BadenMorgan/thesis/Document/Pictures/ComponentTubes.JPG

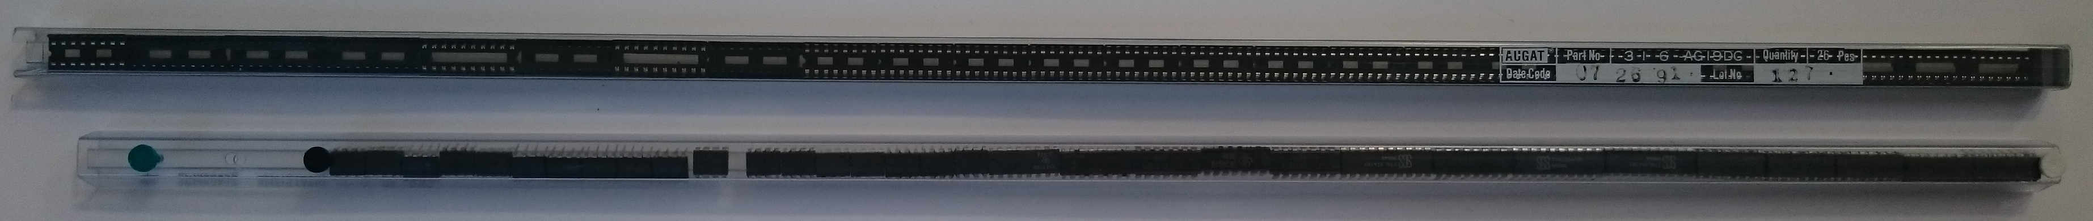
Document/Pictures/ComponentTubes.JPG
