BadenMorgan/thesis/Document/Pictures/tester.jpg

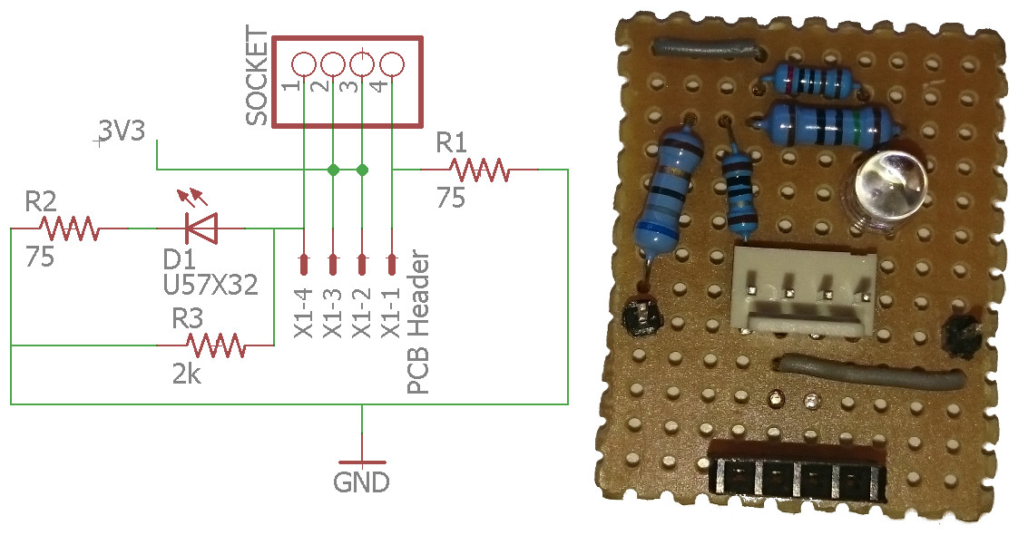
Document/Pictures/tester.jpg
