BadenMorgan/thesis/Ethics Review/Signature form.pdf

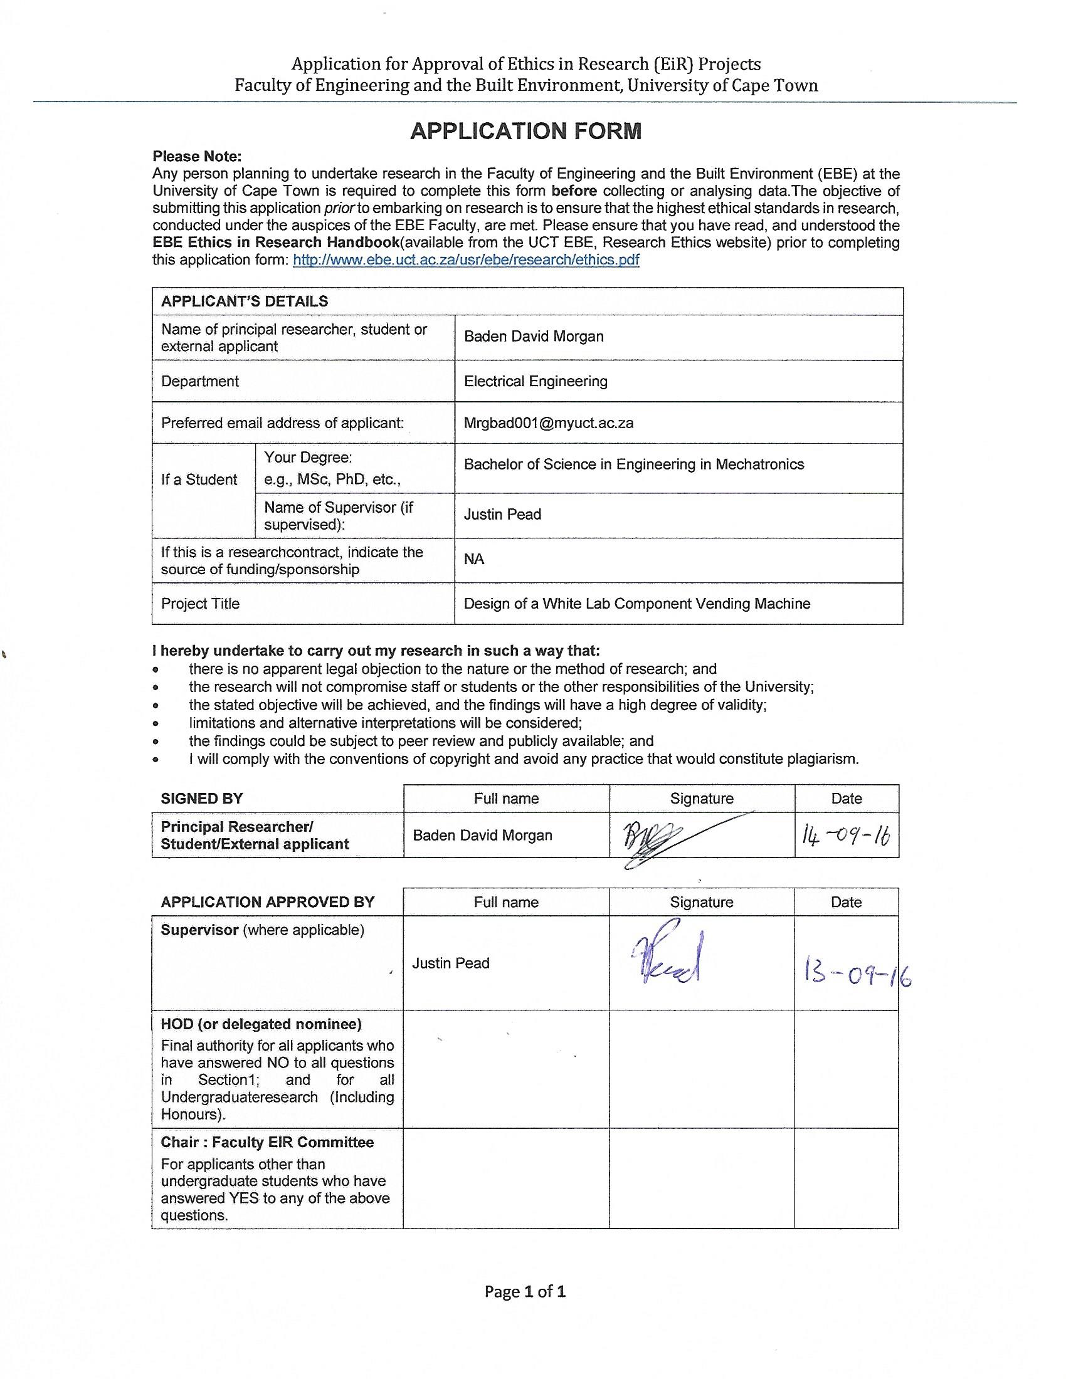
[picture p11: page 1]
