BadenMorgan/thesis/Circuit/LCD Board/LCD_Breakout TEMPLATE.PDF

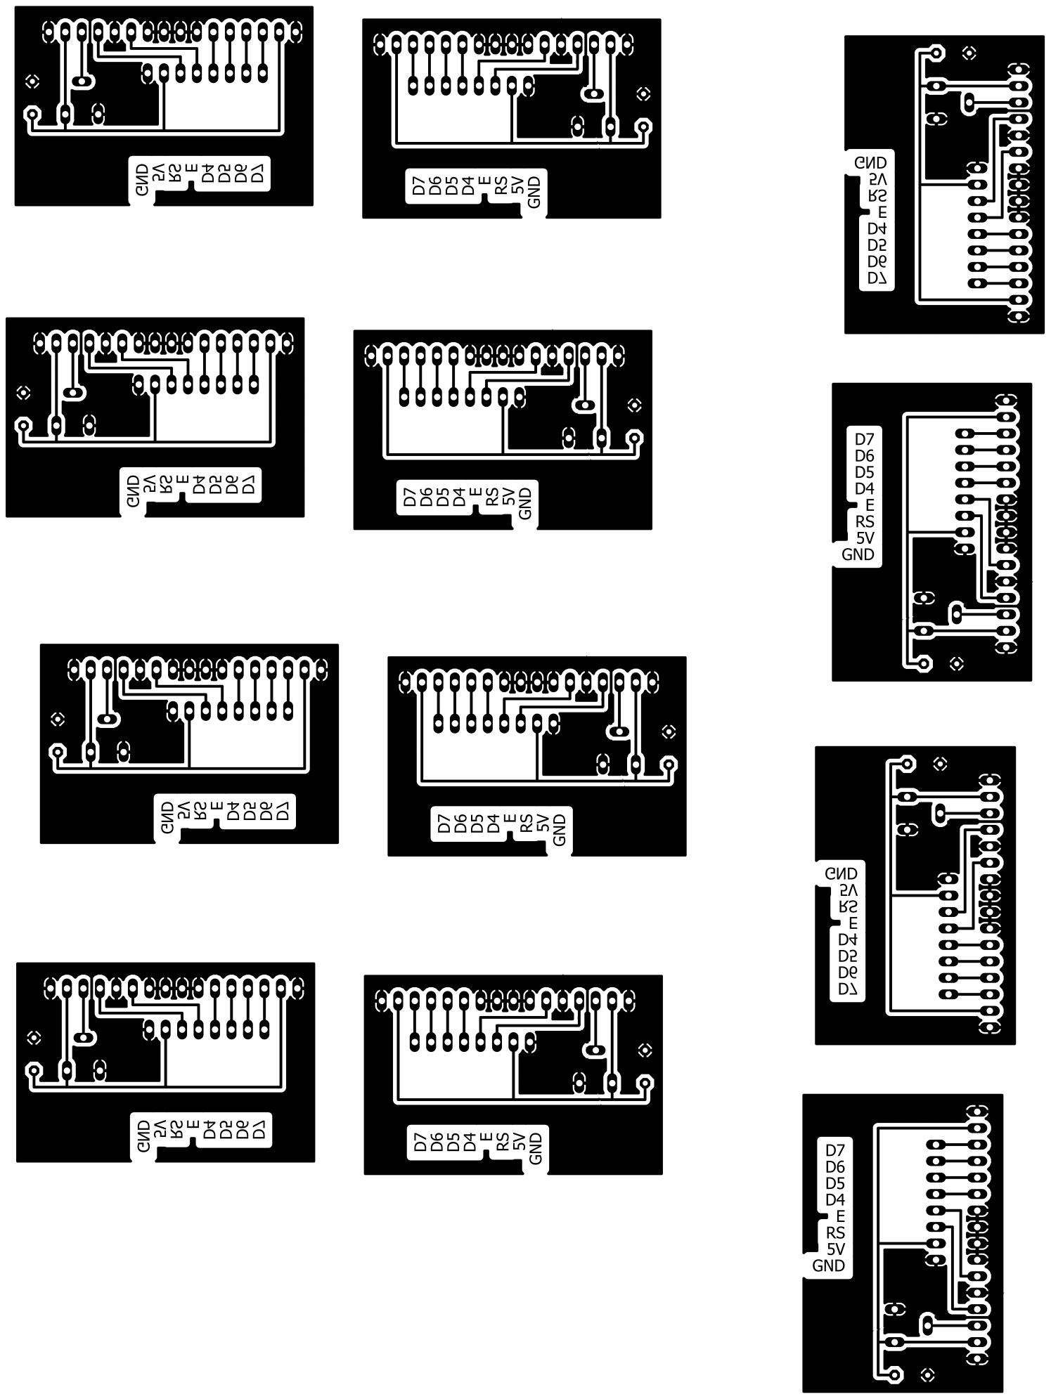
[picture p12: page 1]
