BadenMorgan/thesis/Document/Pictures/archive pics/cover picture.docx

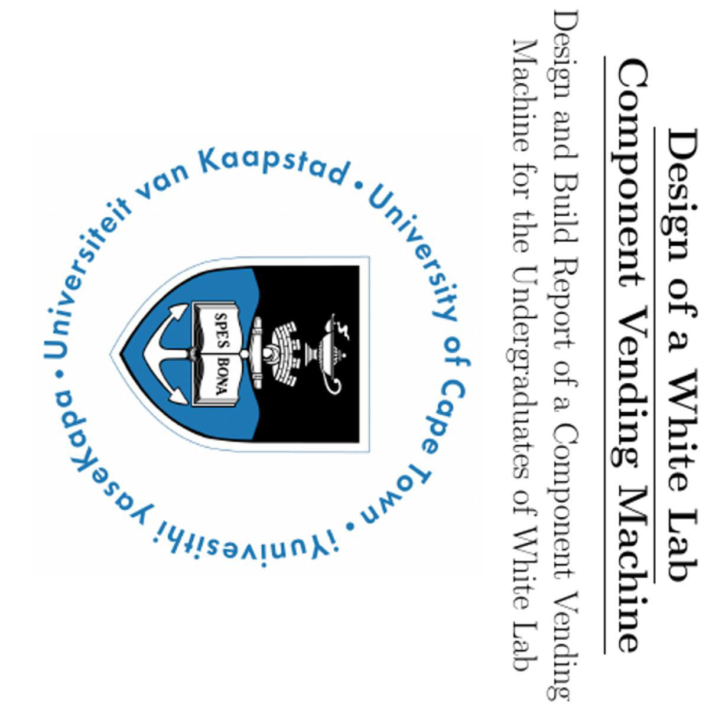
[picture p13: figure]
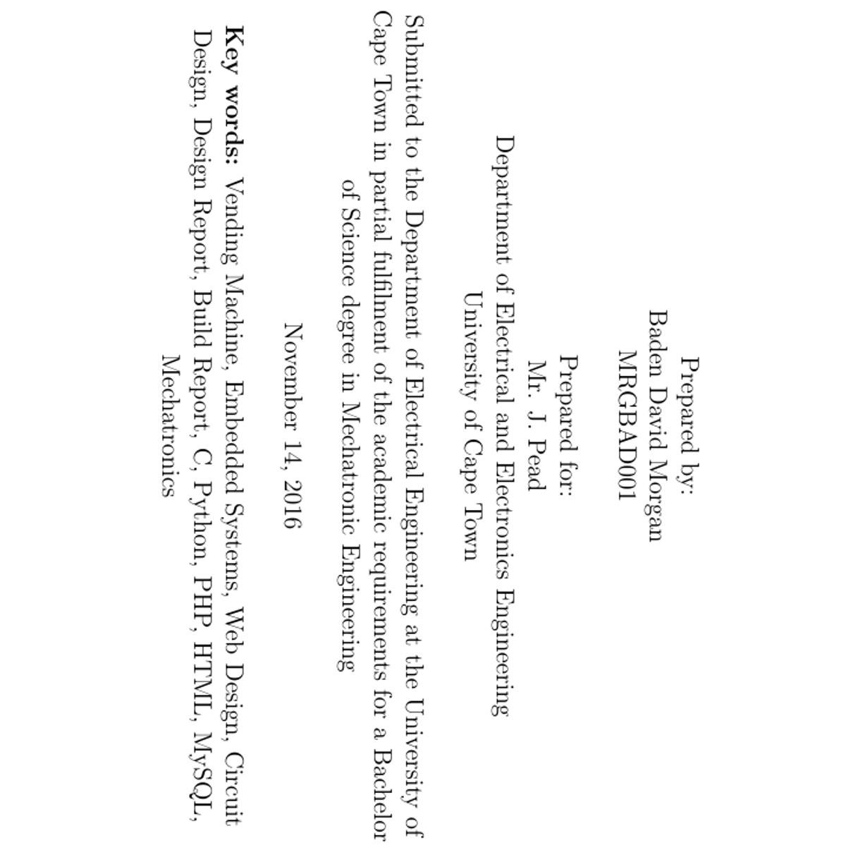
[picture p14: figure]
