BadenMorgan/thesis/Cmaps/.cmapthumbs/1QD1MVDWZ-1VP8W32-1DLC.gif

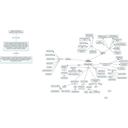
Cmaps/.cmapthumbs/1QD1MVDWZ-1VP8W32-1DLC.gif
