BadenMorgan/thesis/Cmaps/.cmapthumbs/1QKLRMBC1-1NK2RVH-72D.gif

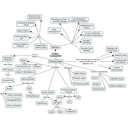
Cmaps/.cmapthumbs/1QKLRMBC1-1NK2RVH-72D.gif
