BadenMorgan/thesis/Cmaps/.cmapthumbs/1QKLRQQYY-SXX1KT-7MW.gif

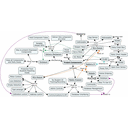
Cmaps/.cmapthumbs/1QKLRQQYY-SXX1KT-7MW.gif
