BadenMorgan/thesis/Cmaps/.cmapthumbs/1QKM15J0T-51VW2Z-1ZVW.gif

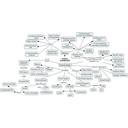
Cmaps/.cmapthumbs/1QKM15J0T-51VW2Z-1ZVW.gif
