BadenMorgan/thesis/Document/Diagrams/mcu.jpg

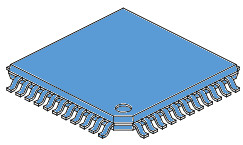
Document/Diagrams/mcu.jpg
