BadenMorgan/thesis/Document/Diagrams/rfid-symbol.jpg

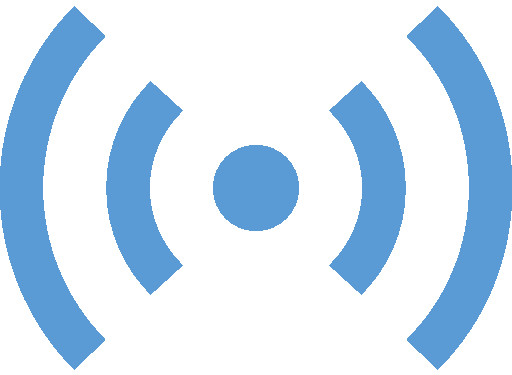
Document/Diagrams/rfid-symbol.jpg
