BadenMorgan/thesis/Document/Diagrams/State Machine Diagram v2 (1).jpg

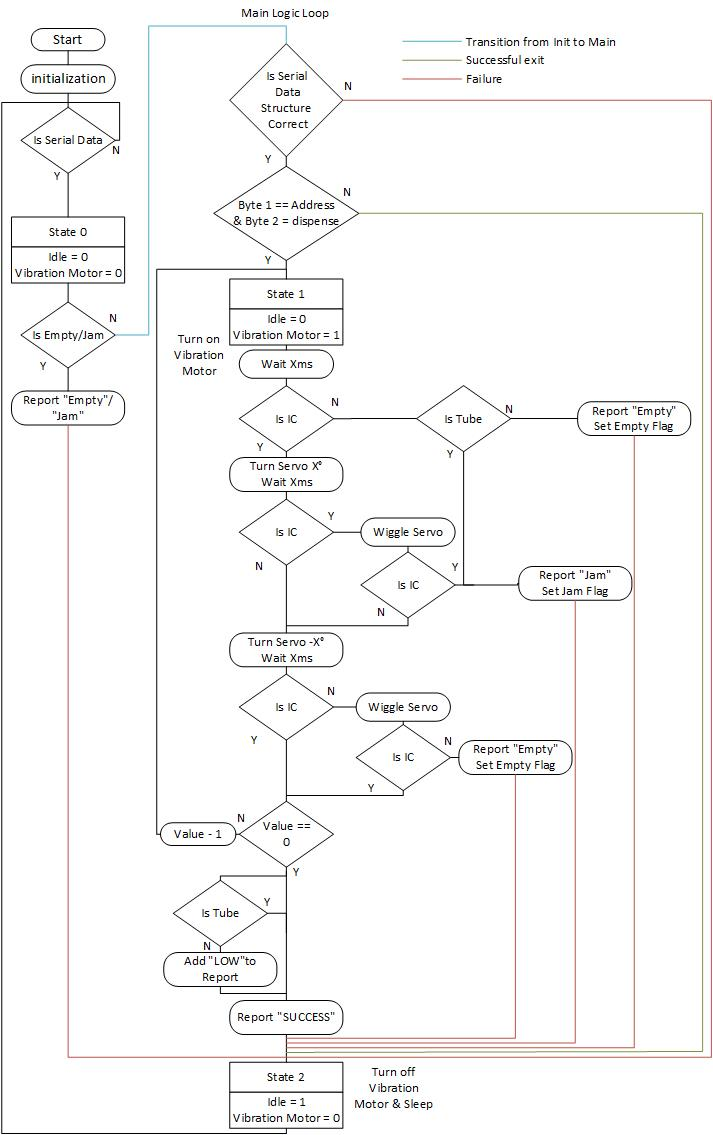
Document/Diagrams/State Machine Diagram v2 (1).jpg
