BadenMorgan/thesis/Document/Diagrams/State Machine Diagram v3.jpg

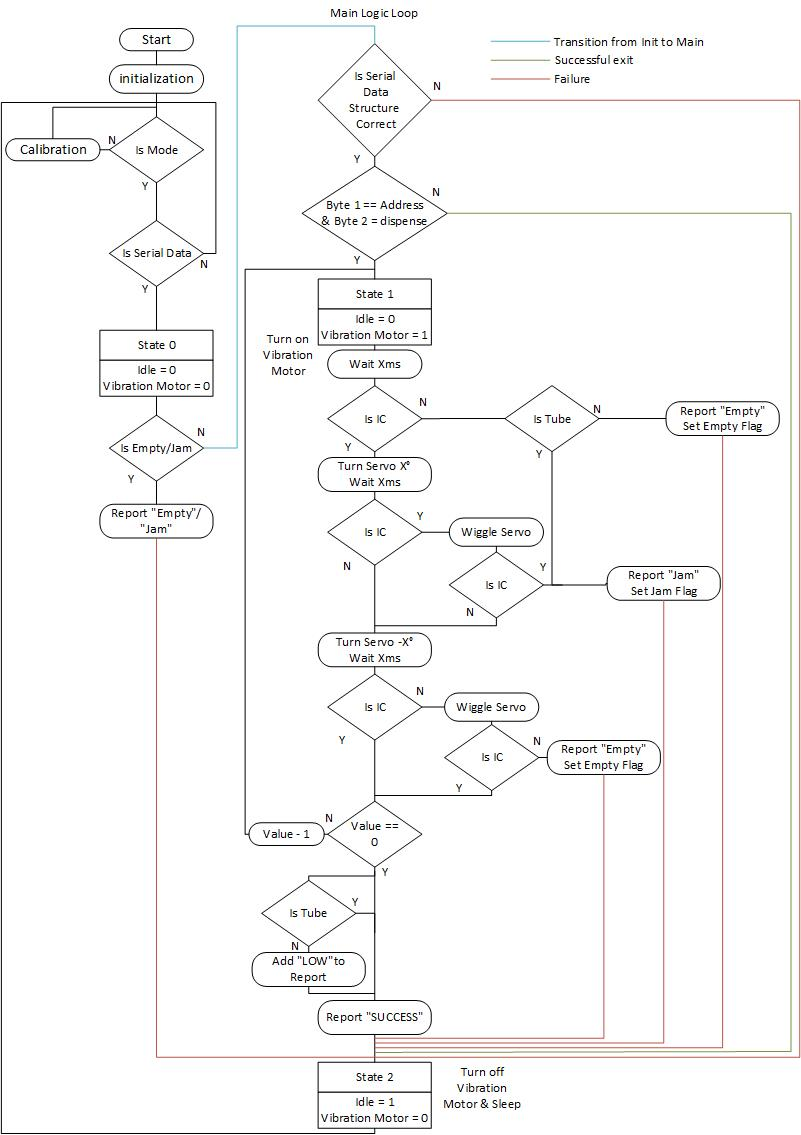
Document/Diagrams/State Machine Diagram v3.jpg
