BadenMorgan/thesis/Document/Diagrams/state machine master.jpg

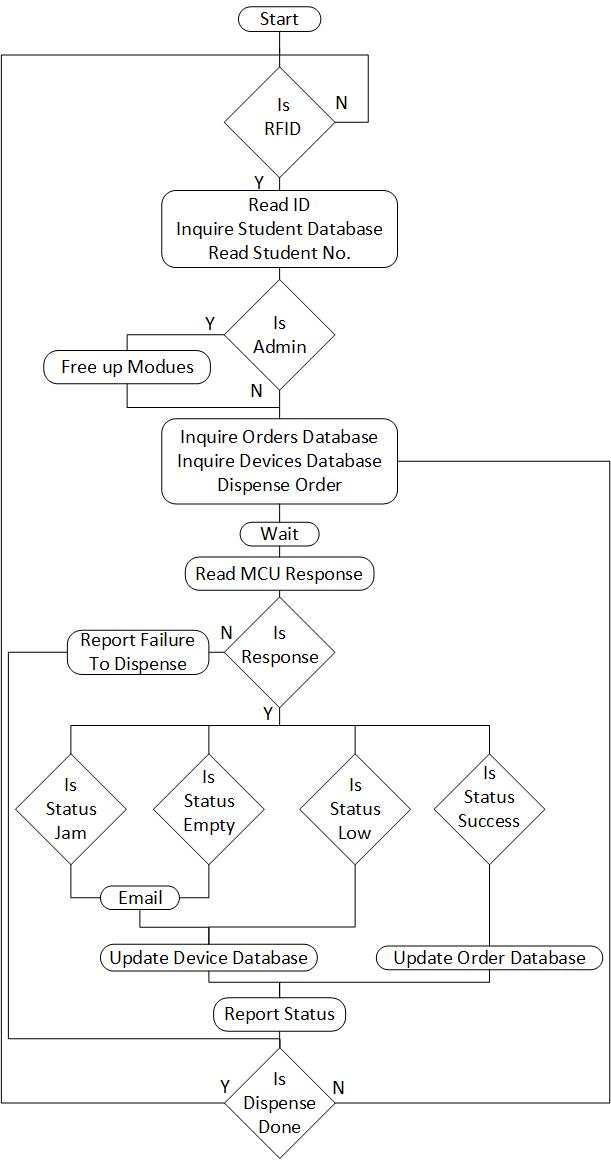
Document/Diagrams/state machine master.jpg
