BadenMorgan/thesis/Document/Diagrams/taskmanager.jpg

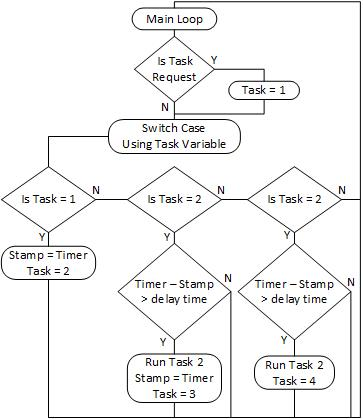
Document/Diagrams/taskmanager.jpg
