BadenMorgan/thesis/Document/Pictures/3dprints.jpg

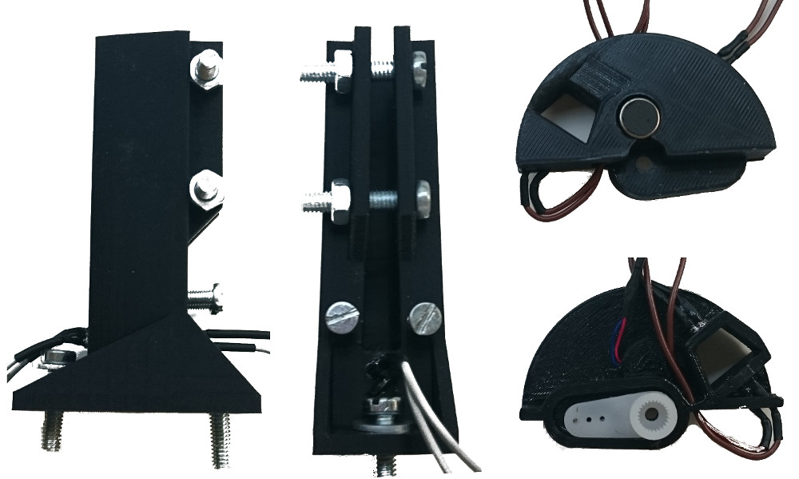
Document/Pictures/3dprints.jpg
