BadenMorgan/thesis/Document/Pictures/3dprintsv2.jpg

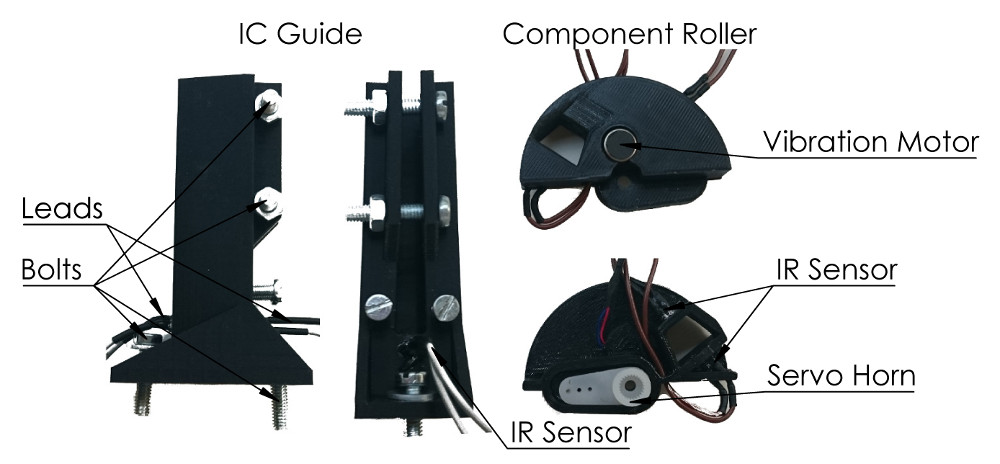
Document/Pictures/3dprintsv2.jpg
