BadenMorgan/thesis/Document/Pictures/125KhzUART.jpg

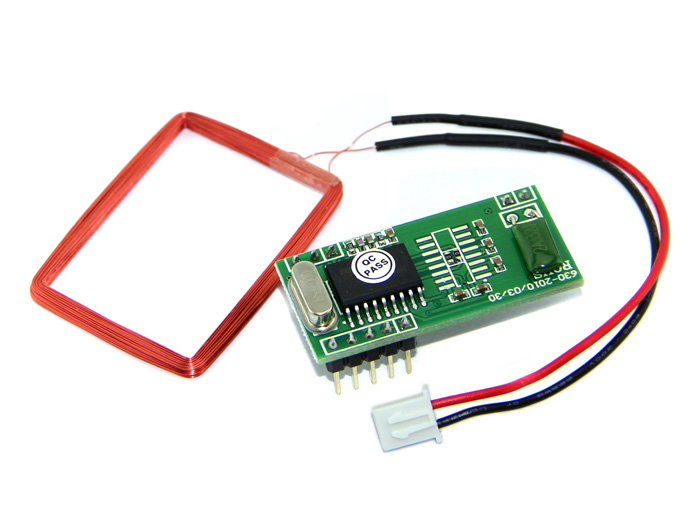
Document/Pictures/125KhzUART.jpg
