BadenMorgan/thesis/Document/Pictures/ALLROLLERSv2.JPG

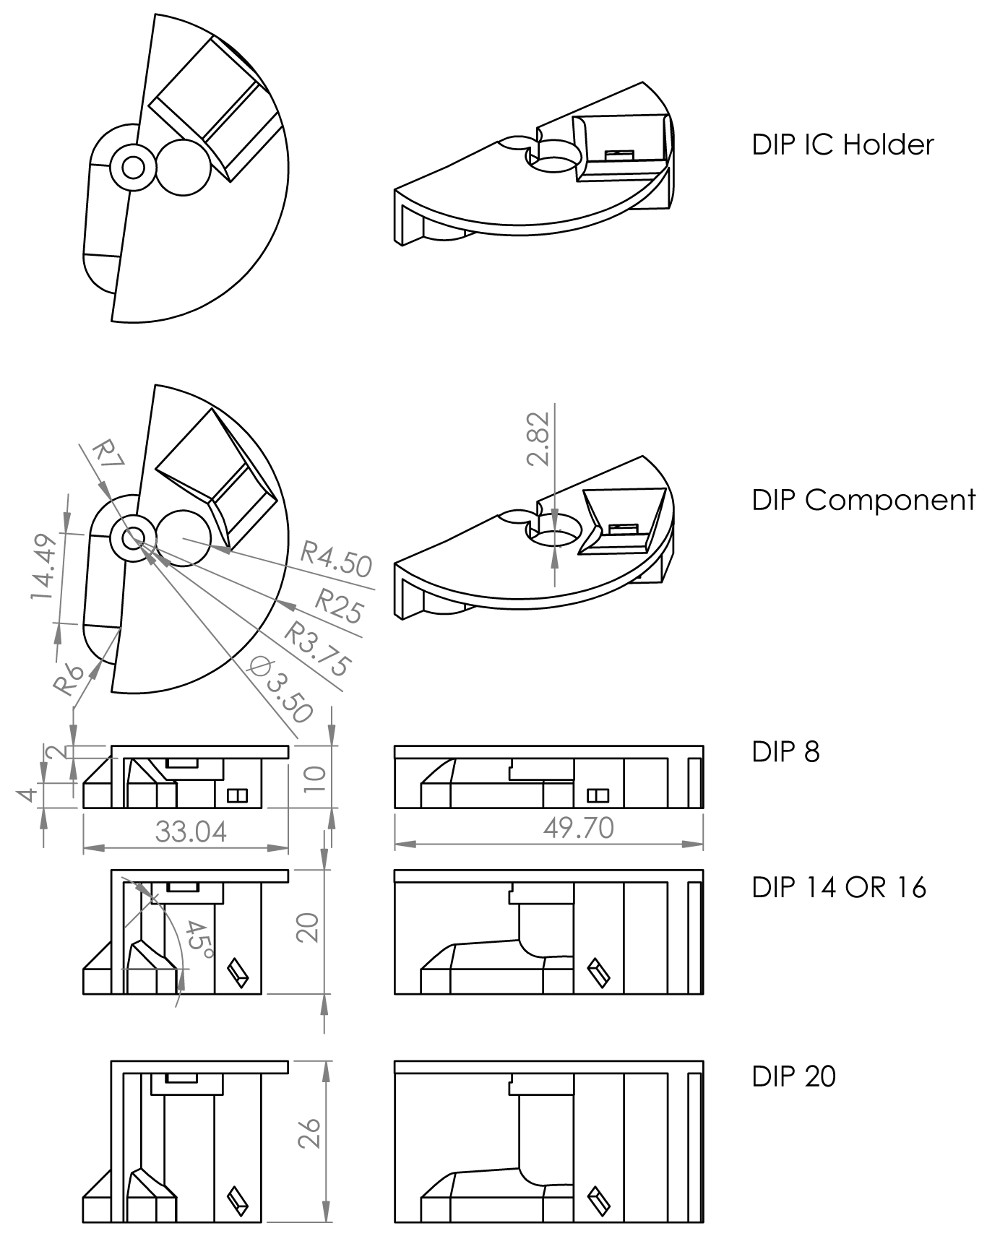
Document/Pictures/ALLROLLERSv2.JPG
