BadenMorgan/thesis/Document/Pictures/Angled.JPG

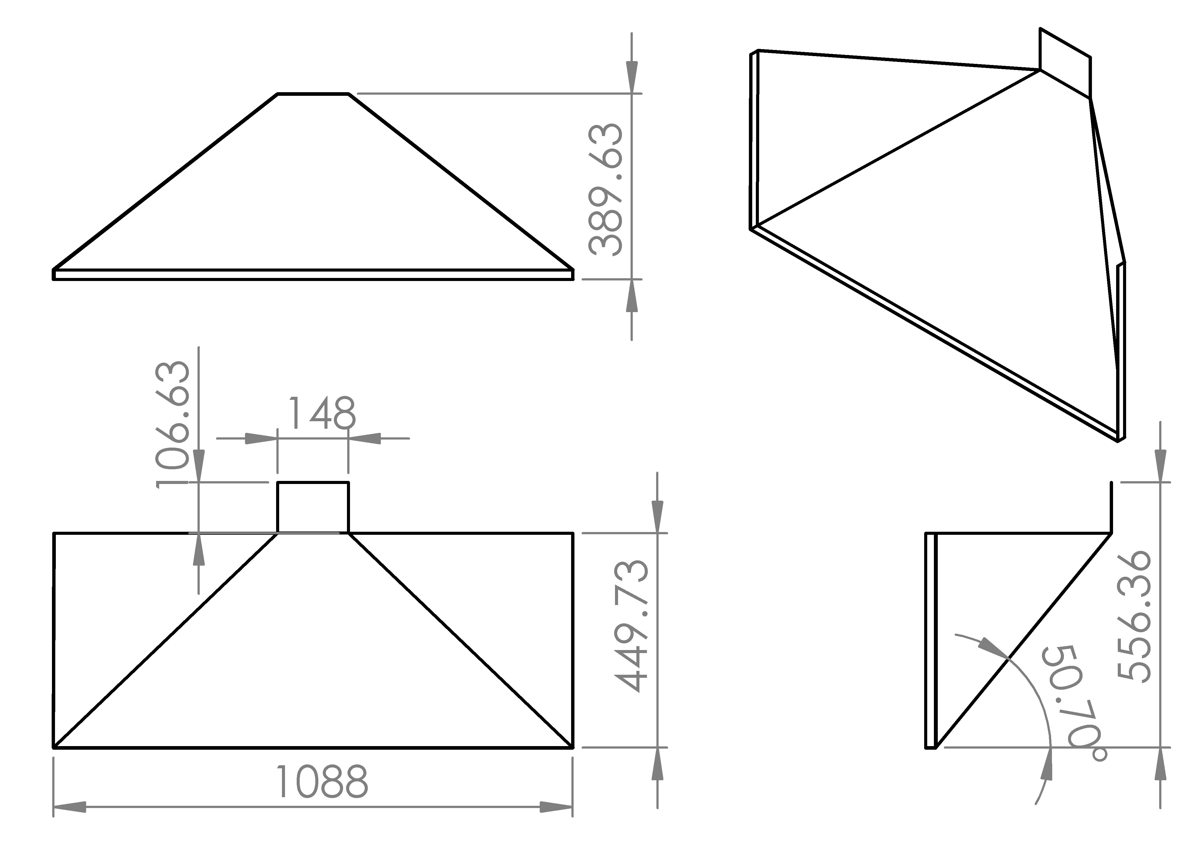
Document/Pictures/Angled.JPG
