BadenMorgan/thesis/Document/Pictures/ATXCON.jpg

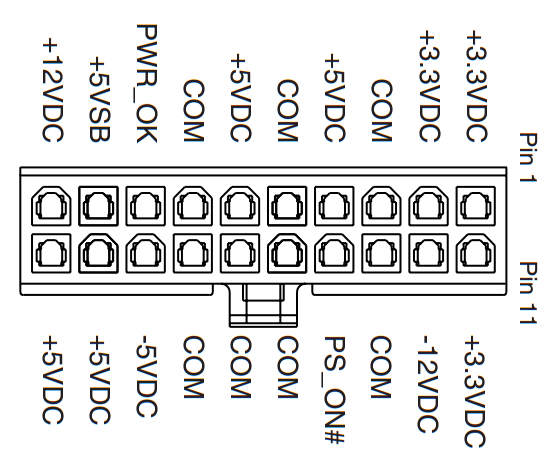
Document/Pictures/ATXCON.jpg
