BadenMorgan/thesis/Document/Pictures/case.JPG

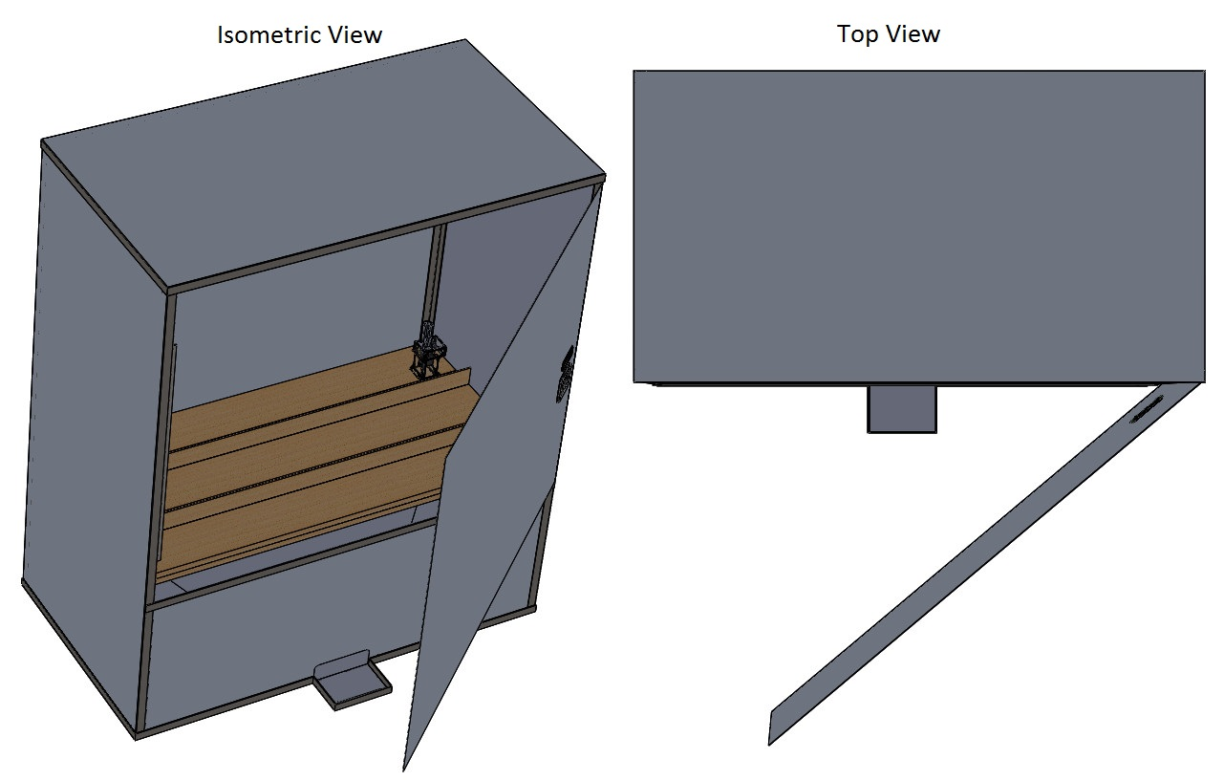
Document/Pictures/case.JPG
