BadenMorgan/thesis/Document/Pictures/CommonNoise2.jpg

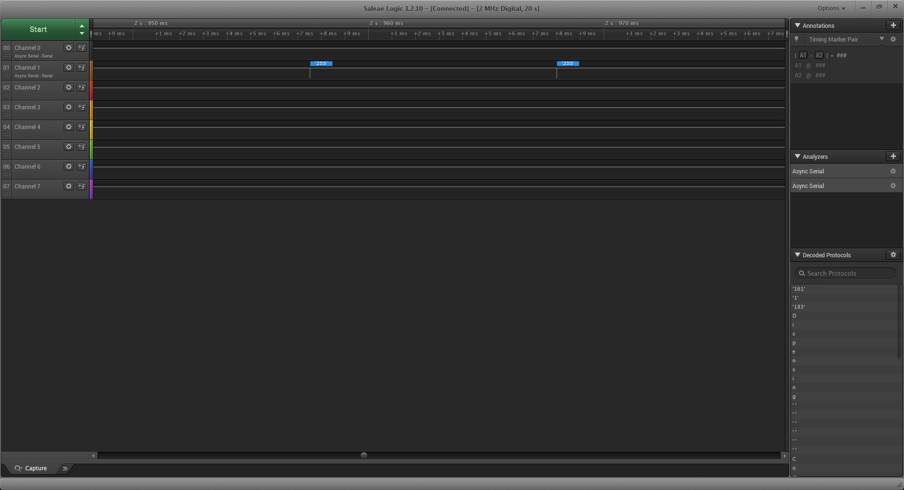
Document/Pictures/CommonNoise2.jpg
