BadenMorgan/thesis/Document/Pictures/comparison1.JPG

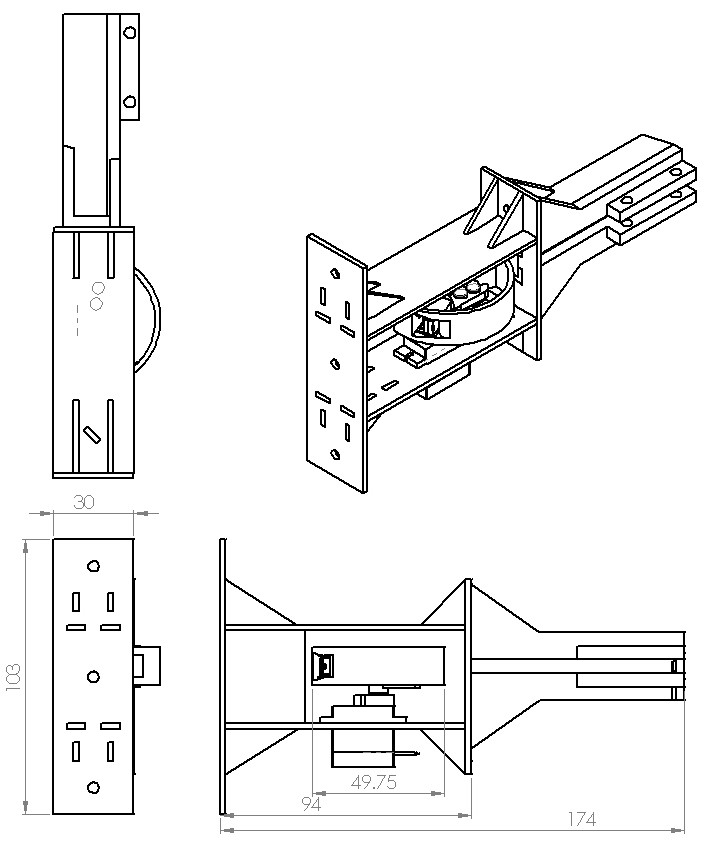
Document/Pictures/comparison1.JPG
