BadenMorgan/thesis/Document/Pictures/comptest.jpg

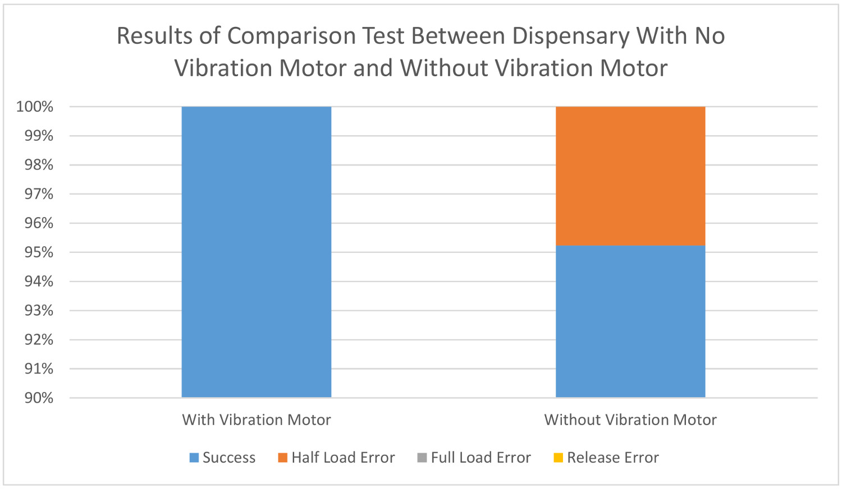
Document/Pictures/comptest.jpg
