BadenMorgan/thesis/Document/Pictures/delivassem.jpg

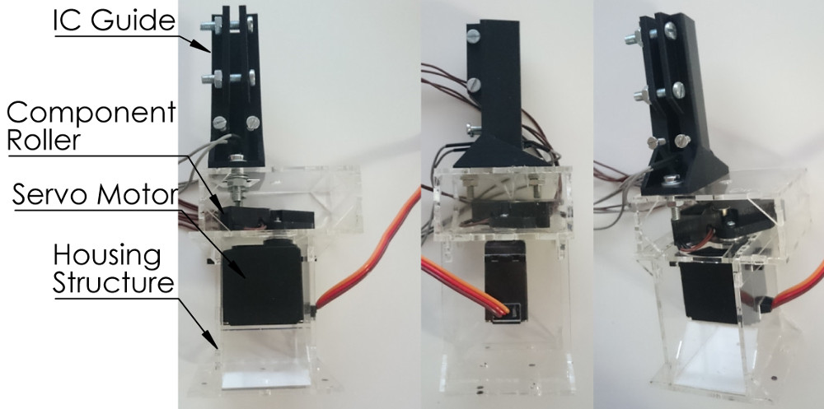
Document/Pictures/delivassem.jpg
