BadenMorgan/thesis/Document/Pictures/Demo.jpg

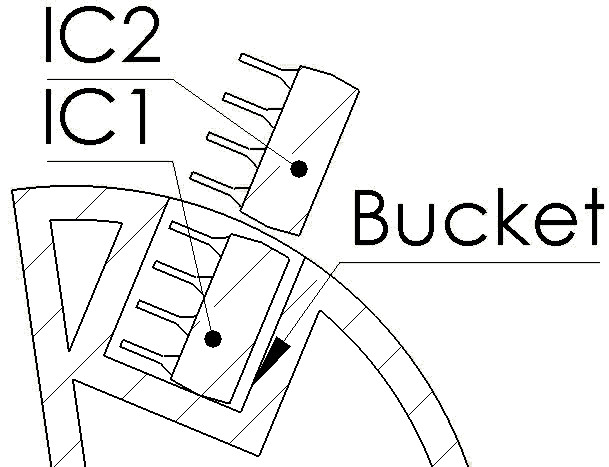
Document/Pictures/Demo.jpg
