BadenMorgan/thesis/Document/Pictures/DIP8TEMPv2.JPG

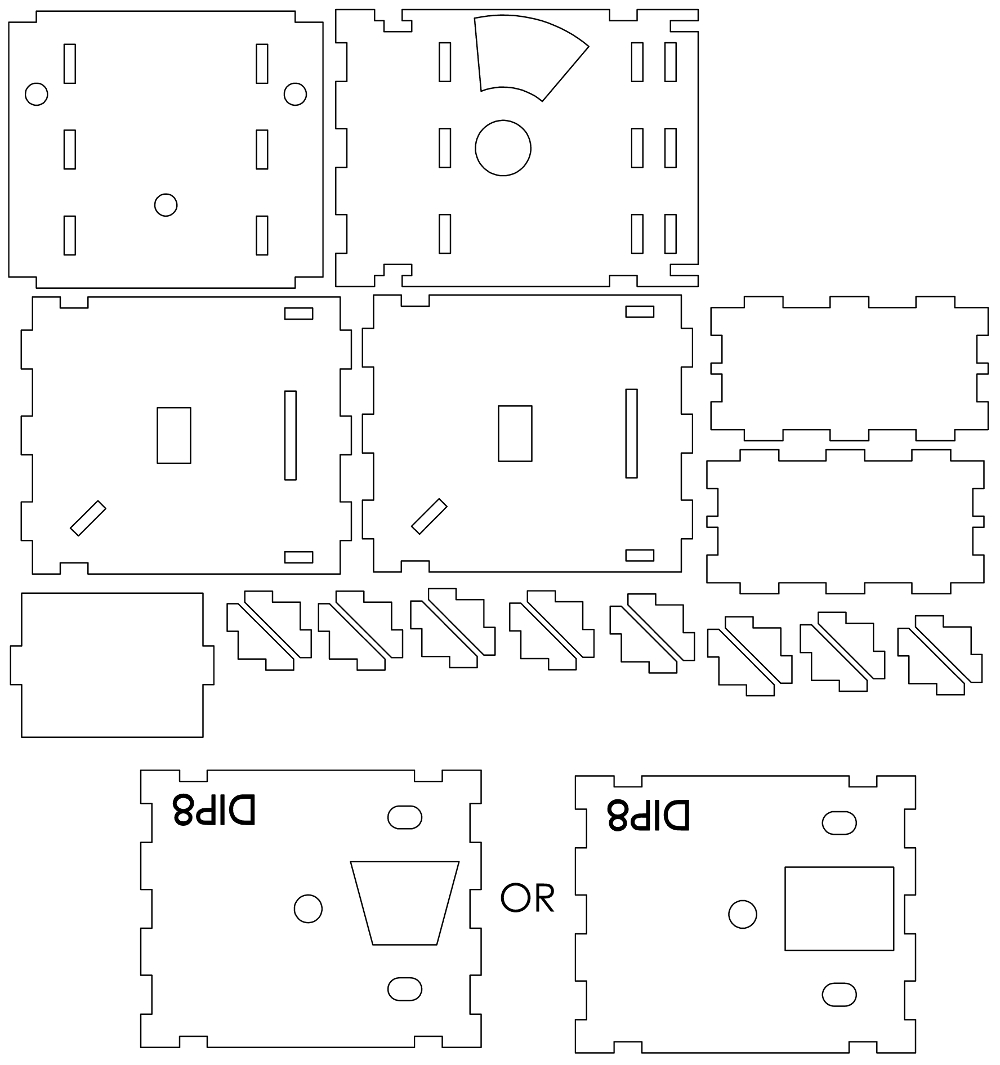
Document/Pictures/DIP8TEMPv2.JPG
