BadenMorgan/thesis/Document/Pictures/DIP20TEMPv2.JPG

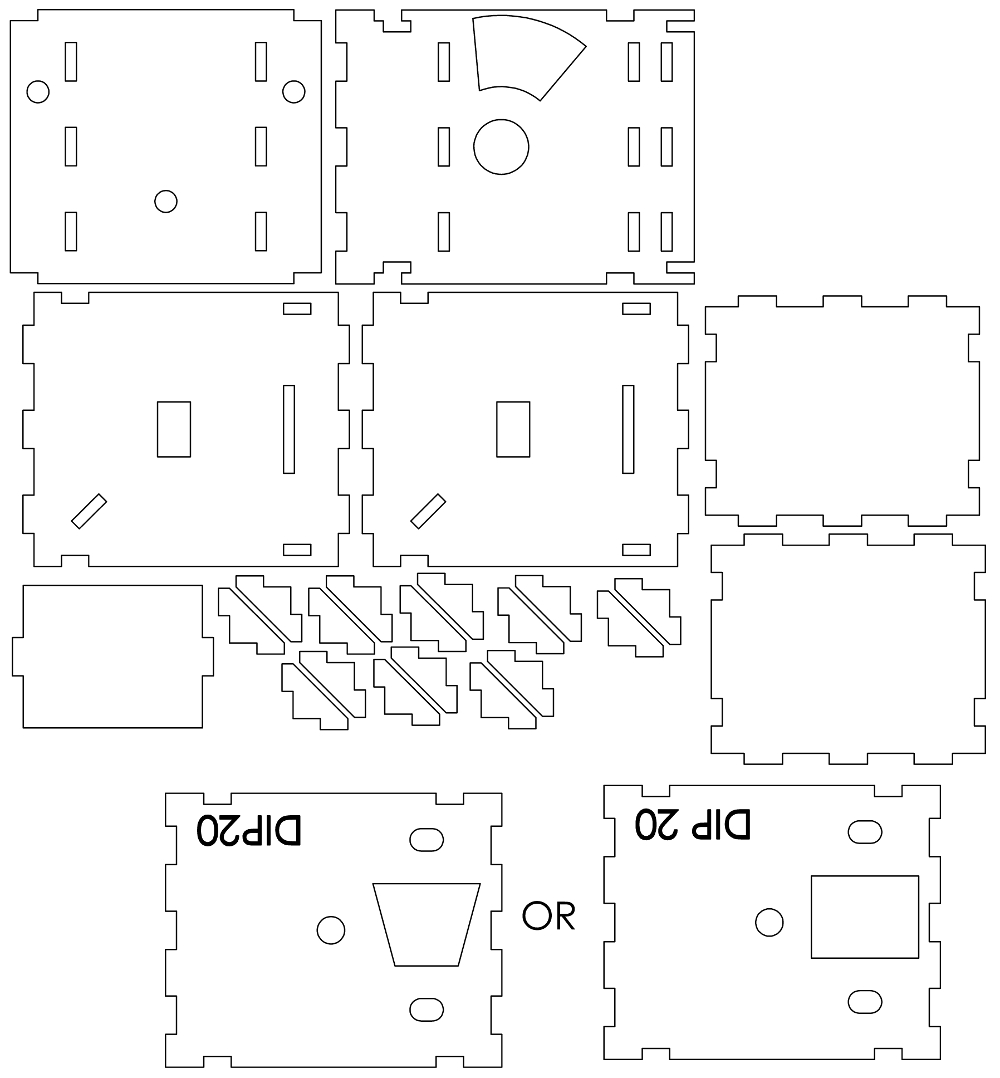
Document/Pictures/DIP20TEMPv2.JPG
