BadenMorgan/thesis/Document/Pictures/DIP1416TEMPv2.JPG

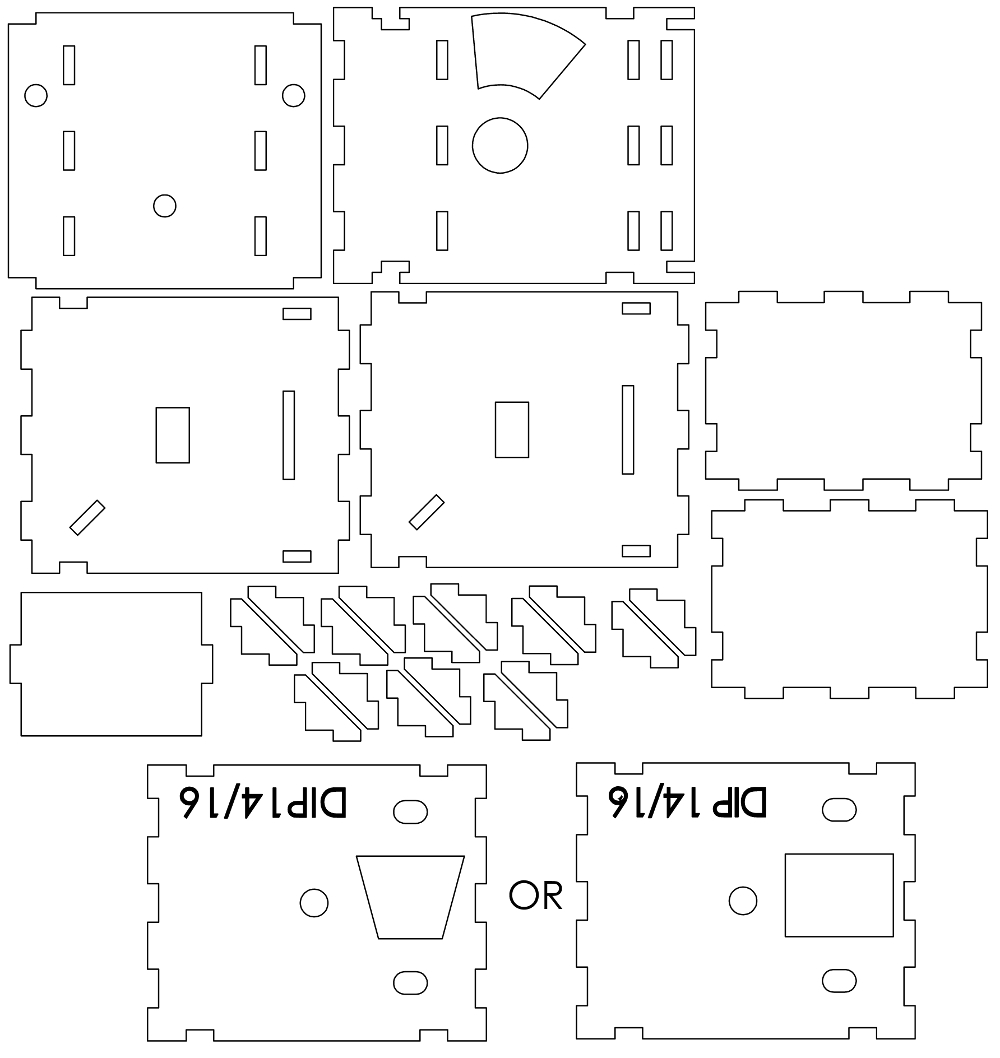
Document/Pictures/DIP1416TEMPv2.JPG
