BadenMorgan/thesis/Document/Pictures/DIPJAM.JPG

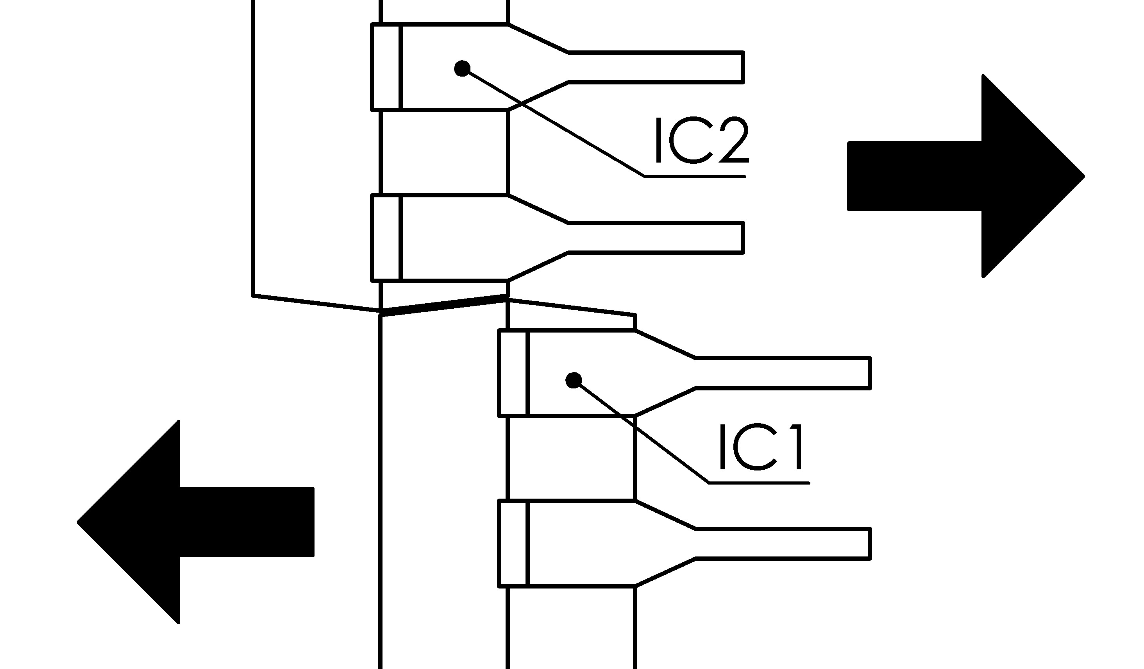
Document/Pictures/DIPJAM.JPG
