BadenMorgan/thesis/Document/Pictures/drilltemplate.jpg

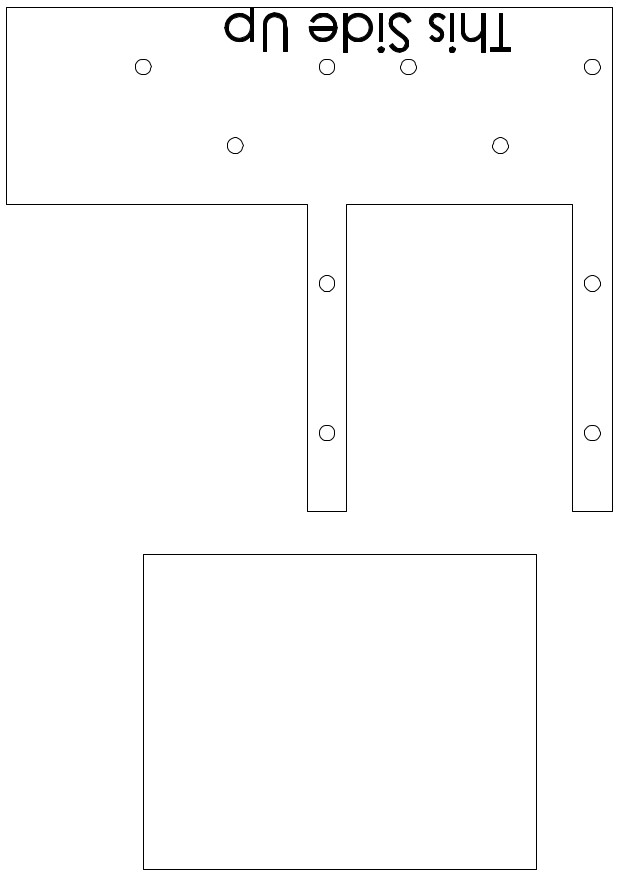
Document/Pictures/drilltemplate.jpg
