BadenMorgan/thesis/Document/Pictures/DSC_0023_3.JPG

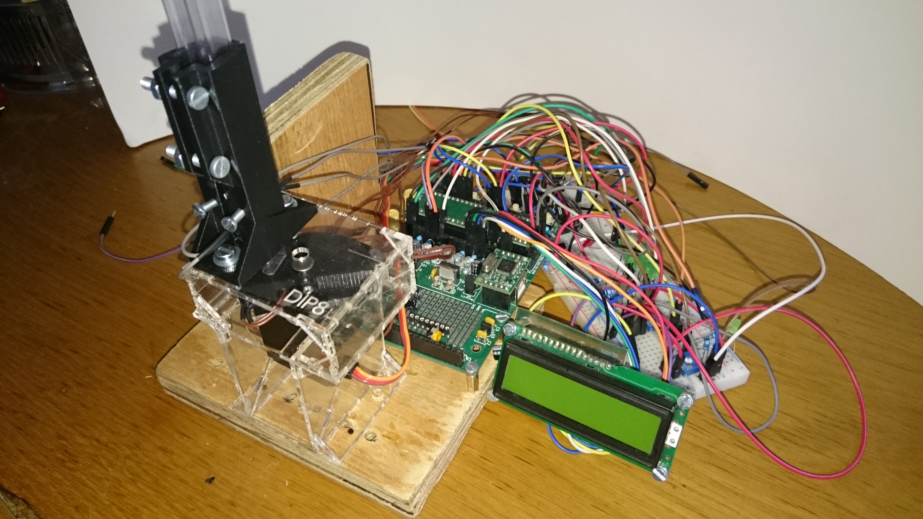
Document/Pictures/DSC_0023_3.JPG
