BadenMorgan/thesis/Document/Pictures/DSC_0242.JPG

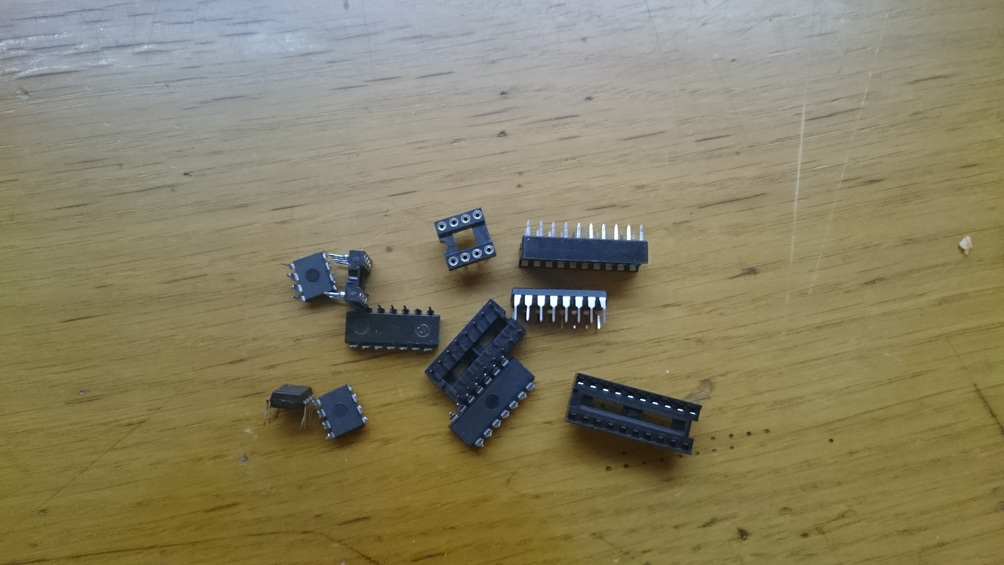
Document/Pictures/DSC_0242.JPG
