BadenMorgan/thesis/Document/Pictures/enclosurev1.JPG

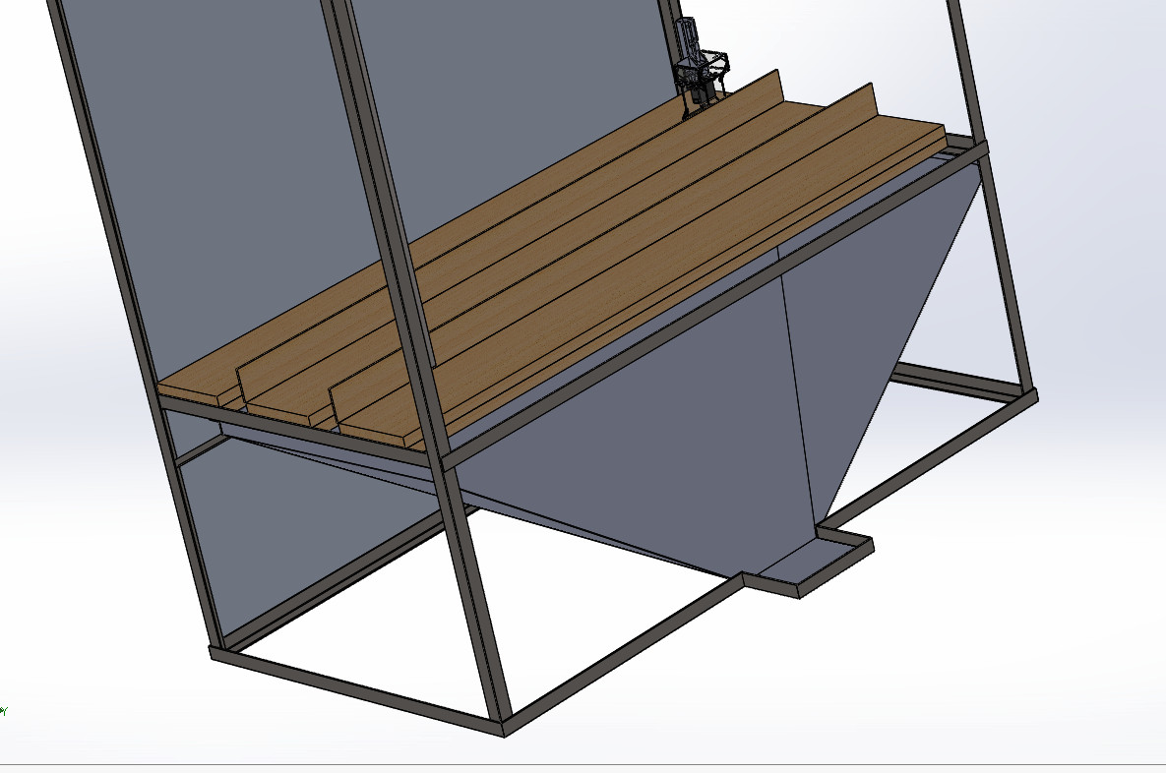
Document/Pictures/enclosurev1.JPG
