BadenMorgan/thesis/Document/Pictures/enclosurev2.JPG

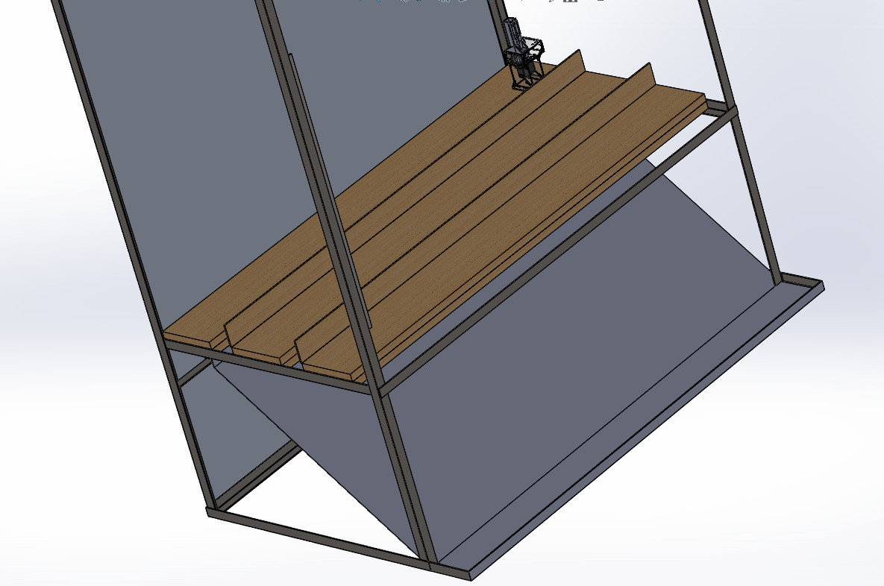
Document/Pictures/enclosurev2.JPG
