BadenMorgan/thesis/Document/Pictures/enfin.jpg

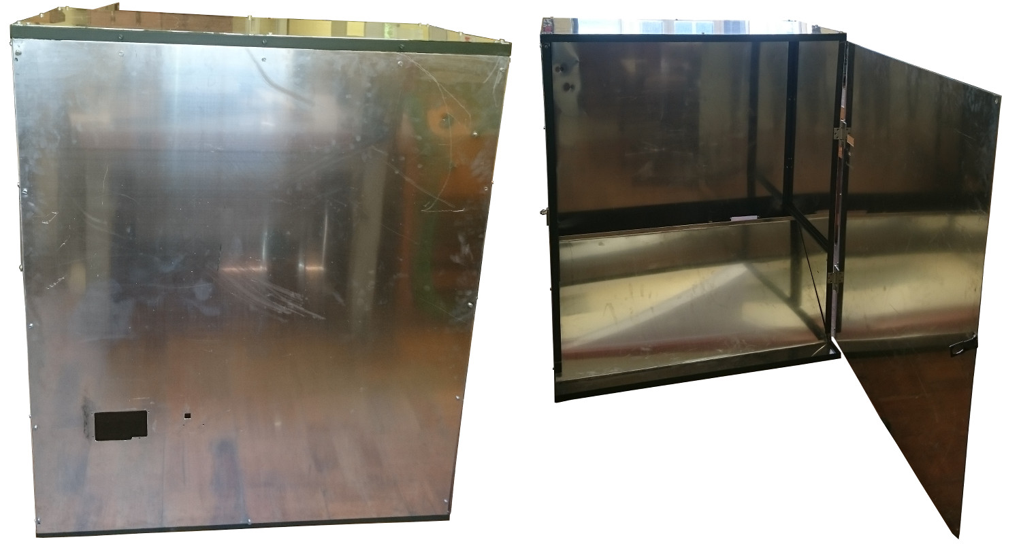
Document/Pictures/enfin.jpg
