BadenMorgan/thesis/Document/Pictures/enfrwal.jpg

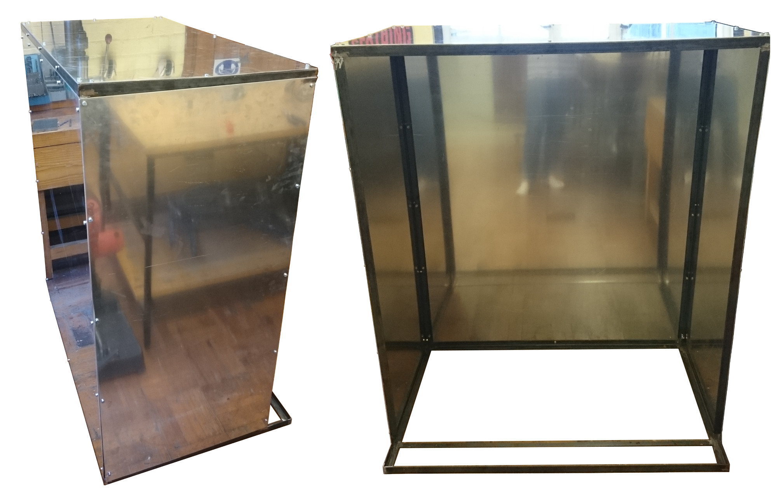
Document/Pictures/enfrwal.jpg
