BadenMorgan/thesis/Document/Pictures/explodedenclosure.JPG

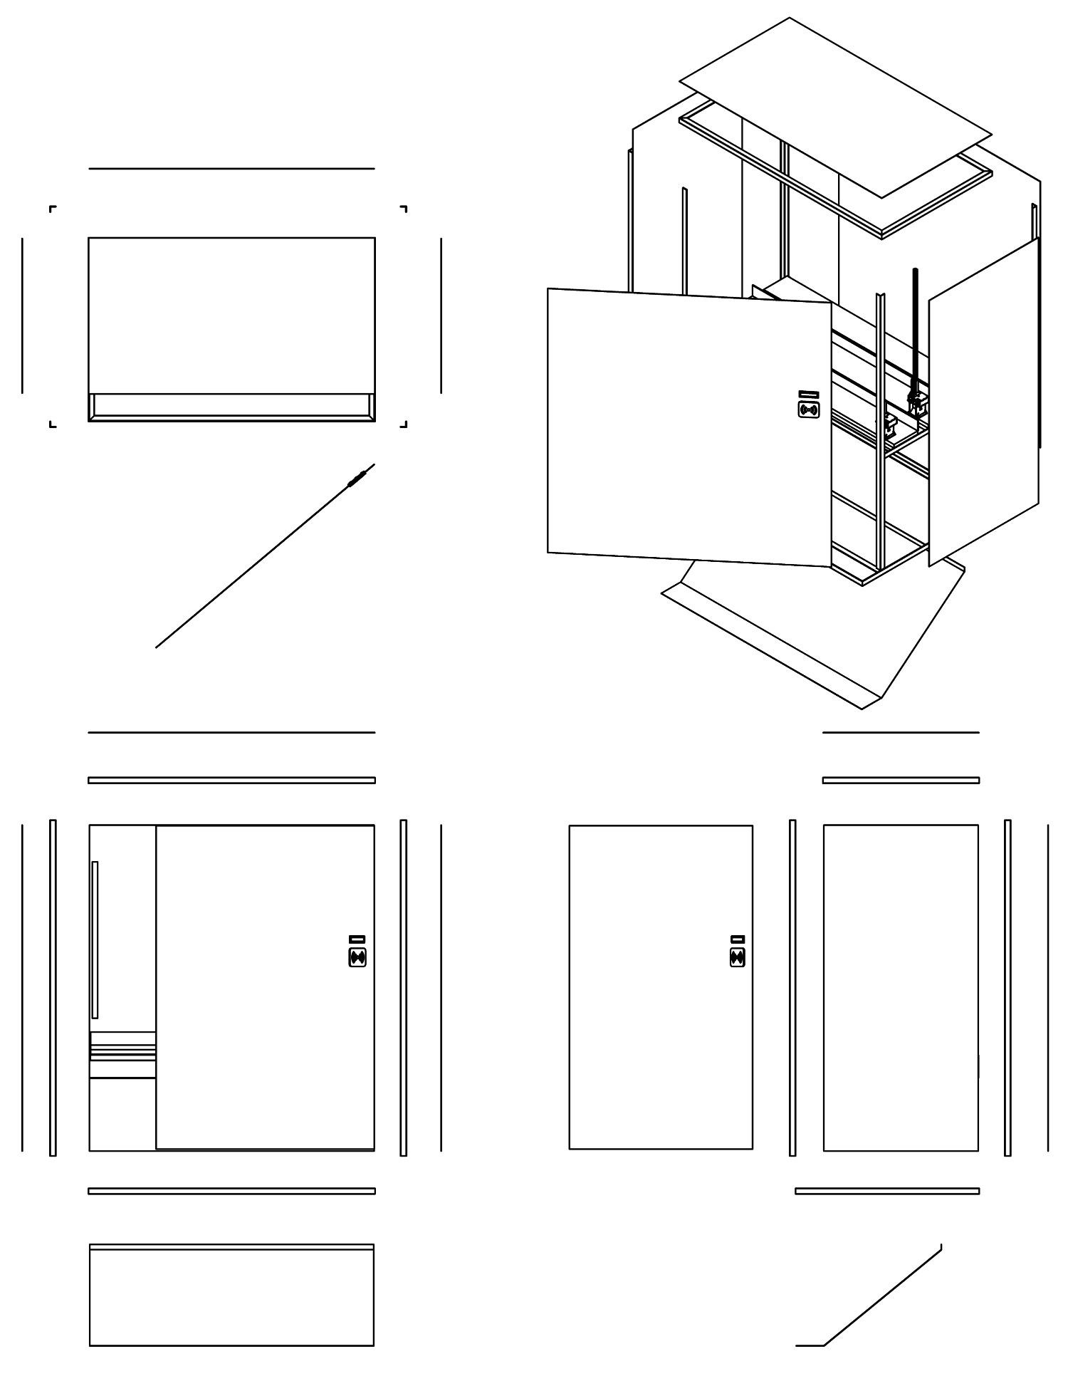
Document/Pictures/explodedenclosure.JPG
