BadenMorgan/thesis/Document/Pictures/Feedup.JPG

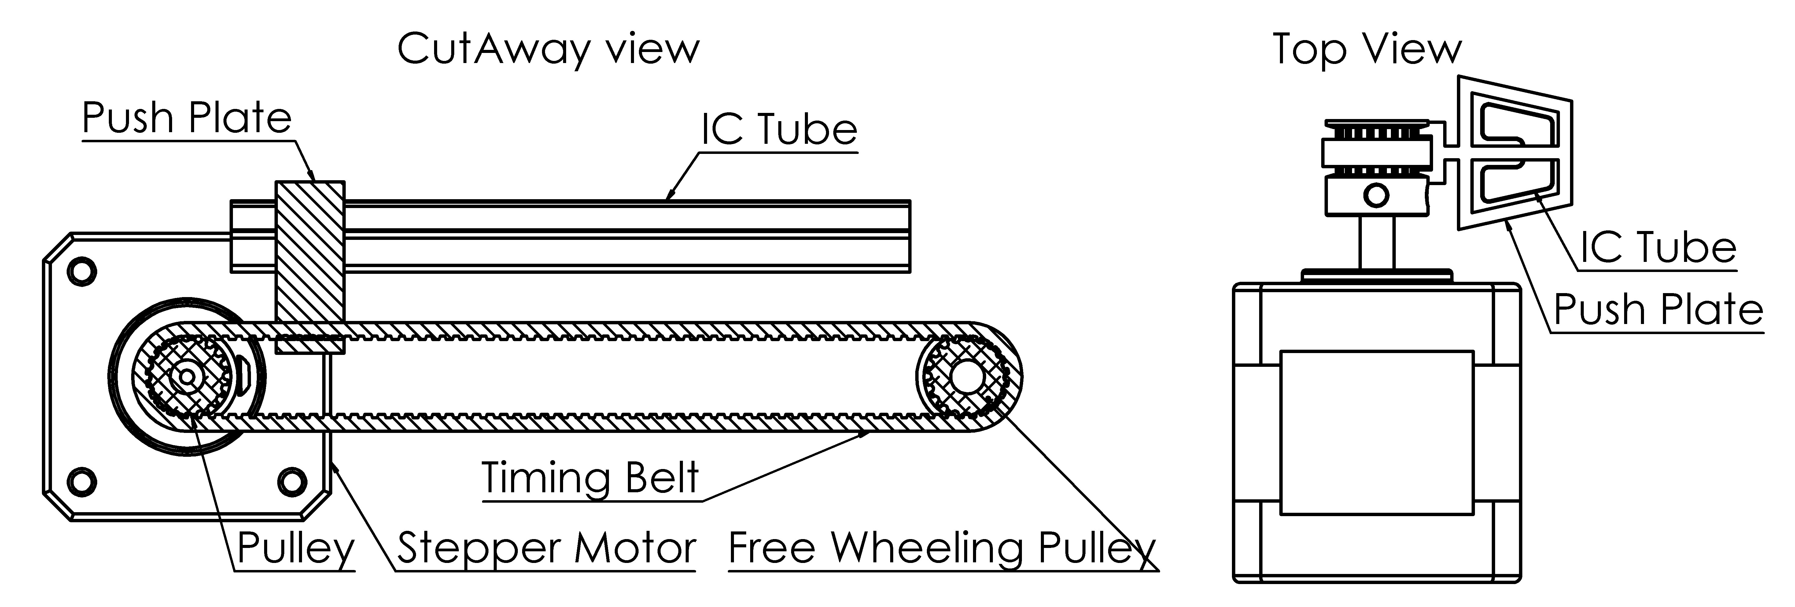
Document/Pictures/Feedup.JPG
