BadenMorgan/thesis/Document/Pictures/finalinternal.jpg

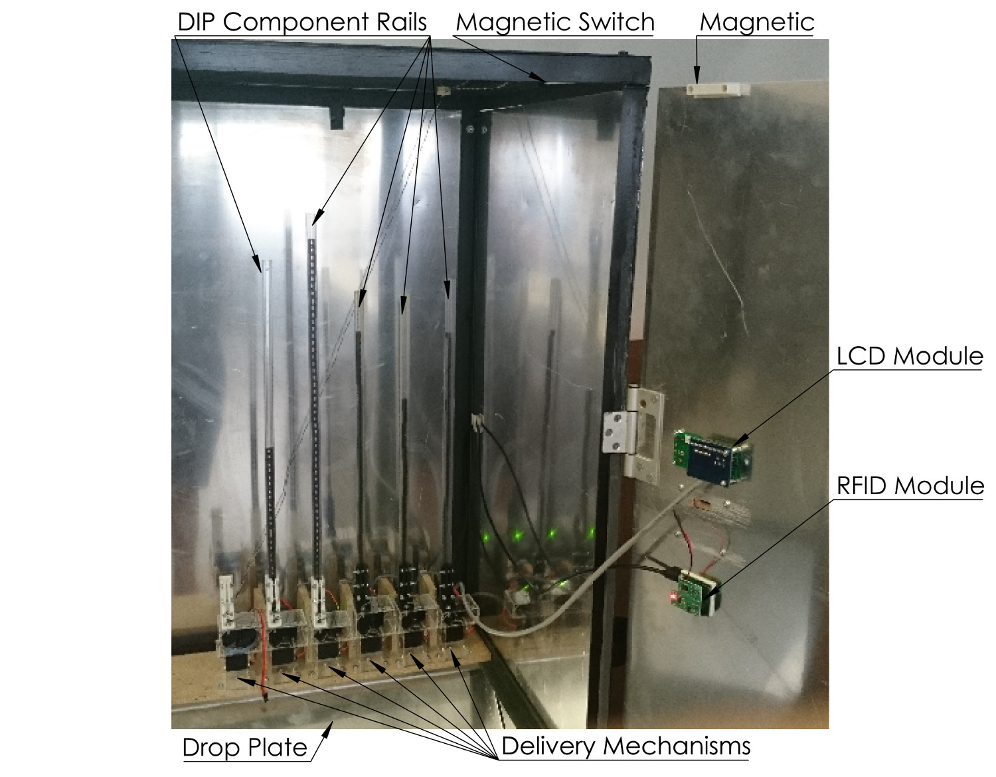
Document/Pictures/finalinternal.jpg
