BadenMorgan/thesis/Document/Pictures/finaltest.jpg

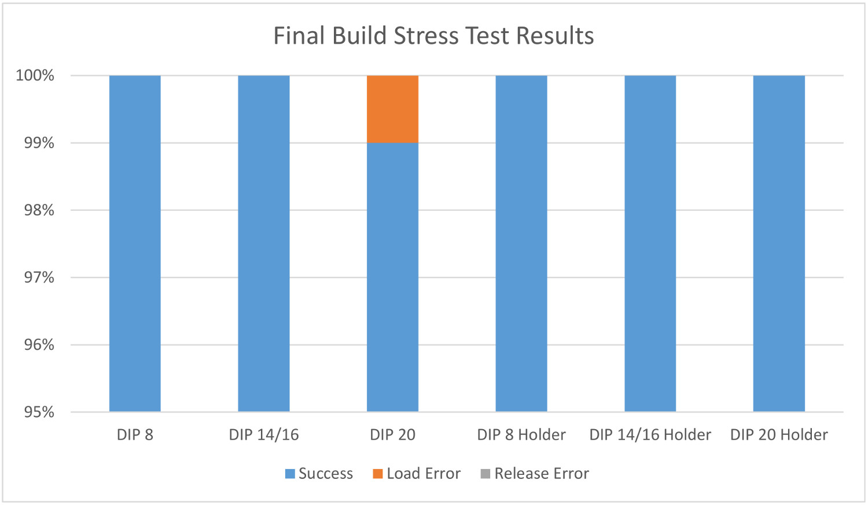
Document/Pictures/finaltest.jpg
