BadenMorgan/thesis/Document/Pictures/finassem1.jpg

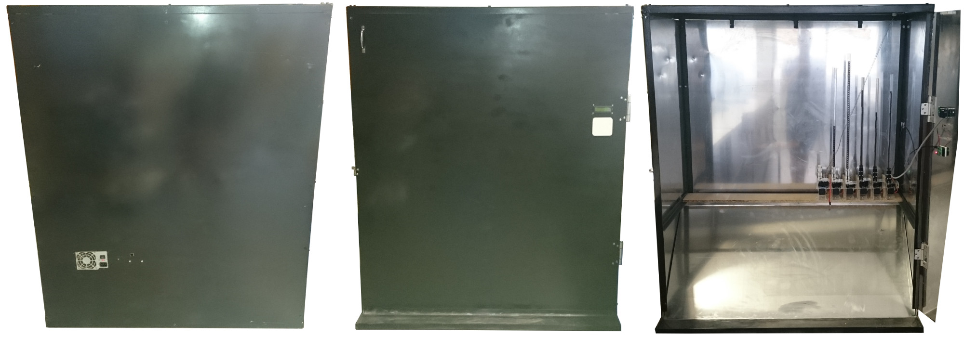
Document/Pictures/finassem1.jpg
