BadenMorgan/thesis/Document/Pictures/finpipic.jpg

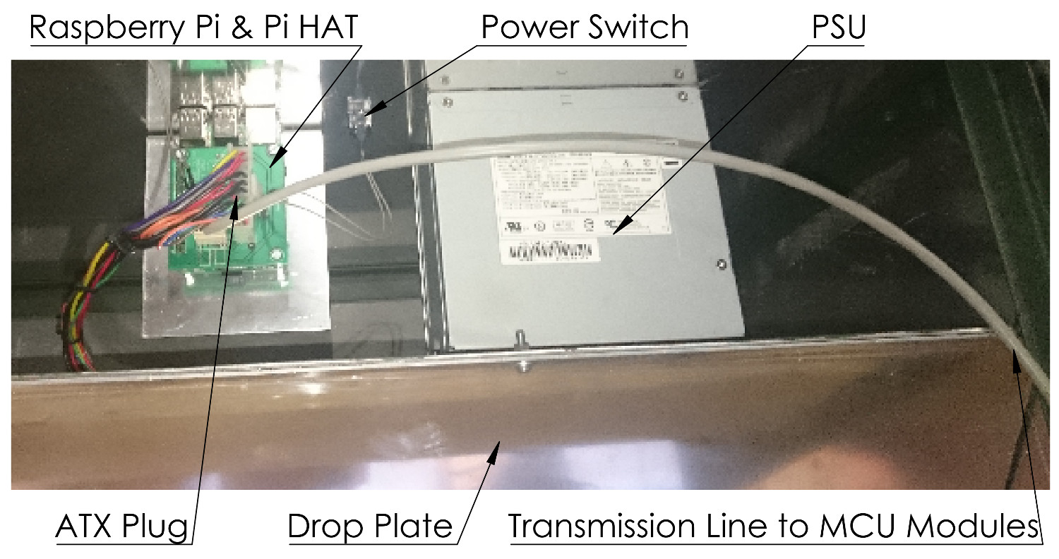
Document/Pictures/finpipic.jpg
