BadenMorgan/thesis/Document/Pictures/Frame.JPG

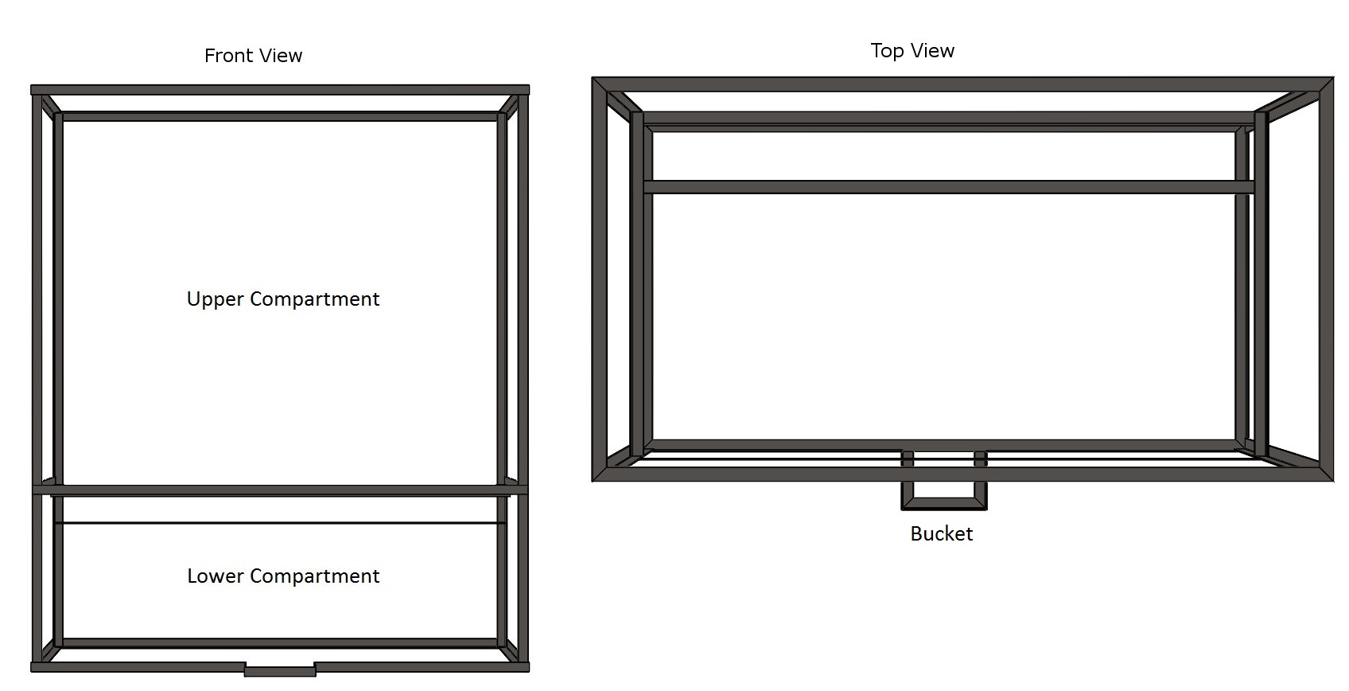
Document/Pictures/Frame.JPG
