BadenMorgan/thesis/Document/Pictures/hfinal.jpg

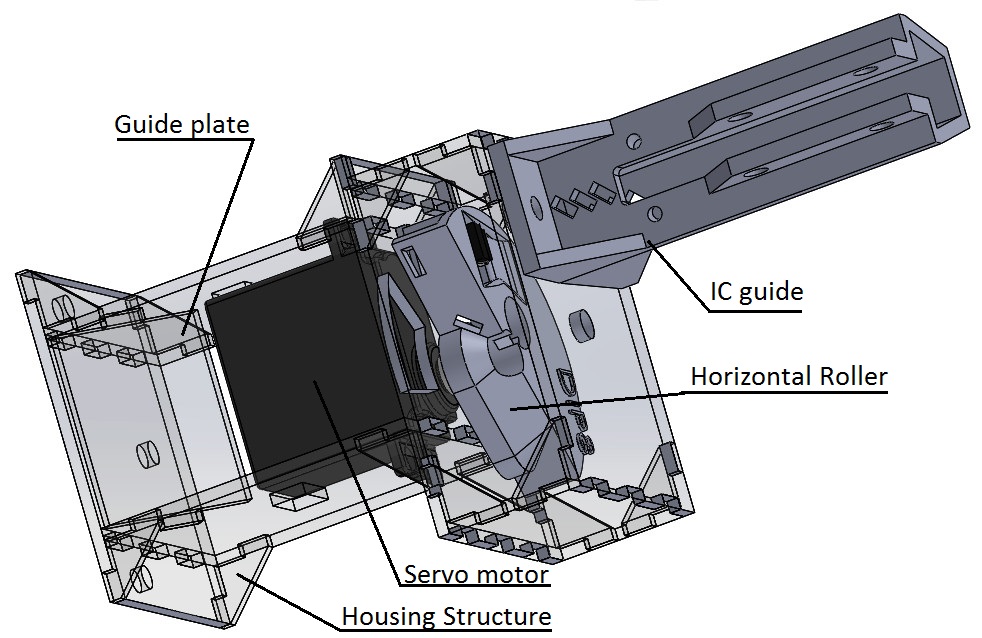
Document/Pictures/hfinal.jpg
