BadenMorgan/thesis/Document/Pictures/hfinalcomp.jpg

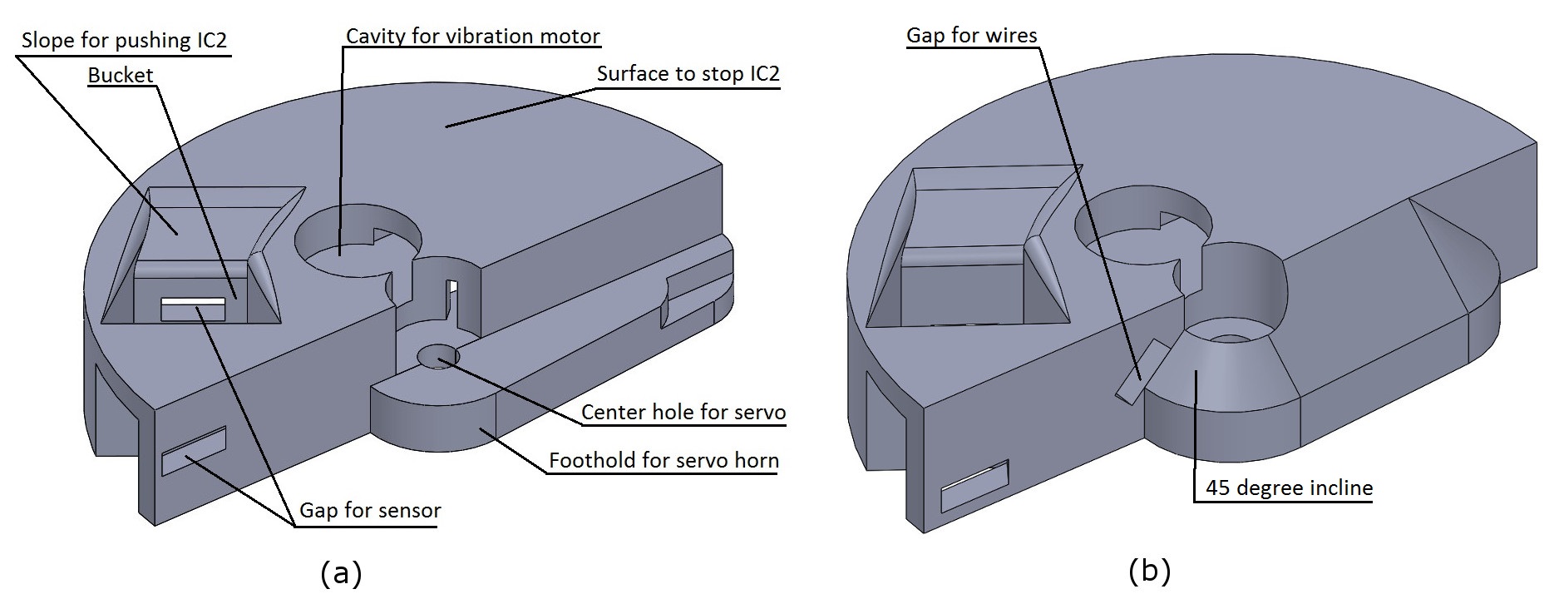
Document/Pictures/hfinalcomp.jpg
