BadenMorgan/thesis/Document/Pictures/hfinaliso.jpg

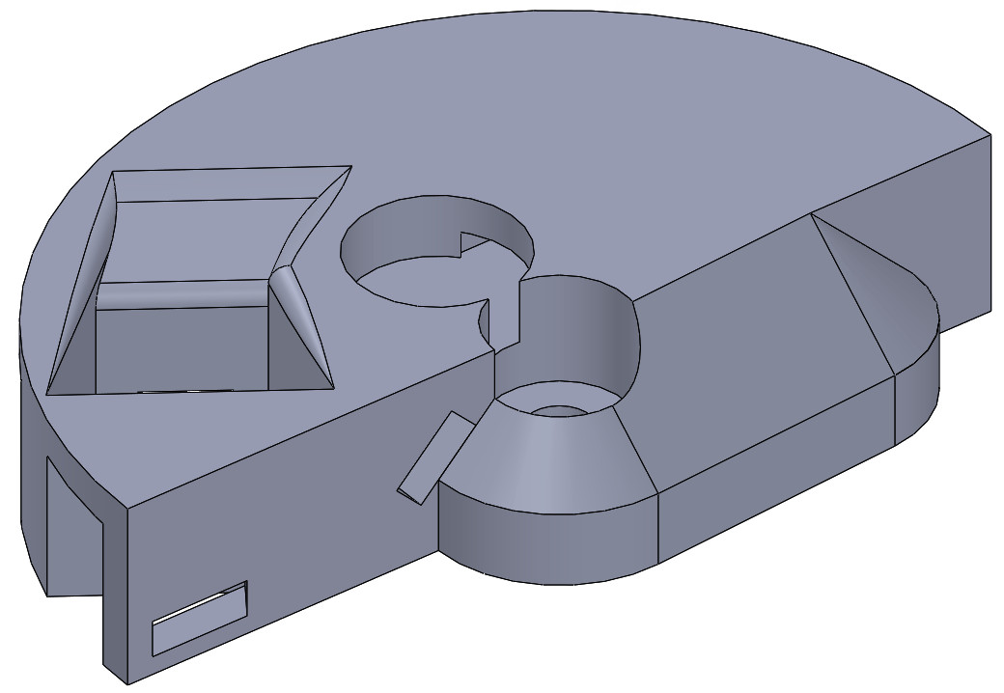
Document/Pictures/hfinaliso.jpg
