BadenMorgan/thesis/Document/Pictures/HorExploded.JPG

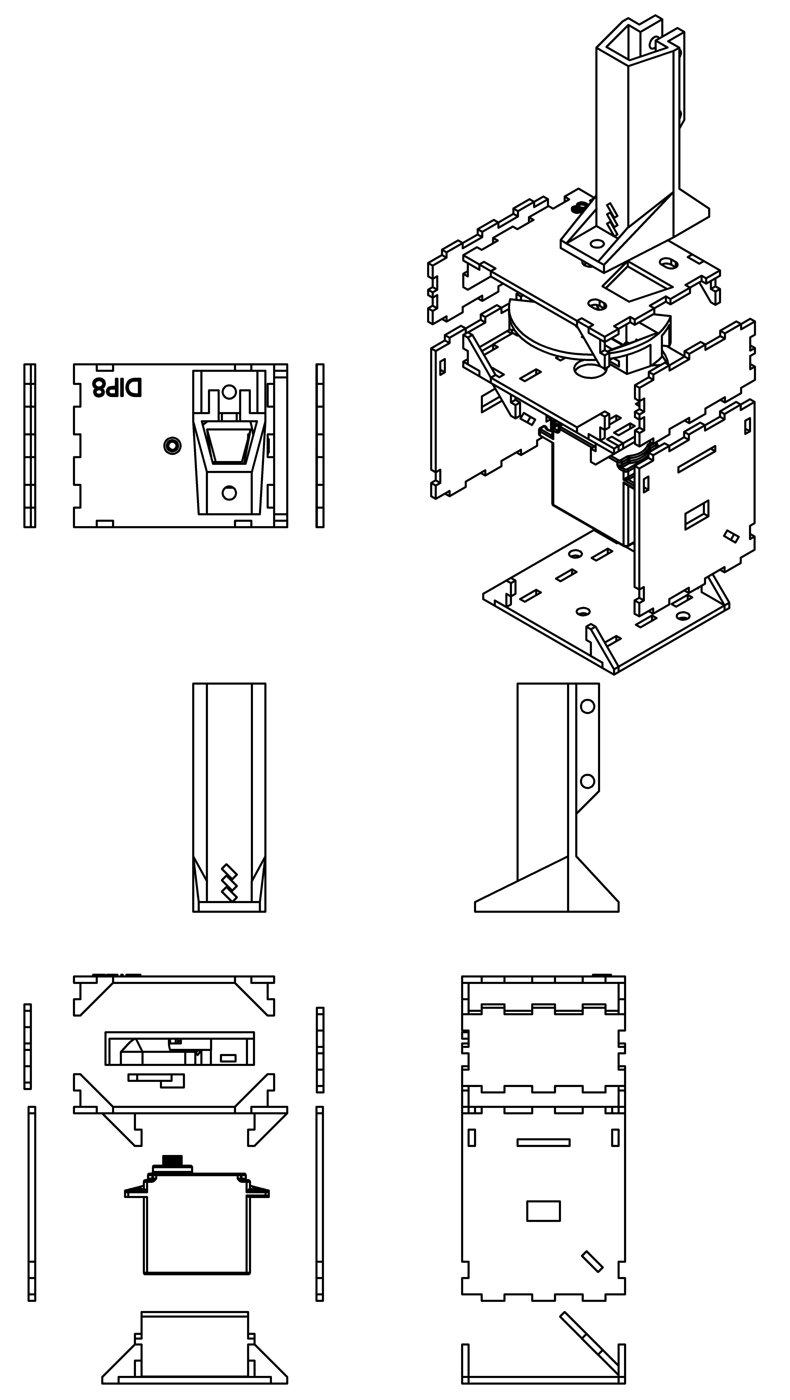
Document/Pictures/HorExploded.JPG
