BadenMorgan/thesis/Document/Pictures/horfinalallv2.JPG

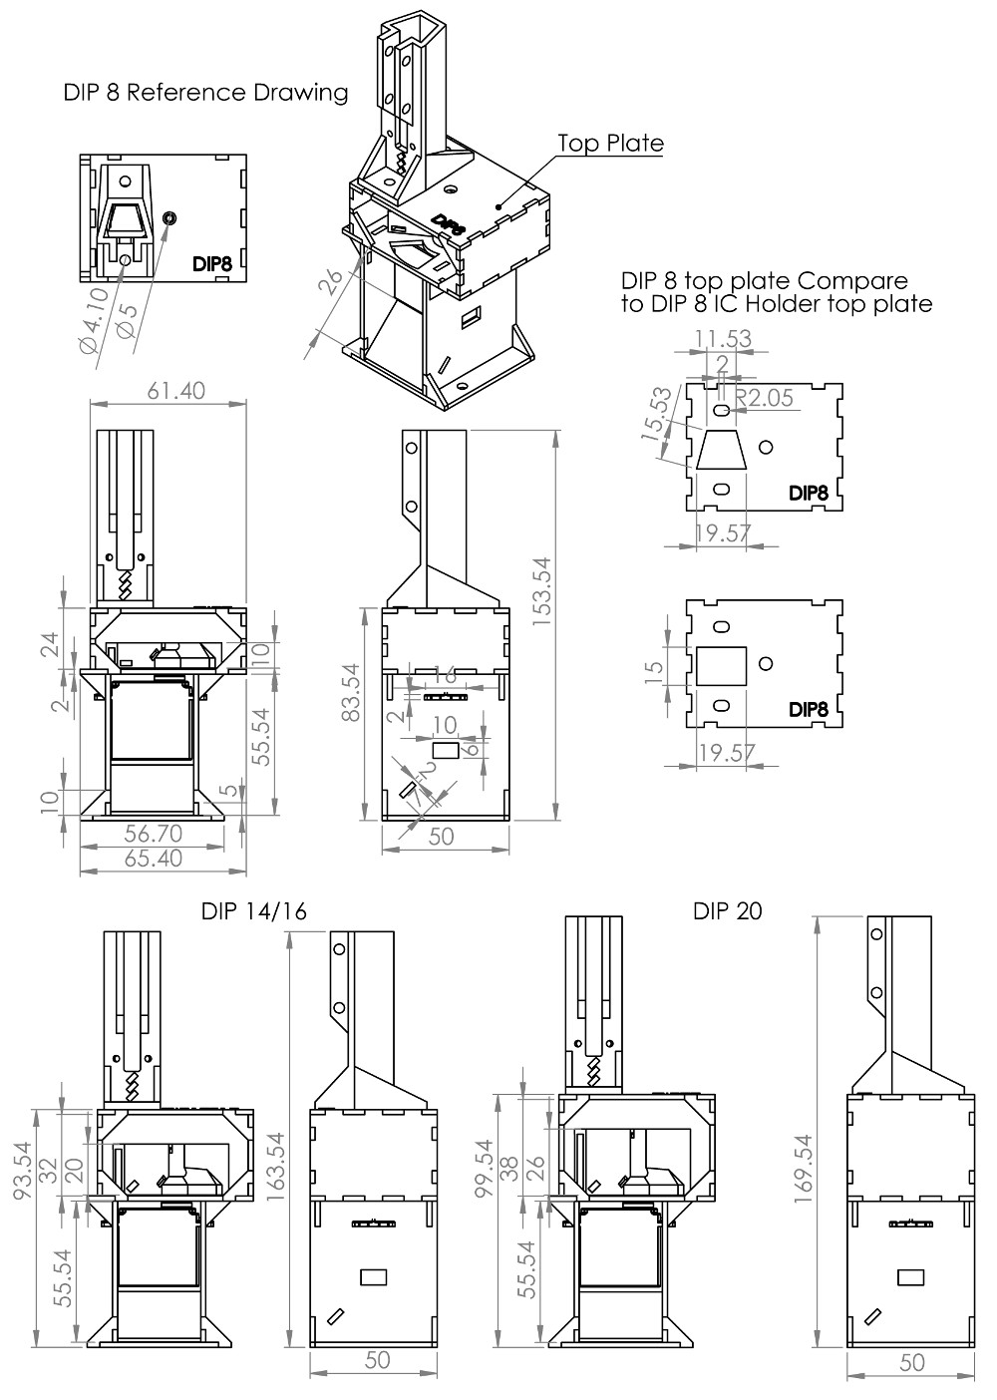
Document/Pictures/horfinalallv2.JPG
