BadenMorgan/thesis/Document/Pictures/horv1.JPG

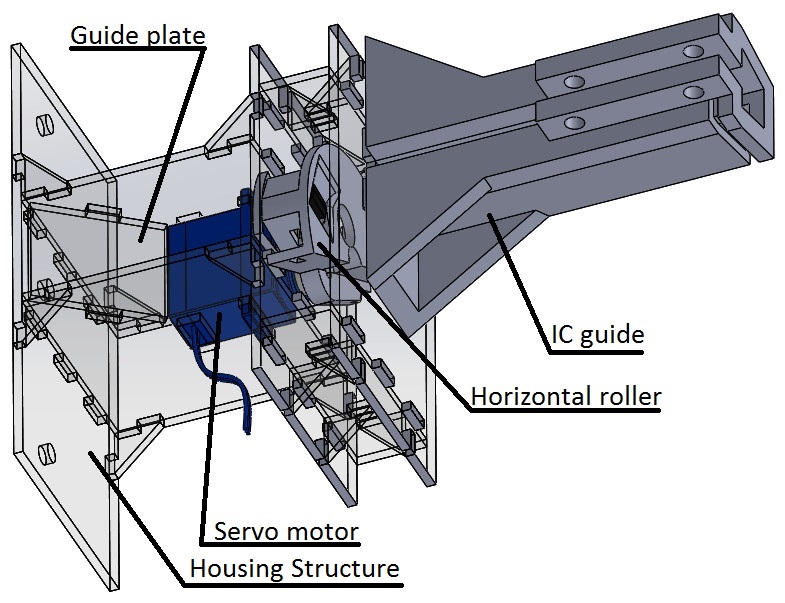
Document/Pictures/horv1.JPG
