BadenMorgan/thesis/Document/Pictures/horv1real.JPG

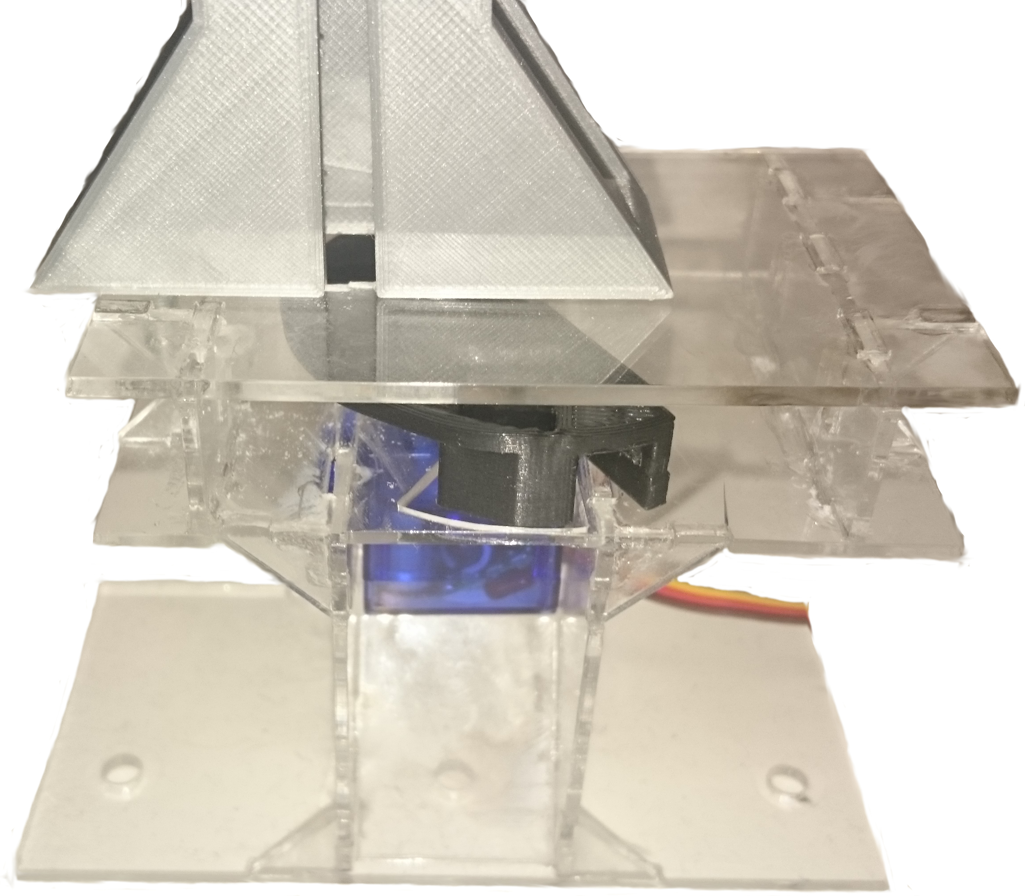
Document/Pictures/horv1real.JPG
