BadenMorgan/thesis/Document/Pictures/hr1.JPG

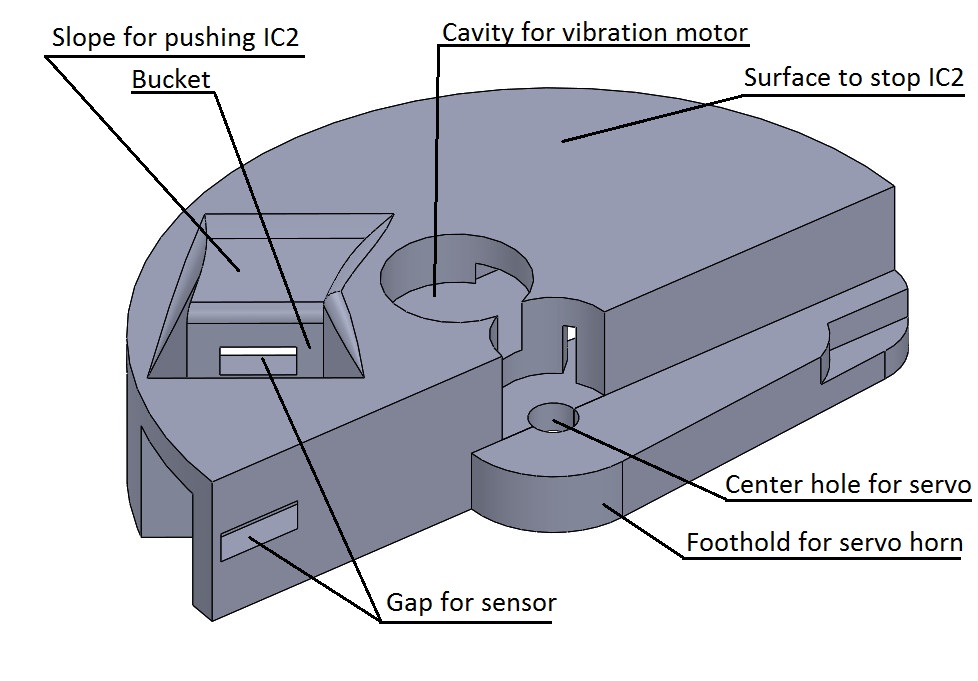
Document/Pictures/hr1.JPG
