BadenMorgan/thesis/Document/Pictures/I2CRCFilter.jpg

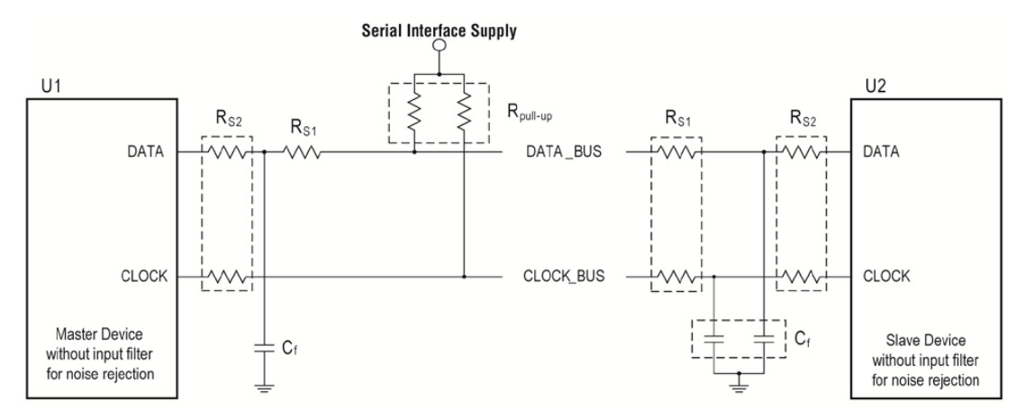
Document/Pictures/I2CRCFilter.jpg
