BadenMorgan/thesis/Document/Pictures/ideah1.JPG

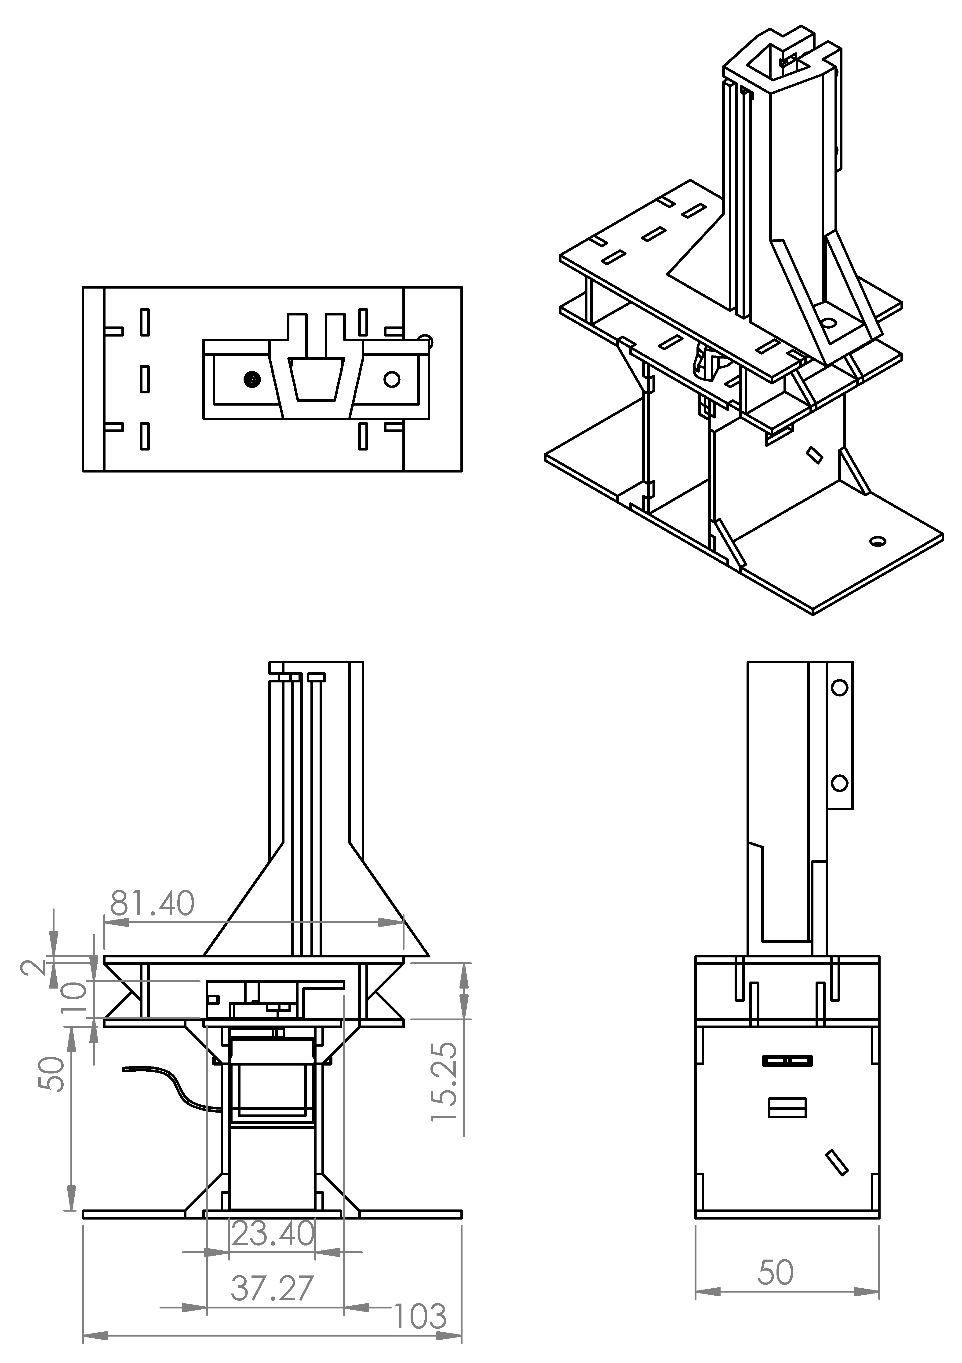
Document/Pictures/ideah1.JPG
