BadenMorgan/thesis/Document/Pictures/LAMP_software_bundle.jpg

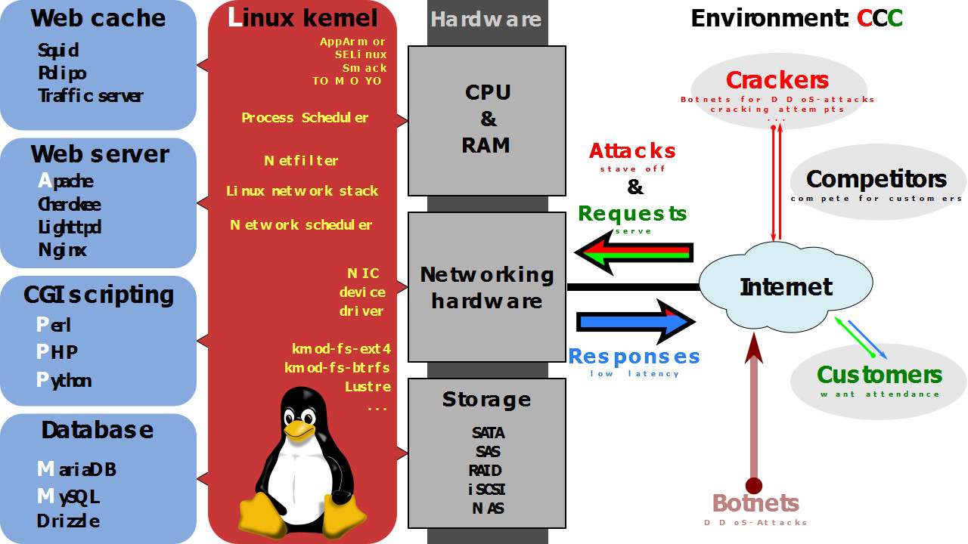
Document/Pictures/LAMP_software_bundle.jpg
