BadenMorgan/thesis/Document/Pictures/lcdboard.jpg

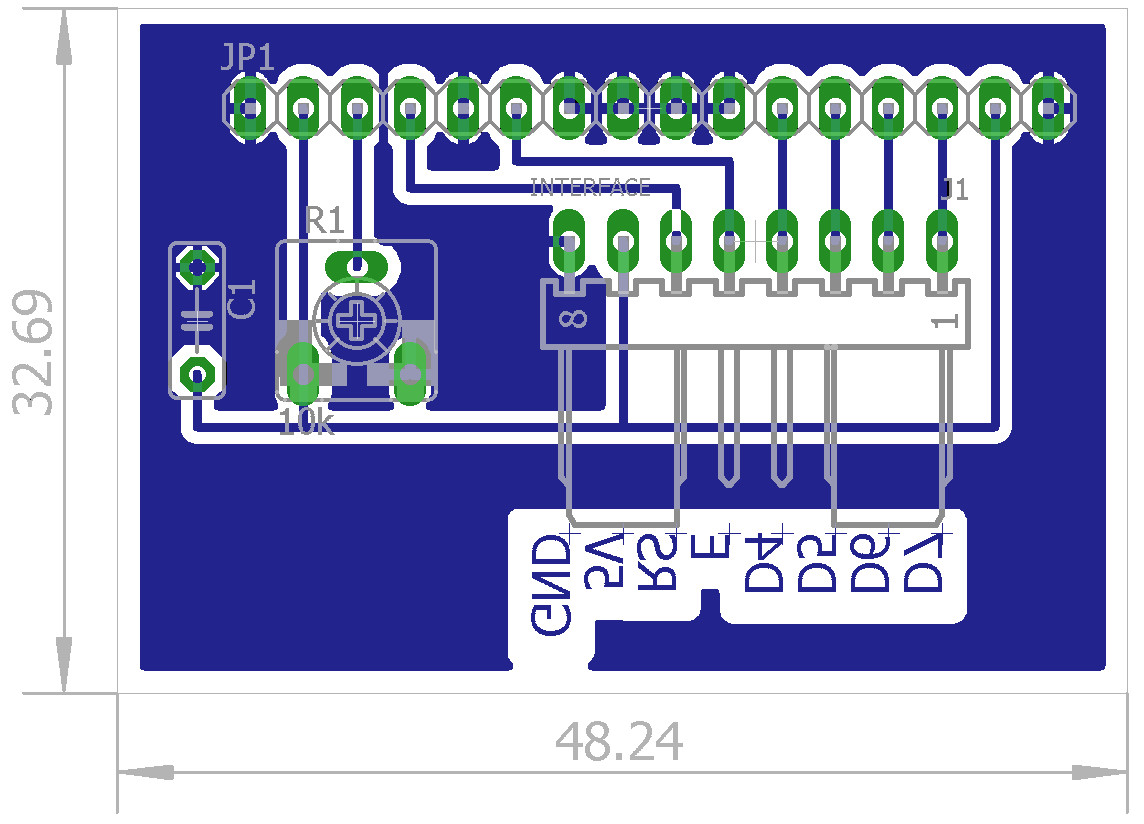
Document/Pictures/lcdboard.jpg
