BadenMorgan/thesis/Document/Pictures/LCDboard.png

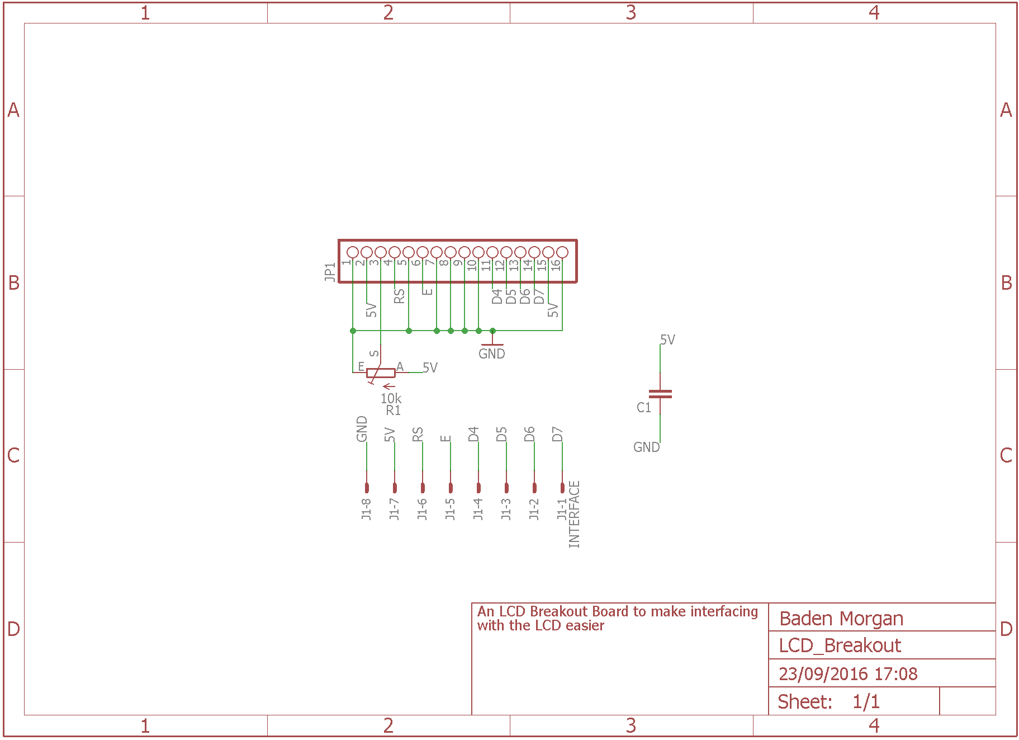
Document/Pictures/LCDboard.png
