BadenMorgan/thesis/Document/Pictures/lcdbreakassem.jpg

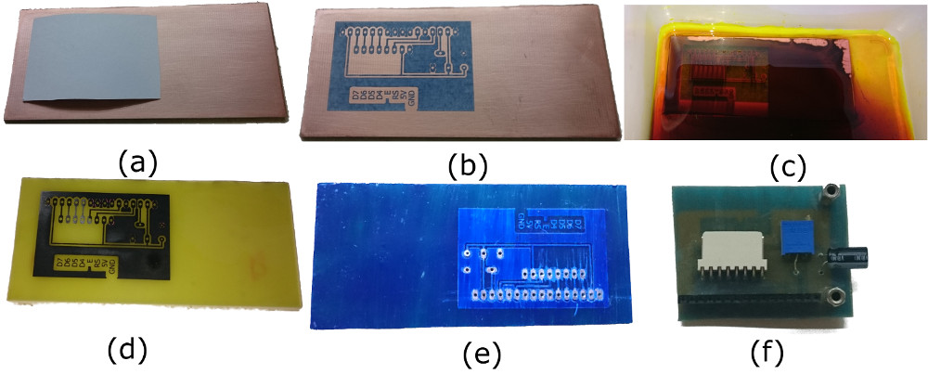
Document/Pictures/lcdbreakassem.jpg
