BadenMorgan/thesis/Document/Pictures/MaximSoftUartFig1.jpg

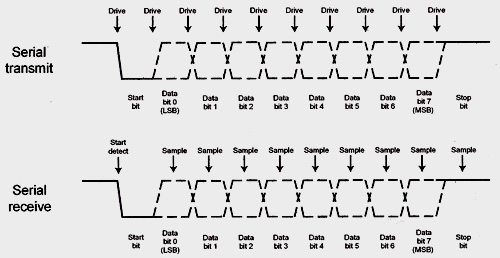
Document/Pictures/MaximSoftUartFig1.jpg
