BadenMorgan/thesis/Document/Pictures/mcumod.jpg

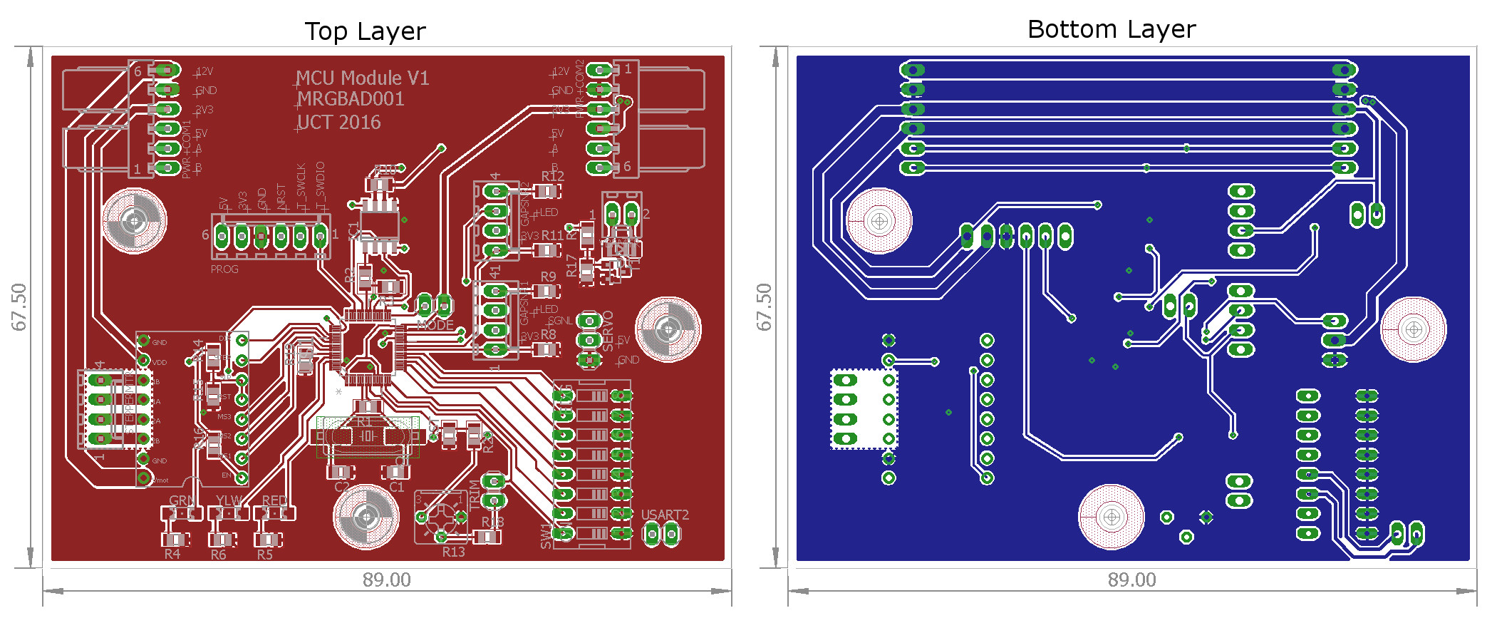
Document/Pictures/mcumod.jpg
