BadenMorgan/thesis/Document/Pictures/MCUmod.png

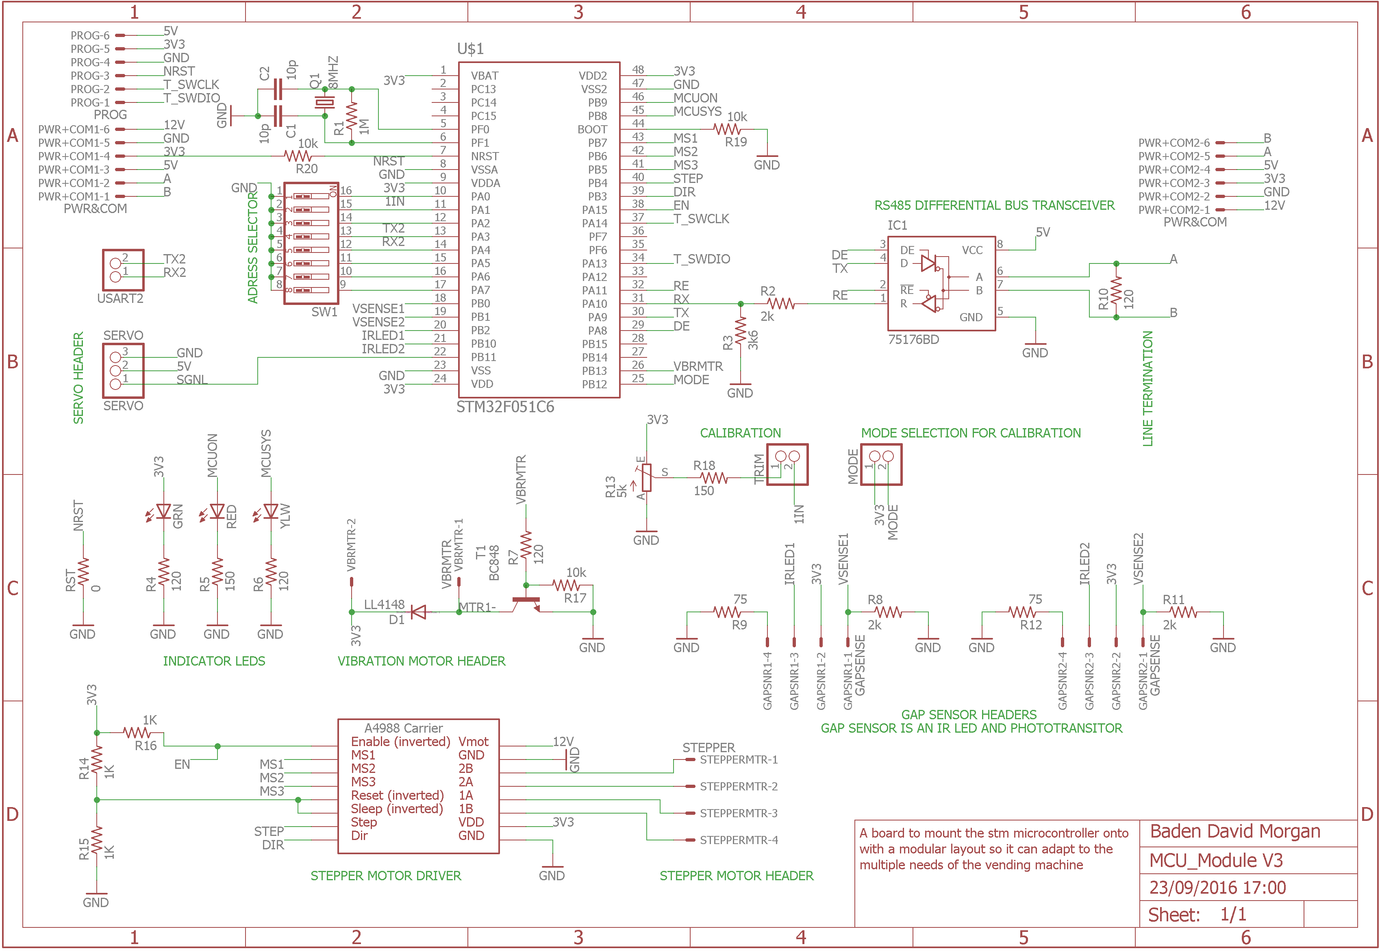
Document/Pictures/MCUmod.png
