BadenMorgan/thesis/Document/Pictures/mcumodpcb.JPG

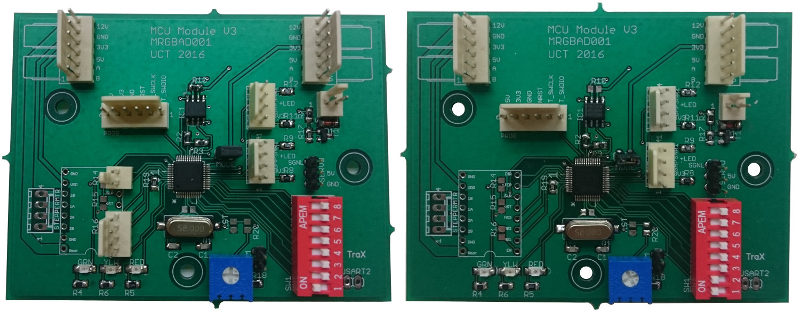
Document/Pictures/mcumodpcb.JPG
