BadenMorgan/thesis/Document/Pictures/med1.jpg

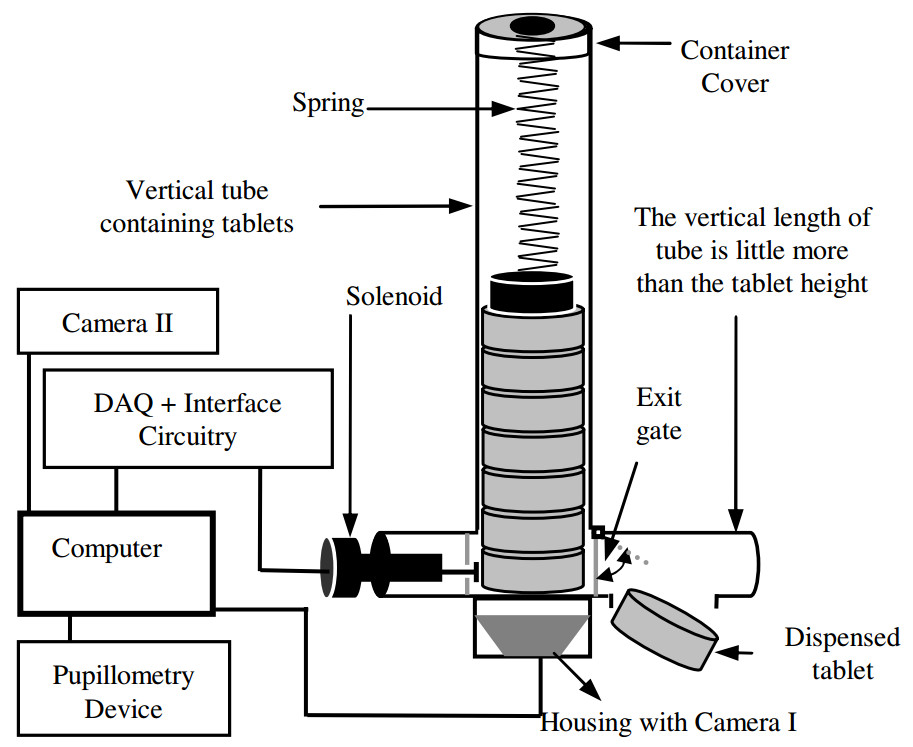
Document/Pictures/med1.jpg
