BadenMorgan/thesis/Document/Pictures/med2.JPG

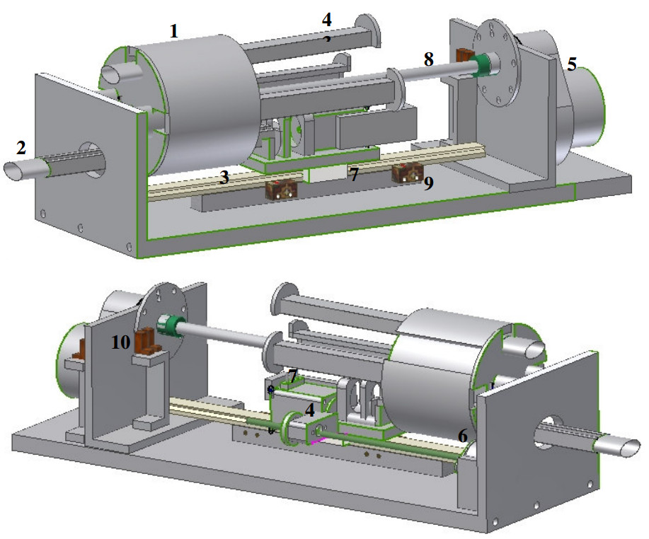
Document/Pictures/med2.JPG
