BadenMorgan/thesis/Document/Pictures/med3-2 (1).jpg

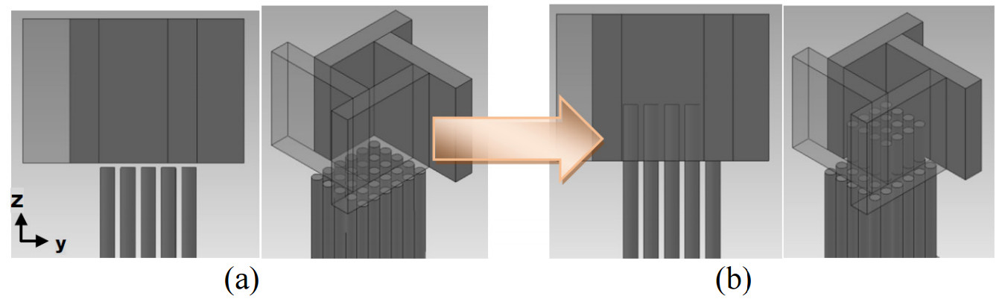
Document/Pictures/med3-2 (1).jpg
