BadenMorgan/thesis/Document/Pictures/med3-3 (1).jpg

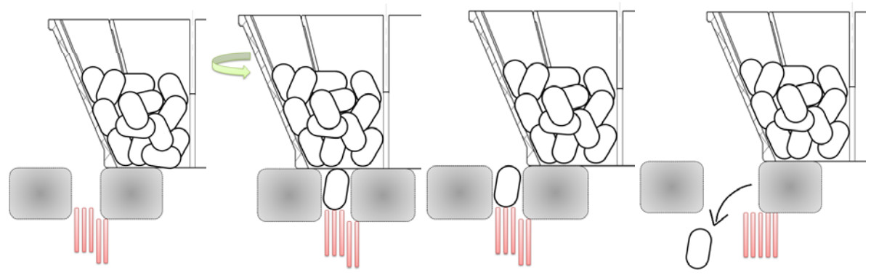
Document/Pictures/med3-3 (1).jpg
