BadenMorgan/thesis/Document/Pictures/PIHAT.jpg

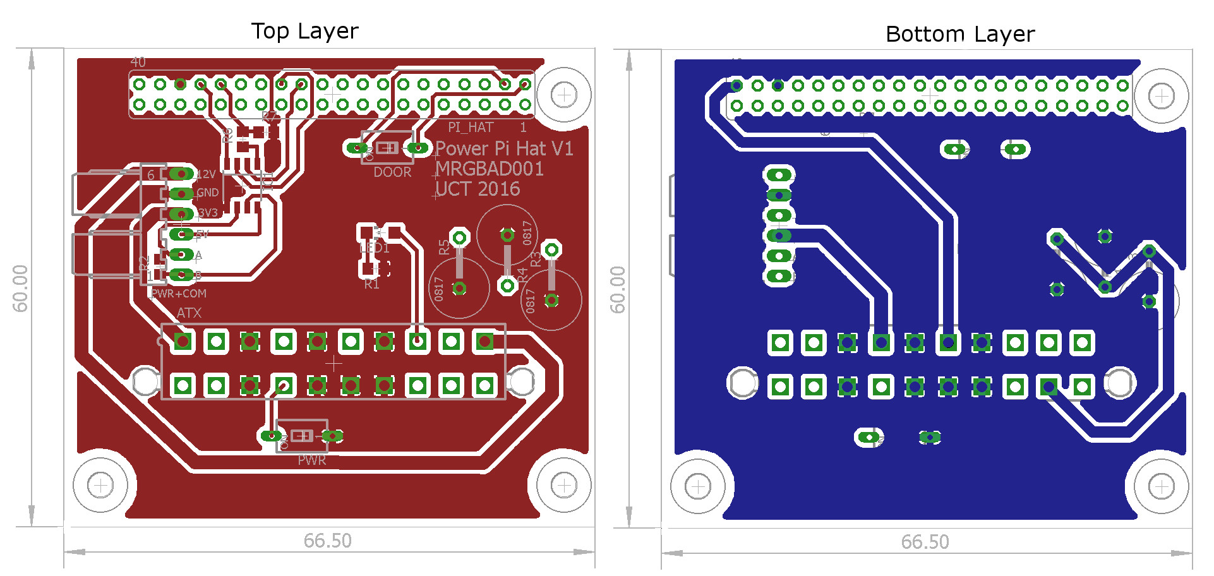
Document/Pictures/PIHAT.jpg
