BadenMorgan/thesis/Document/Pictures/pihat.png

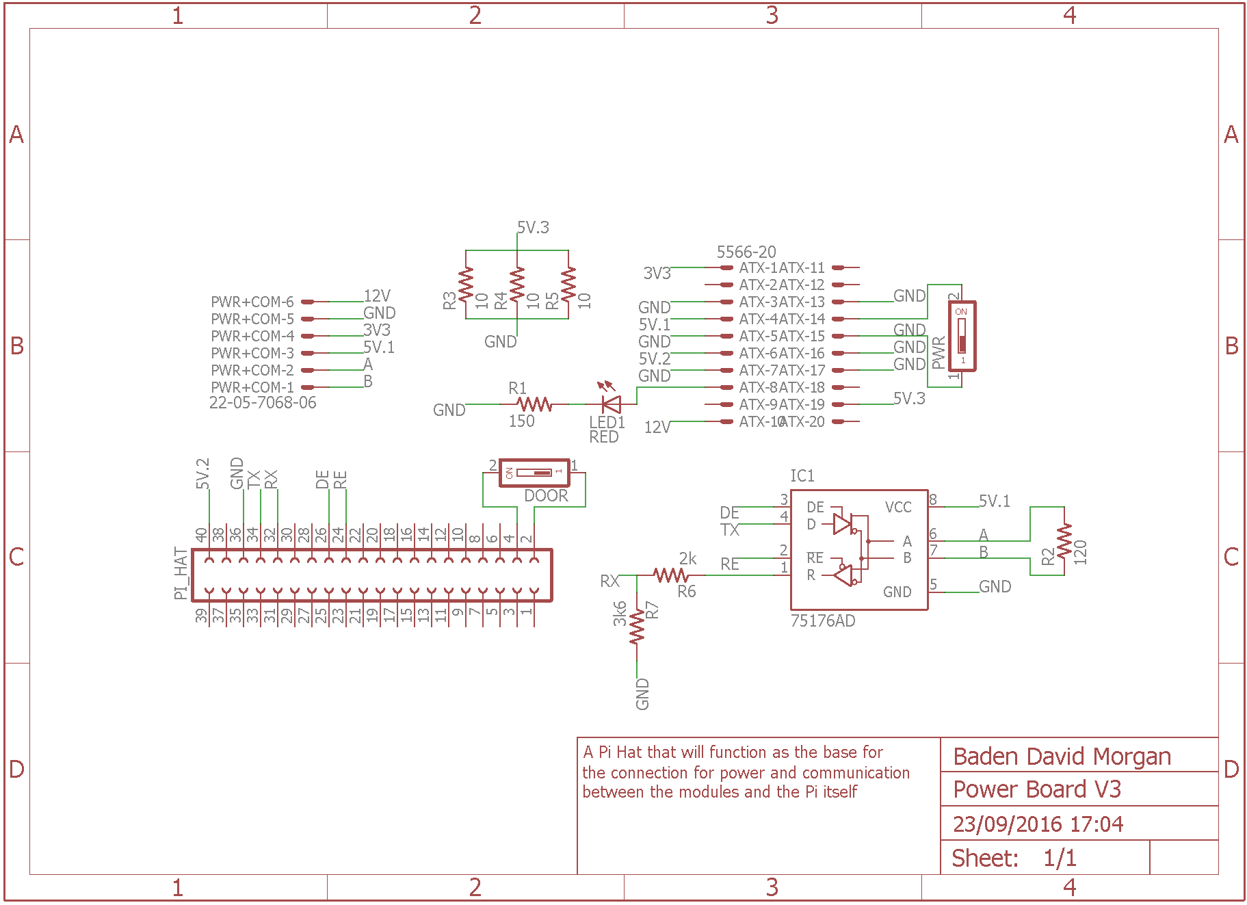
Document/Pictures/pihat.png
