BadenMorgan/thesis/Document/Pictures/pihatpcb.jpg

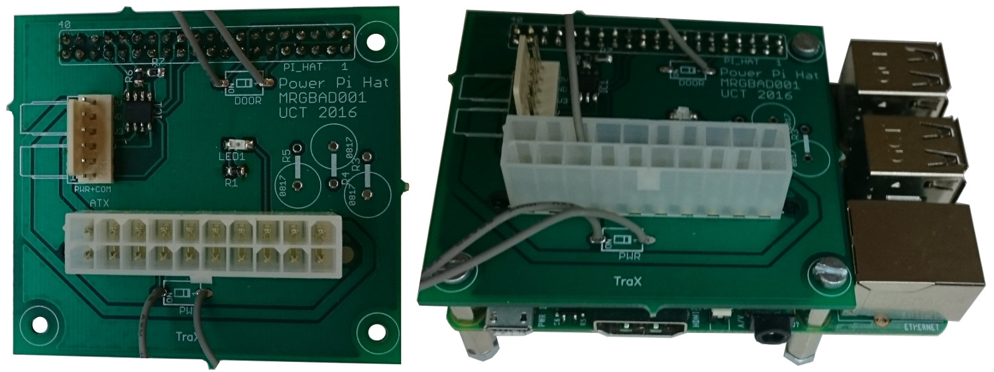
Document/Pictures/pihatpcb.jpg
