BadenMorgan/thesis/Document/Pictures/plagiarismdec.jpg

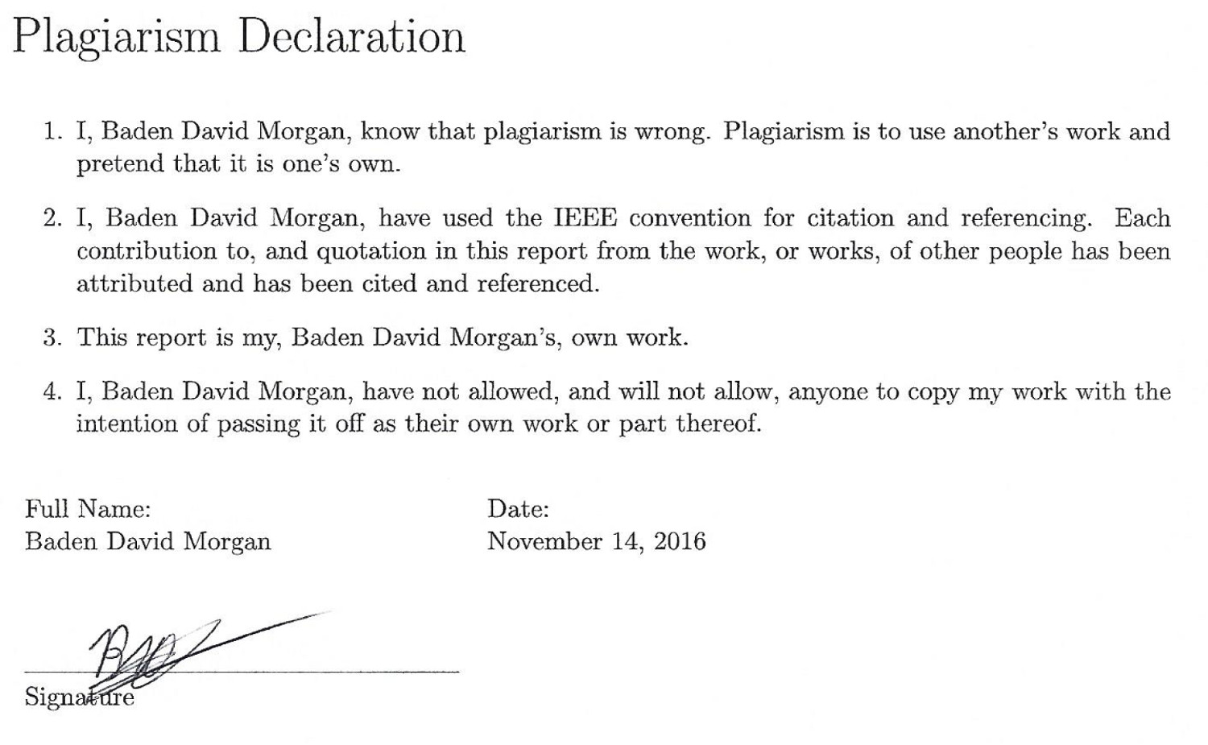
Document/Pictures/plagiarismdec.jpg
