BadenMorgan/thesis/Document/Pictures/PortVM.jpg

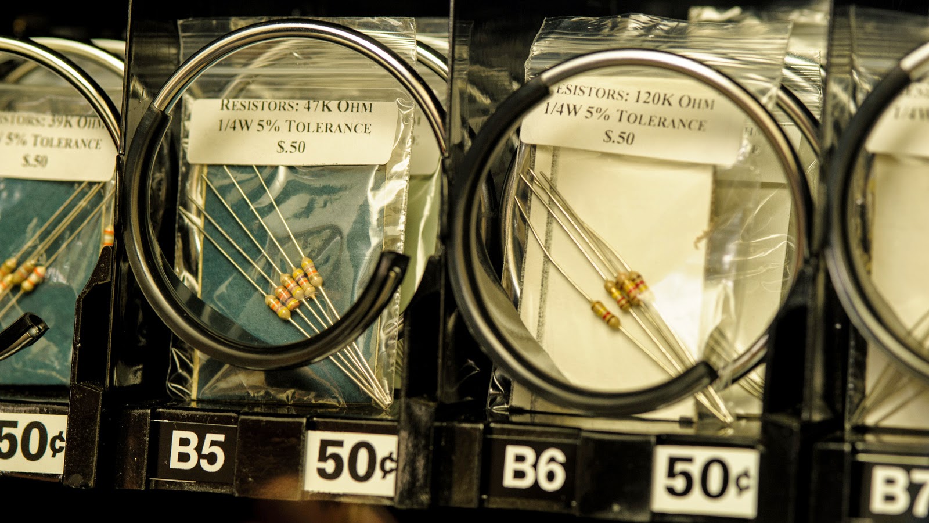
Document/Pictures/PortVM.jpg
