BadenMorgan/thesis/Document/Pictures/prototest.jpg

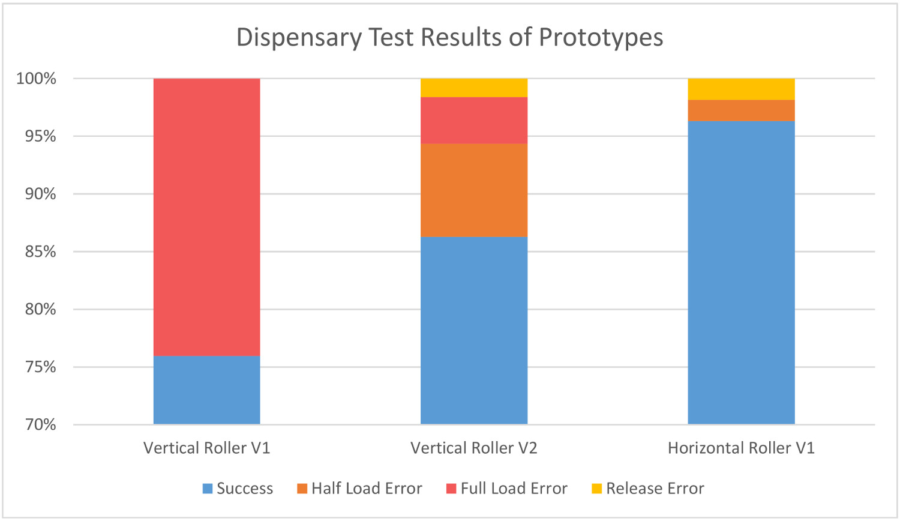
Document/Pictures/prototest.jpg
