BadenMorgan/thesis/Document/Pictures/redenclose.jpg

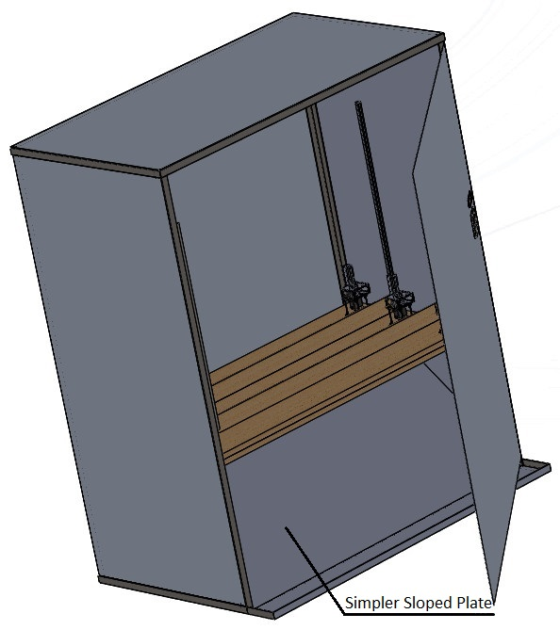
Document/Pictures/redenclose.jpg
