BadenMorgan/thesis/Document/Pictures/rfidcover.jpg

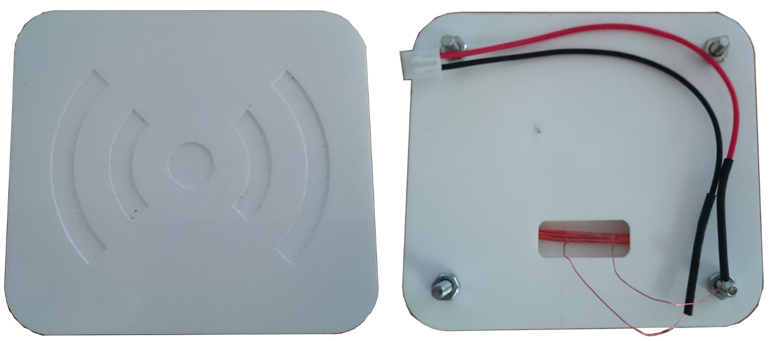
Document/Pictures/rfidcover.jpg
