BadenMorgan/thesis/Document/Pictures/RFIDdetailed.JPG

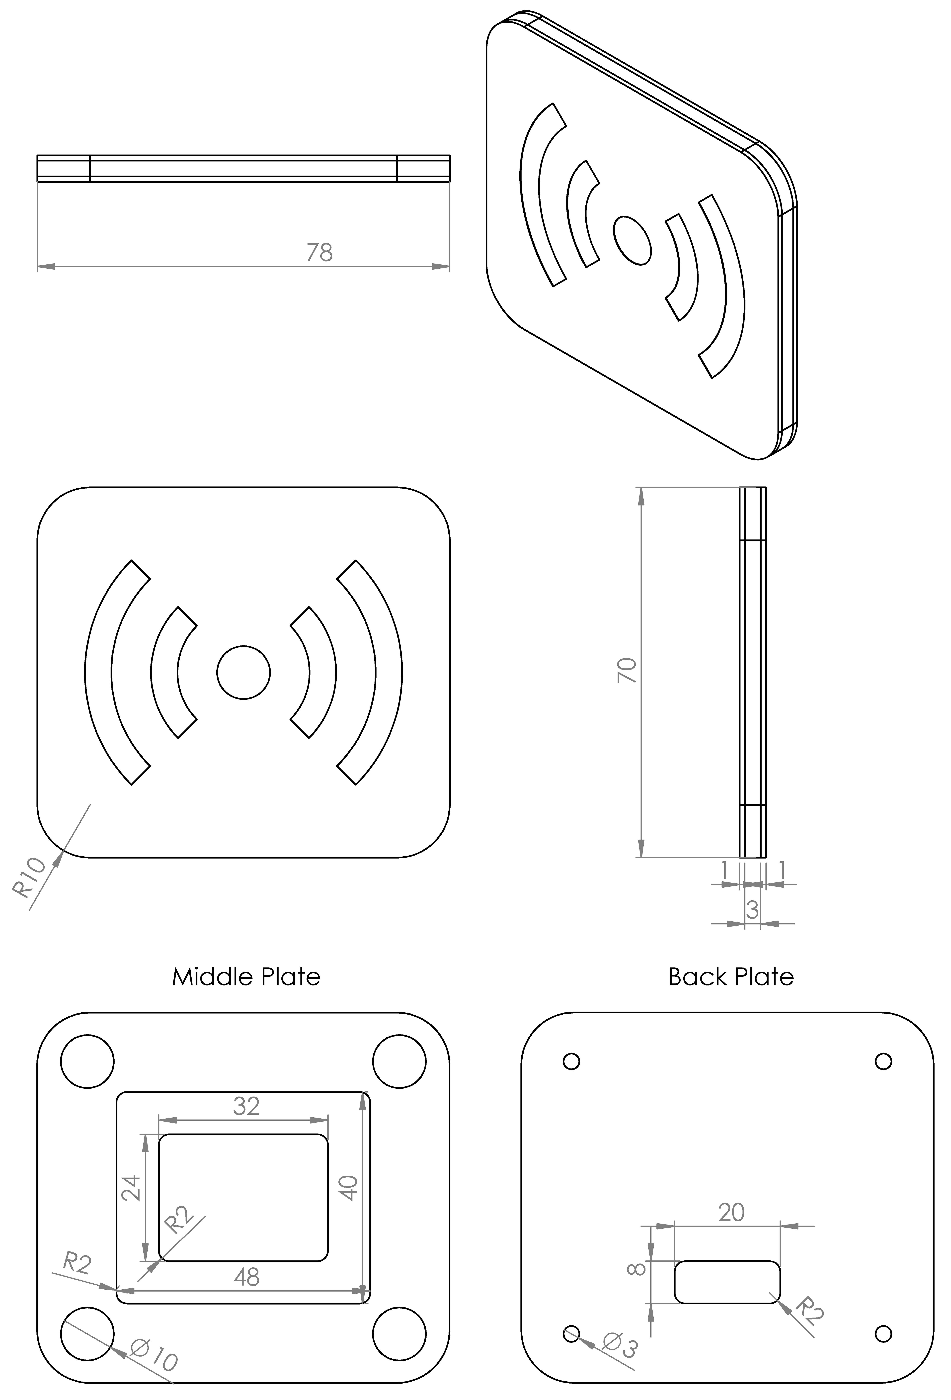
Document/Pictures/RFIDdetailed.JPG
