BadenMorgan/thesis/Document/Pictures/rfidhold.JPG

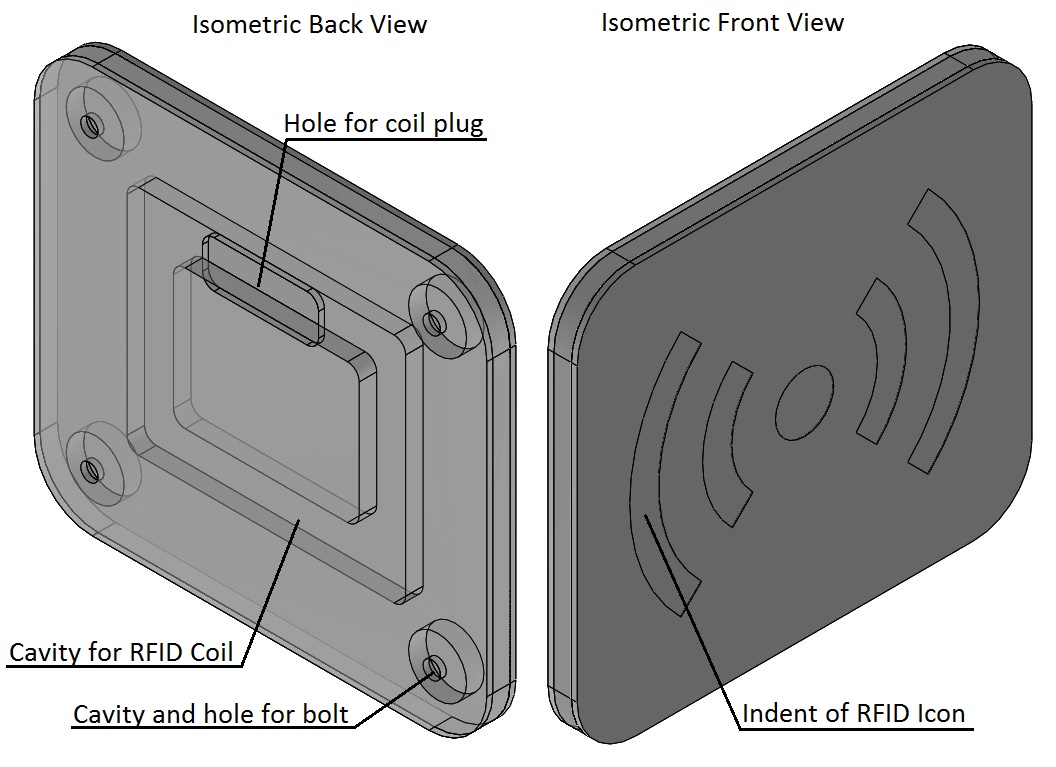
Document/Pictures/rfidhold.JPG
