BadenMorgan/thesis/Document/Pictures/roller slide.jpg

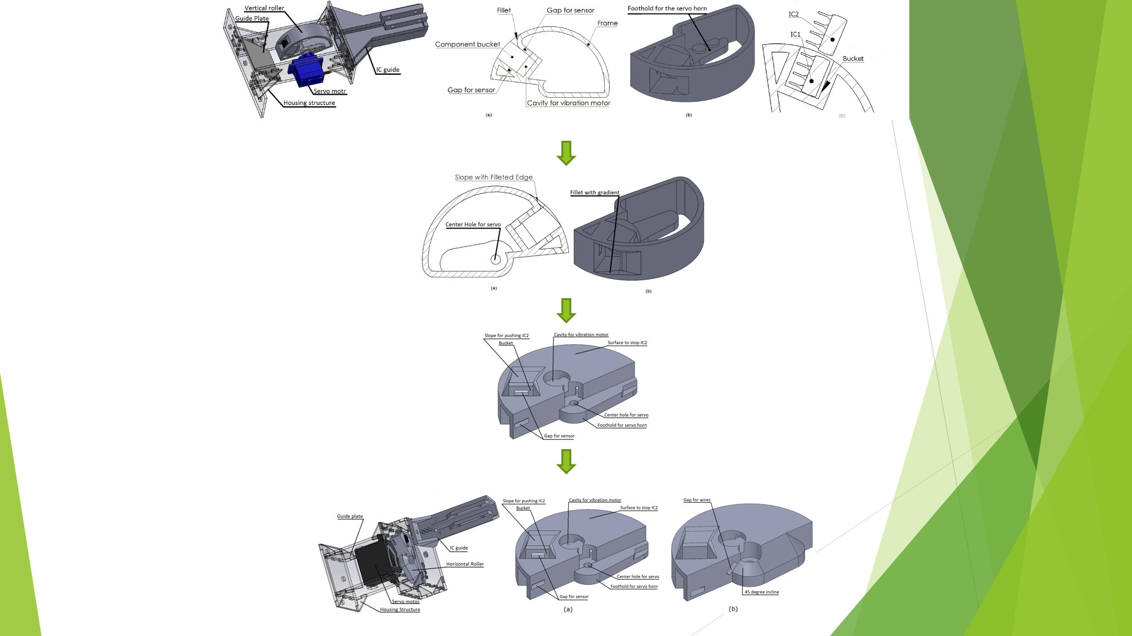
Document/Pictures/roller slide.jpg
