BadenMorgan/thesis/Document/Pictures/Rollers.jpg

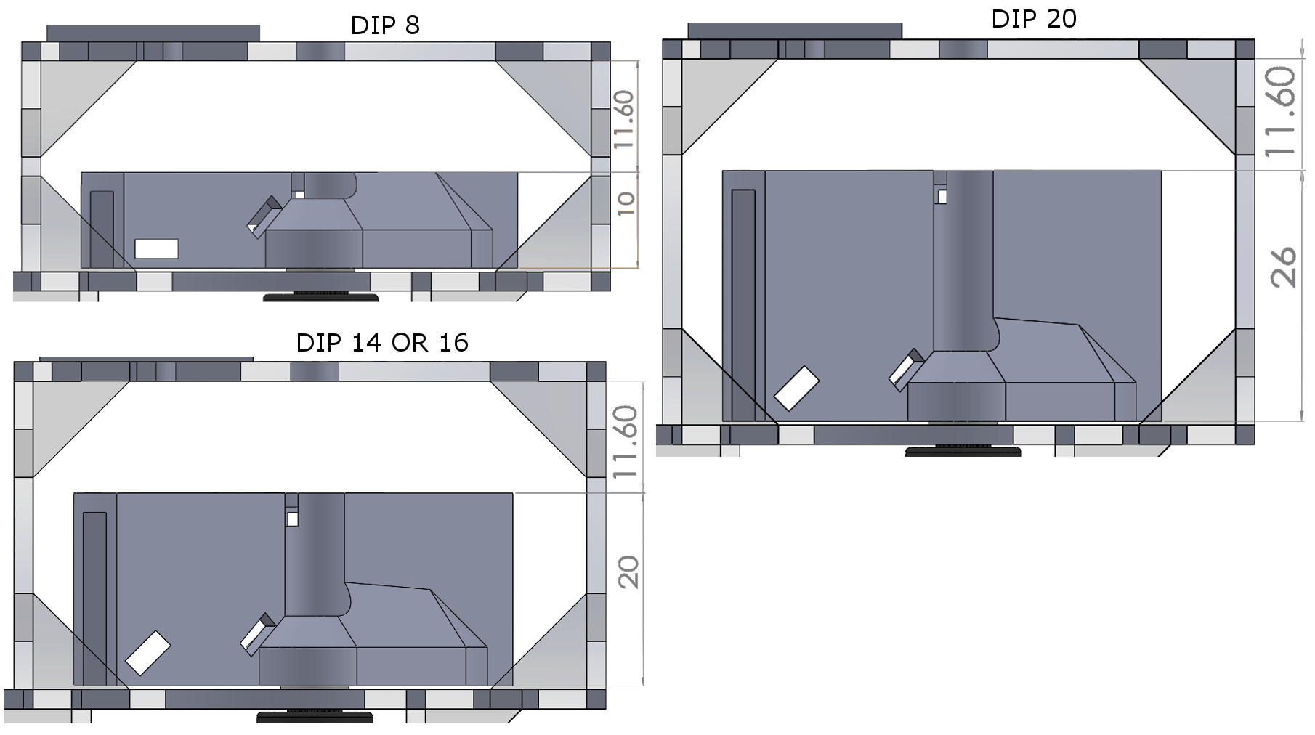
Document/Pictures/Rollers.jpg
