BadenMorgan/thesis/Document/Pictures/sheet1v3.JPG

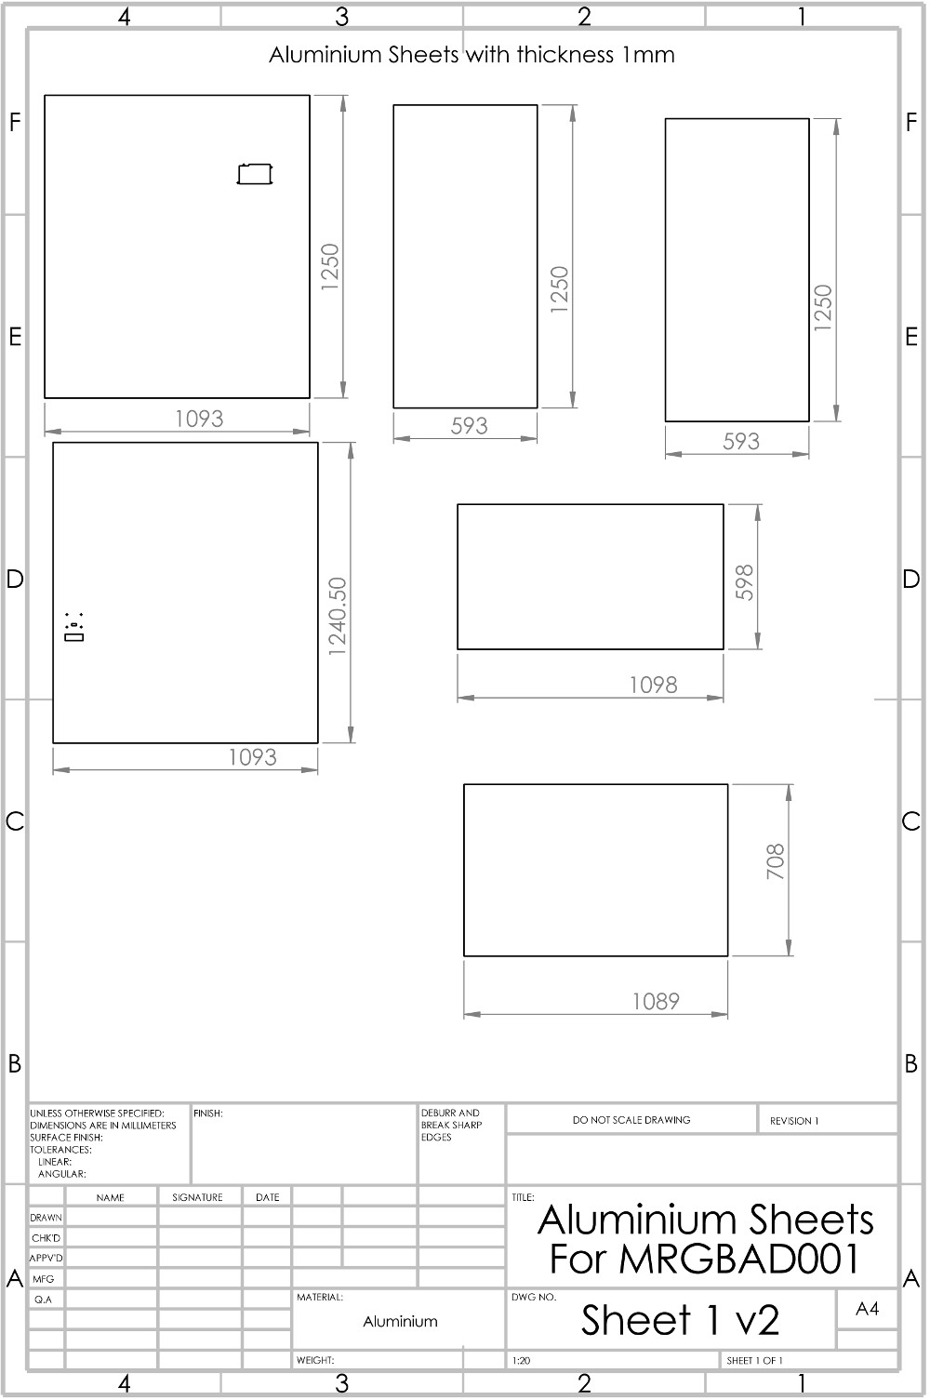
Document/Pictures/sheet1v3.JPG
