BadenMorgan/thesis/Document/Pictures/sheet2v3.JPG

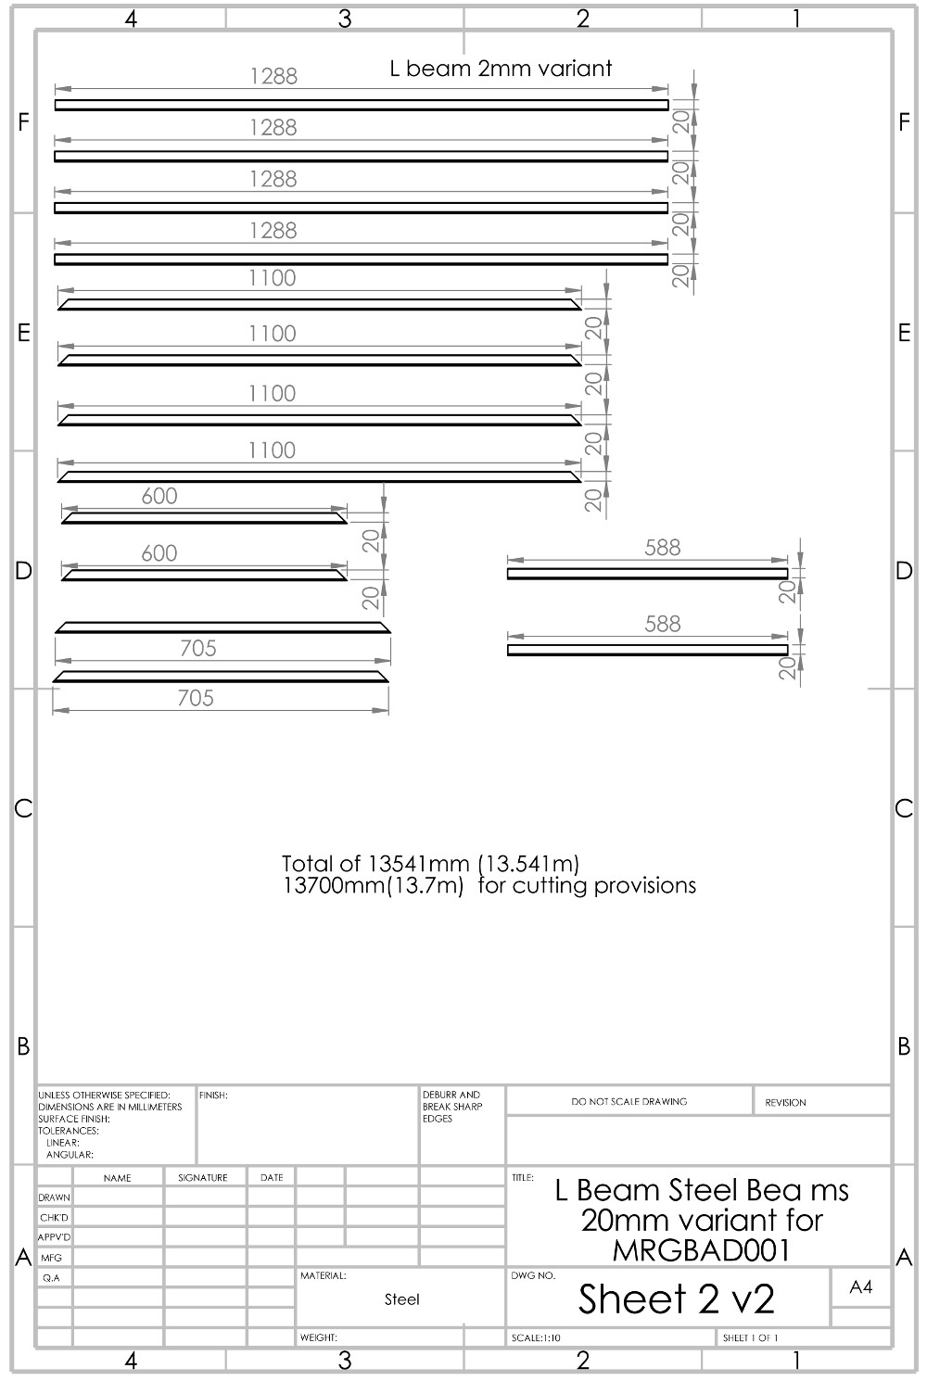
Document/Pictures/sheet2v3.JPG
