BadenMorgan/thesis/Document/Pictures/sheet3v3.JPG

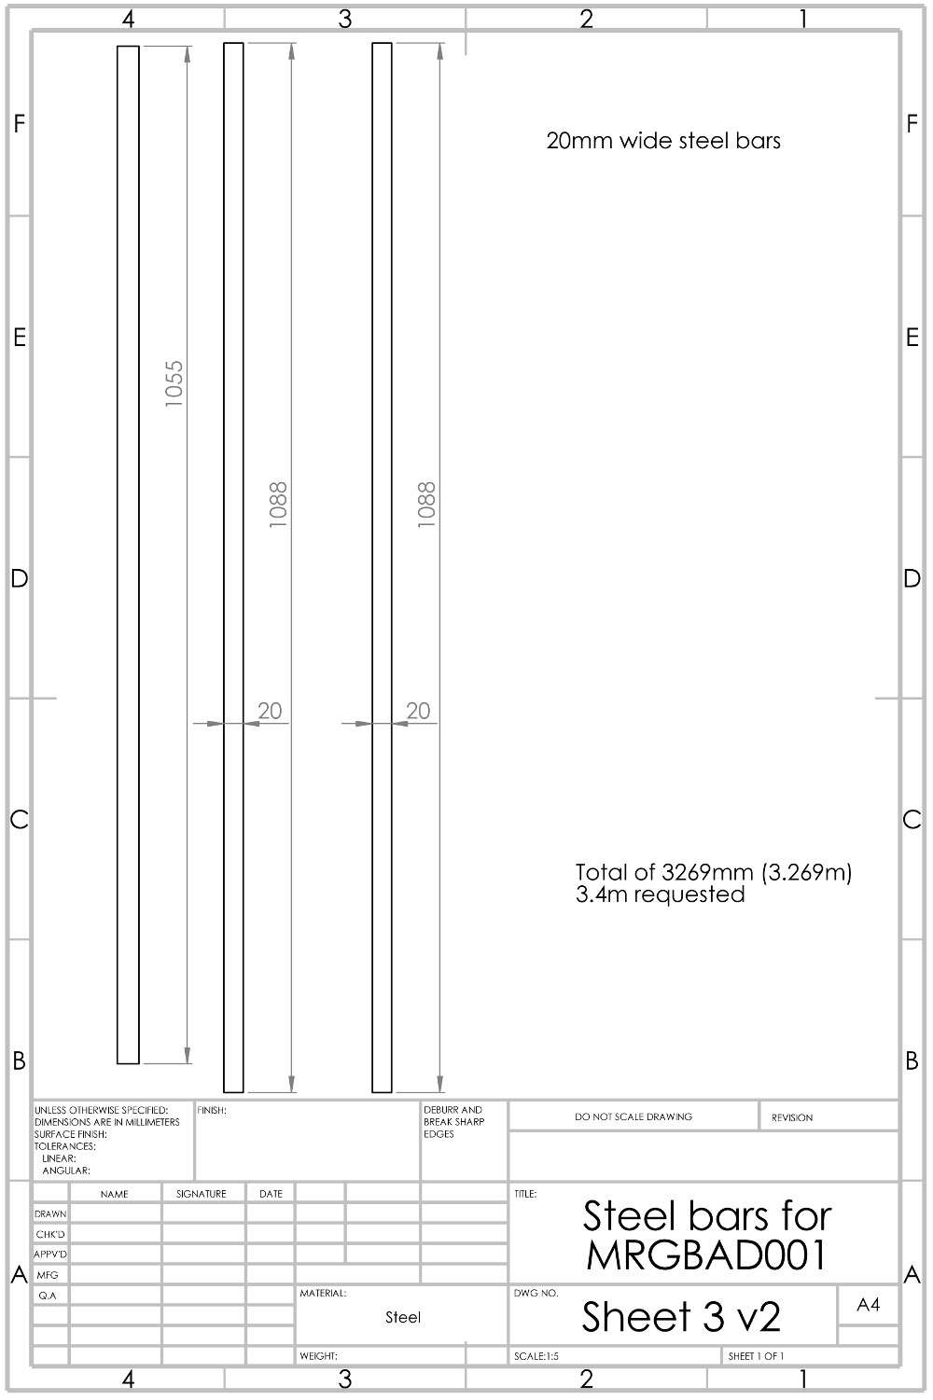
Document/Pictures/sheet3v3.JPG
