BadenMorgan/thesis/Document/Pictures/sheet4v2.JPG

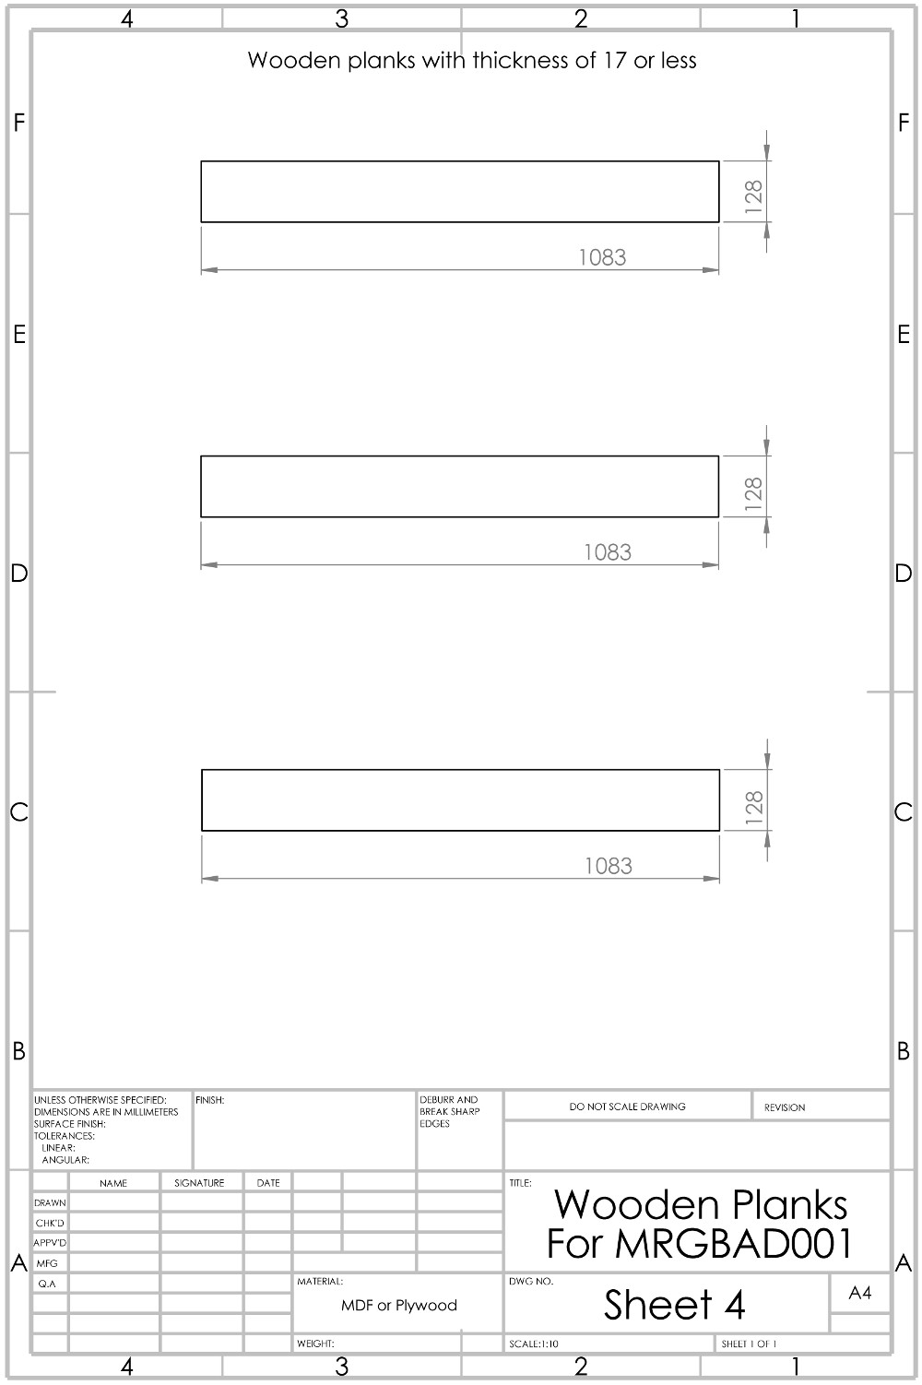
Document/Pictures/sheet4v2.JPG
