BadenMorgan/thesis/Document/Pictures/sheet5v2.JPG

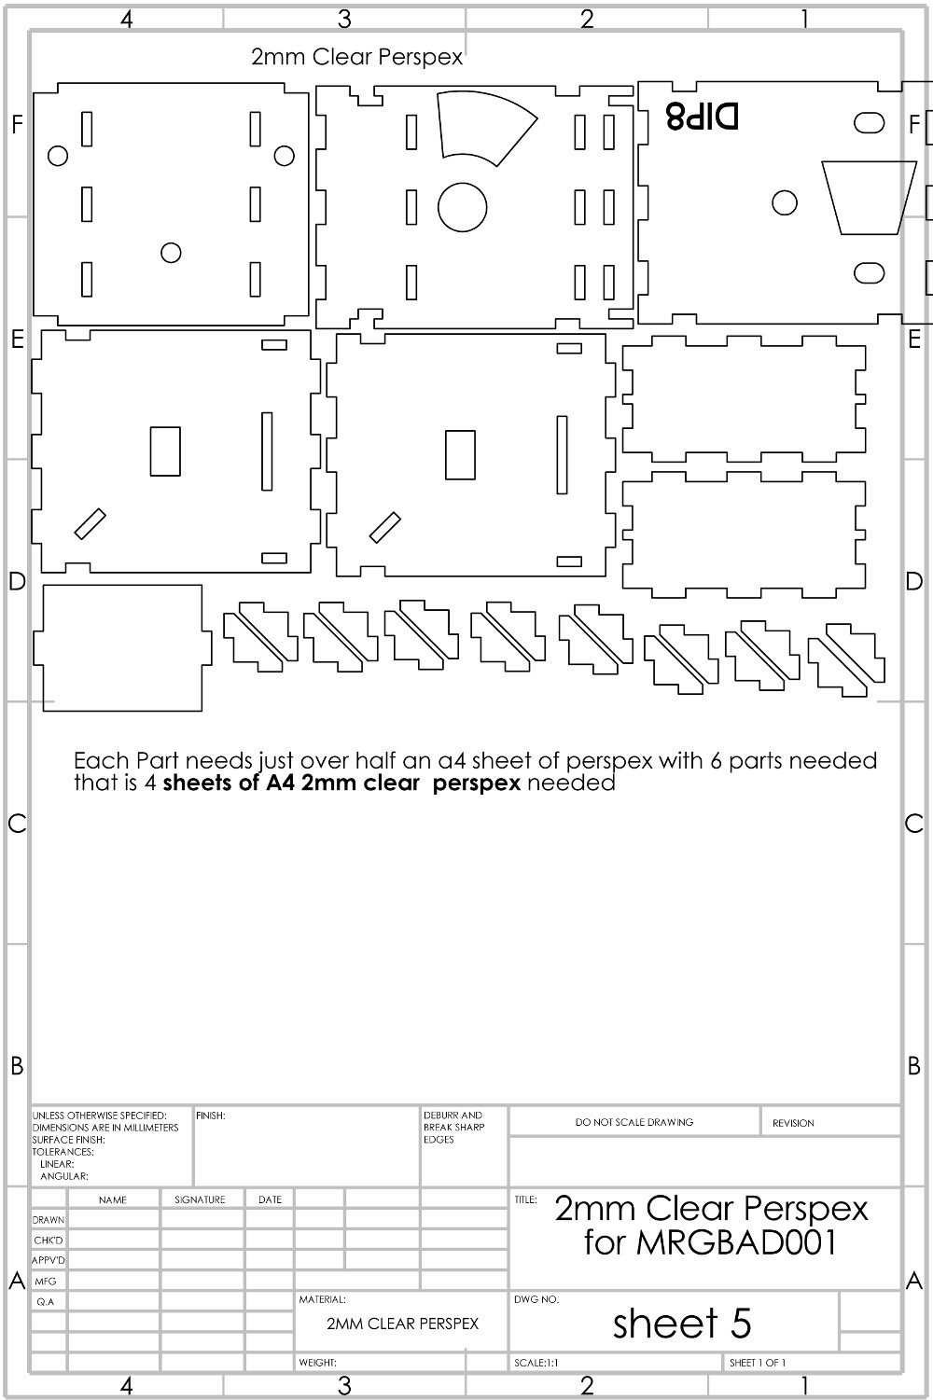
Document/Pictures/sheet5v2.JPG
