BadenMorgan/thesis/Document/Pictures/sheet6v2.JPG

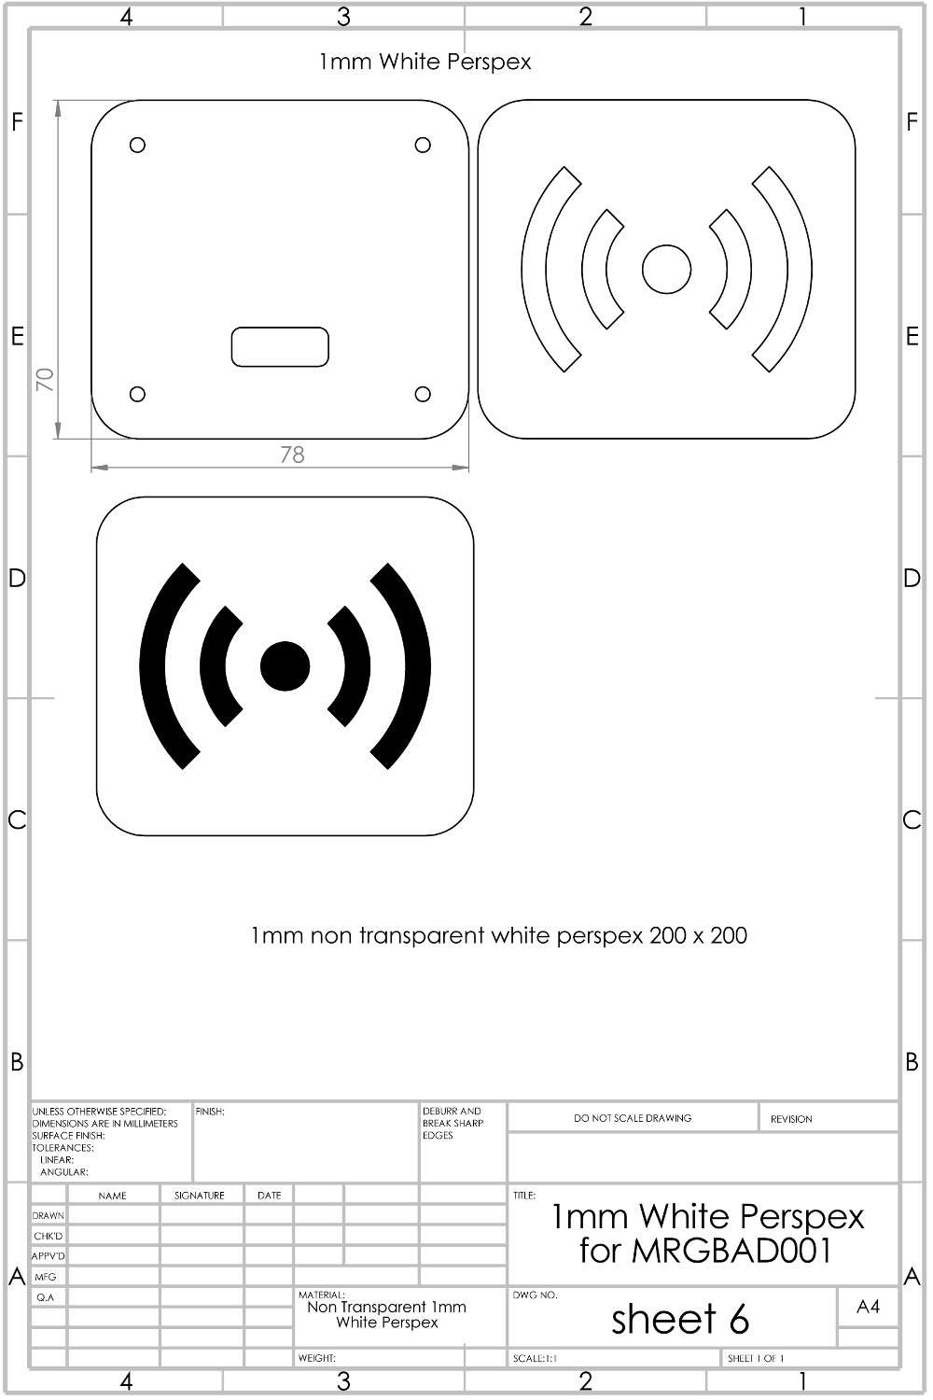
Document/Pictures/sheet6v2.JPG
