BadenMorgan/thesis/Document/Pictures/sheet7v2.JPG

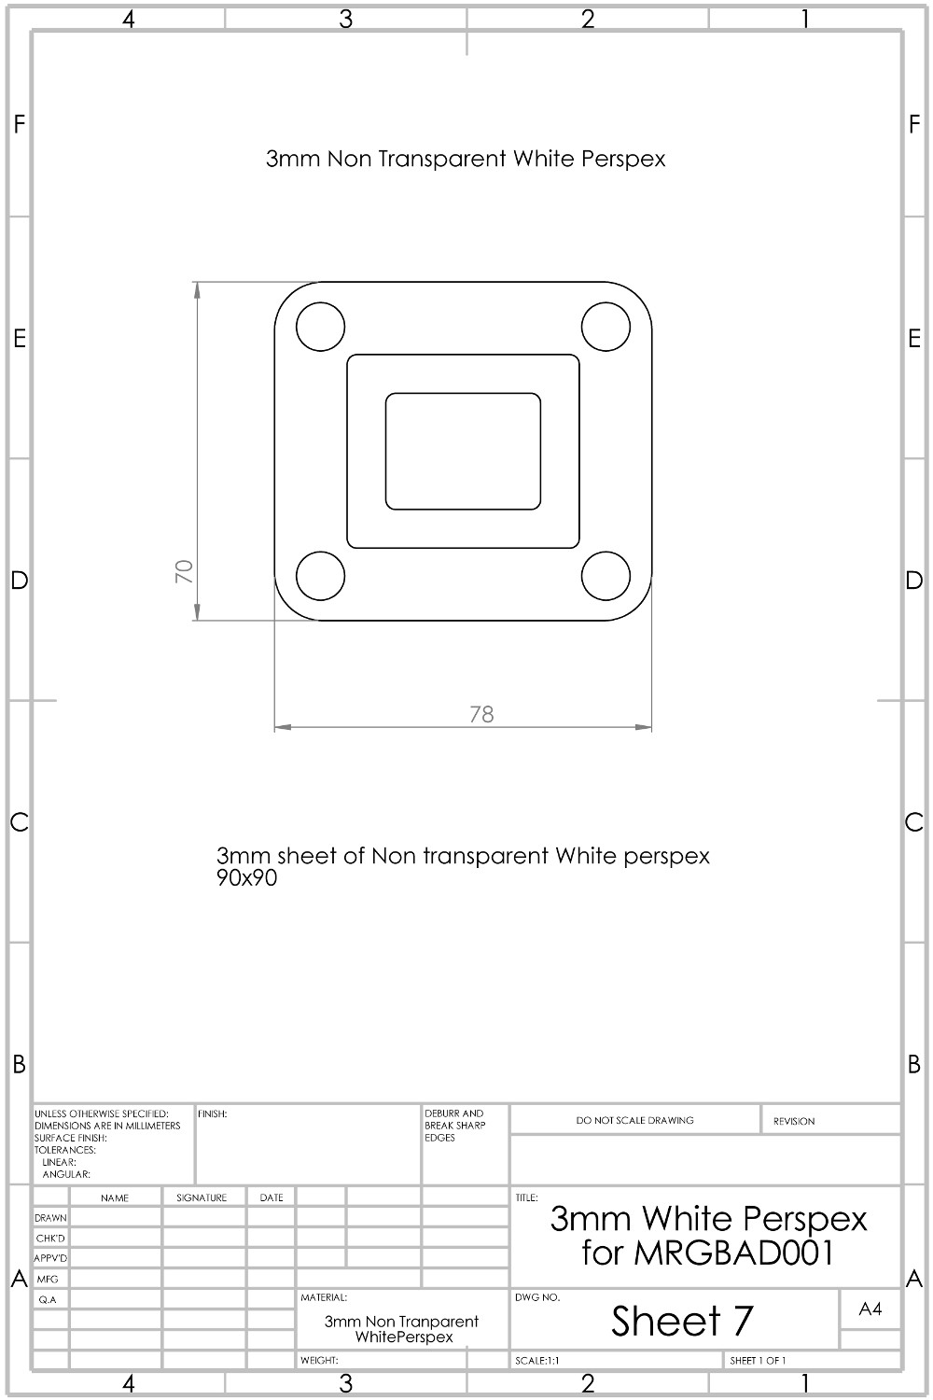
Document/Pictures/sheet7v2.JPG
