BadenMorgan/thesis/Document/Pictures/shelfinal.jpg

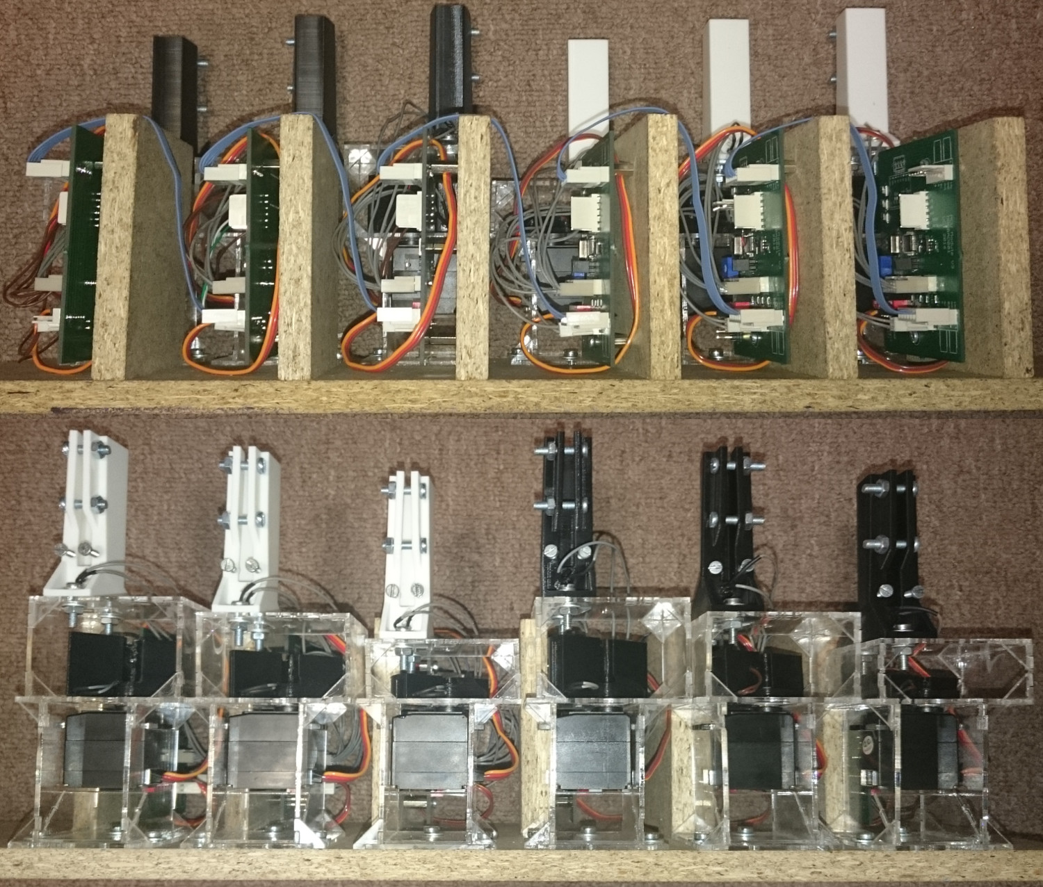
Document/Pictures/shelfinal.jpg
