BadenMorgan/thesis/Document/Pictures/Signatureform.jpg

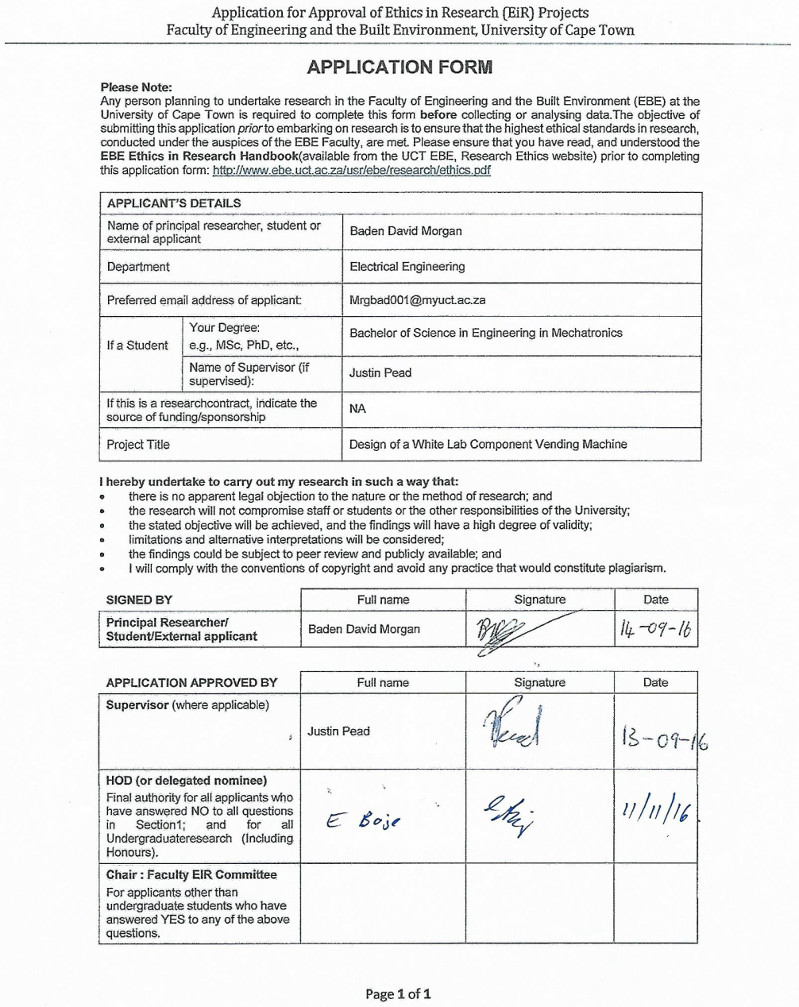
Document/Pictures/Signatureform.jpg
