BadenMorgan/thesis/Document/Pictures/statemachinemaster.jpg

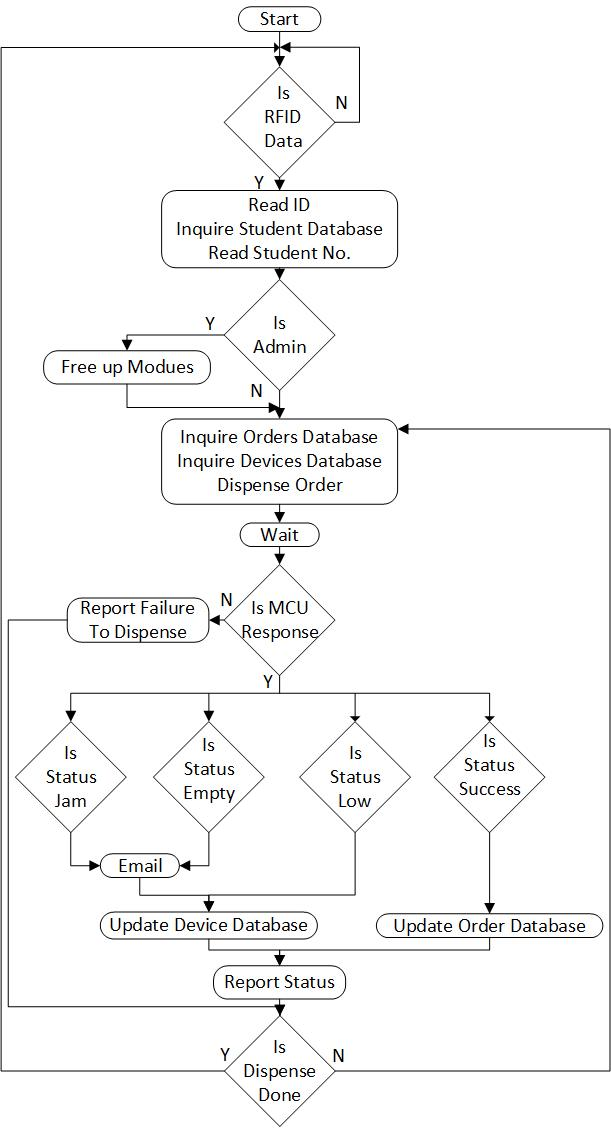
Document/Pictures/statemachinemaster.jpg
