BadenMorgan/thesis/Document/Pictures/structv1.jpg

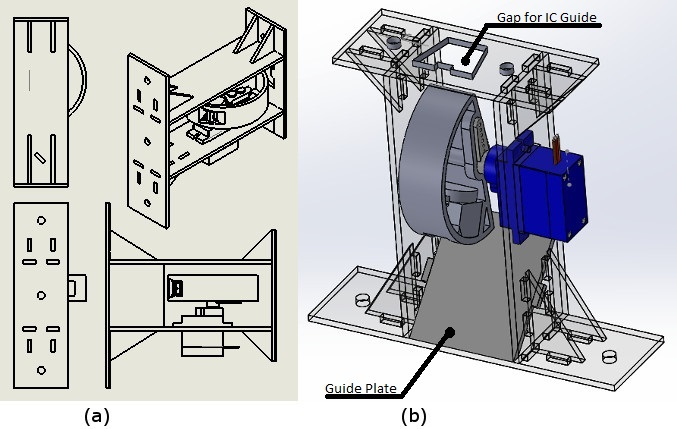
Document/Pictures/structv1.jpg
