BadenMorgan/thesis/Document/Pictures/SystemOverview.jpg

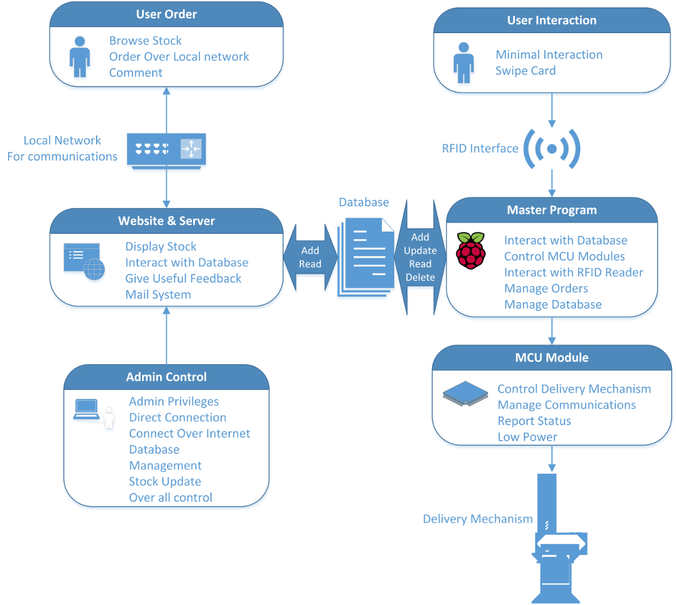
Document/Pictures/SystemOverview.jpg
