BadenMorgan/thesis/Document/Pictures/v1.jpg

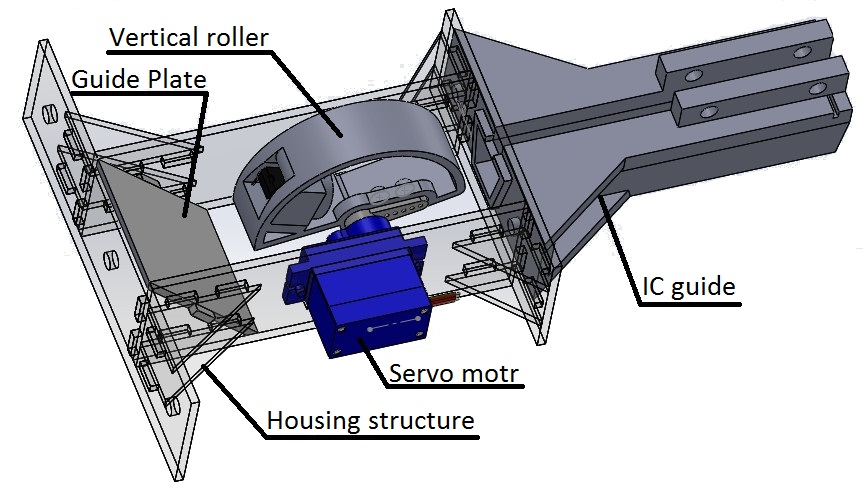
Document/Pictures/v1.jpg
