BadenMorgan/thesis/Document/Pictures/verttv1real.JPG

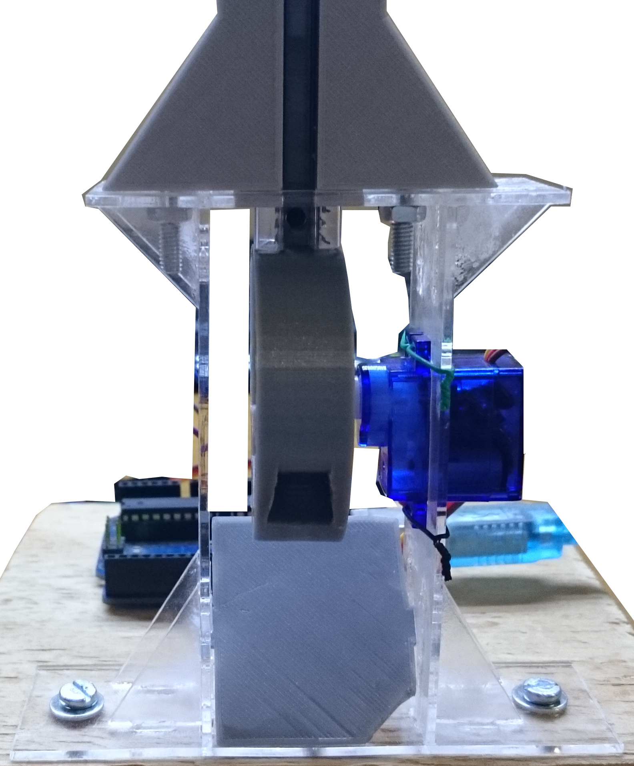
Document/Pictures/verttv1real.JPG
