BadenMorgan/thesis/Document/Pictures/VertV1.jpg

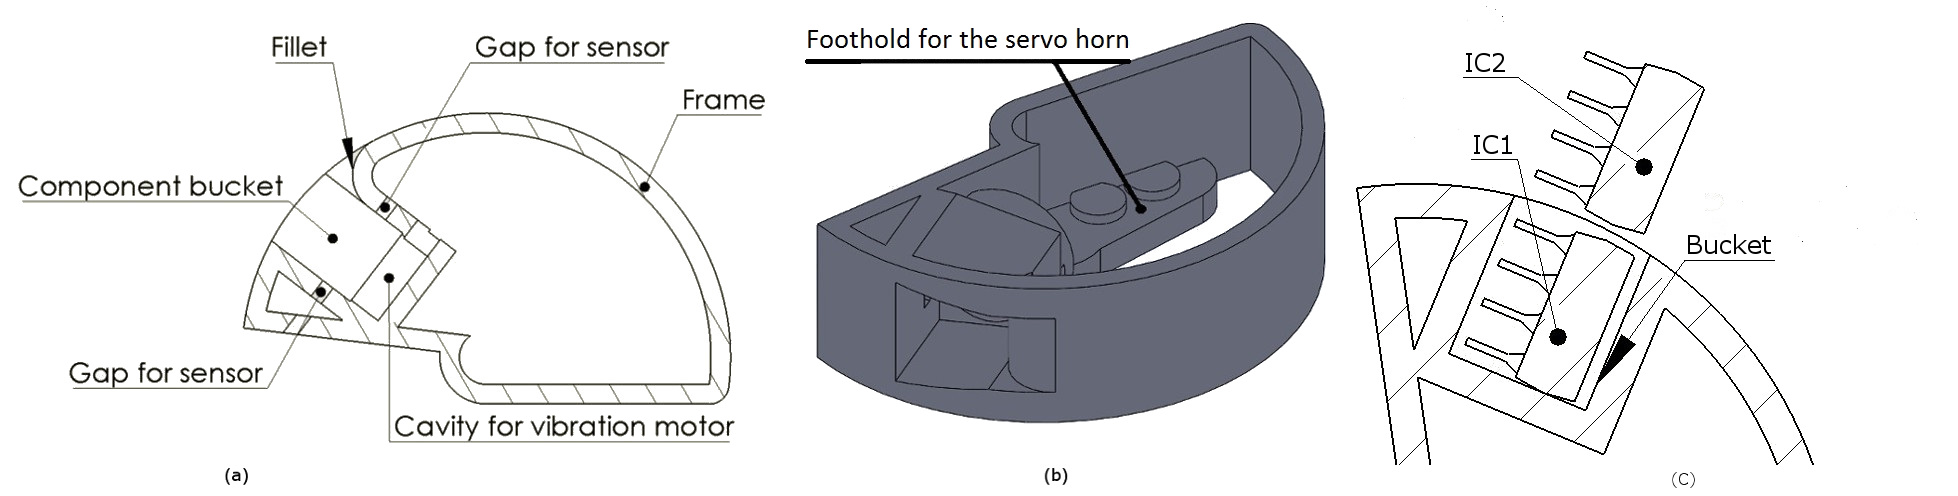
Document/Pictures/VertV1.jpg
