BadenMorgan/thesis/Document/Pictures/vertv2.JPG

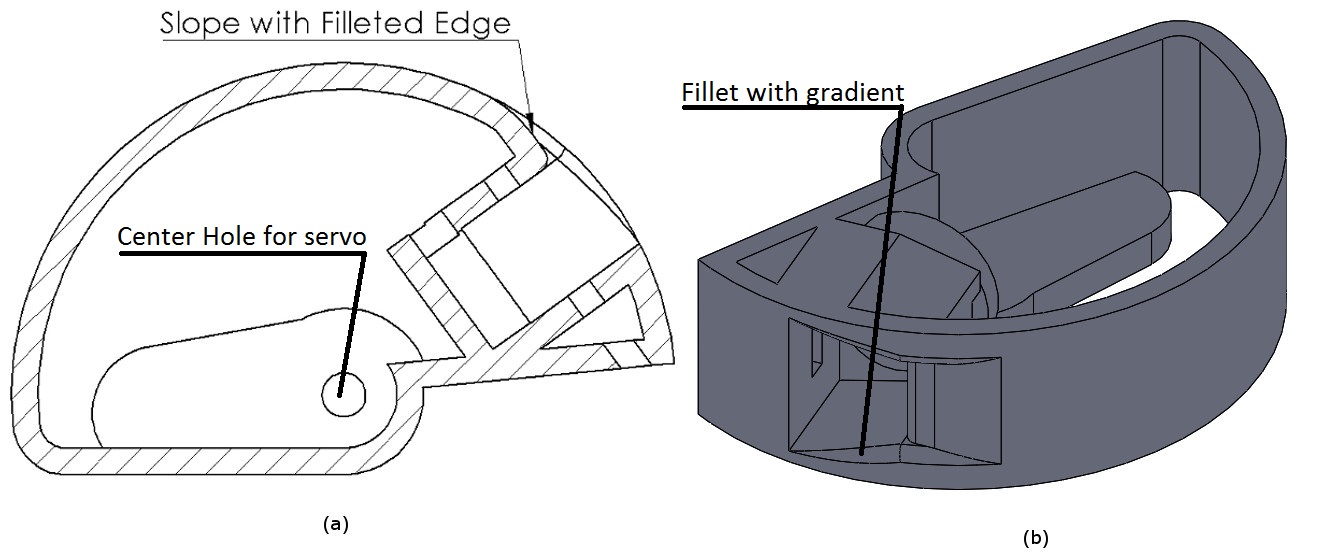
Document/Pictures/vertv2.JPG
