BadenMorgan/thesis/Document/Pictures/VMDEF.jpg

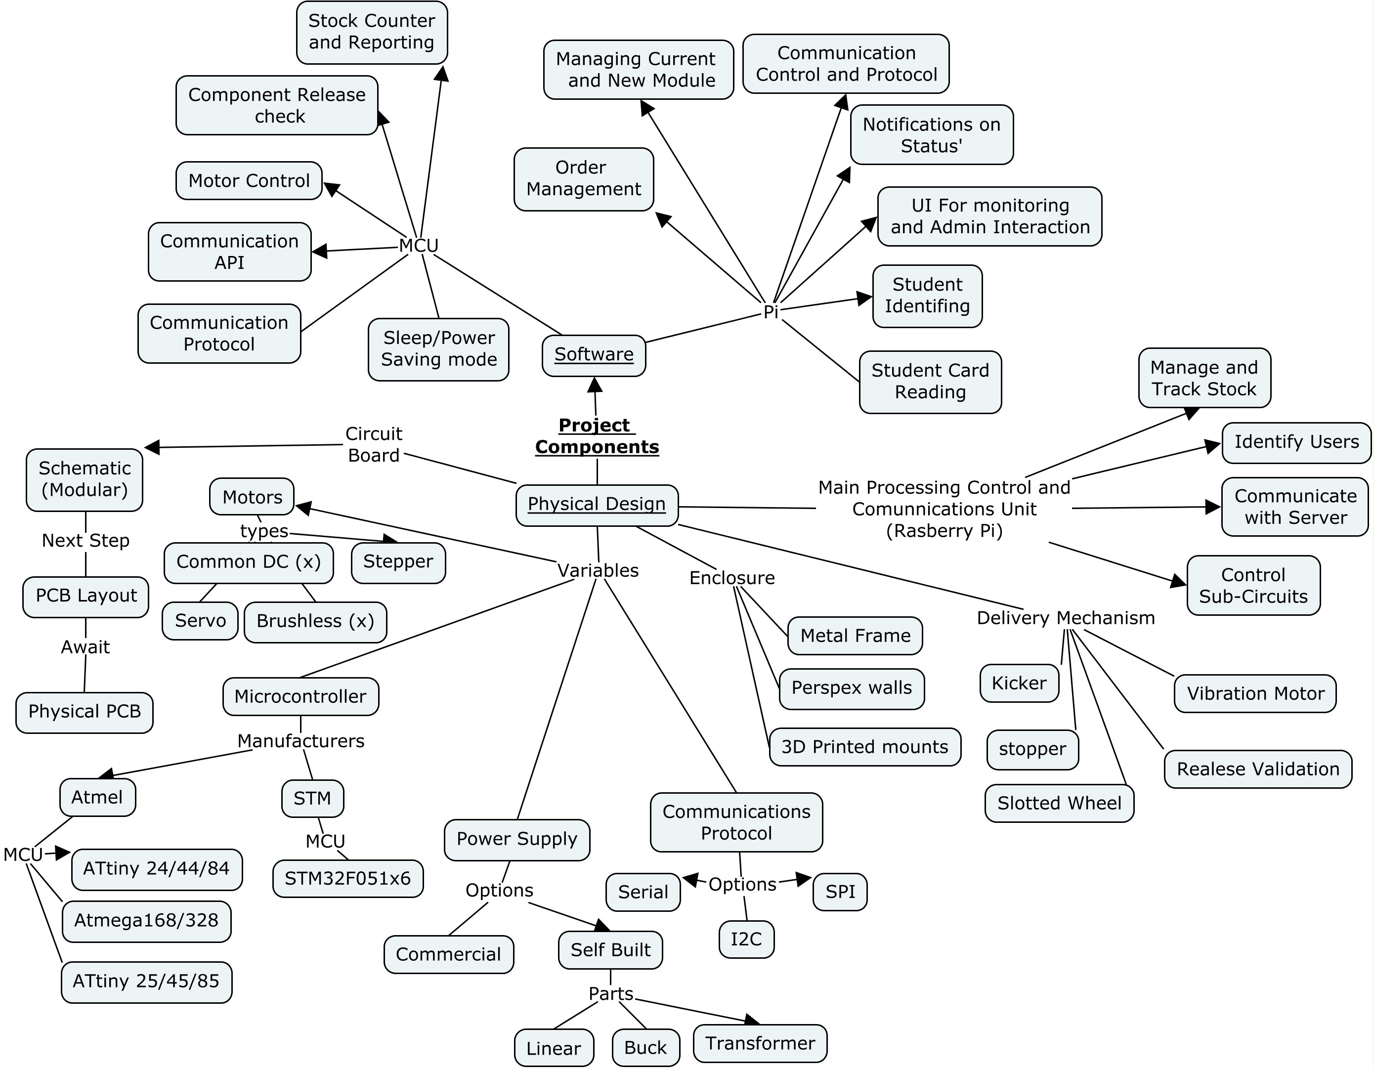
Document/Pictures/VMDEF.jpg
