BadenMorgan/thesis/Document/Pictures/webcontact.jpg

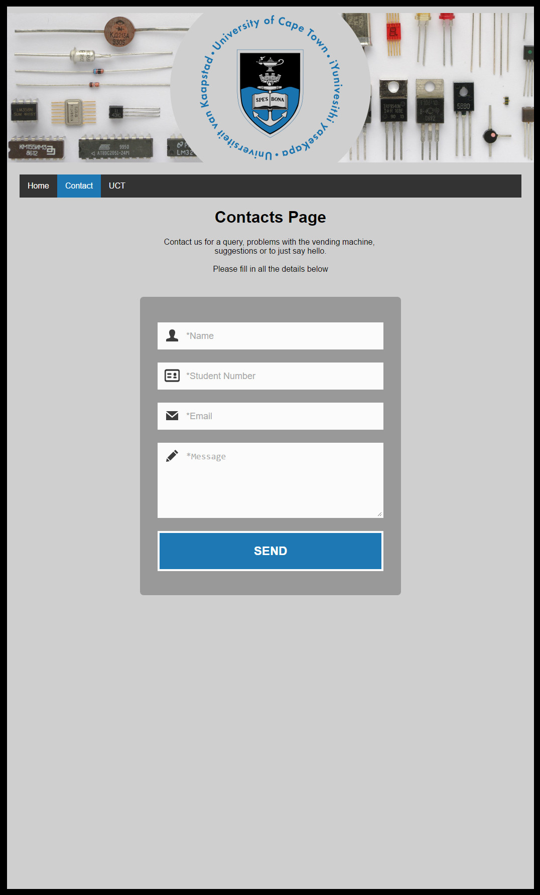
Document/Pictures/webcontact.jpg
