BadenMorgan/thesis/Document/Pictures/webcontactv2.jpg

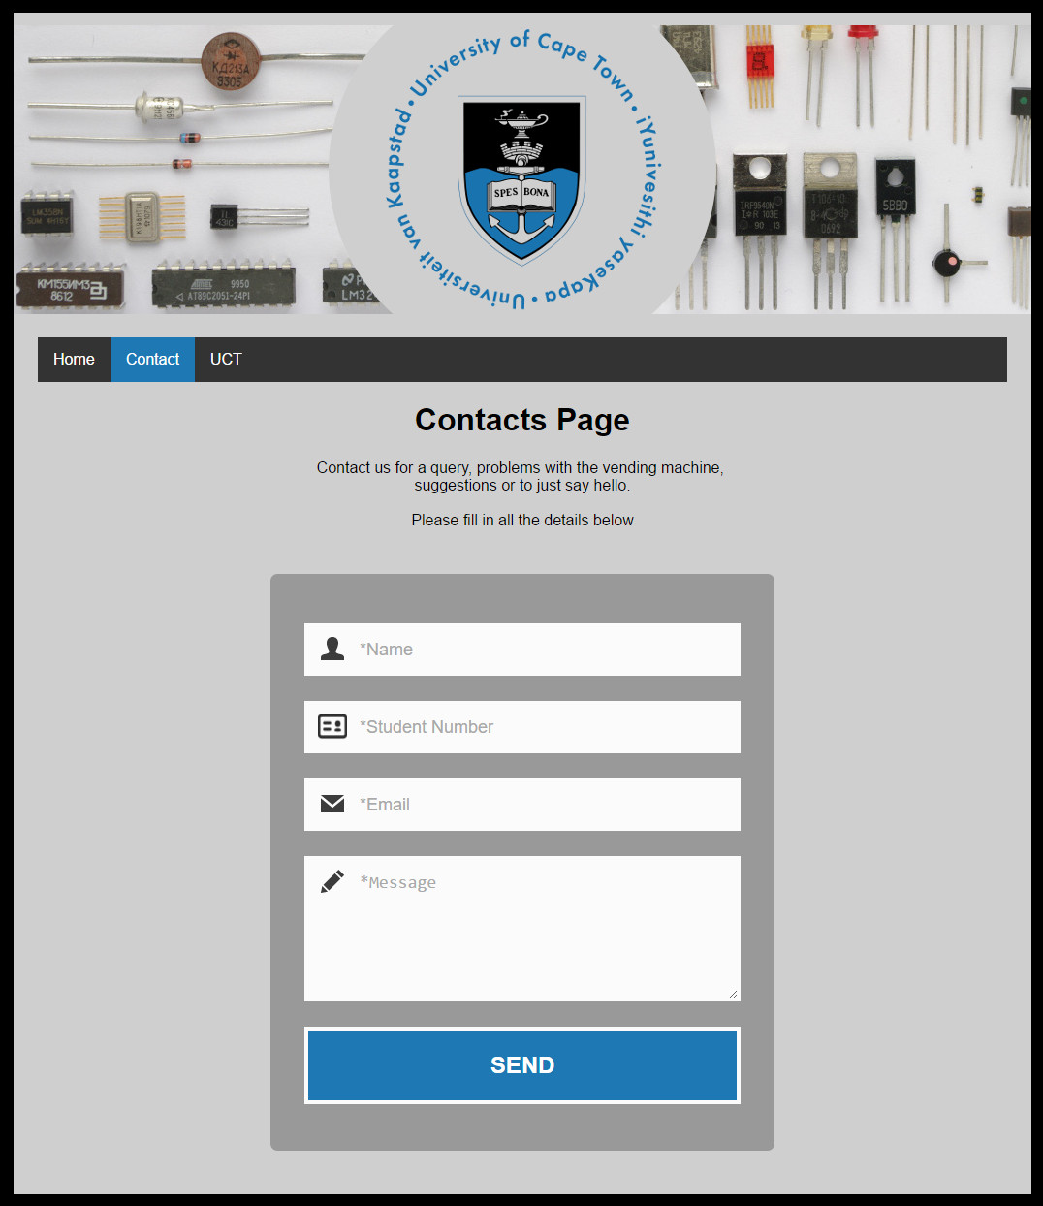
Document/Pictures/webcontactv2.jpg
