BadenMorgan/thesis/Document/Pictures/weborders.jpg

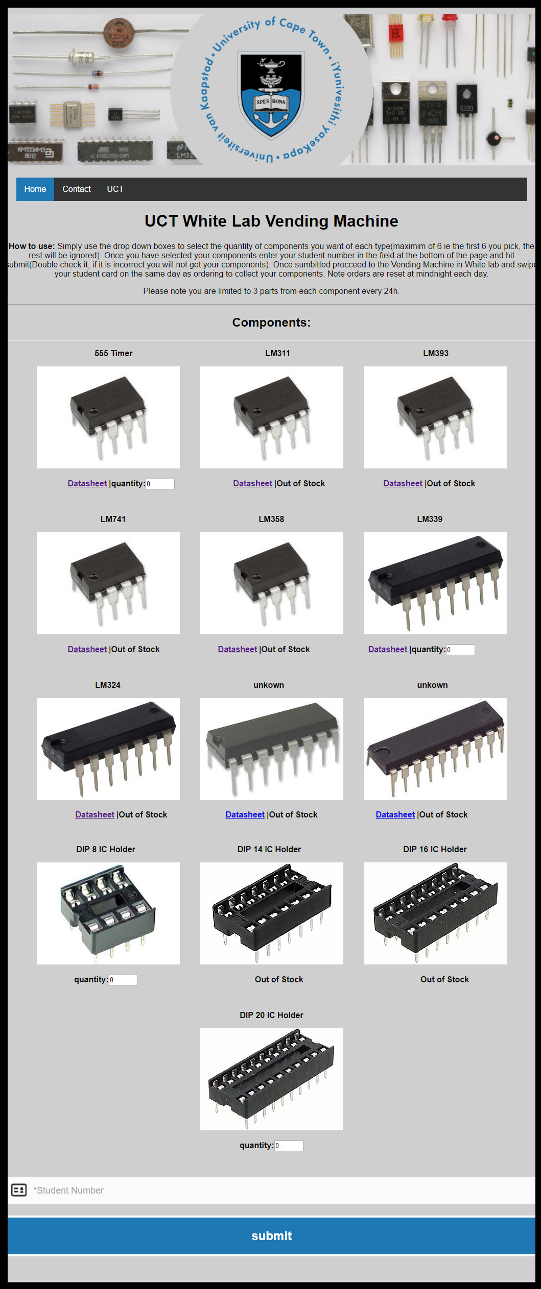
Document/Pictures/weborders.jpg
