BadenMorgan/thesis/Document/Pictures/webordersdown.jpg

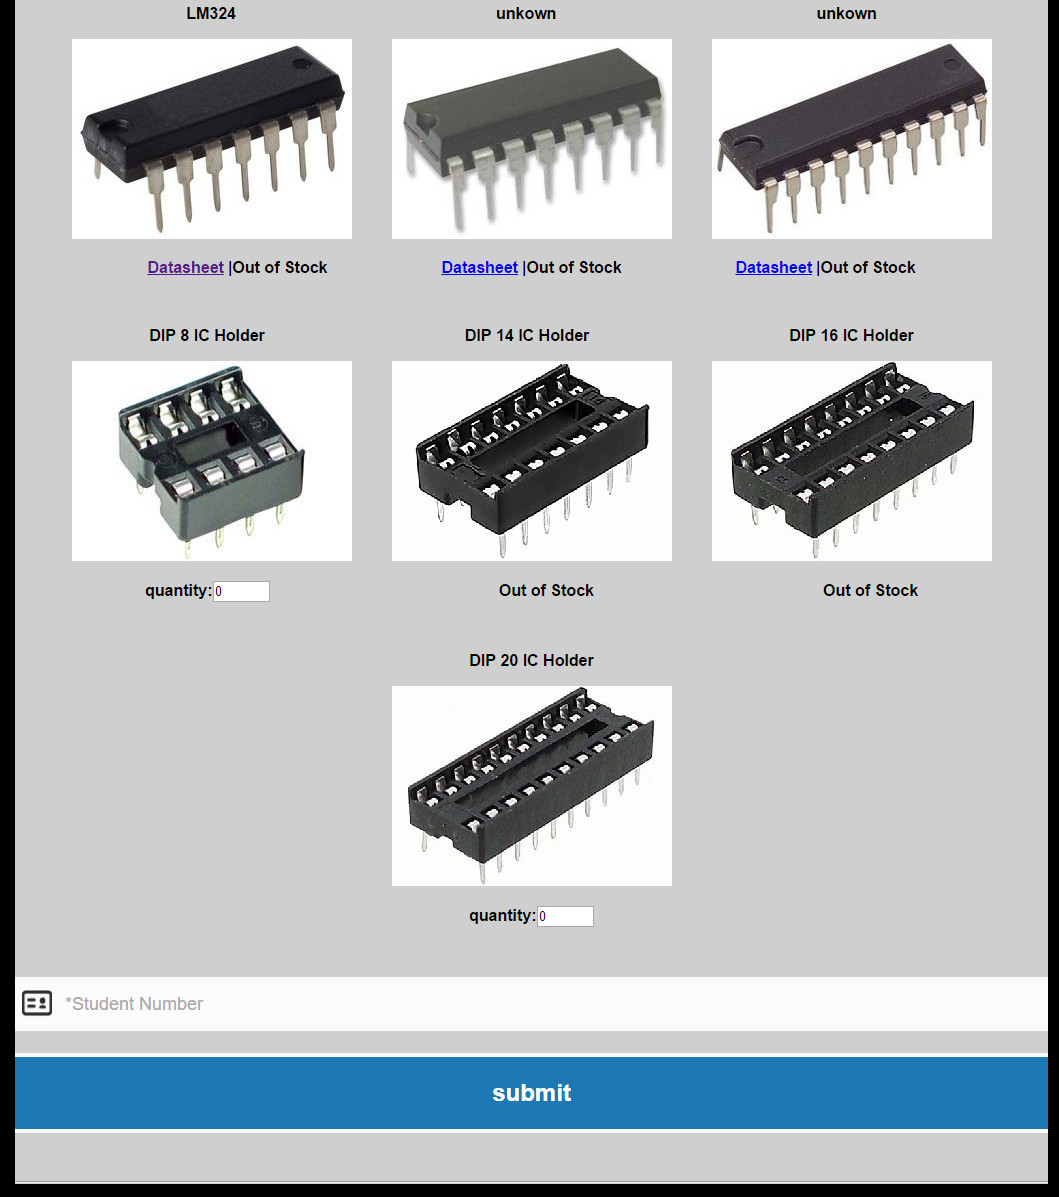
Document/Pictures/webordersdown.jpg
