BadenMorgan/thesis/Document/Pictures/webordersup.jpg

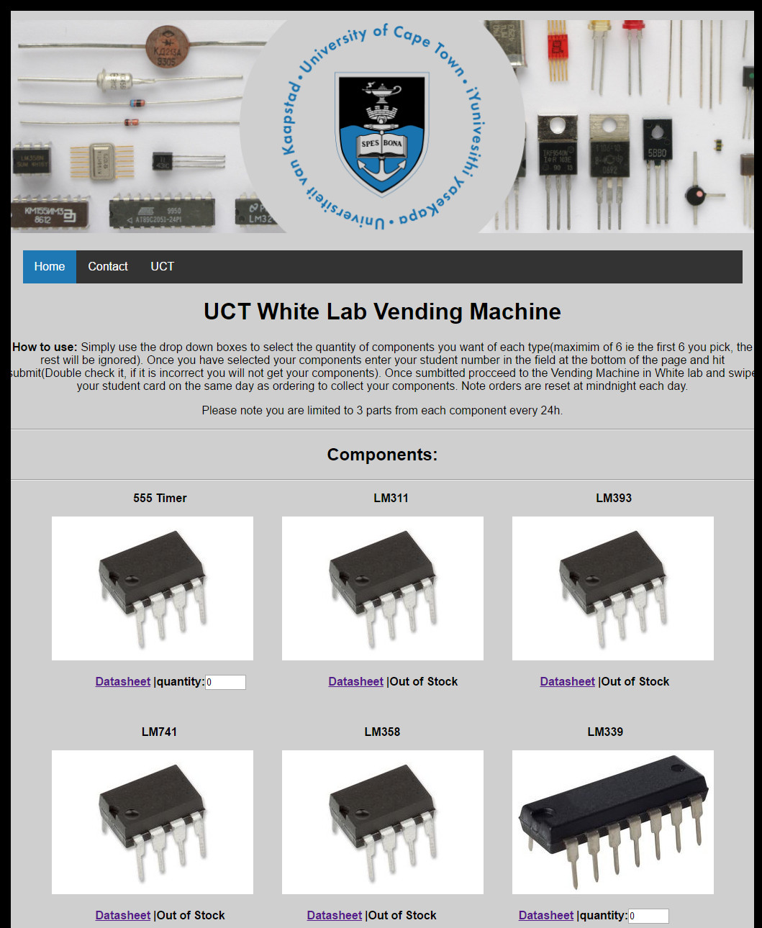
Document/Pictures/webordersup.jpg
