BadenMorgan/thesis/Document/Pictures/webordersv2 (1).jpg

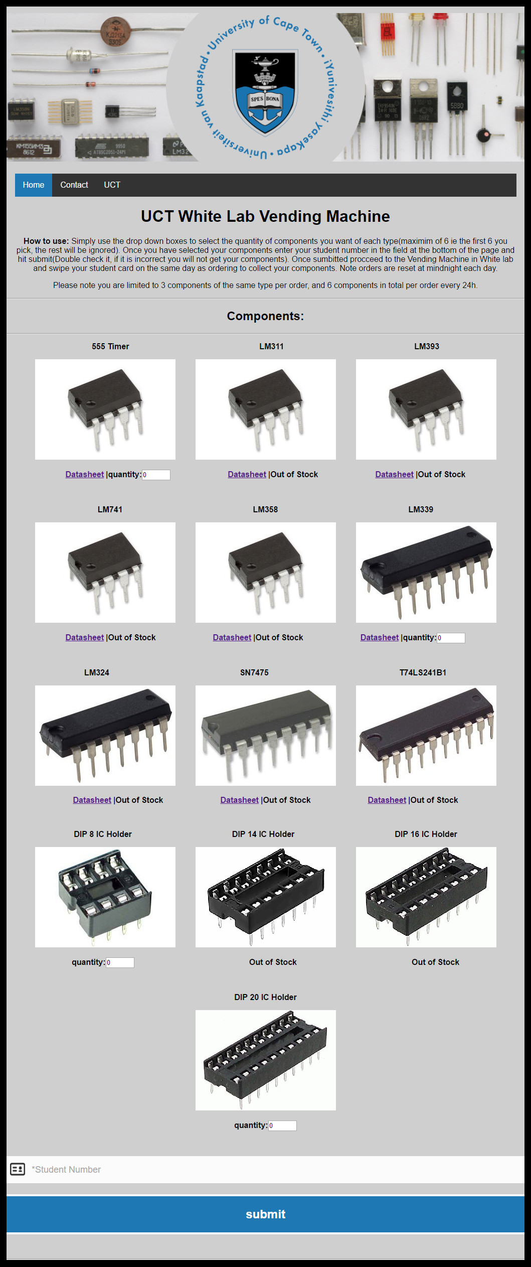
Document/Pictures/webordersv2 (1).jpg
