BadenMorgan/thesis/Solidworks/Feed Up/feed up comparison.JPG

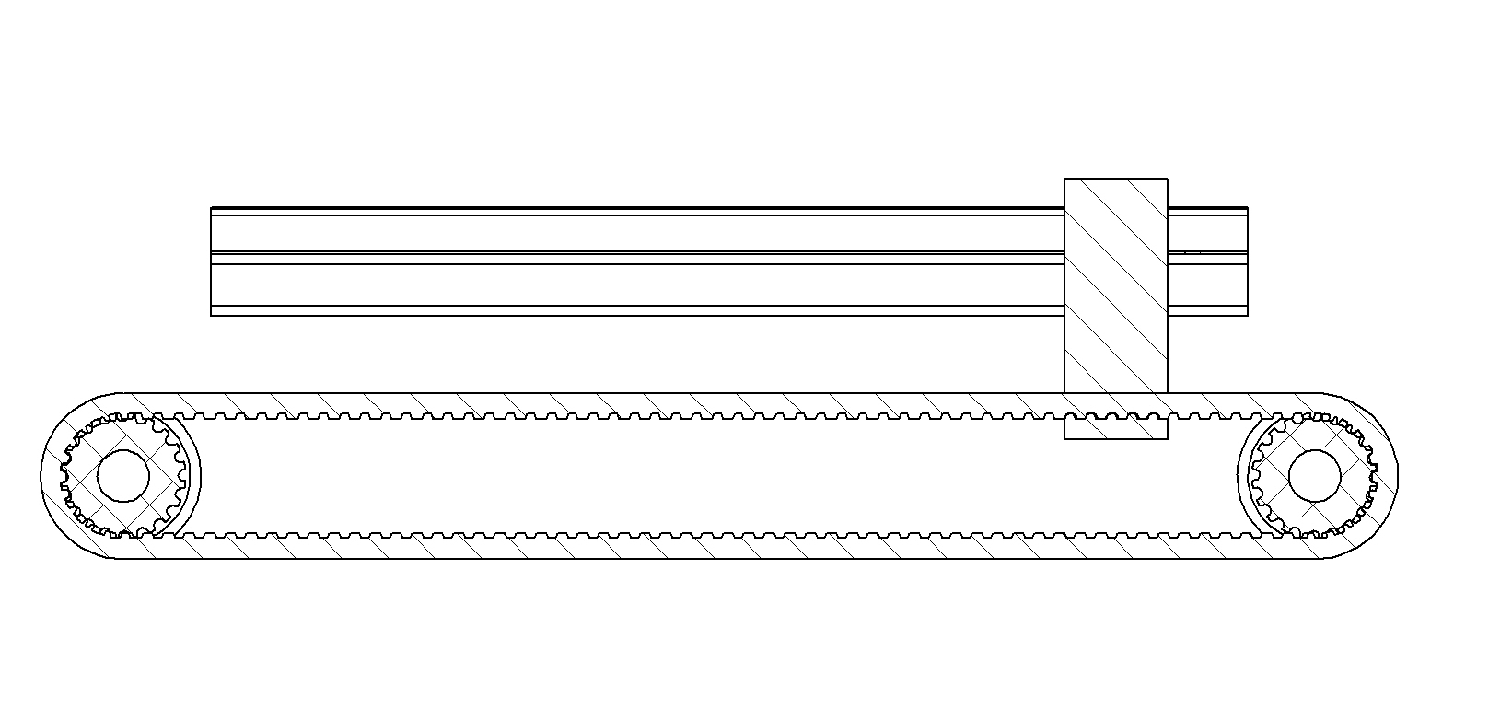
Solidworks/Feed Up/feed up comparison.JPG
