BadenMorgan/thesis/Solidworks/part models/dip 14/altium_3d.jpg

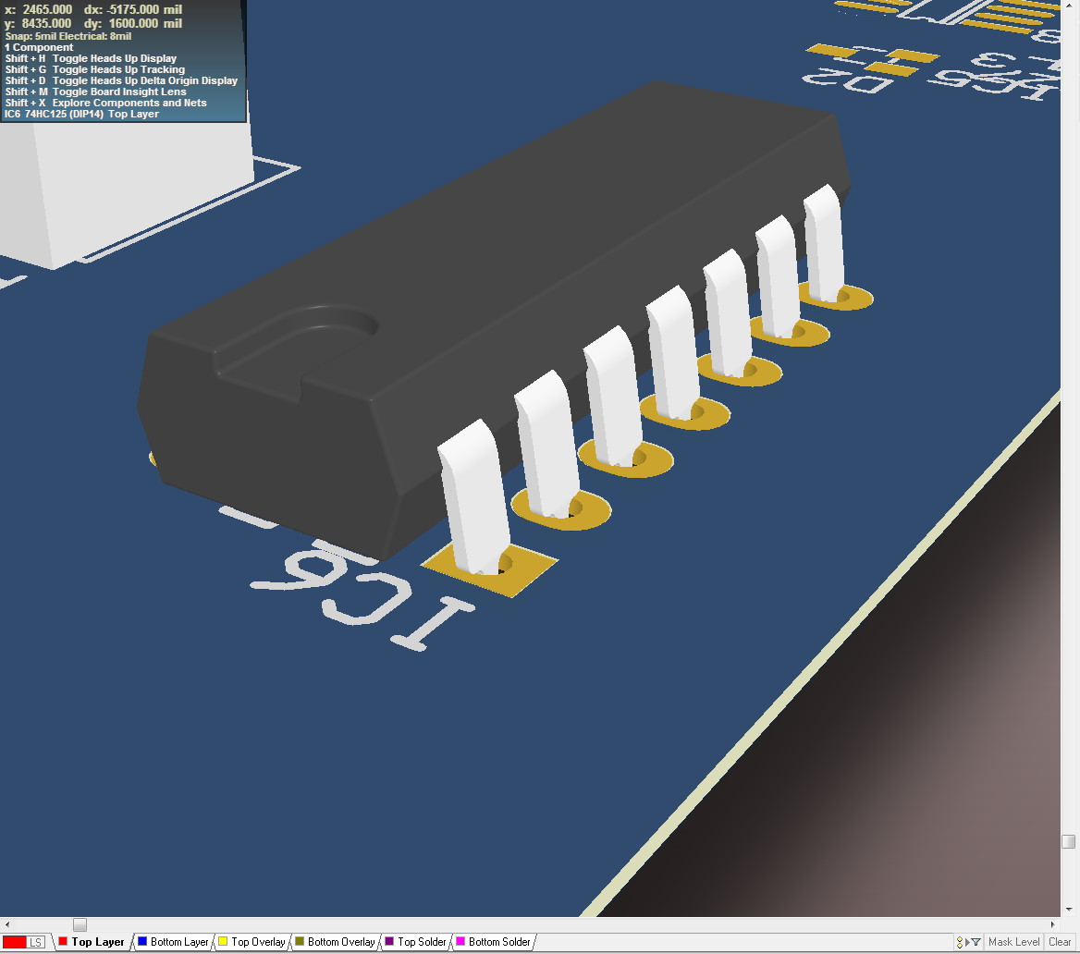
Solidworks/part models/dip 14/altium_3d.jpg
