BadenMorgan/thesis/Solidworks/part models/dip 14/dil14.jpg

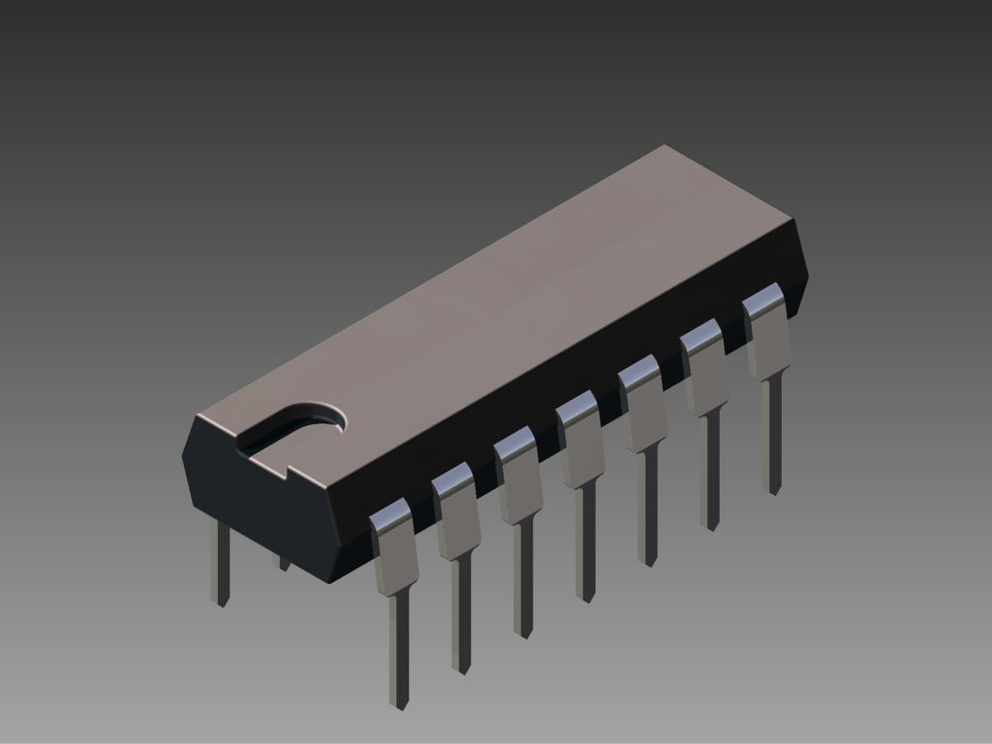
Solidworks/part models/dip 14/dil14.jpg
