BadenMorgan/thesis/Solidworks/part models/dip 14/Renderings/untitled.71.jpg

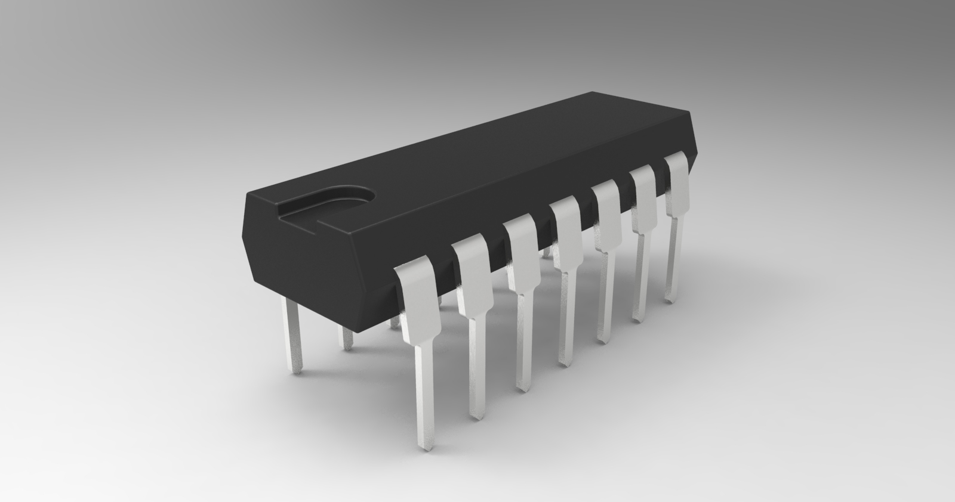
Solidworks/part models/dip 14/Renderings/untitled.71.jpg
