BadenMorgan/thesis/Solidworks/part models/dip 14/Renderings/untitled.72.jpg

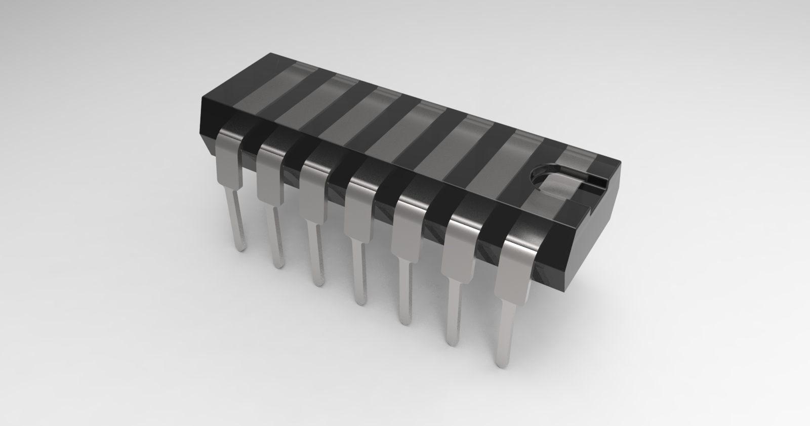
Solidworks/part models/dip 14/Renderings/untitled.72.jpg
