BadenMorgan/thesis/Solidworks/part models/dip 14/Renderings/untitled.74.jpg

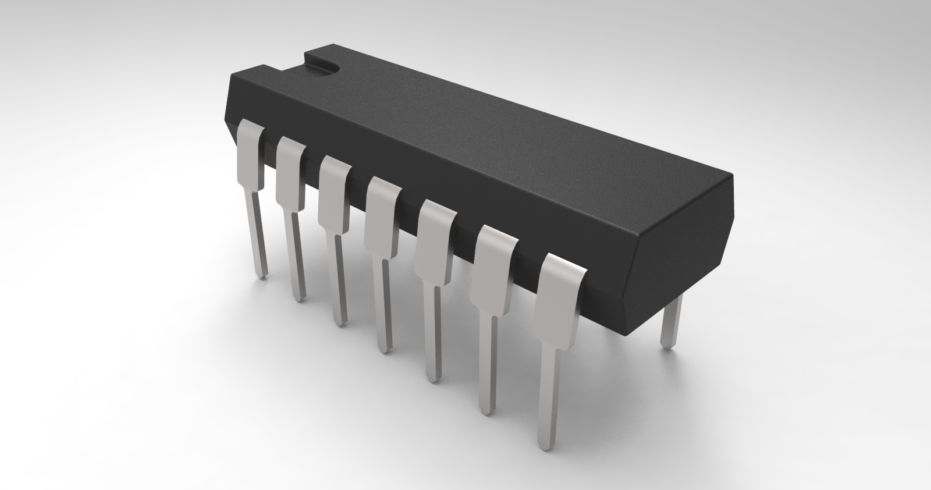
Solidworks/part models/dip 14/Renderings/untitled.74.jpg
