BadenMorgan/thesis/Solidworks/part models/pulley-gt2-20-teeth-5mm-bore-1.snapshot.8/gt2.JPG

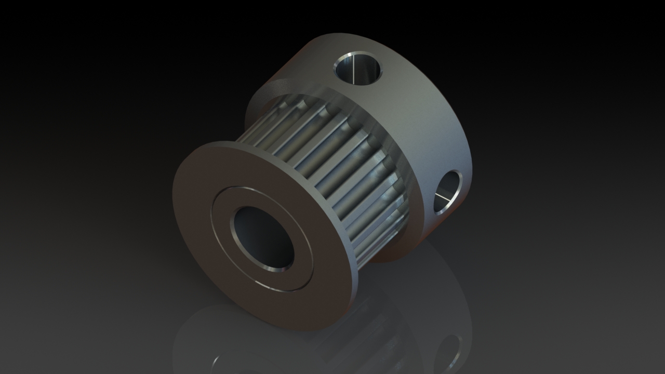
Solidworks/part models/pulley-gt2-20-teeth-5mm-bore-1.snapshot.8/gt2.JPG
