BadenMorgan/thesis/Solidworks/part models/servo-hitec-hs-225-mg-1.snapshot.3/Servo Hitec HS-225MG.JPG

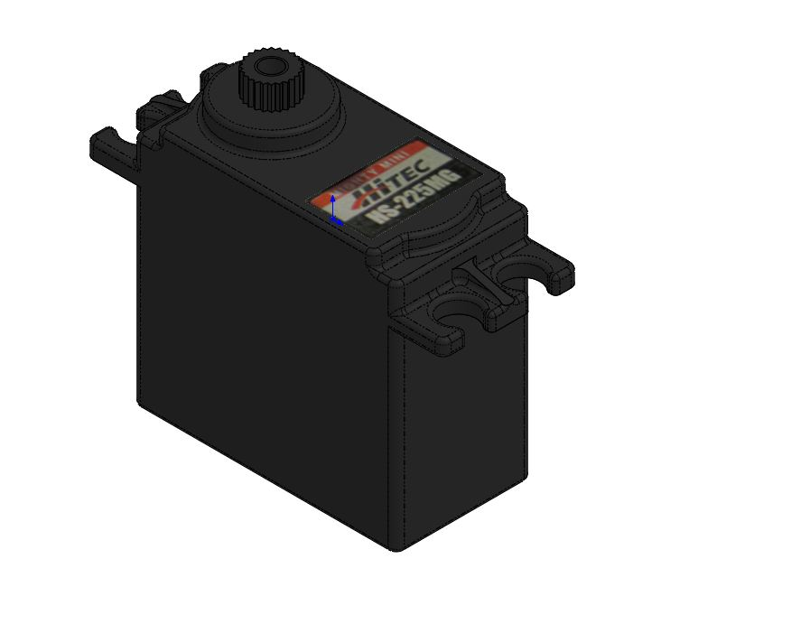
Solidworks/part models/servo-hitec-hs-225-mg-1.snapshot.3/Servo Hitec HS-225MG.JPG
