BadenMorgan/thesis/Solidworks/part models/timing-belt--1.snapshot.3/Renderings/Timing belt1.JPG

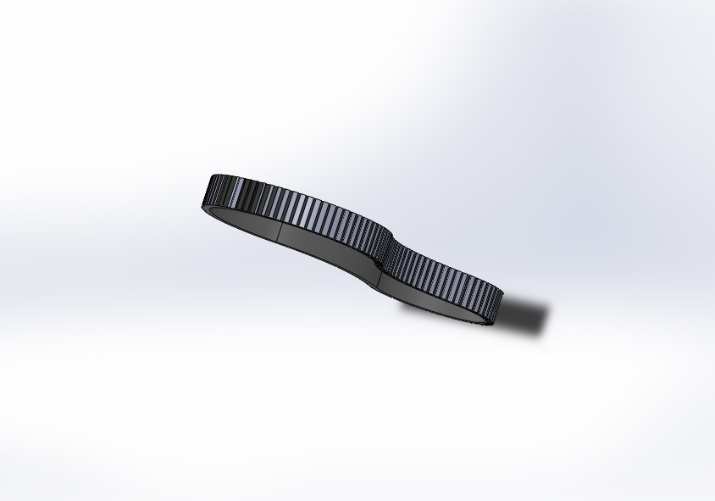
Solidworks/part models/timing-belt--1.snapshot.3/Renderings/Timing belt1.JPG
