BadenMorgan/thesis/Solidworks/part models/timing-belt--1.snapshot.3/Renderings/Timing Belt.jpg

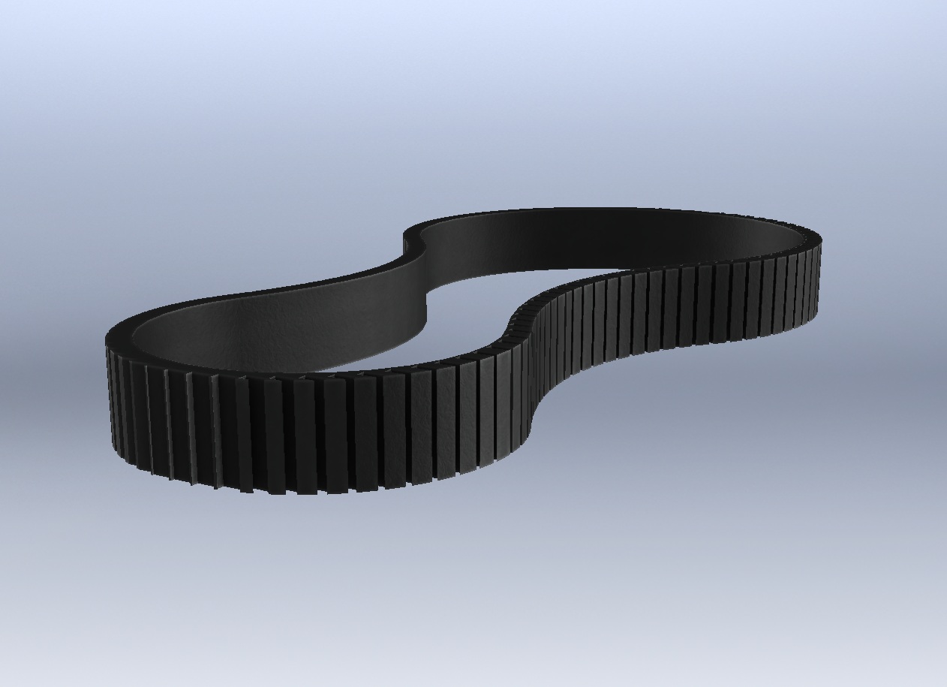
Solidworks/part models/timing-belt--1.snapshot.3/Renderings/Timing Belt.jpg
