BadenMorgan/thesis/Solidworks/part models/turnigy-tgy-225mg-servo-1.snapshot.4/s.JPG

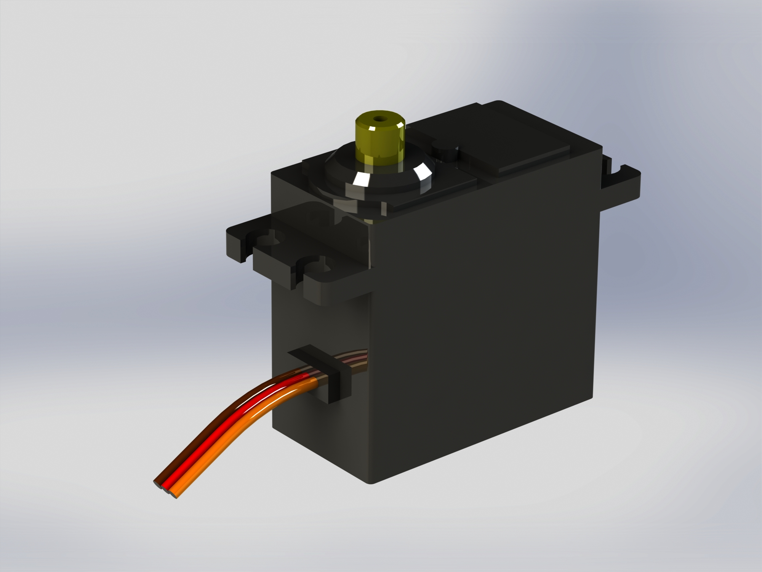
Solidworks/part models/turnigy-tgy-225mg-servo-1.snapshot.4/s.JPG
