BadenMorgan/thesis/Website/website pictures/dip 8 IC.jpg

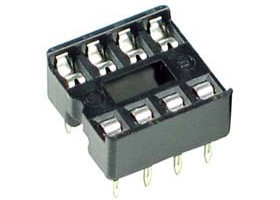
Website/website pictures/dip 8 IC.jpg
