BadenMorgan/thesis/Website/website pictures/dip 8.jpg

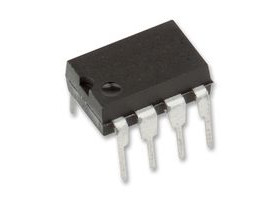
Website/website pictures/dip 8.jpg
