BadenMorgan/thesis/Website/website pictures/dip 14 IC.jpg

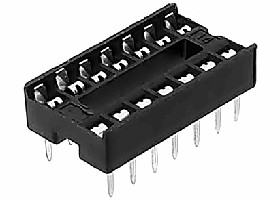
Website/website pictures/dip 14 IC.jpg
