BadenMorgan/thesis/Website/website pictures/dip 14.jpg

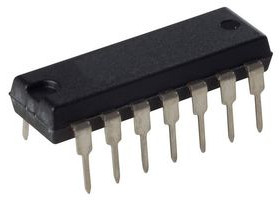
Website/website pictures/dip 14.jpg
