BadenMorgan/thesis/Website/website pictures/dip 16 IC.jpg

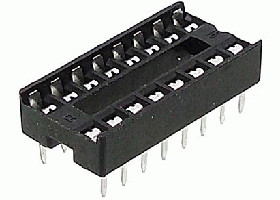
Website/website pictures/dip 16 IC.jpg
