BadenMorgan/thesis/Website/website pictures/dip 16.jpg

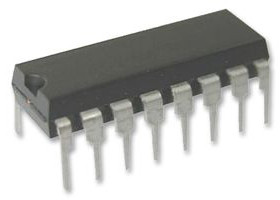
Website/website pictures/dip 16.jpg
