BadenMorgan/thesis/Website/website pictures/dip 20 IC.jpg

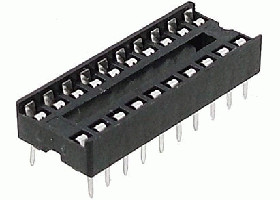
Website/website pictures/dip 20 IC.jpg
