BadenMorgan/thesis/Website/website pictures/dip 20.jpg

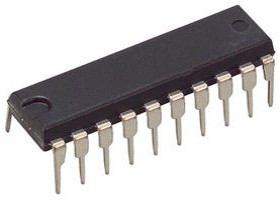
Website/website pictures/dip 20.jpg
