BadenMorgan/thesis/Website/website pictures/to220.jpg

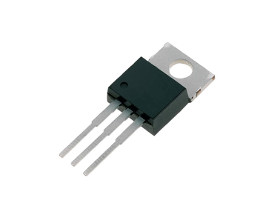
Website/website pictures/to220.jpg
