BadenMorgan/thesis/Website/website pictures/vcard.png

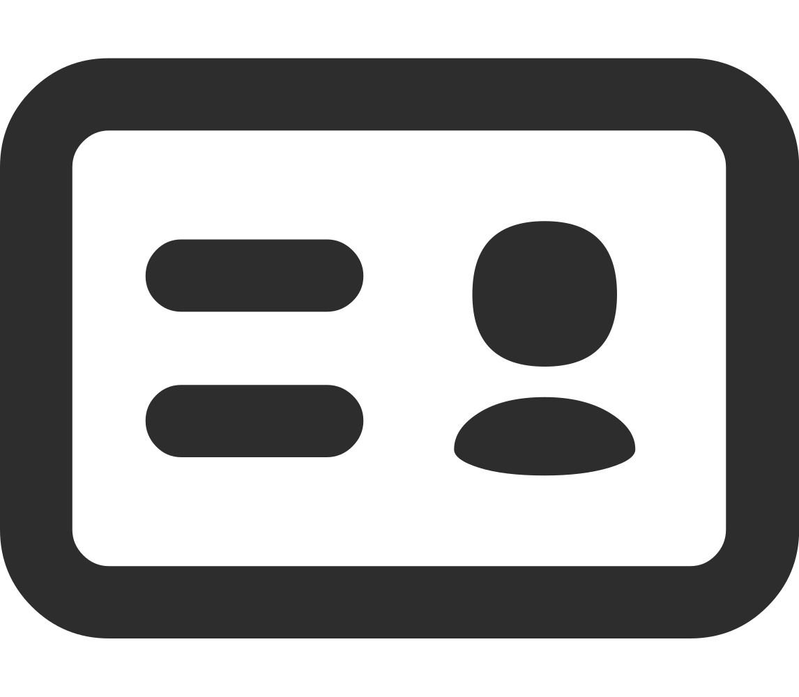
Website/website pictures/vcard.png
