BadenMorgan/thesis/Circuit/Part List.xlsx

Sheet: Packages
component | description | package | Unique Packages | height
555 timer |  | DIP8 | DIP8 | 9.6 | 10.66 | 10.16 | 10.82 | 9.07 | 10.062
lm311 | Comparator | DIP8 | DIP14 | 20 | 19.5 | 20.19 | 19.56 | 20.32 | 19.914
lm393 | Dual Voltage Comparator | DIP8 | DIP16 | 19.55 | 20.32 | 19.5 | 21.97 | 19.81 | 20.23
lm339 | Quad differential Comparator | DIP14 | DIP20 | 25.73 | 26.42 | 27.17 | 25.4 | 24.5 | 25.844
lm741 | General Purpose Operational Amplifier | DIP8 | TO92
lm358 |  | DIP 8 | SOD27/DO-35
lm324 | QUAD OP AMP | DIP14 | TO-220
lm328 | OPAMP | DIP8 | TO92/TO-220
 | in 8,14,16,20 pin packages | DIP16 | specific
 | to accomedate | DIP20 | 3mm, 5mm round
PN2222 | NPN Transistor | TO92
PN2907 | PNP Transistor | TO92
1N4148 | High Speed Diode | SOD27/DO-35
78L05 | 5V Linear Regulator | TO92
L7805 | 5V Linear Regulator | TO-220
MCP1702 | 5V Linear Regulator | TO92
LM317 | Adjustable linear voltage regulator | TO92/TO-220
LDR | Light Dependant Resistor | specific
LED | Light Emitting Diode | 3mm, 5mm round
1K POT |  | Specific
10K POT |  | specific
10nF |  | specific
100nF |  | specific
push buttons |  | specific
CD4011 | CMOS Quad Nand Gate | DIP14
CD4096 | 6xInverter Circuit | DIP14
CD4081 | CMOD Quad And Gate | DIP14

Sheet: MCU BOM
 | Compoenent List |  |  |  |  | minimum order |  |  |  |  |  | *schange at : | 13.31 | rands to the dollar
 | Comonent | Quantity | Description | Package | rs-online link | poack of* | cost [R] | unit price | total | digikey link | pack of | cost [$] | cost [R]* | unit price | total | Other | link | pack of | cost [$] | cost [R]* | unit price | total
1 | STM32F051C6 | 1 | 32bit MCU | LQFP48 | http://za.rs-online.com/web/p/microcontrollers/7618633/?searchTerm=stm32f051c6t | 0 | na |  |  | http://www.digikey.com/product-detail/en/stmicroelectronics/STM32F051C6T6/497-12948-ND/3193383 | 1 | 2.71 | 36.0701 | 36.0701
1 | SN75176B | 1 | Differential Bus Transceivers | 8-SOIC | http://za.rs-online.com/web/p/line-transceivers/5172346/ | 10 | 89.66 | 8.966 |  | http://www.digikey.com/product-detail/en/texas-instruments/SN75176BDR/296-1275-1-ND/404925 | 1 | 0.77 | 10.2487 | 10.2487
1 | 8MHZ crystal | 1 |  | HC49 SMD (US) | http://za.rs-online.com/web/p/crystal-units/8149507/ | 10 | 29.82 | 2.982 |  | http://www.digikey.com/product-detail/en/abracon-llc/ABLS-8.000MHZ-B4-T/535-10212-1-ND/2184247 | 1 | 0.27 | 3.5937 | 3.5937
1 | 10pF cap | 2 | chip capacitor | 805
1 | 1M ohm Res | 1 | chip resistor | 805 | http://za.rs-online.com/web/p/surface-mount-fixed-resistors/2230821/ | 50 | 6.55 | 0.131 |  | http://www.digikey.com/product-detail/en/yageo/RC0805FR-071ML/311-1.00MCRCT-ND/730392 | 1 | 0.1 | 1.331 | 1.331
1 | LL4148 | 2 | Gen Purpose Diode or equivalent | SOD80 | http://za.rs-online.com/web/p/rectifier-schottky-diodes/6708823/ | 25 | 10.475 | 0.419 |  | http://www.digikey.com/product-detail/en/fairchild-semiconductor/LL4148/LL4148FSCT-ND/1923118 | 1 | 0.1 | 1.331 | 1.331
1 | bc817 | 2 | NPN or similar 200mA+ | SOT23 |  |  |  | #DIV/0! |  | http://www.digikey.com/product-detail/en/nxp-semiconductors/BC817-40,215/568-1631-1-ND/763458 | 1 | 0.14 | 1.8634 | 1.8634
1 | DIP SWITCH | 1 | 8 way switch | DIP |  |  |  | #DIV/0! |  | http://www.digikey.com/product-detail/en/cts-electrocomponents/206-8/CT2068-ND/20760 | 1 | 0.91 | 12.1121 | 12.1121
4 | 120 oh mres | 6 | chip resistor | 805 |  |  |  | #DIV/0! |  |  |  |  | 0 | #DIV/0!
2 | 150 oh mres | 2 | chip resistor | 805 |  |  |  | #DIV/0! |  |  |  |  | 0 | #DIV/0!
1 | red LED | 1 |  | 1206 |  |  |  | #DIV/0! |  |  |  |  | 0 | #DIV/0!
1 | green LED | 1 |  | 1206 |  |  |  | #DIV/0! |  |  |  |  | 0 | #DIV/0!
1 | yellow LED | 1 |  | 1206 |  |  |  | #DIV/0! |  |  |  |  | 0 | #DIV/0!
1 | 3k6 ohm res | 1 | chip resistor | 805 |  |  |  | #DIV/0! |  |  |  |  | 0 | #DIV/0!
3 | 2k ohm res | 3 | chip resistor | 805 |  |  |  | #DIV/0! |  |  |  |  | 0 | #DIV/0!
3 | 1k ohm res | 3 | chip resistor | 805 |  |  |  | #DIV/0! |  |  |  |  |  | #DIV/0!
3 | 10k ohm res | 2 | chip resistor | 805 |  |  |  | #DIV/0! |  |  |  |  |  | #DIV/0!
1 | 3 way header | 1 | standard header pins | 2.54 pitch |  |  |  | #DIV/0! |  |  |  |  |  | #DIV/0!
2 | 4 way one way header | 3 | friction lock one way header | 2.54 pitch |  |  |  | #DIV/0! |  |  |  |  |  | #DIV/0!
2 | 6 way one way header | 1 | friction lock one way header | 2.54 pitch 90 degrees |  |  |  | #DIV/0! |  |  |  |  |  | #DIV/0!
1 | 6 way one way header | 2 | friction lock one way header | 2.54 pitch |  |  |  | #DIV/0! |  |  |  |  |  | #DIV/0!
0 | 8 way socket | 2 | normal female socket | 2.54 pitch |  |  |  | #DIV/0! |  |  |  |  |  | #DIV/0!
2 | 2 way header | 2 | normal male header | 2.54 pitch |  |  |  | #DIV/0! |  |  |  |  |  | #DIV/0!
1 | 5k potentiometer | 1 | standar 5k potentiometer |  |  |  |  | #DIV/0! |  |  |  |  |  | #DIV/0!
3 | m3 spacers | 3 |  | M3
3 | m3 bolts | 3 |  | M3
2 | 75 ohm | 2
spacial components
for programming | mylar cable 6 core | 1 | swisted shielded cable 0.2mm | Cable |  |  |  |  |  |  |  |  |  |  |  | mantech |  | per metre |  | 8.64 | 8.64
 | A4988 Braekout board | 1 | 2A stepper motor driver | Breakout |  |  |  |  |  |  |  |  |  |  |  | communica | http://www.communica.co.za/Catalog/Details/P4013654006 | 1 |  | 59 | 59
 | red cable | 1 | high current cabling | csa=0.75 |  |  |  |  |  |  |  |  |  |  |  | mantech | http://www.mantech.co.za/ProductInfo.aspx?Item=52M0039 | per metre |  | 3.12 | 3.12
 | grey cable | 1 | high current cabling | csa=0.75 |  |  |  |  |  |  |  |  |  |  |  | mantech | http://www.mantech.co.za/ProductInfo.aspx?Item=52M0036 | permetre |  | 3.45 | 3.45

Sheet: Component Request
MCU module components
Part | Quantity per Board | Package | Link | Parts in package | Price | Unit Price
*STM32F051C6 | 1 | LQFP48 | http://za.rs-online.com/web/p/microcontrollers/8297158/ | 5 | 173.21 | 34.642
SN75176B | 1 | 8-SOIC | http://za.rs-online.com/web/p/line-transceivers/5172346/ | 10 | 89.66 | 8.966
8MHZ crystal | 1 | HC49 SMD (US) | http://za.rs-online.com/web/p/crystal-units/5476452/ | 5 | 21.79 | 4.358
LL4148 | 1 | SOD80 | http://za.rs-online.com/web/p/rectifier-schottky-diodes/6708823/ | 25 | 10.475 | 0.419
FMMT491TA | 1 | SOT23 | http://za.rs-online.com/web/p/bipolar-transistors/0274879/ | 10 | 20.51 | 2.051
*DIP SWITCH | 1 | DIP | http://za.rs-online.com/web/p/dip-sip-switches/8772148/ | 21 | 161.7 | 7.7
A4988 Breakout board | 1 | Breakout | http://www.communica.co.za/Catalog/Details/P4013654006 | 1 | 59 | 59
Pi Hat components
Part | Quantity | Package | Link | Parts in package | Price | Unit Price
*2x20 way femal header | 1 | normal female header | http://za.rs-online.com/web/p/pcb-sockets/6742369/ | 5 | 113.54 | 22.708
SN75176B | 1 | 8-SOIC |  | repeat see above
Molex MINI-FIT JR. | 1 | Series 5556 4.2 pitch 20 way | http://za.rs-online.com/web/p/pcb-headers/1728923/ | 5 | 91.48 | 18.296
 |  |  |  | TOTAL: | 627.825

Sheet: Pi Hat BOM
 | Compoenent List |  |  |  |  | minimum order |  |  |  |  |  | *schange at : | 13.31 | rands to the dollar
 | Comonent | Quantity | Description | Package | rs-online link | poack of* | cost [R] | unit price | total | digikey link | pack of | cost [$] | cost [R]* | unit price | total | Other | link | pack of | cost [$] | cost [R]* | unit price | total
1 | Molex MINI-FIT JR. Series 5556 4.2 pitch 20 way | 1 | normal female header | 2.54 pitch |  |  |  |  |  |  |  |  |  | #DIV/0!
1 | SN75176B | 1 | Differential Bus Transceivers | 8-SOIC | http://za.rs-online.com/web/p/line-transceivers/5172346/ | 10 | 89.66 | 8.966 |  | http://www.digikey.com/product-detail/en/texas-instruments/SN75176BDR/296-1275-1-ND/404925 | 1 | 0.77 | 10.2487 | 10.2487
1 | 6 way one way header | 1 | friction lock one way header | 2.54 pitch 90 degrees |  |  |  | #DIV/0! |  |  |  |  |  | #DIV/0!
1 | red LED | 1 |  | 1206 |  |  |  | #DIV/0! |  |  |  |  | 0 | #DIV/0!
1 | 150 oh mres | 1 | chip resistor | 805 |  |  |  | #DIV/0! |  |  |  |  | 0 | #DIV/0!
1 | 120 oh mres | 1 | chip resistor | 805 |  |  |  | #DIV/0! |  |  |  |  | 0 | #DIV/0!
1 | 20 way 2.54mm socket | 1 | ATX header | ATX-20 |  |  |  | #DIV/0! |  |  |  |  |  | #DIV/0!
1 | m3 Standoff | 6 |  | m3
 | m3 bolts | 3 |  | m3
3 | 3 ohm res 5w
 | reed switch
 | switch
