BadenMorgan/thesis/Solidworks/part models/EEE3000X_Batch2.xlsx

Emplid | Campus ID | Name | Term | Class Nbr | Subject | Catalog Nbr | Acad Prog | Grade
1430056 | BRDCRA003 | Burden,Craig | 1161 | 3724 | EEE | 3000X | EB011 | PA
1408963 | SYDSHA016 | Sayed,Shabier Ahmed | 1161 | 3724 | EEE | 3000X | EB011 | PA
