BadenMorgan/thesis/Solidworks/Feed Up/feed up comparison.SLDASM

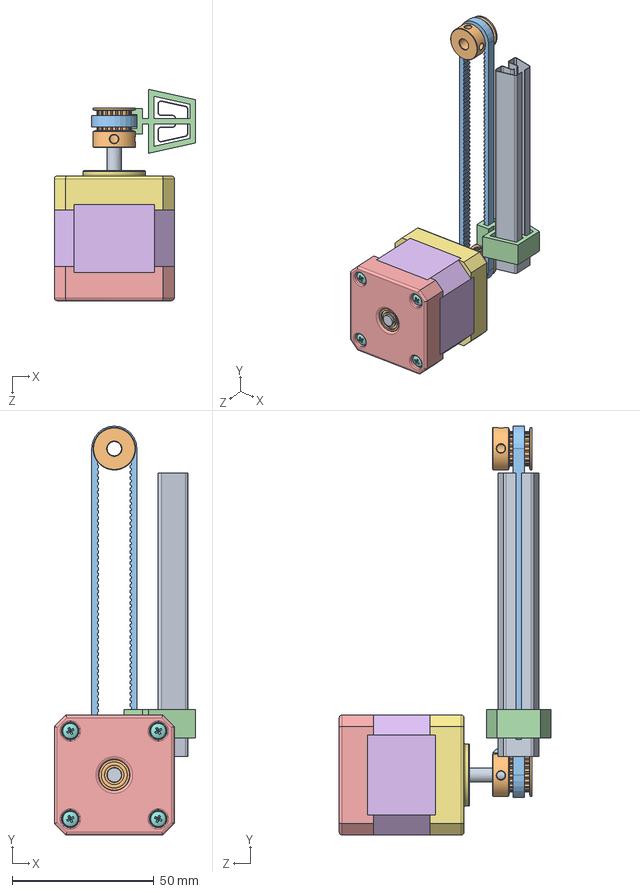
[picture p134: CAD file, 2016-10-07]
Solidworks/Feed Up/feed up comparison.SLDASM
49.8 x 144.1 x 74.6 mm
tube
GT2_20tooth x 2
timing gear
Key
Base
Cuerpo
Tapa
pan cross head_am x 4
Eje
instrument ball bearing_68_am x 2
socket button head cap screw_am
