BadenMorgan/thesis/Solidworks/part models/size comp.SLDASM

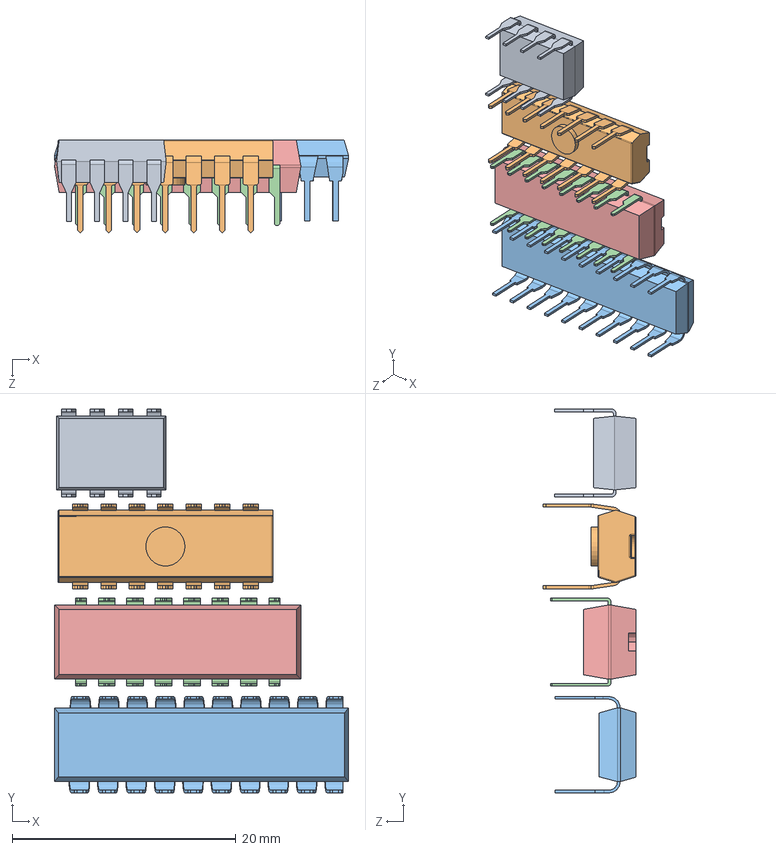
[picture p135: CAD file, 2016-08-19]
Solidworks/part models/size comp.SLDASM
26.3 x 34.3 x 8.30 mm
DIP8
DIL14
User Library-20-pin-dip
User Library-DIP16-22mm_DIP16_22mm
User Library-DIP16-22mm_DIP16_22mm001
