BadenMorgan/thesis/Solidworks/RFID Reader Holder/RFID HOLDER.SLDASM

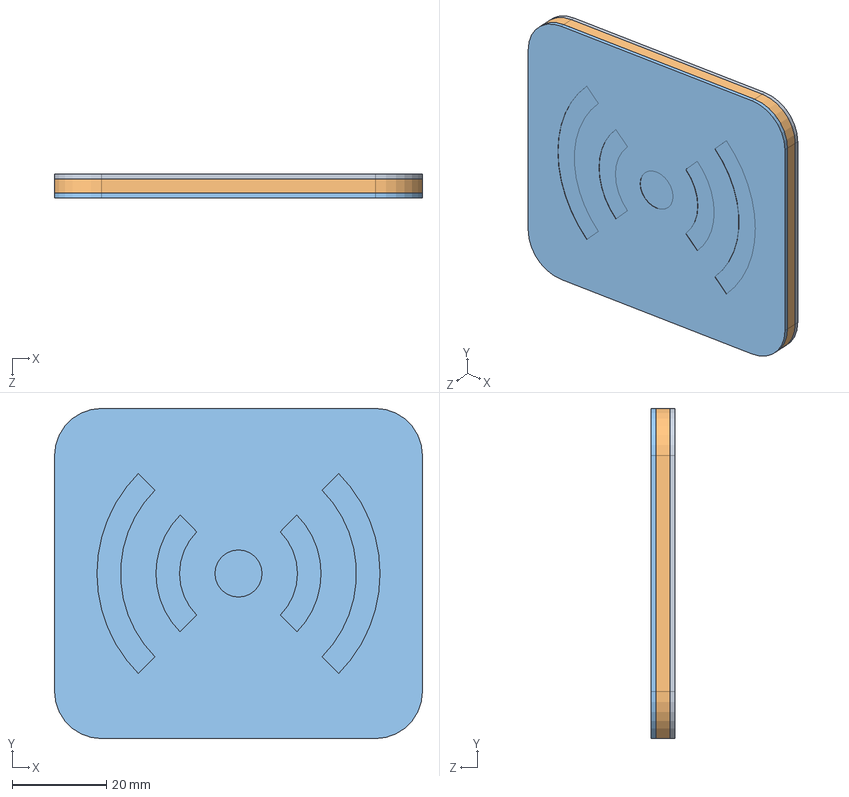
[picture p136: CAD file, 2016-10-07]
Solidworks/RFID Reader Holder/RFID HOLDER.SLDASM
78.0 x 70.0 x 5.00 mm
bottom plate
Middle plate
top plate etch
