BadenMorgan/thesis/Solidworks/roller 2/dip 8/idea 2 exploded.SLDASM

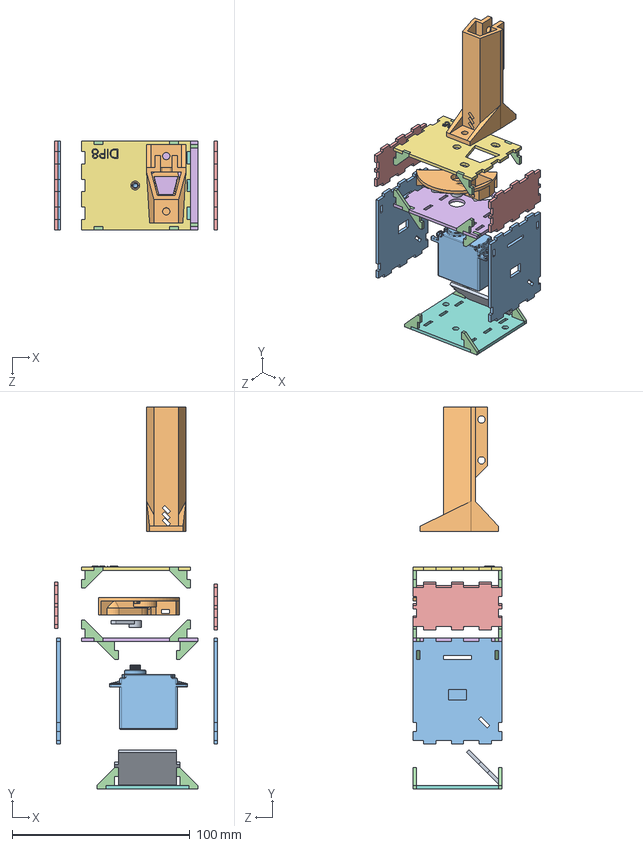
[picture p137: CAD file, 2016-10-31]
Solidworks/roller 2/dip 8/idea 2 exploded.SLDASM
91.7 x 214.7 x 50.0 mm
SG90 plastic Horn
Component Roller dip8
servo hold x 2
brace1 x 16
part plate dip 8 x 2
stop plate
top plate dip 8
base plate 2
angled plate
guide
servo Hitec HS-225 MG
