BadenMorgan/thesis/Solidworks/roller 2/dip14.16/idea 2 dip 14 or 16.SLDASM

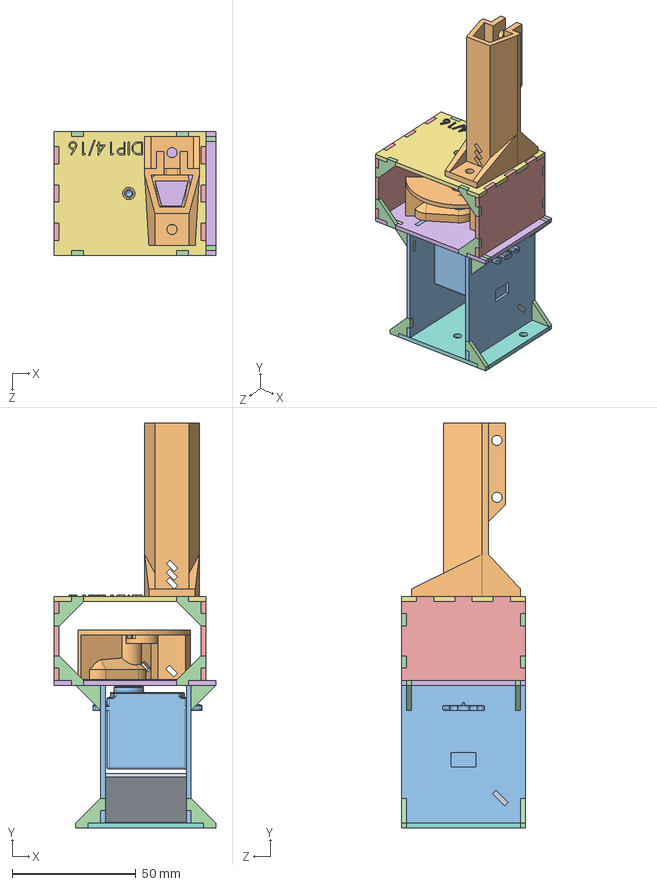
[picture p138: CAD file, 2016-09-21]
Solidworks/roller 2/dip14.16/idea 2 dip 14 or 16.SLDASM
65.4 x 163.5 x 50.0 mm
SG90 plastic Horn
Component Roller dip 16 or 14
servo hold x 2
brace1 x 16
part plate dip 14 or 16 x 2
stop plate
top plate dip 14 or 16
base plate 2
angled plate
guide
servo Hitec HS-225 MG
