BadenMorgan/thesis/Solidworks/part models/9hr servo/Tower Pro 9g Micro Servo SG90.SLDASM

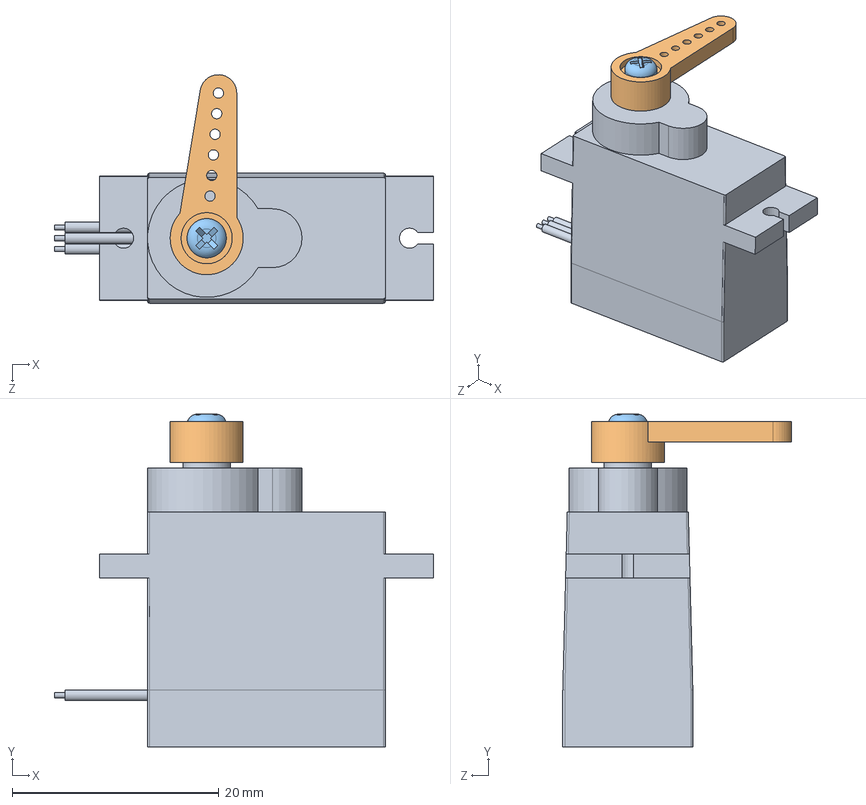
[picture p139: CAD file, 2016-07-30]
Solidworks/part models/9hr servo/Tower Pro 9g Micro Servo SG90.SLDASM
36.7 x 32.2 x 22.1 mm
Tower Pro 9g Micro Servo SG90
SG90 plastic Horn
SM-S2309S-Screw
