BadenMorgan/thesis/Solidworks/part models/User Library-DIP16-22mm/User Library-DIP16-22mm.sldasm

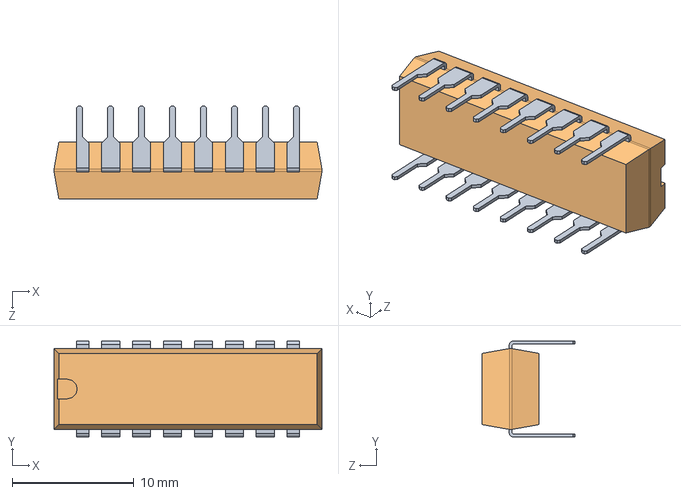
[picture p140: CAD file, 2016-08-19]
Solidworks/part models/User Library-DIP16-22mm/User Library-DIP16-22mm.sldasm
22.0 x 7.87 x 7.64 mm
User Library-DIP16-22mm_DIP16_22mm
User Library-DIP16-22mm_DIP16_22mm001
