BadenMorgan/thesis/Solidworks/roller 2/dip 20/idea 2 dip 20.SLDASM

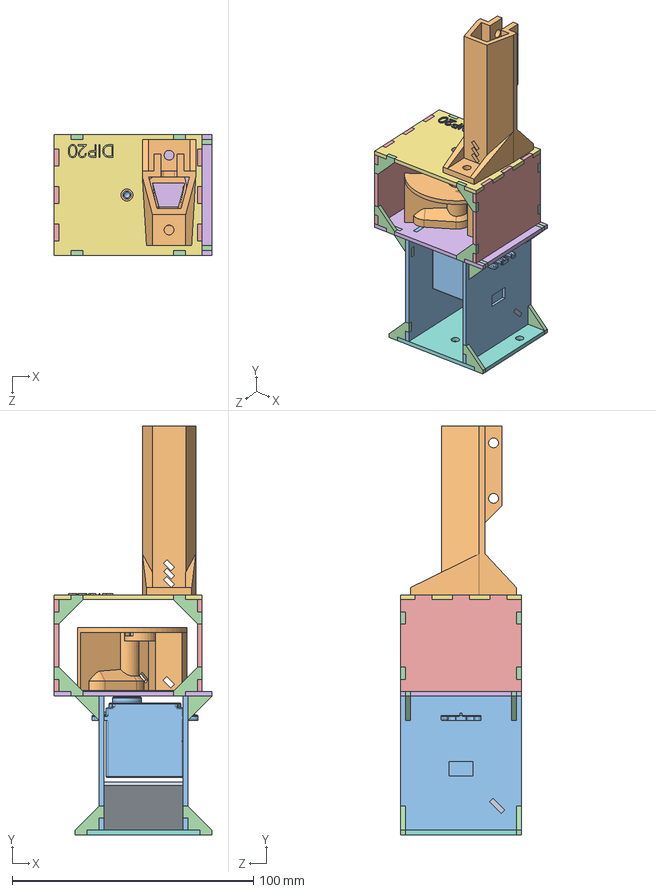
[picture p141: CAD file, 2016-09-21]
Solidworks/roller 2/dip 20/idea 2 dip 20.SLDASM
65.4 x 169.5 x 50.0 mm
SG90 plastic Horn
Component Roller dip20
servo hold x 2
brace1 x 16
part plate dip20 x 2
stop plate
top plate dip 20
base plate 2
angled plate
guide
servo Hitec HS-225 MG
