BadenMorgan/thesis/Solidworks/roller 2/IC holder dip 8/idea 2.SLDASM

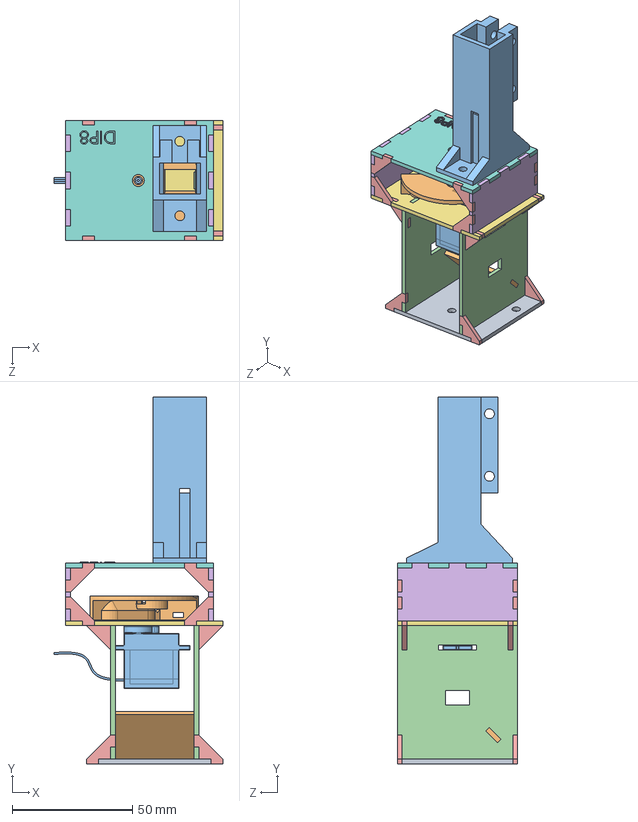
[picture p143: CAD file, 2016-09-09]
Solidworks/roller 2/IC holder dip 8/idea 2.SLDASM
70.2 x 152.7 x 50.0 mm
SG90 plastic Horn
Component Roller dip8 ic holder
Servo HXT900 Micro
servo hold x 2
brace1 x 16
part plate dip 8 x 2
stop plate
top plate dip 8 ic holder
base plate 2
angled plate
guide ic holder
