BadenMorgan/thesis/Solidworks/part models/16x2-character-lcd-display-1.snapshot.2/DFRobot_1602_LCD.SLDASM

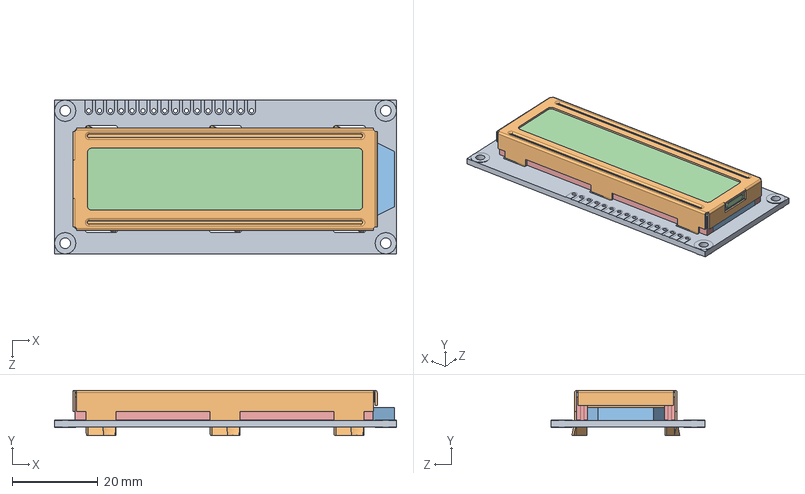
[picture p144: CAD file, 2016-09-05]
Solidworks/part models/16x2-character-lcd-display-1.snapshot.2/DFRobot_1602_LCD.SLDASM
80.0 x 10.6 x 36.0 mm
LCD_PCB
metal_casing
LCDbacklight
LCD
conductors x 2
