BadenMorgan/thesis/Solidworks/part models/stepper-motor-nema-17.snapshot.17/NEMA 17.SLDASM

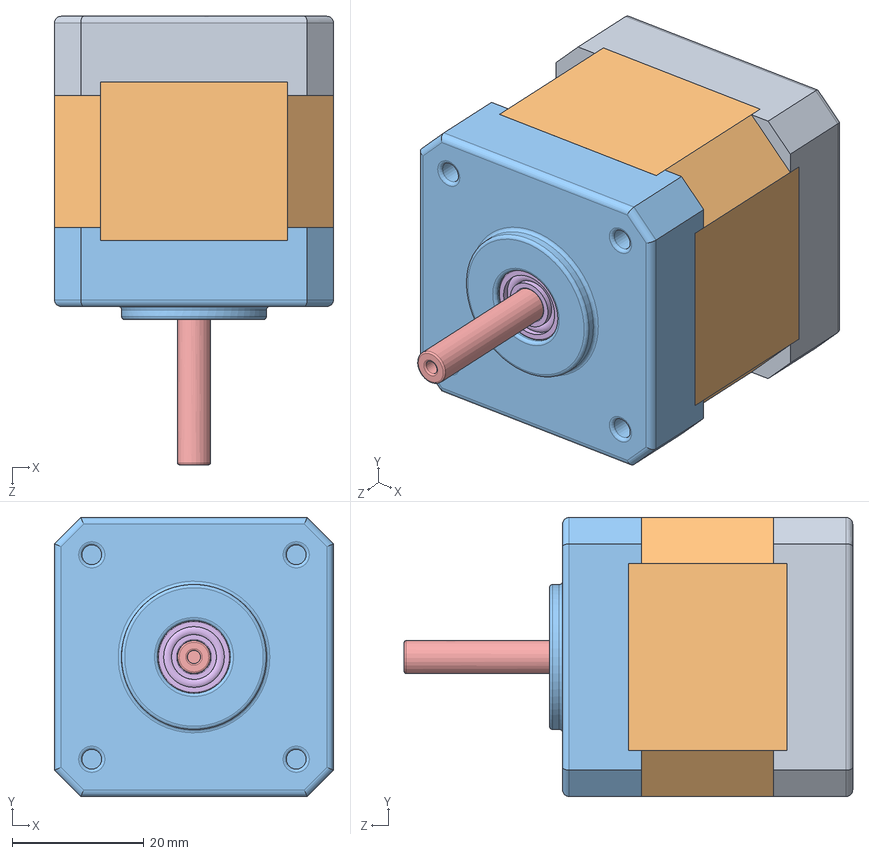
[picture p145: CAD file, 2016-10-07]
Solidworks/part models/stepper-motor-nema-17.snapshot.17/NEMA 17.SLDASM
42.3 x 42.3 x 68.0 mm
Base
Cuerpo
Tapa
pan cross head_am x 4
Eje
instrument ball bearing_68_am x 2
