BadenMorgan/thesis/Solidworks/roller 2/dip 20/servo hold.SLDASM

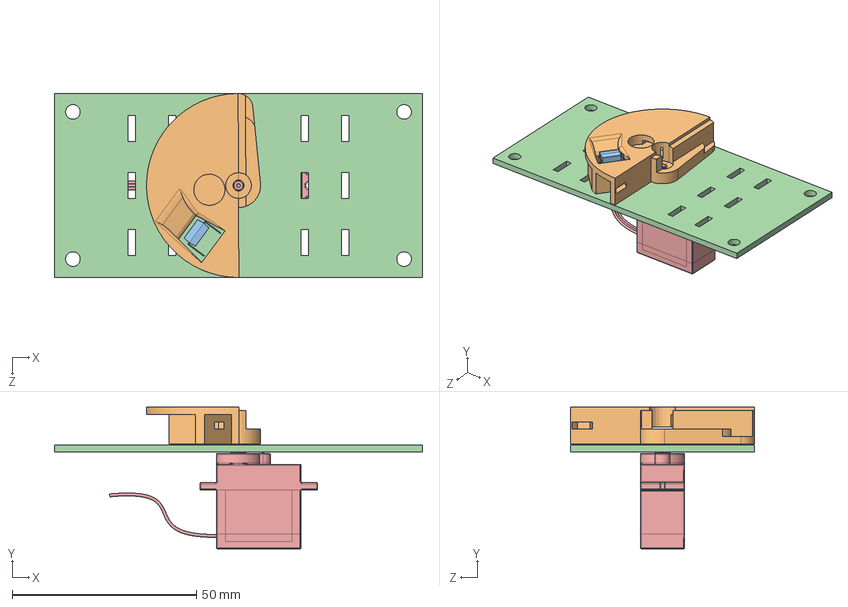
[picture p146: CAD file, 2016-08-14]
Solidworks/roller 2/dip 20/servo hold.SLDASM
100.0 x 38.5 x 50.0 mm
SG90 plastic Horn
Component Roller 2
DIP8
stop plate
Servo HXT900 Micro
