BadenMorgan/thesis/Deliver Mechanism model/STL 3D Models/Component Roller dip 16 or 14.STL

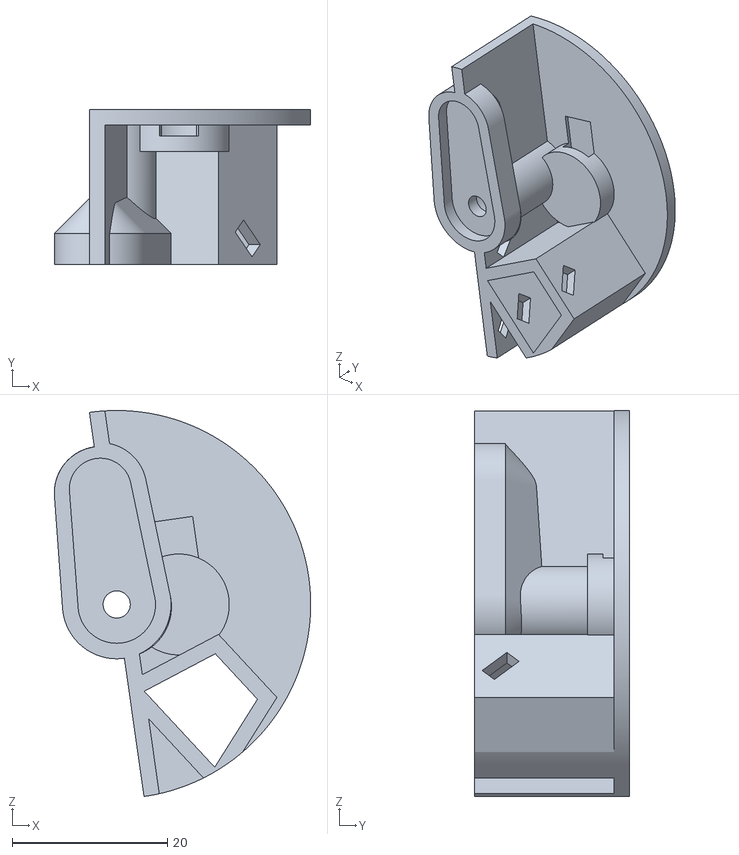
[picture p147: CAD file, 2016-10-07]
Deliver Mechanism model/STL 3D Models/Component Roller dip 16 or 14.STL
33.0 x 20.0 x 49.8
