BadenMorgan/thesis/Solidworks/Enclosure/L Beam 1100 45cut.SLDPRT

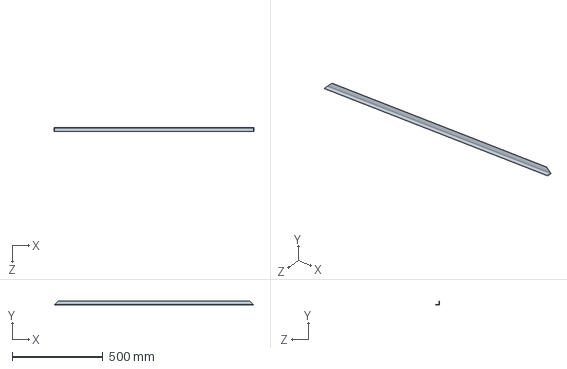
[picture p148: CAD file, 2016-10-07]
Solidworks/Enclosure/L Beam 1100 45cut.SLDPRT
1100.0 x 22.5 x 22.5 mm
