BadenMorgan/thesis/Solidworks/part models/16x2-character-lcd-display-1.snapshot.2/metal_casing.SLDPRT

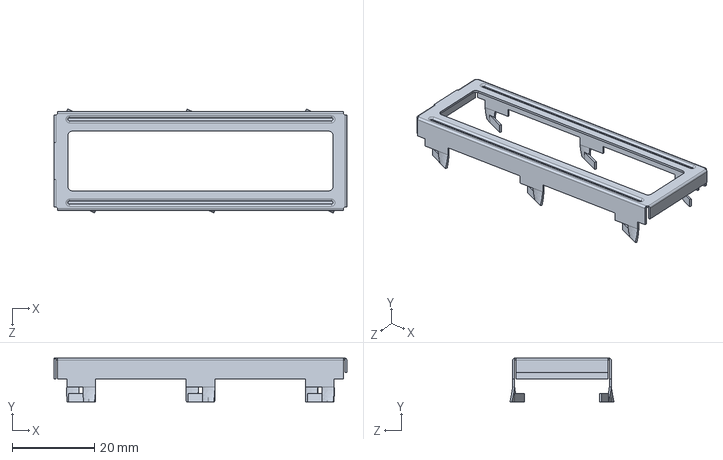
[picture p149: CAD file, 2016-09-05]
Solidworks/part models/16x2-character-lcd-display-1.snapshot.2/metal_casing.SLDPRT
71.2 x 10.6 x 25.3 mm
