BadenMorgan/thesis/Solidworks/part models/9hr servo/SG90 plastic Horn.SLDPRT

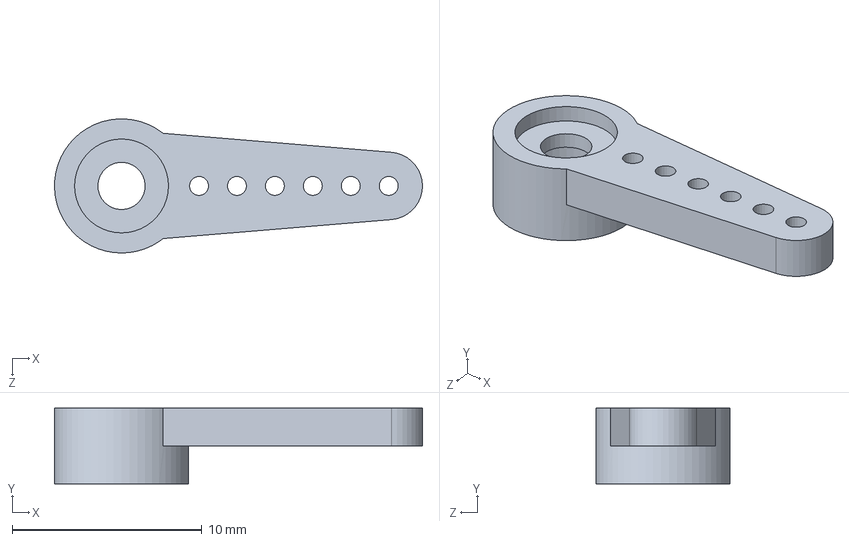
[picture p150: CAD file, 2016-09-05]
Solidworks/part models/9hr servo/SG90 plastic Horn.SLDPRT
19.4 x 4.00 x 7.06 mm
