BadenMorgan/thesis/Solidworks/part models/dip 14/DIL14.stp

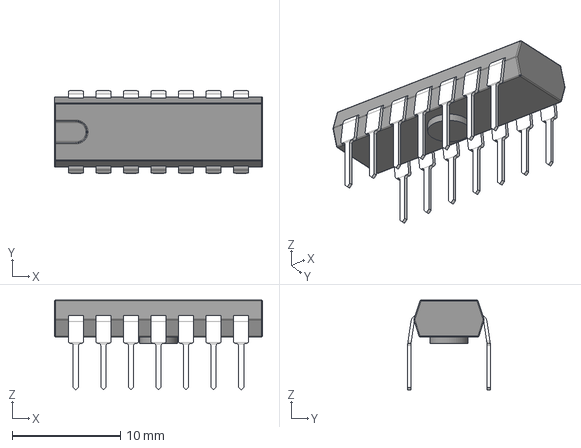
[picture p151: CAD file, 2016-08-19]
Solidworks/part models/dip 14/DIL14.stp
19.2 x 7.62 x 8.30 mm
DIP14_body
legs x 7
