BadenMorgan/thesis/Solidworks/part models/DIP8/DIP8.SLDPRT

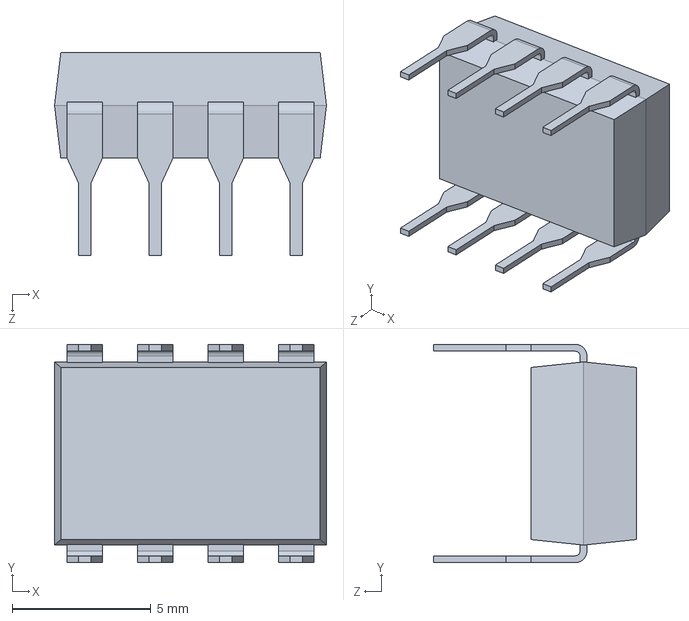
[picture p152: CAD file, 2016-09-05]
Solidworks/part models/DIP8/DIP8.SLDPRT
9.80 x 7.87 x 7.30 mm
