BadenMorgan/thesis/Solidworks/part models/pulley-gt2-20-teeth-5mm-bore-1.snapshot.8/GT2_20teeth_pulley.IGS

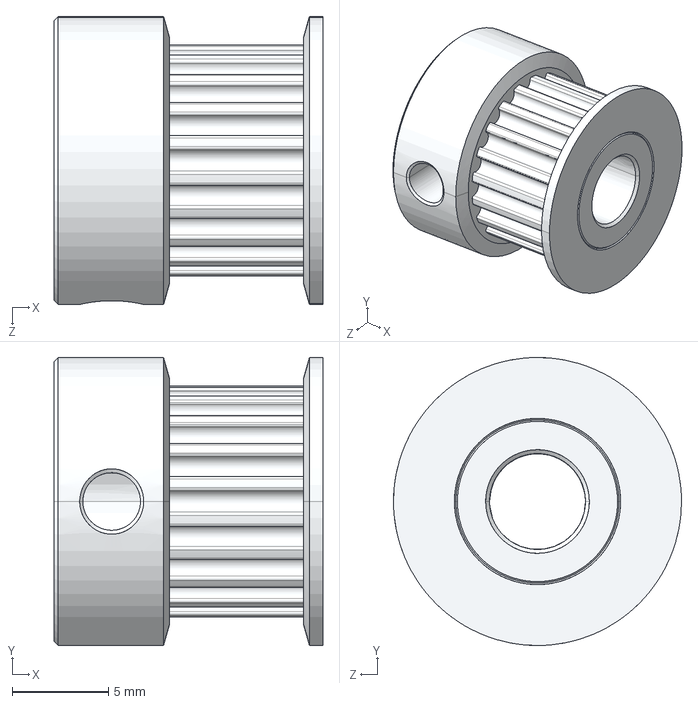
[picture p153: CAD file, 2016-09-21]
Solidworks/part models/pulley-gt2-20-teeth-5mm-bore-1.snapshot.8/GT2_20teeth_pulley.IGS
14.0 x 15.0 x 15.0 mm
