BadenMorgan/thesis/Solidworks/part models/servo-hitec-hs-225-mg-1.snapshot.3/servo Hitec HS-225 MG.STEP

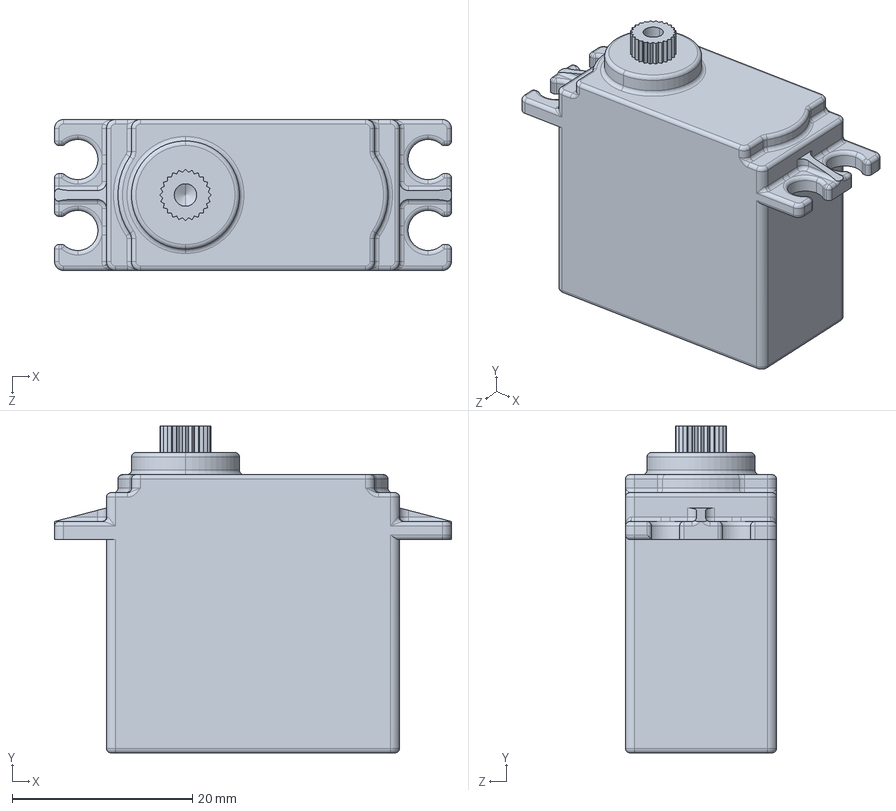
[picture p154: CAD file, 2016-09-21]
Solidworks/part models/servo-hitec-hs-225-mg-1.snapshot.3/servo Hitec HS-225 MG.STEP
44.1 x 36.3 x 16.8 mm
