BadenMorgan/thesis/Solidworks/part models/servo-hxt900-micro/Servo HXT900 Micro.STEP

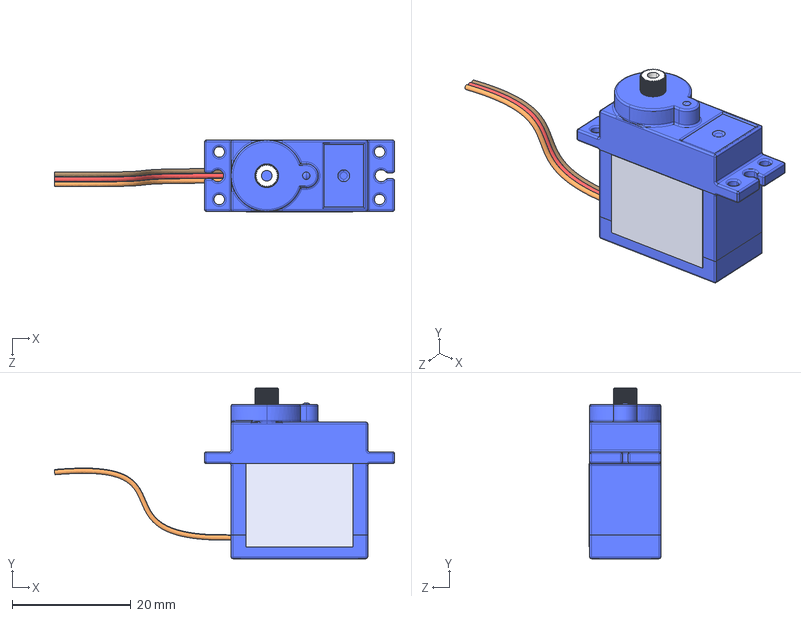
[picture p155: CAD file, 2016-08-14]
Solidworks/part models/servo-hxt900-micro/Servo HXT900 Micro.STEP
57.2 x 28.7 x 12.1 mm
Servo HXT900 Micro - Carcaça Intermediária
Servo HXT900 Micro - Carcaça Inferior
Servo HXT900 Micro - Carcaça Superior
Servo HXT900 Micro - Engrenagem Superior
Peça7^Servo HXT900 Micro
Servo HXT900 Micro - Fio
