BadenMorgan/thesis/Solidworks/part models/stepper2/Tapa.SLDPRT

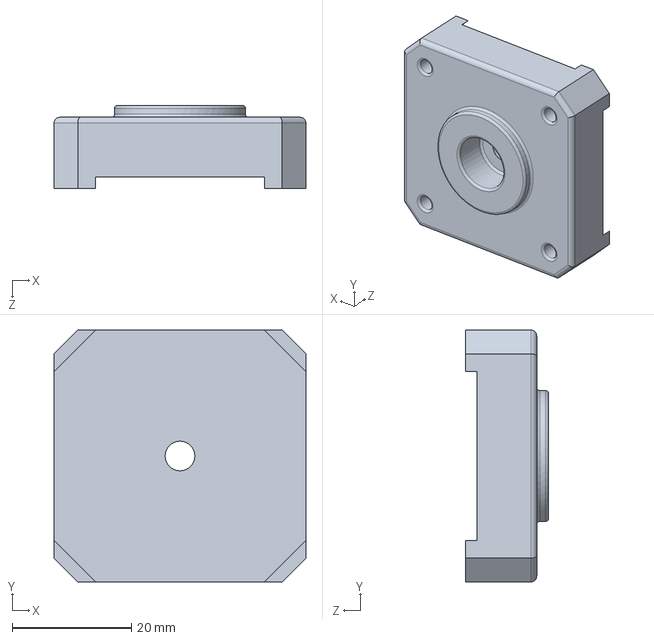
[picture p156: CAD file, 2016-10-07]
Solidworks/part models/stepper2/Tapa.SLDPRT
42.3 x 42.3 x 14.0 mm
