BadenMorgan/thesis/Solidworks/part models/timing-belt--1.snapshot.3/Timing belt.SLDPRT

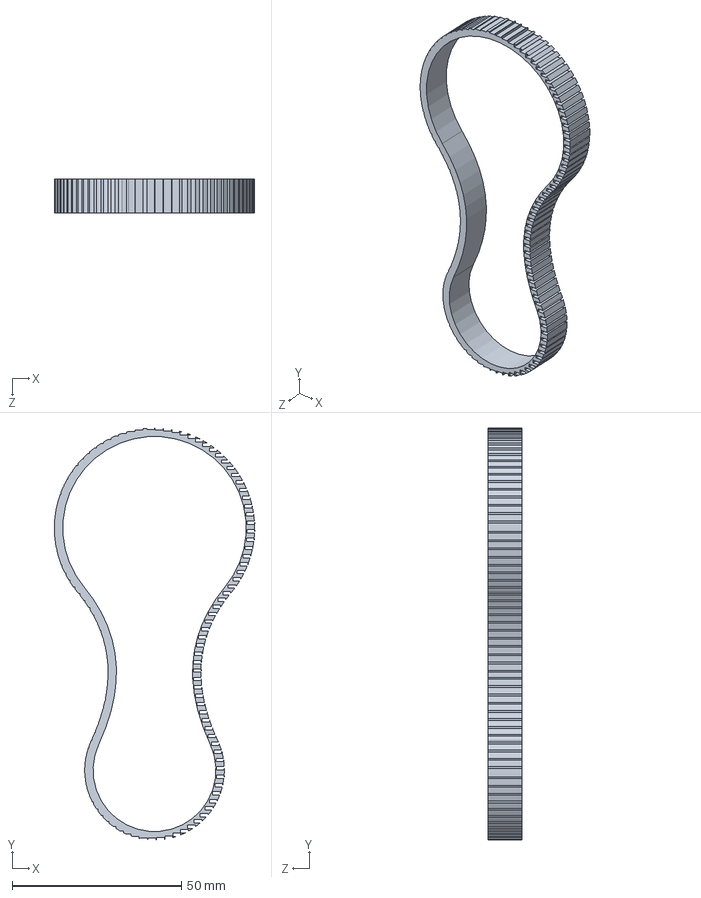
[picture p157: CAD file, 2016-09-21]
Solidworks/part models/timing-belt--1.snapshot.3/Timing belt.SLDPRT
59.3 x 121.9 x 10.0 mm
