BadenMorgan/thesis/Solidworks/part models/turnigy-tgy-225mg-servo-1.snapshot.4/TGY-3225MG.STEP

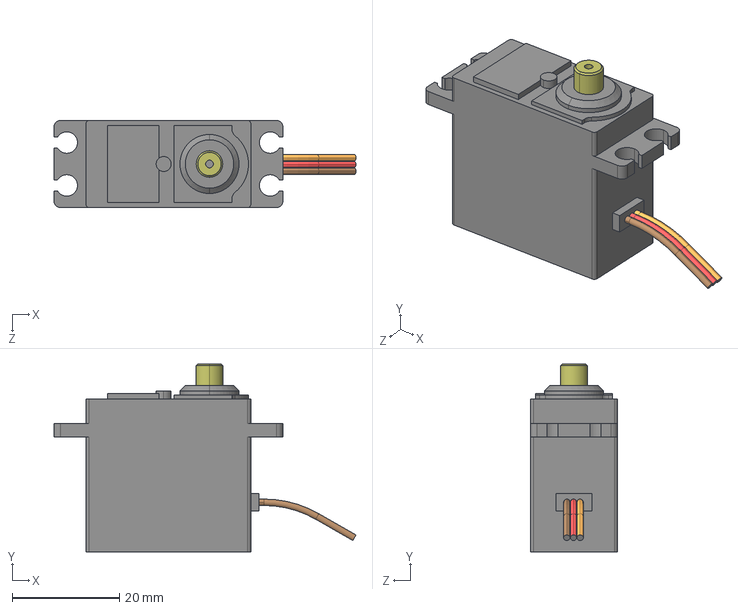
[picture p158: CAD file, 2016-09-21]
Solidworks/part models/turnigy-tgy-225mg-servo-1.snapshot.4/TGY-3225MG.STEP
56.4 x 35.1 x 16.3 mm
