BadenMorgan/thesis/Solidworks/part models/User Library-20-pin-dip/User Library-20-pin-dip.SLDPRT

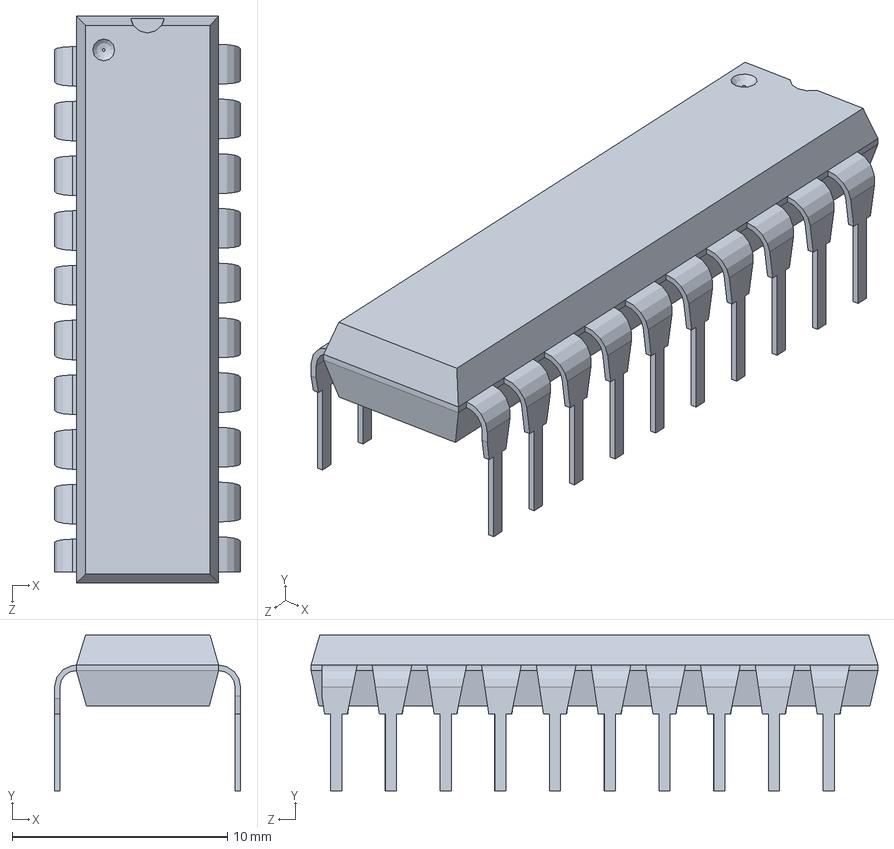
[picture p159: CAD file, 2016-08-19]
Solidworks/part models/User Library-20-pin-dip/User Library-20-pin-dip.SLDPRT
8.64 x 7.24 x 26.3 mm
