BadenMorgan/thesis/Solidworks/roller 2/Component Roller dip 16 or 14.SLDPRT

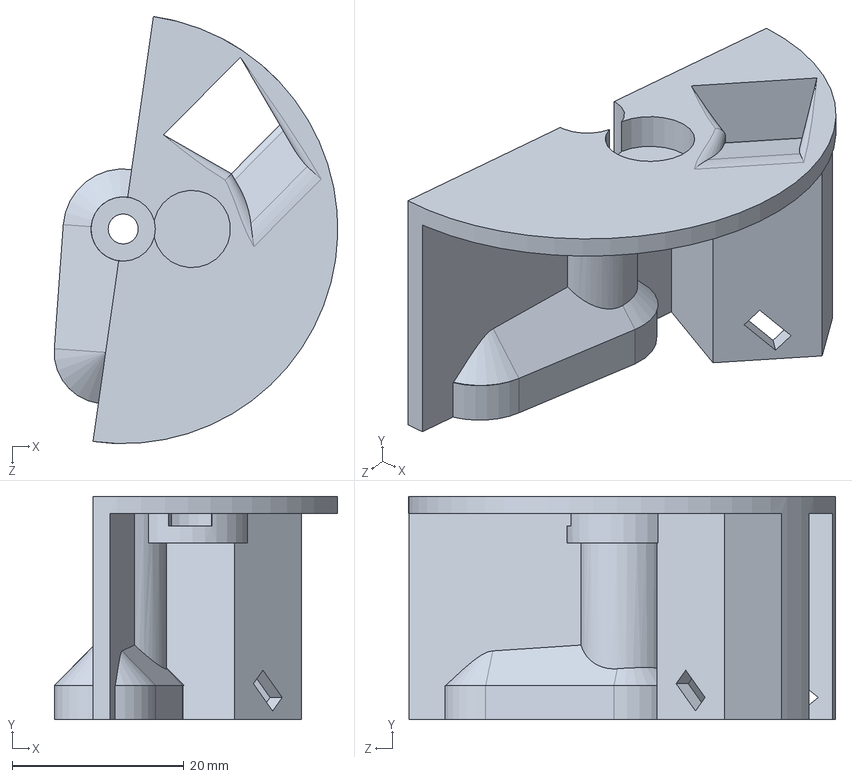
[picture p160: CAD file, 2016-08-29]
Solidworks/roller 2/Component Roller dip 16 or 14.SLDPRT
33.0 x 26.0 x 49.7 mm
