BadenMorgan/thesis/Solidworks/roller 2/dip 20/guide.SLDPRT

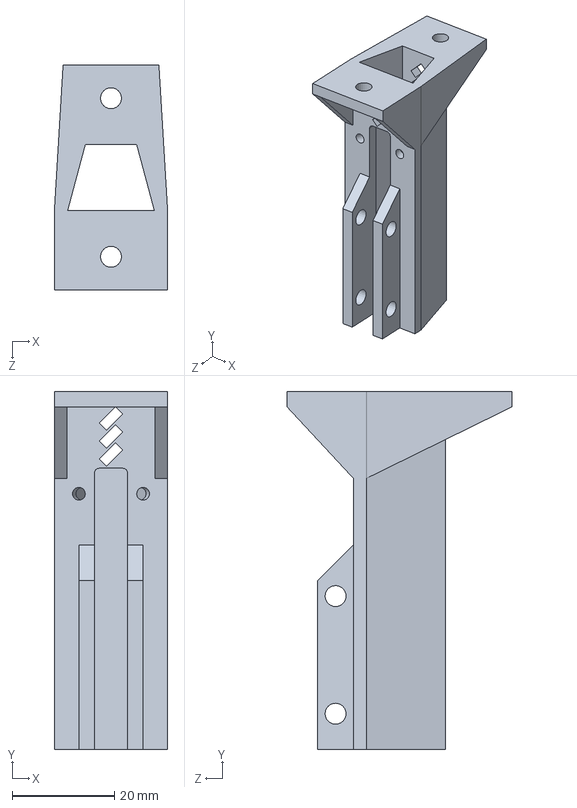
[picture p161: CAD file, 2016-09-21]
Solidworks/roller 2/dip 20/guide.SLDPRT
22.1 x 70.0 x 44.0 mm
