BadenMorgan/thesis/Solidworks/roller 2/IC holder dip 20/top plate dip 20 ic holder.SLDPRT

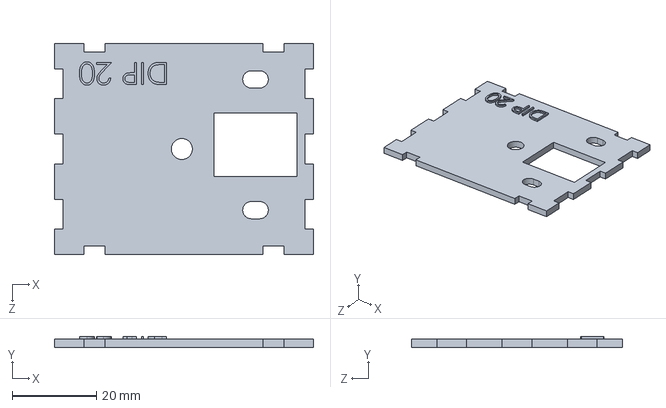
[picture p162: CAD file, 2016-10-07]
Solidworks/roller 2/IC holder dip 20/top plate dip 20 ic holder.SLDPRT
61.4 x 2.50 x 50.0 mm
