BadenMorgan/thesis/Solidworks/roller 2/IC holder dip 8/guide ic holder.SLDPRT

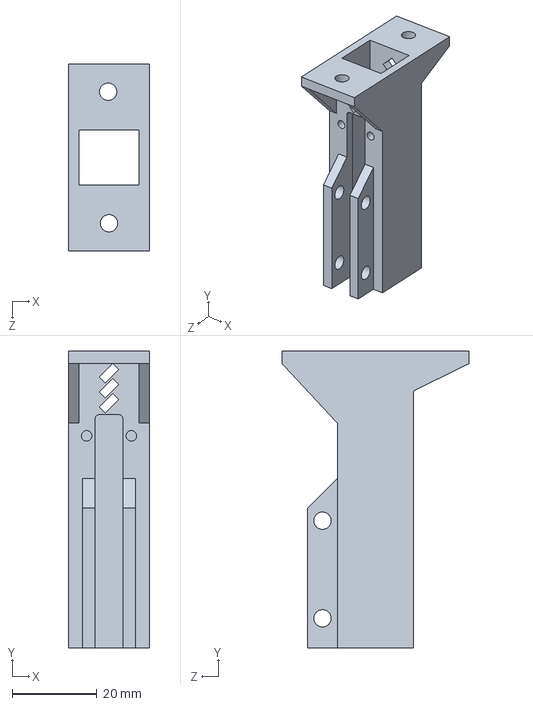
[picture p163: CAD file, 2016-09-21]
Solidworks/roller 2/IC holder dip 8/guide ic holder.SLDPRT
19.1 x 70.0 x 44.0 mm
