BadenMorgan/thesis/Solidworks/roller 2/stl files/Component Roller.STL

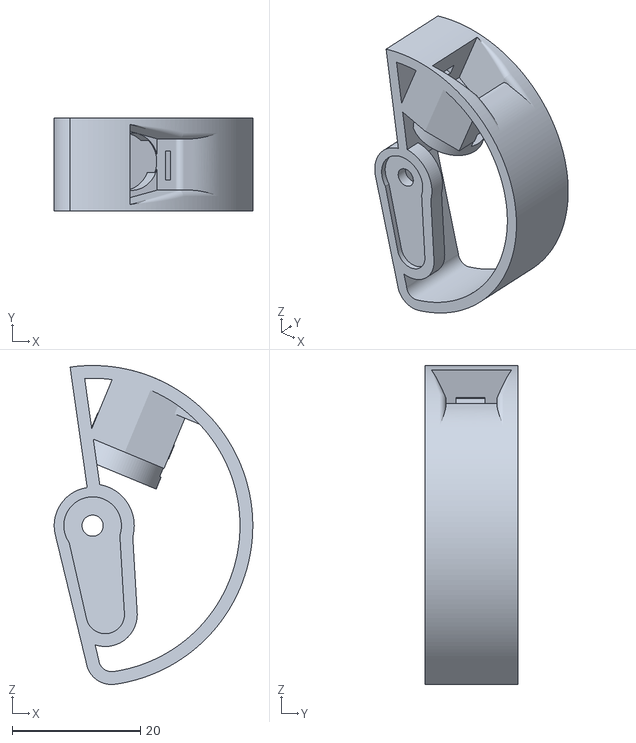
[picture p164: CAD file, 2016-08-14]
Solidworks/roller 2/stl files/Component Roller.STL
31.0 x 14.5 x 49.8
