BadenMorgan/thesis/Solidworks/Feed Up/tube.SLDPRT

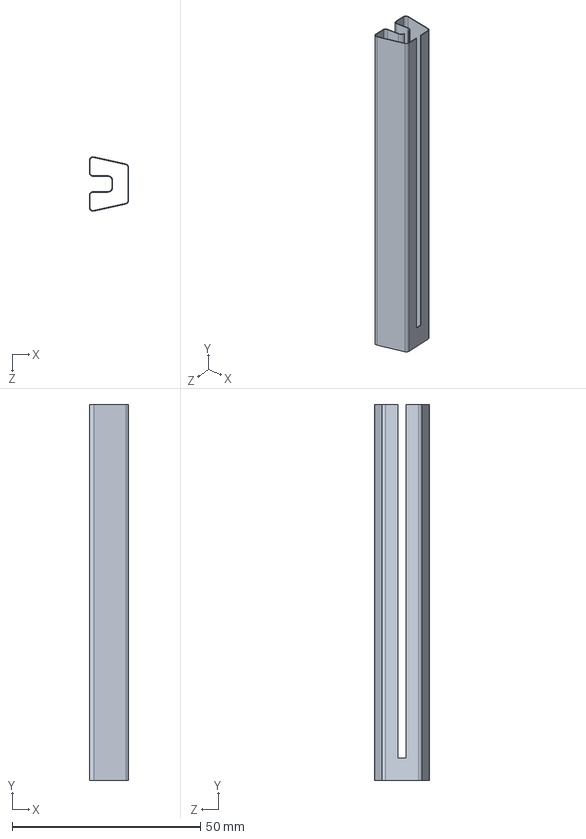
[picture p165: CAD file, 2016-09-21]
Solidworks/Feed Up/tube.SLDPRT
10.5 x 100.0 x 14.5 mm
