BadenMorgan/thesis/Solidworks/part models/16x2-character-lcd-display-1.snapshot.2/LCDbacklight.SLDPRT

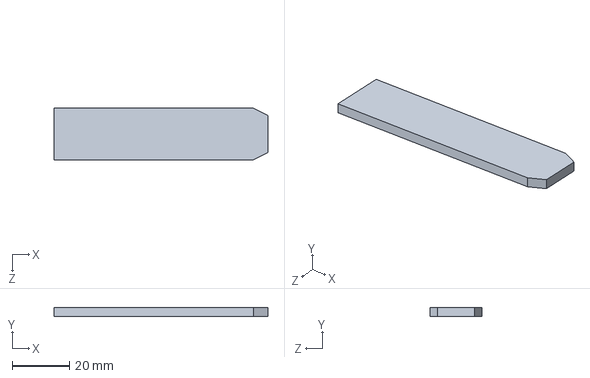
[picture p166: CAD file, 2016-09-05]
Solidworks/part models/16x2-character-lcd-display-1.snapshot.2/LCDbacklight.SLDPRT
74.7 x 3.00 x 18.0 mm
