BadenMorgan/thesis/Solidworks/part models/pulley-gt2-20-teeth-5mm-bore-1.snapshot.8/GT2_cut.SLDPRT

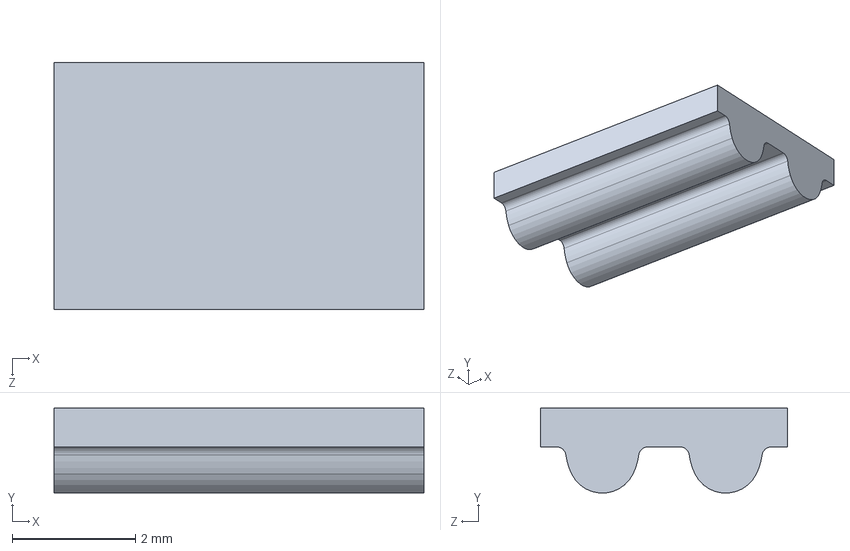
[picture p167: CAD file, 2016-09-21]
Solidworks/part models/pulley-gt2-20-teeth-5mm-bore-1.snapshot.8/GT2_cut.SLDPRT
6.00 x 1.38 x 4.00 mm
