BadenMorgan/thesis/Solidworks/part models/stepper-motor-nema-17.snapshot.17/Base.SLDPRT

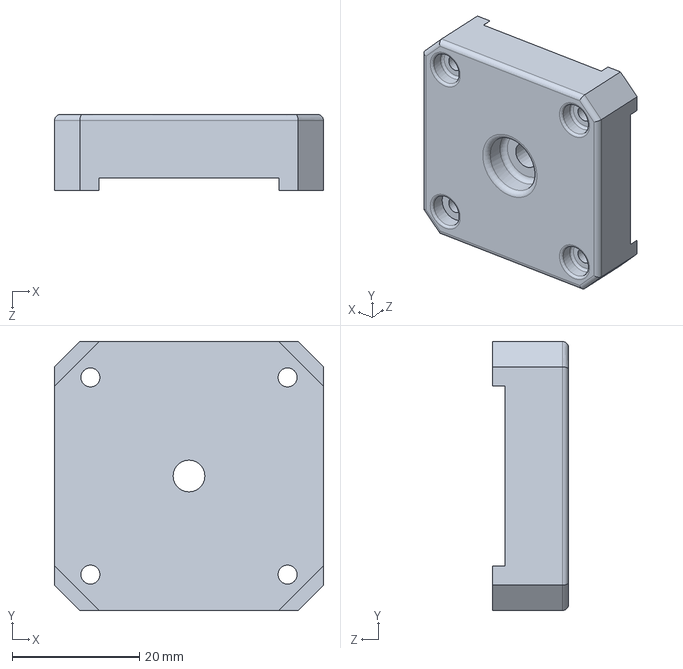
[picture p168: CAD file, 2016-10-07]
Solidworks/part models/stepper-motor-nema-17.snapshot.17/Base.SLDPRT
42.3 x 42.3 x 12.0 mm
