BadenMorgan/thesis/Solidworks/RFID Reader Holder/top plate etch.SLDPRT

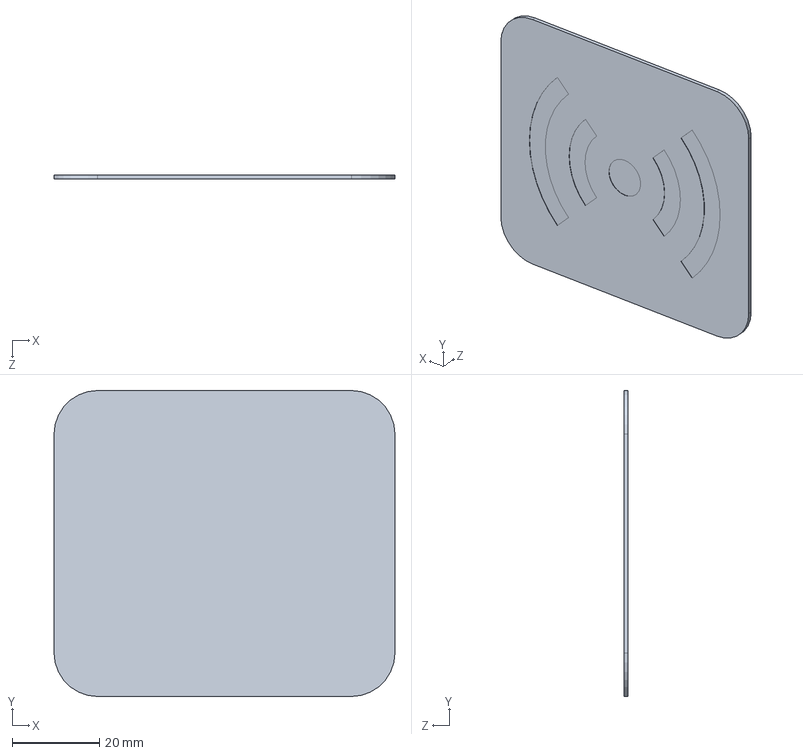
[picture p169: CAD file, 2016-10-07]
Solidworks/RFID Reader Holder/top plate etch.SLDPRT
78.0 x 70.0 x 1.00 mm
