BadenMorgan/thesis/Solidworks/roller 2/IC holder dip 8/Component Roller dip8 ic holder.SLDPRT

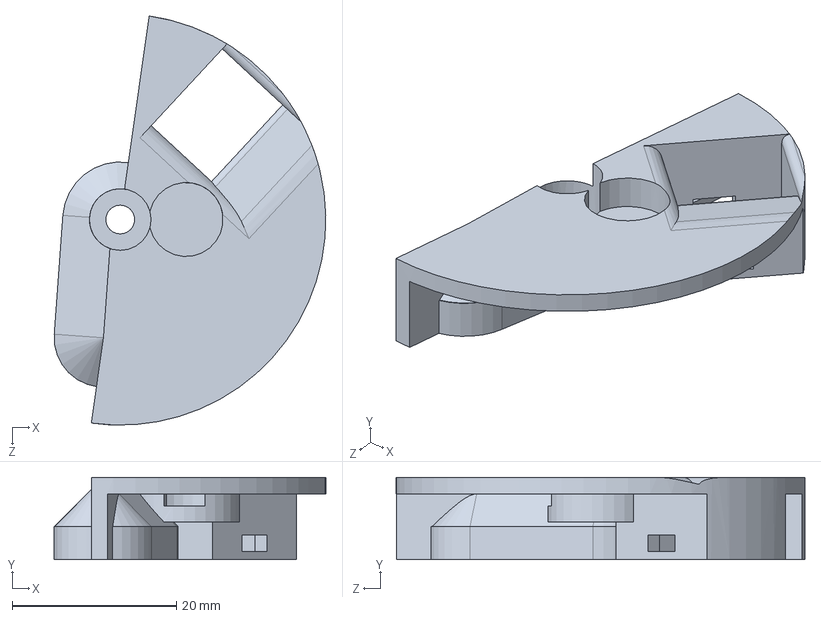
[picture p170: CAD file, 2016-09-16]
Solidworks/roller 2/IC holder dip 8/Component Roller dip8 ic holder.SLDPRT
33.0 x 10.0 x 49.7 mm
