BadenMorgan/thesis/Solidworks/roller 2/stl files/Component Roller 2.STL

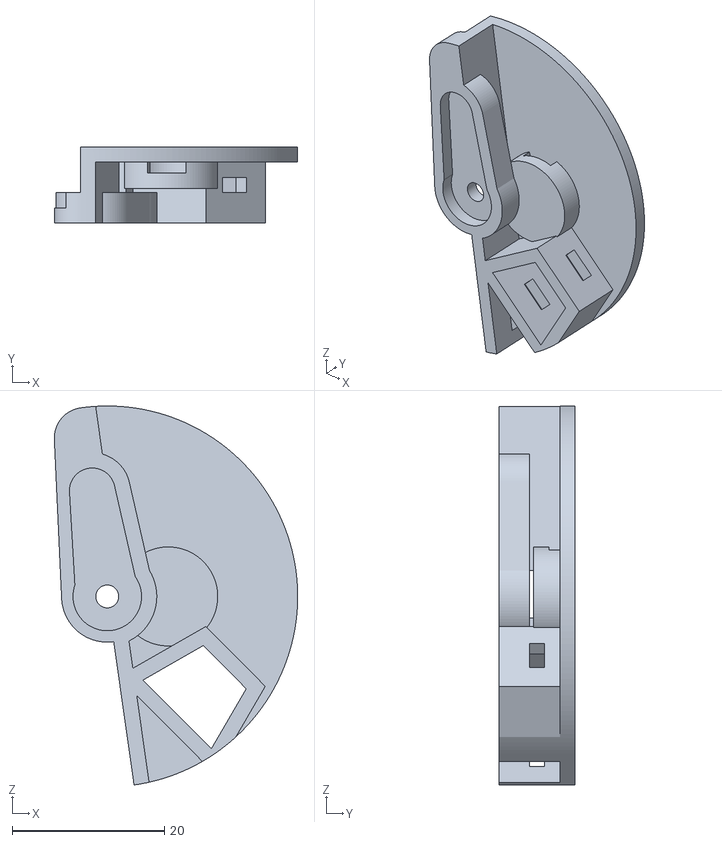
[picture p171: CAD file, 2016-08-14]
Solidworks/roller 2/stl files/Component Roller 2.STL
32.0 x 10.0 x 49.7
