BadenMorgan/thesis/Deliver Mechanism model/STL 3D Models/Component Roller dip 20 ic holder.STL

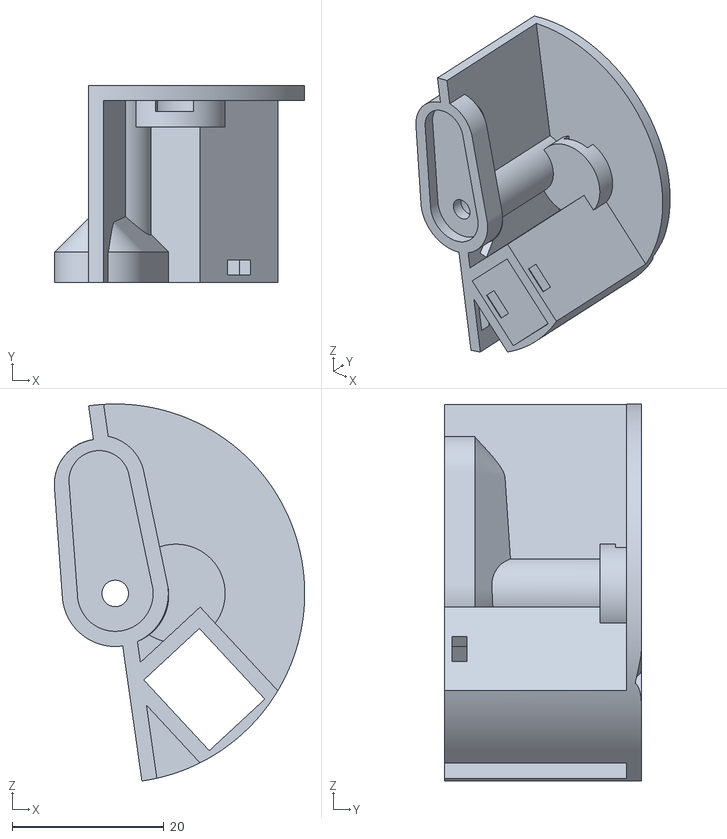
[picture p172: CAD file, 2016-10-07]
Deliver Mechanism model/STL 3D Models/Component Roller dip 20 ic holder.STL
33.0 x 26.0 x 49.8
