BadenMorgan/thesis/Solidworks/Enclosure/a1 front door plate.SLDPRT

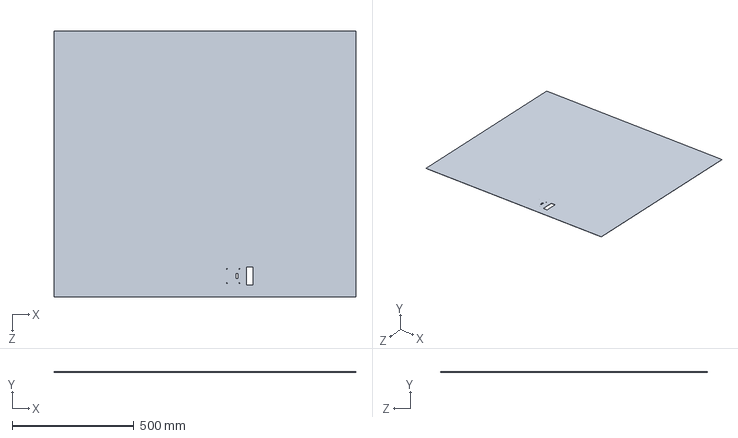
[picture p173: CAD file, 2016-10-07]
Solidworks/Enclosure/a1 front door plate.SLDPRT
1240.5 x 1.00 x 1093.0 mm
