BadenMorgan/thesis/Solidworks/Feed Up/gear.SLDPRT

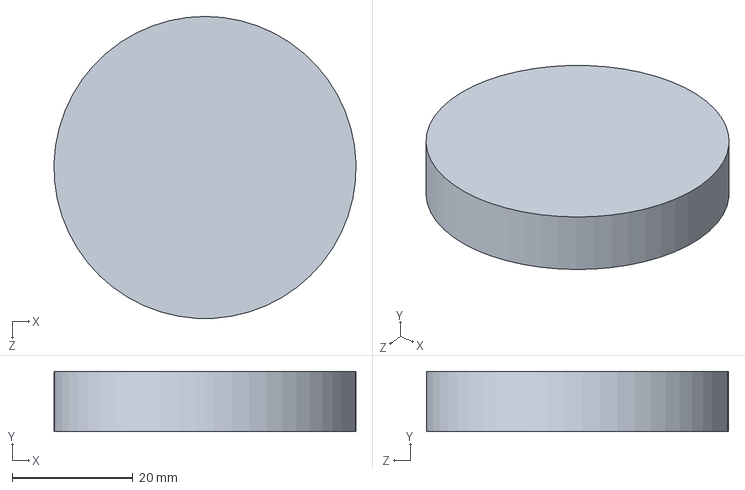
[picture p174: CAD file, 2016-09-21]
Solidworks/Feed Up/gear.SLDPRT
50.0 x 10.0 x 50.0 mm
