BadenMorgan/thesis/Solidworks/part models/16x2-character-lcd-display-1.snapshot.2/LCD.SLDPRT

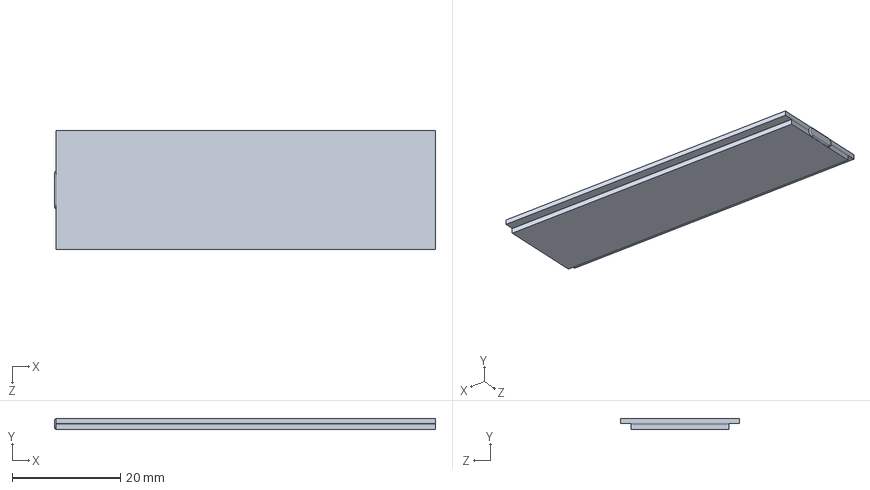
[picture p175: CAD file, 2016-09-05]
Solidworks/part models/16x2-character-lcd-display-1.snapshot.2/LCD.SLDPRT
70.3 x 2.10 x 22.0 mm
