BadenMorgan/thesis/Solidworks/part models/stepper2/Eje.SLDPRT

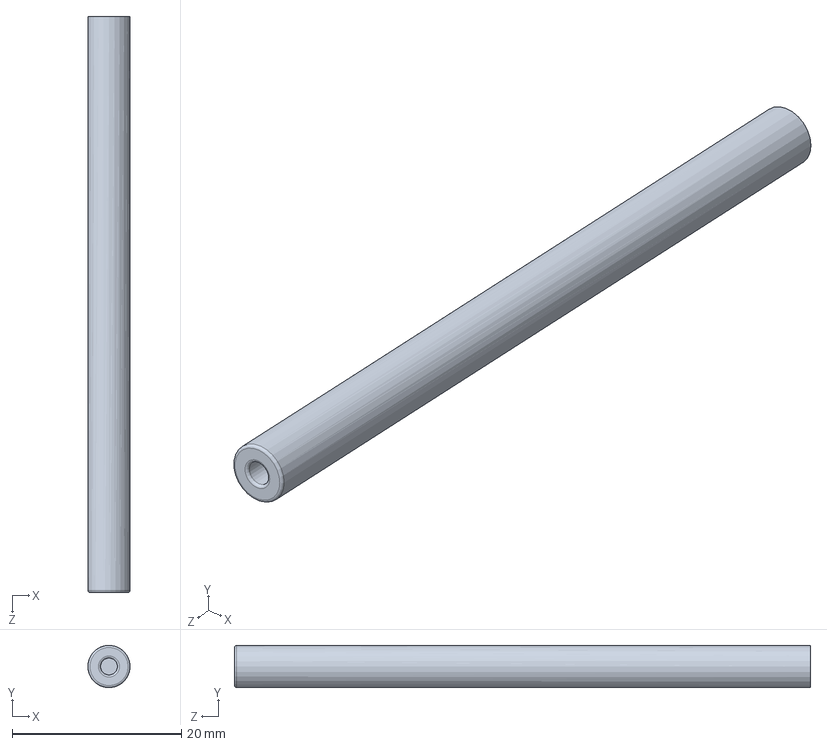
[picture p176: CAD file, 2016-10-07]
Solidworks/part models/stepper2/Eje.SLDPRT
5.00 x 5.00 x 68.0 mm
