BadenMorgan/thesis/Solidworks/roller 2/dip 8/base plate 2.SLDPRT

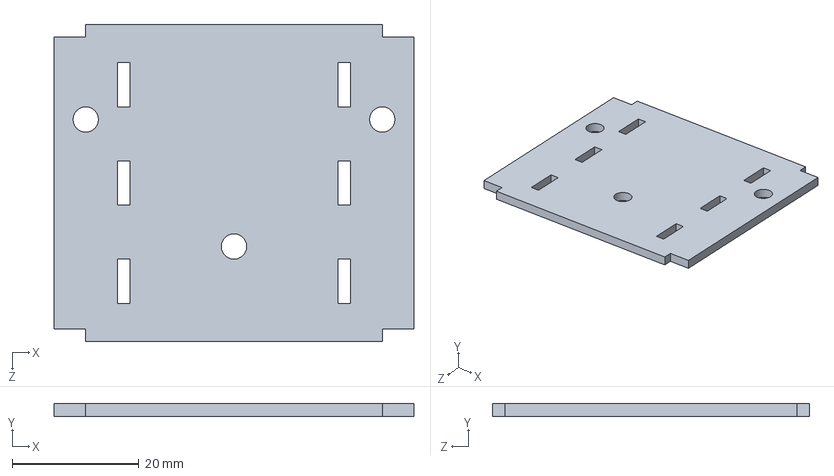
[picture p177: CAD file, 2016-10-07]
Solidworks/roller 2/dip 8/base plate 2.SLDPRT
56.7 x 2.00 x 50.0 mm
