BadenMorgan/thesis/Solidworks/roller 2/IC holder dip 14 or 16/Component Roller dip 14 or 16 ic holder.SLDPRT

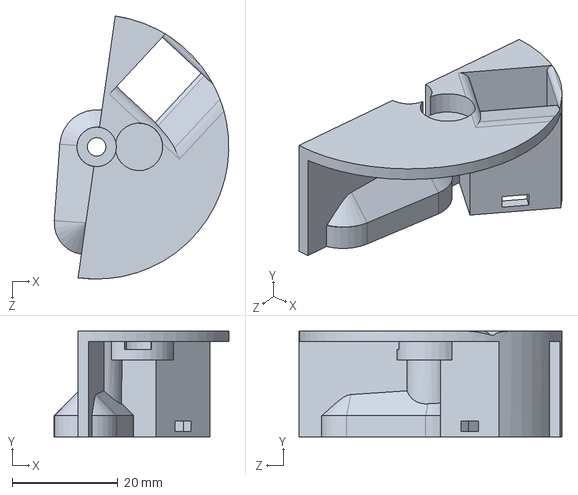
[picture p178: CAD file, 2016-10-07]
Solidworks/roller 2/IC holder dip 14 or 16/Component Roller dip 14 or 16 ic holder.SLDPRT
33.0 x 20.0 x 49.7 mm
