BadenMorgan/thesis/Solidworks/roller 2/stl files/angled plate.STL

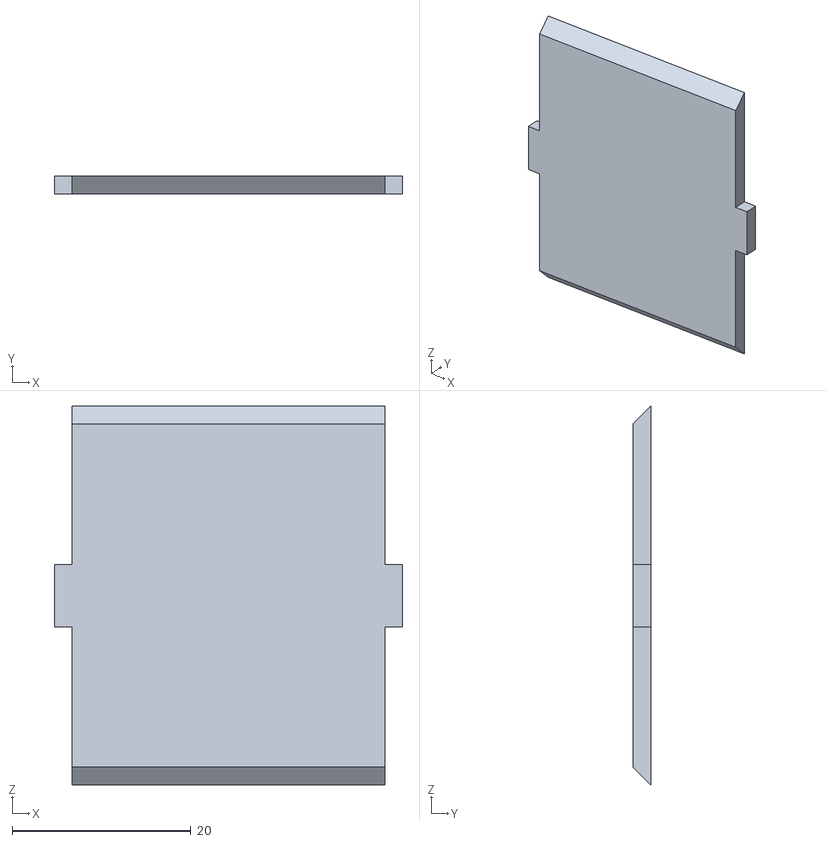
[picture p179: CAD file, 2016-08-04]
Solidworks/roller 2/stl files/angled plate.STL
39.0 x 2.00 x 42.4
