BadenMorgan/thesis/Deliver Mechanism model/STL 3D Models/Component Roller dip8 ic holder.STL

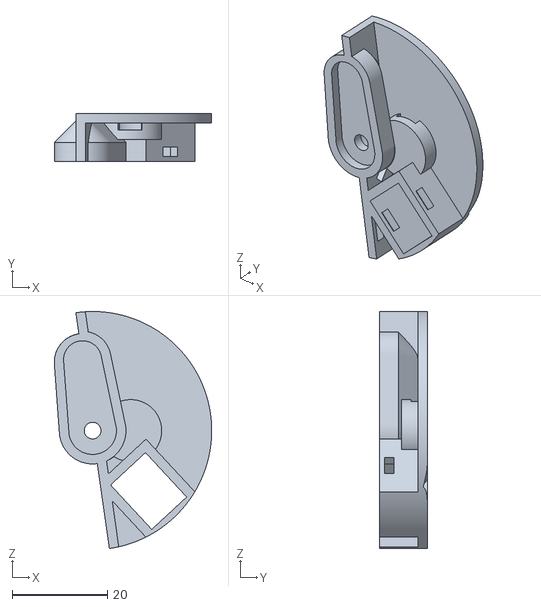
[picture p180: CAD file, 2016-10-07]
Deliver Mechanism model/STL 3D Models/Component Roller dip8 ic holder.STL
33.0 x 10.00 x 49.8
