BadenMorgan/thesis/Solidworks/Enclosure/45 1100 flat bar.SLDPRT

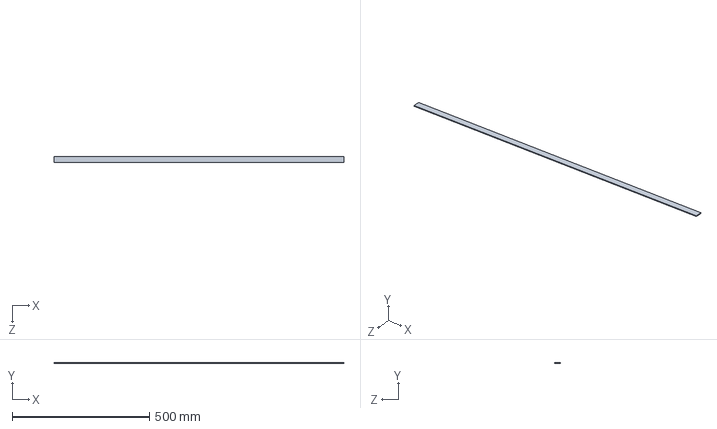
[picture p181: CAD file, 2016-10-07]
Solidworks/Enclosure/45 1100 flat bar.SLDPRT
1055.0 x 2.50 x 22.5 mm
