BadenMorgan/thesis/Solidworks/Feed Up/Key.SLDPRT

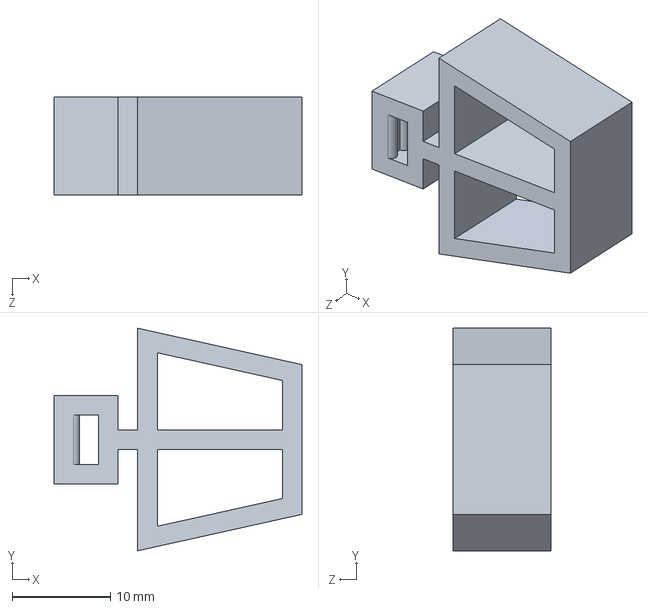
[picture p182: CAD file, 2016-09-21]
Solidworks/Feed Up/Key.SLDPRT
25.2 x 22.6 x 10.0 mm
