BadenMorgan/thesis/Solidworks/part models/16x2-character-lcd-display-1.snapshot.2/LCD_PCB.SLDPRT

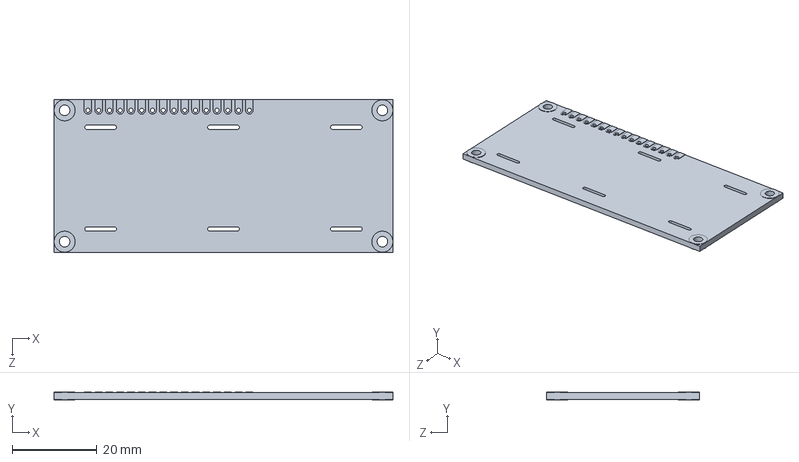
[picture p183: CAD file, 2016-09-05]
Solidworks/part models/16x2-character-lcd-display-1.snapshot.2/LCD_PCB.SLDPRT
80.0 x 1.80 x 36.0 mm
