BadenMorgan/thesis/Solidworks/part models/stepper-motor-nema-17.snapshot.17/Cuerpo.SLDPRT

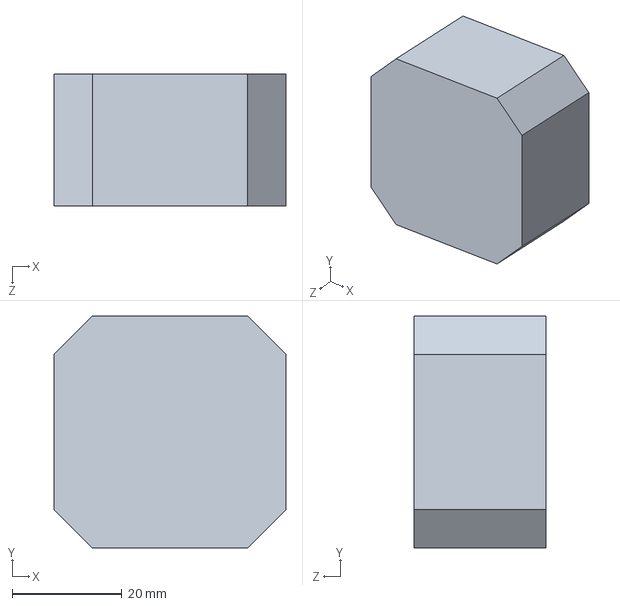
[picture p184: CAD file, 2016-10-07]
Solidworks/part models/stepper-motor-nema-17.snapshot.17/Cuerpo.SLDPRT
42.3 x 42.3 x 24.0 mm
