BadenMorgan/thesis/Solidworks/RFID Reader Holder/Middle plate.SLDPRT

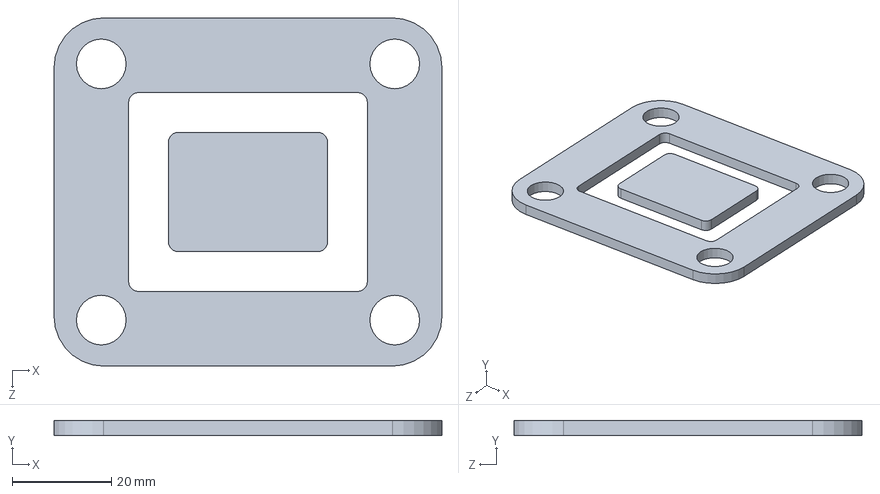
[picture p185: CAD file, 2016-09-05]
Solidworks/RFID Reader Holder/Middle plate.SLDPRT
78.0 x 3.00 x 70.0 mm
