BadenMorgan/thesis/Solidworks/roller 2/dip 20/top plate dip 20.SLDPRT

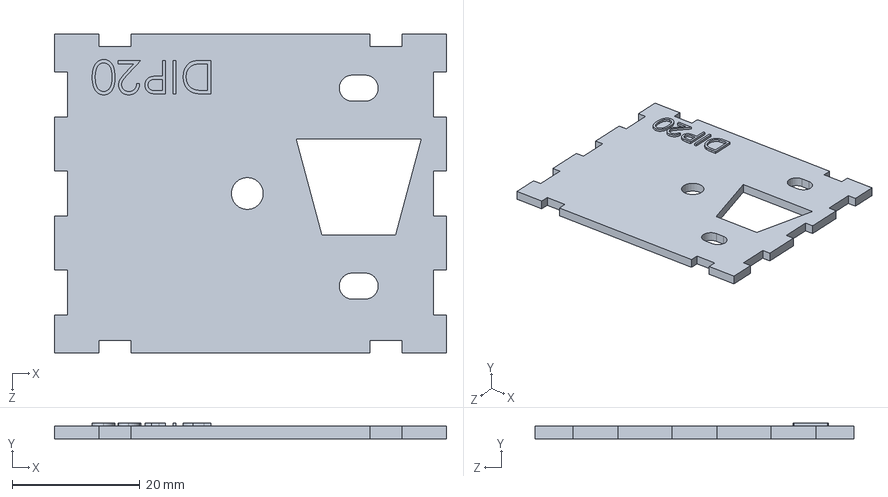
[picture p186: CAD file, 2016-08-29]
Solidworks/roller 2/dip 20/top plate dip 20.SLDPRT
61.4 x 2.50 x 50.0 mm
