BadenMorgan/thesis/Solidworks/Enclosure/Angled drop plate ali.SLDPRT

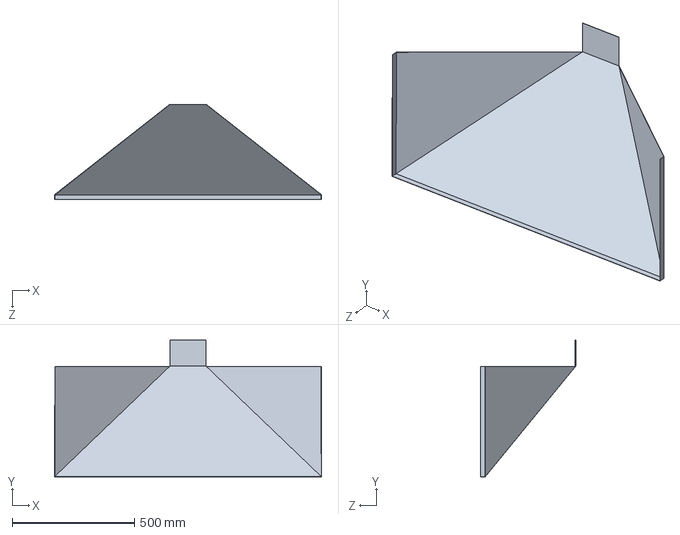
[picture p187: CAD file, 2016-10-07]
Solidworks/Enclosure/Angled drop plate ali.SLDPRT
1090.0 x 557.4 x 389.6 mm
