BadenMorgan/thesis/Solidworks/Feed Up/timing gear.SLDPRT

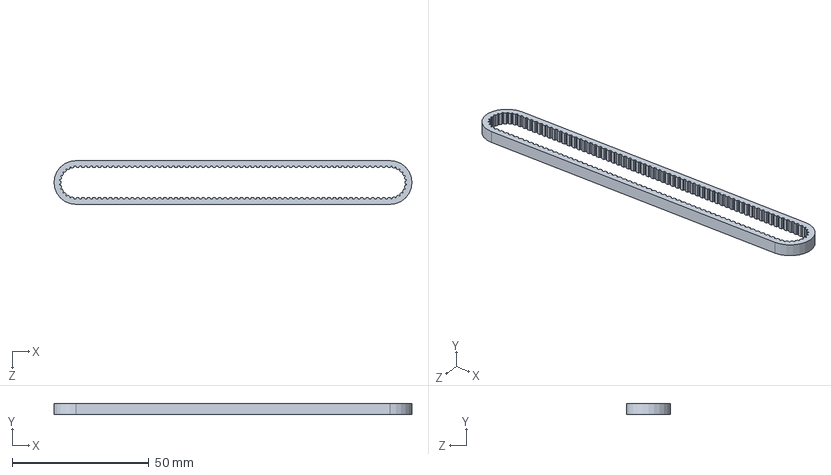
[picture p188: CAD file, 2016-09-21]
Solidworks/Feed Up/timing gear.SLDPRT
131.0 x 4.00 x 16.0 mm
