BadenMorgan/thesis/Solidworks/roller 2/dip 20/part plate dip20.SLDPRT

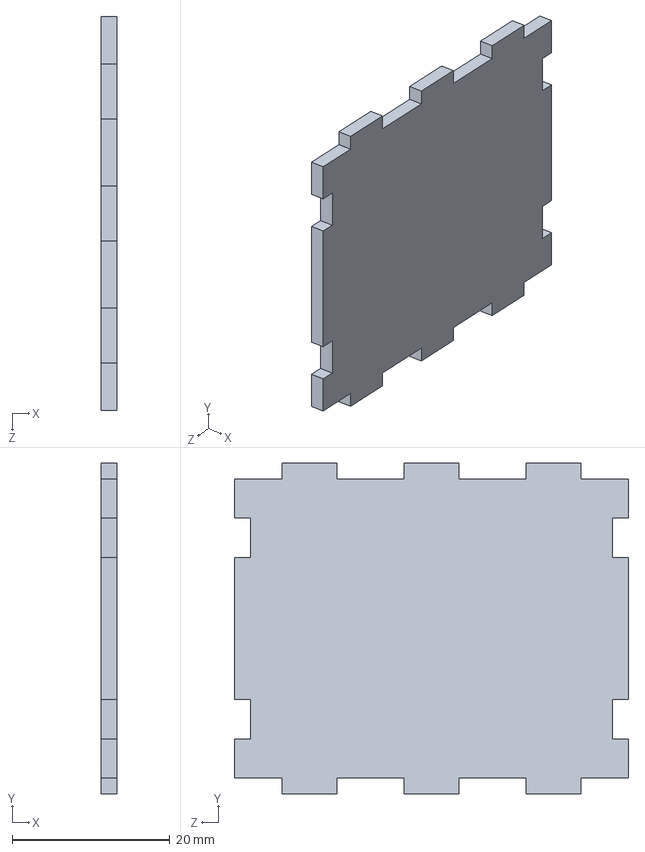
[picture p189: CAD file, 2016-08-23]
Solidworks/roller 2/dip 20/part plate dip20.SLDPRT
2.00 x 42.0 x 50.0 mm
