BadenMorgan/thesis/Solidworks/roller 2/dip14.16/brace1.SLDPRT

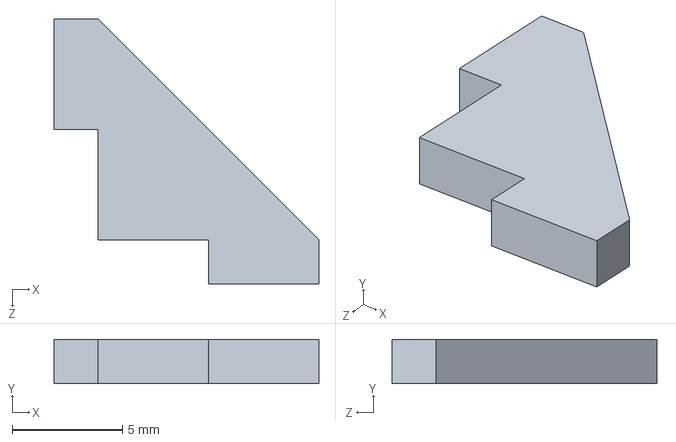
[picture p190: CAD file, 2016-08-23]
Solidworks/roller 2/dip14.16/brace1.SLDPRT
12.0 x 2.00 x 12.0 mm
