BadenMorgan/thesis/Solidworks/Enclosure/angled drop plate simple.SLDPRT

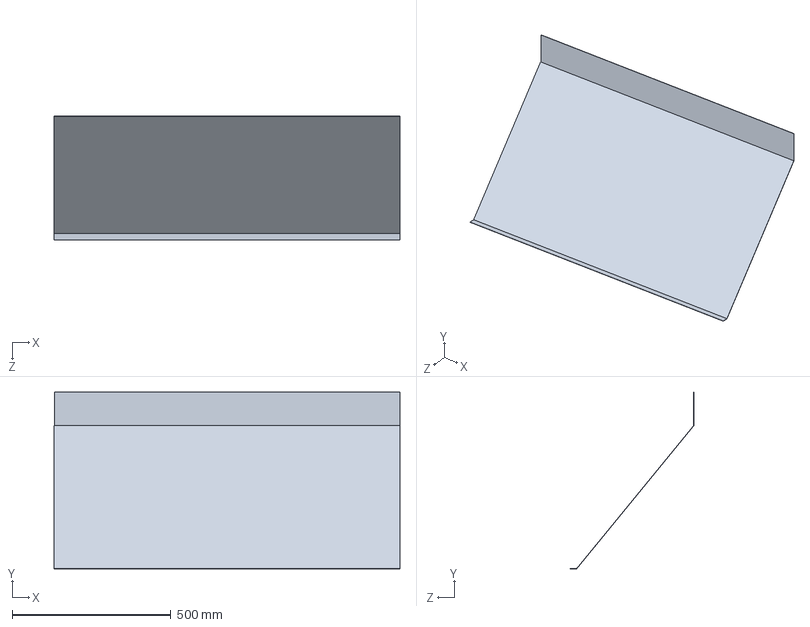
[picture p191: CAD file, 2016-10-07]
Solidworks/Enclosure/angled drop plate simple.SLDPRT
1090.0 x 557.4 x 389.6 mm
