BadenMorgan/thesis/Solidworks/part models/16x2-character-lcd-display-1.snapshot.2/conductors.SLDPRT

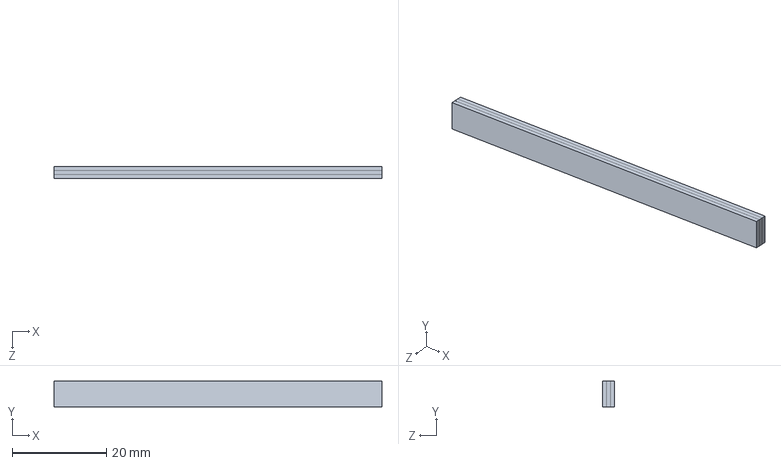
[picture p192: CAD file, 2016-09-05]
Solidworks/part models/16x2-character-lcd-display-1.snapshot.2/conductors.SLDPRT
69.7 x 5.50 x 2.50 mm
