BadenMorgan/thesis/Solidworks/part models/stepper2/NEMA 17 with T5 Pulley.STEP

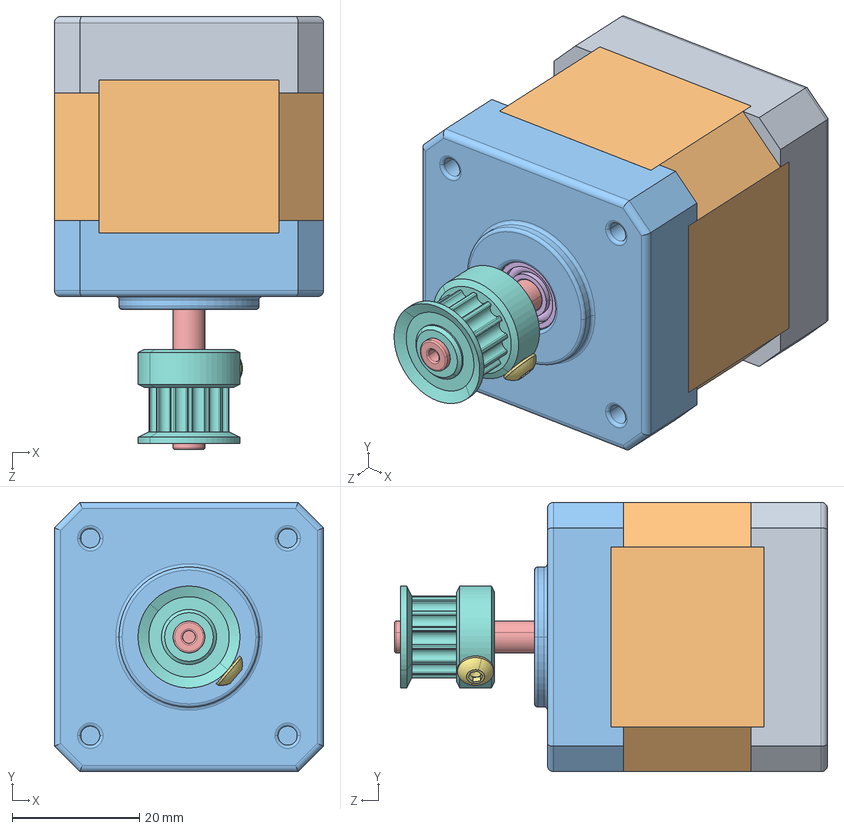
[picture p193: CAD file, 2016-10-07]
Solidworks/part models/stepper2/NEMA 17 with T5 Pulley.STEP
42.3 x 42.3 x 68.0 mm
Base
Cuerpo
Tapa
pan cross head_am_B18.6.7M - M3 x 0.5 x 5 Type I Cross Recessed PHMS --5N x 4
Eje
instrument ball bearing_68_am_AFBMA 12.1.4.1 - 0050-11 - 10,SI,NC,10_68 x 2
socket button head cap screw_am_B18.3.4M - 3 x 0.5 x 5 SBHCS --N
T5 Pulley
