BadenMorgan/thesis/Solidworks/roller 2/dip 20/base plate 2.SLDPRT

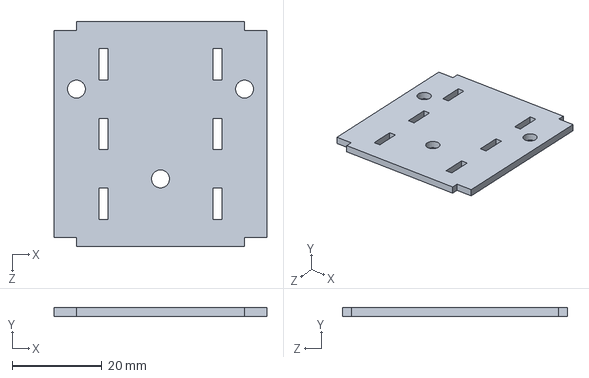
[picture p194: CAD file, 2016-08-19]
Solidworks/roller 2/dip 20/base plate 2.SLDPRT
47.4 x 2.00 x 50.0 mm
