BadenMorgan/thesis/Solidworks/roller 2/dip14.16/part plate dip 14 or 16.SLDPRT

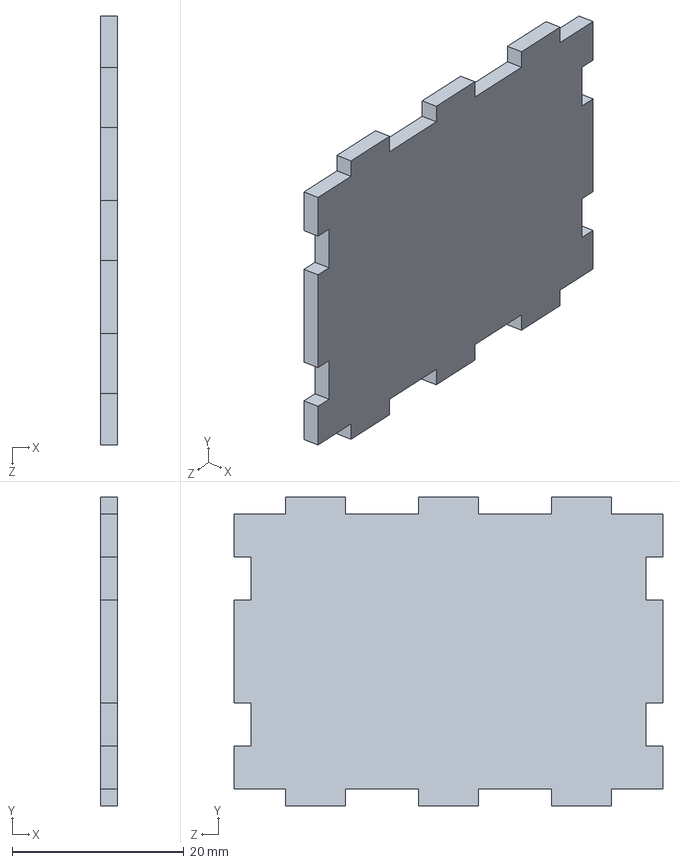
[picture p195: CAD file, 2016-08-23]
Solidworks/roller 2/dip14.16/part plate dip 14 or 16.SLDPRT
2.00 x 36.0 x 50.0 mm
