BadenMorgan/thesis/Solidworks/Enclosure/tube.SLDPRT

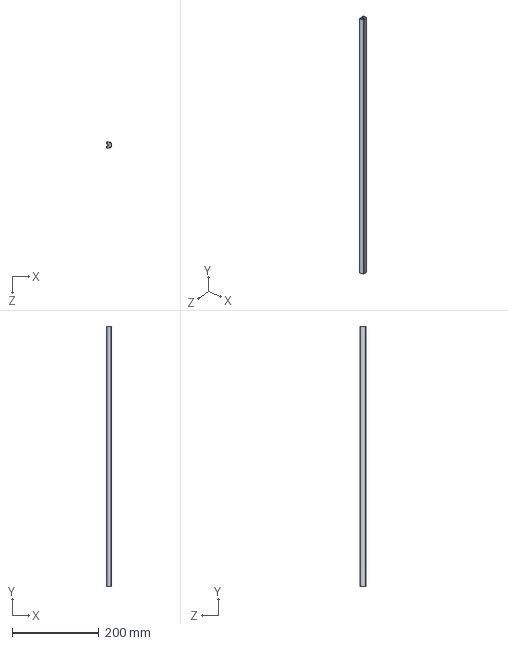
[picture p196: CAD file, 2016-10-07]
Solidworks/Enclosure/tube.SLDPRT
10.5 x 600.0 x 14.5 mm
