BadenMorgan/thesis/Solidworks/roller 2/dip 20/stop plate.SLDPRT

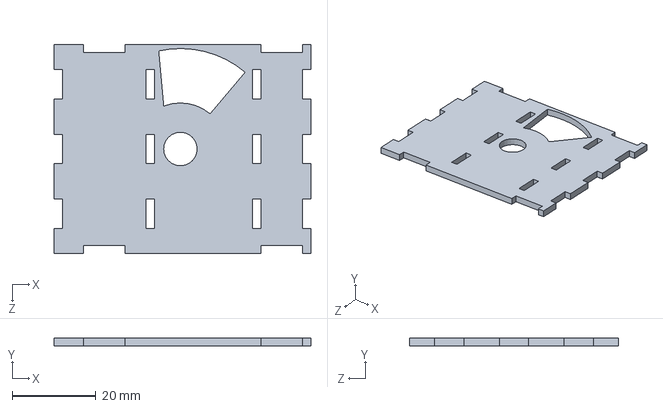
[picture p197: CAD file, 2016-08-19]
Solidworks/roller 2/dip 20/stop plate.SLDPRT
61.4 x 2.00 x 50.0 mm
