BadenMorgan/thesis/Solidworks/roller 2/dip14.16/angled plate.SLDPRT

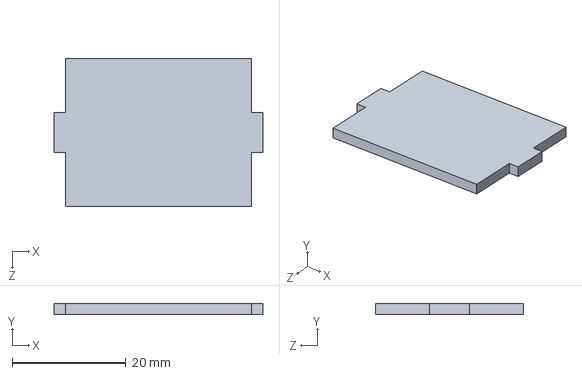
[picture p198: CAD file, 2016-08-23]
Solidworks/roller 2/dip14.16/angled plate.SLDPRT
36.7 x 2.00 x 26.0 mm
