BadenMorgan/thesis/Solidworks/Enclosure/angled plate flat simple.SLDPRT

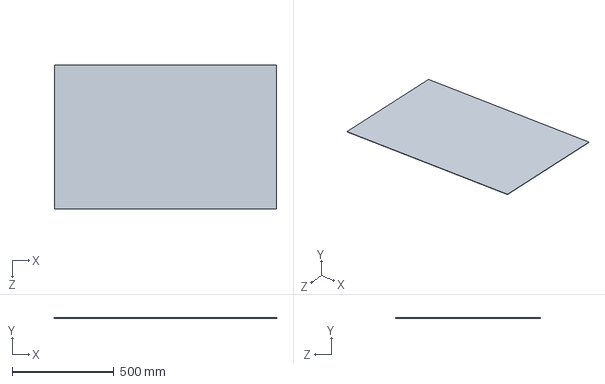
[picture p199: CAD file, 2016-10-07]
Solidworks/Enclosure/angled plate flat simple.SLDPRT
1089.0 x 2.00 x 708.0 mm
