BadenMorgan/thesis/Solidworks/roller 2/dip 20/Component Roller 2.SLDPRT

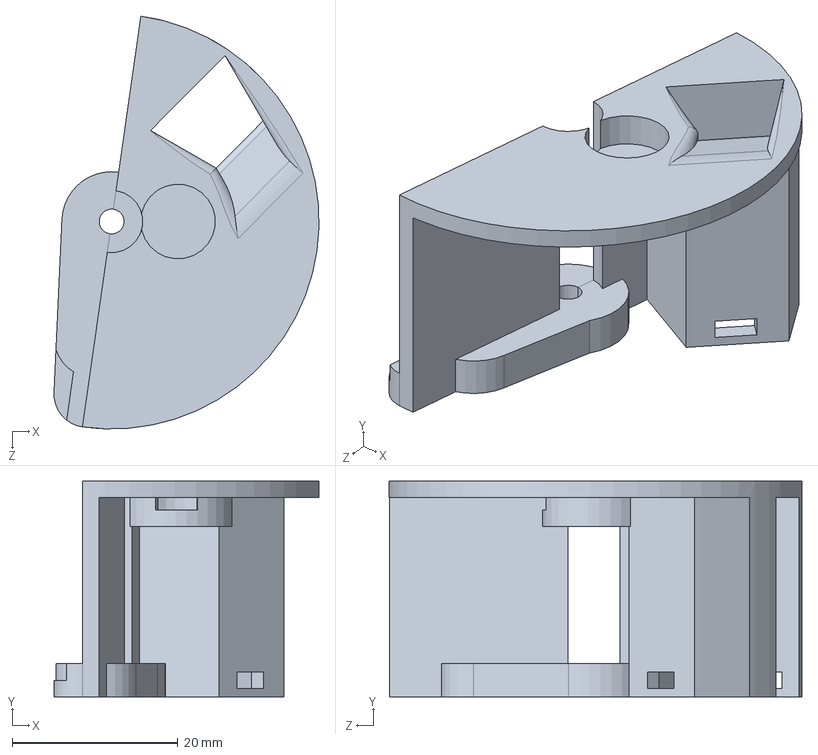
[picture p200: CAD file, 2016-08-19]
Solidworks/roller 2/dip 20/Component Roller 2.SLDPRT
31.9 x 26.0 x 49.7 mm
