BadenMorgan/thesis/Solidworks/roller 2/dip 8/stop plate.SLDPRT

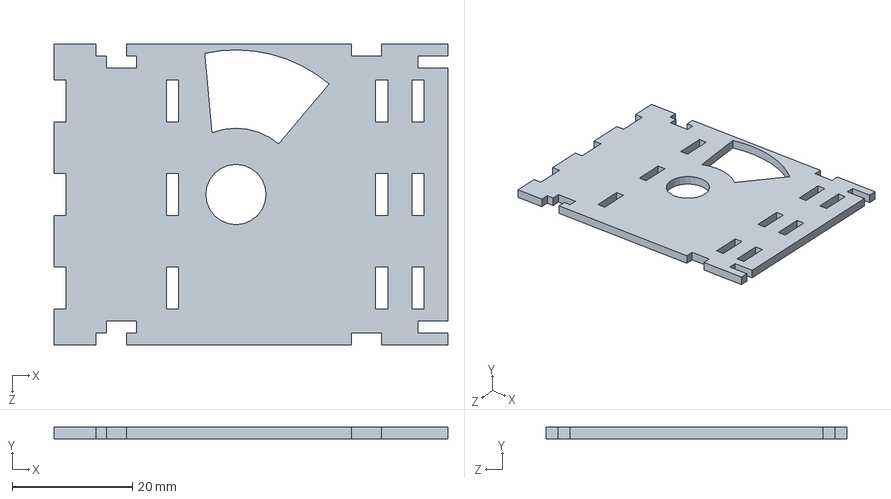
[picture p201: CAD file, 2016-09-05]
Solidworks/roller 2/dip 8/stop plate.SLDPRT
65.4 x 2.00 x 50.0 mm
