BadenMorgan/thesis/Solidworks/Enclosure/Angled drop flat for dimensions.SLDPRT

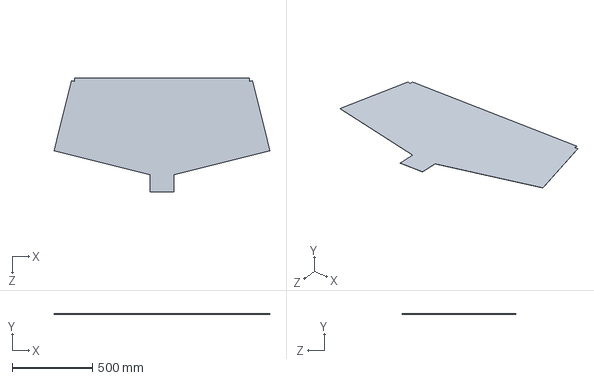
[picture p202: CAD file, 2016-09-21]
Solidworks/Enclosure/Angled drop flat for dimensions.SLDPRT
1344.2 x 1.00 x 706.6 mm
