BadenMorgan/thesis/Solidworks/roller 2/dip 8/part plate dip 8.SLDPRT

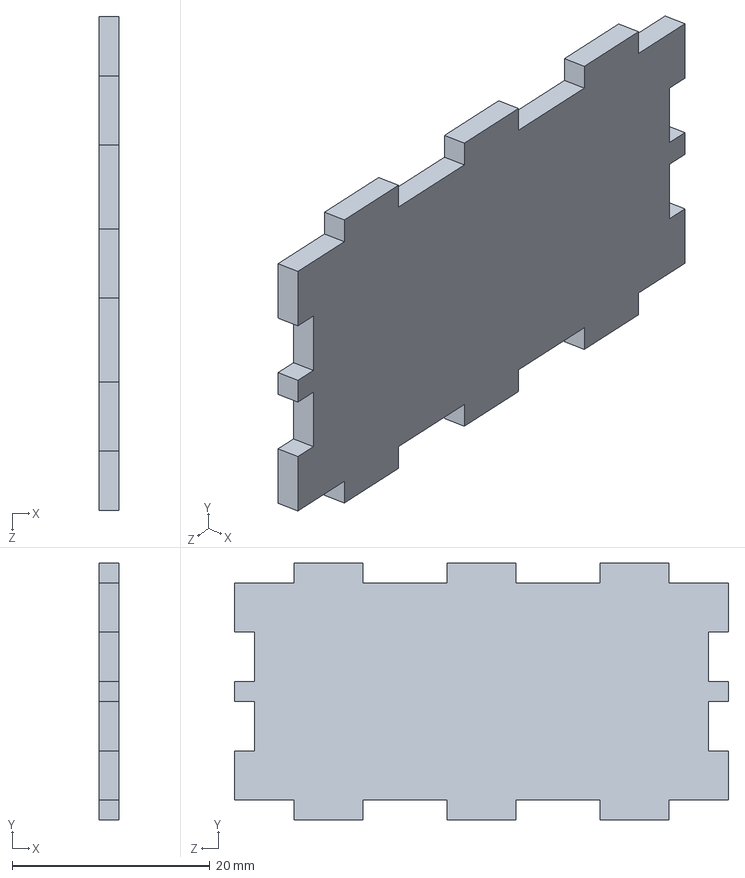
[picture p203: CAD file, 2016-09-05]
Solidworks/roller 2/dip 8/part plate dip 8.SLDPRT
2.00 x 26.0 x 50.0 mm
