BadenMorgan/thesis/Solidworks/Enclosure/James.SLDPRT

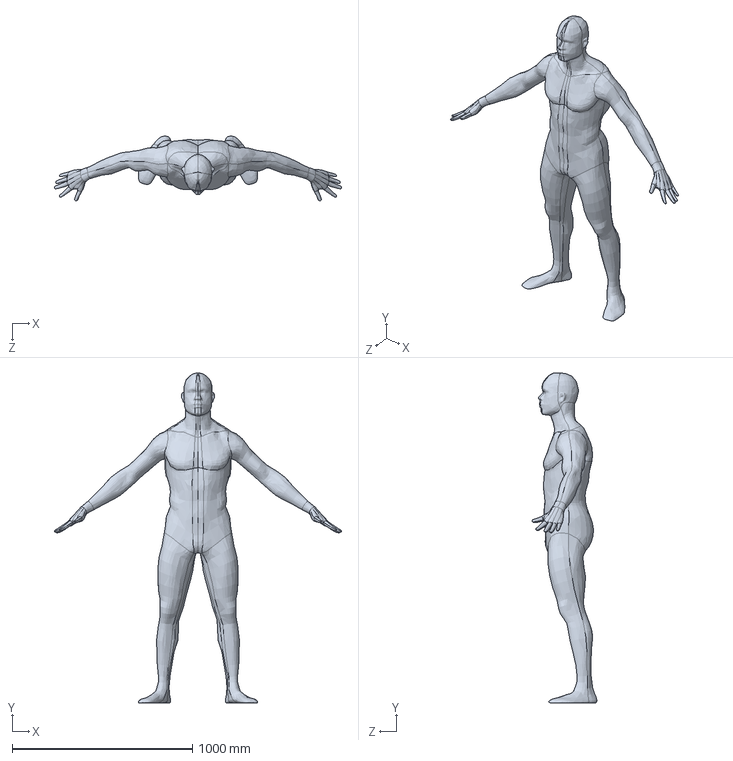
[picture p204: CAD file, 2016-09-16]
Solidworks/Enclosure/James.SLDPRT
1592.3 x 1829.4 x 359.3 mm
