BadenMorgan/thesis/Solidworks/roller 2/dip14.16/Component Roller 2.SLDPRT

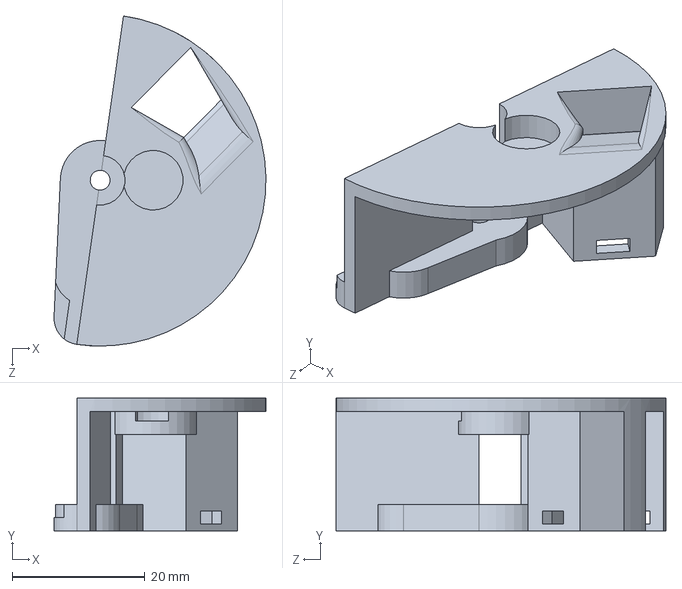
[picture p205: CAD file, 2016-08-19]
Solidworks/roller 2/dip14.16/Component Roller 2.SLDPRT
31.9 x 20.0 x 49.7 mm
