BadenMorgan/thesis/Solidworks/Enclosure/a1 side plate.SLDPRT

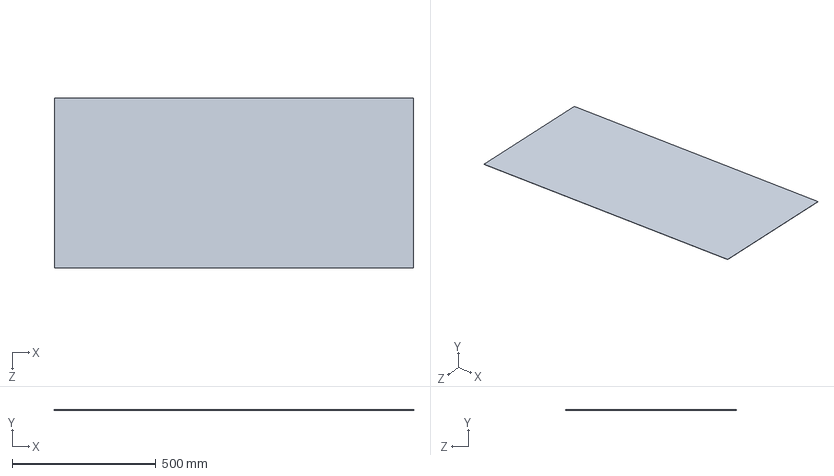
[picture p206: CAD file, 2016-09-16]
Solidworks/Enclosure/a1 side plate.SLDPRT
1250.0 x 1.00 x 593.0 mm
