BadenMorgan/thesis/Solidworks/roller 2/dip 20/angled plate.SLDPRT

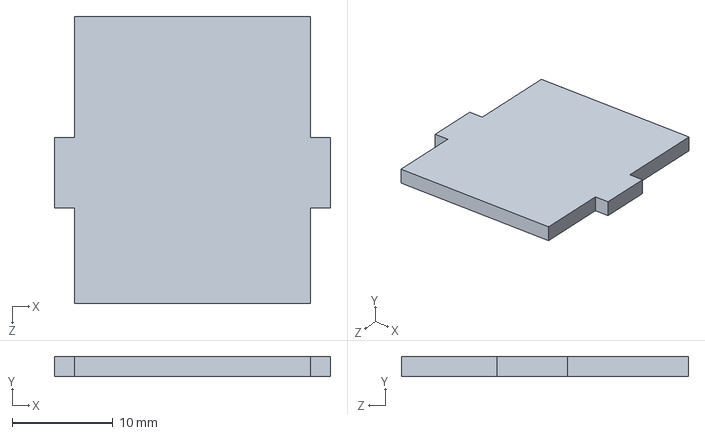
[picture p207: CAD file, 2016-08-19]
Solidworks/roller 2/dip 20/angled plate.SLDPRT
27.4 x 2.00 x 28.5 mm
