BadenMorgan/thesis/Solidworks/Enclosure/a1 front plate.SLDPRT

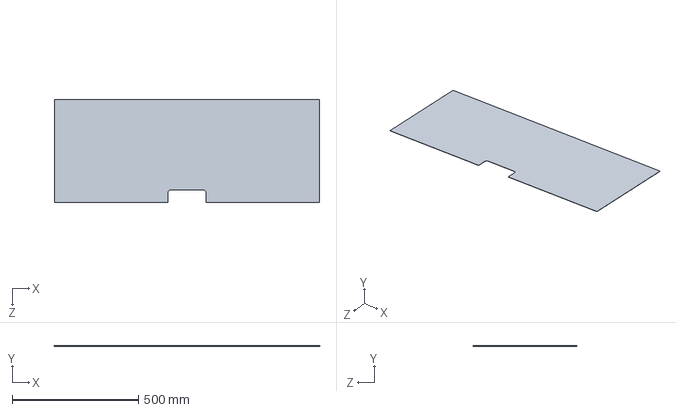
[picture p208: CAD file, 2016-09-16]
Solidworks/Enclosure/a1 front plate.SLDPRT
1050.0 x 1.00 x 409.5 mm
