BadenMorgan/thesis/Solidworks/Enclosure/L Beam 1300 straight.SLDPRT

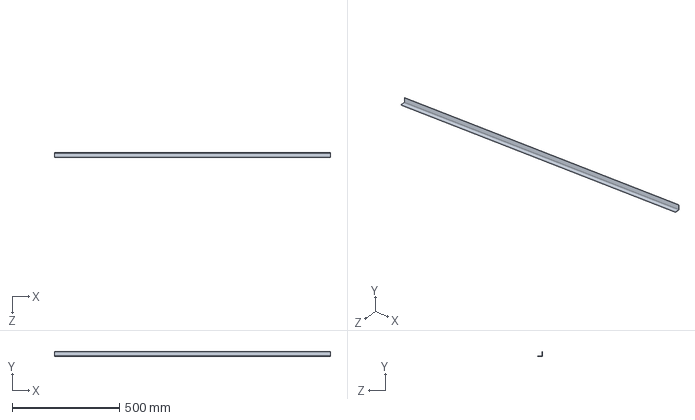
[picture p209: CAD file, 2016-09-16]
Solidworks/Enclosure/L Beam 1300 straight.SLDPRT
1288.0 x 22.5 x 22.5 mm
