BadenMorgan/thesis/Solidworks/Enclosure/PSU Mock up.SLDPRT

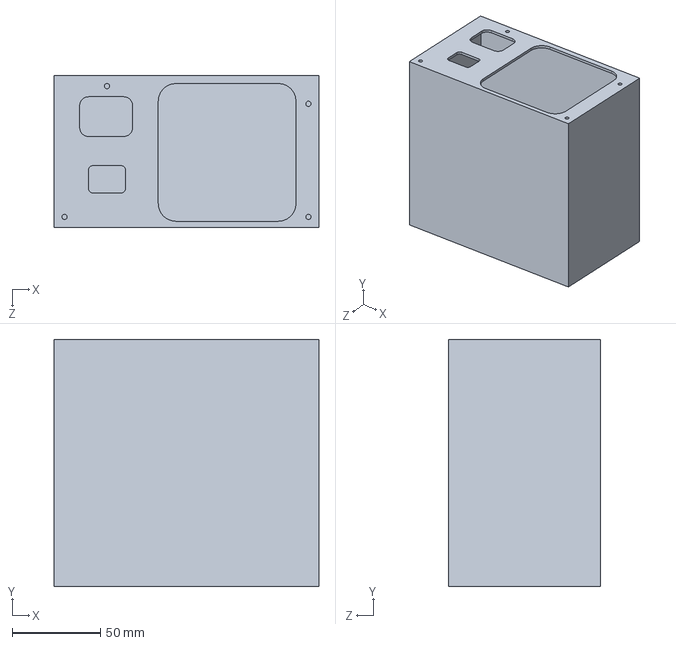
[picture p210: CAD file, 2016-09-05]
Solidworks/Enclosure/PSU Mock up.SLDPRT
150.0 x 140.0 x 86.0 mm
