BadenMorgan/thesis/Solidworks/Enclosure/L Beam 575.SLDPRT

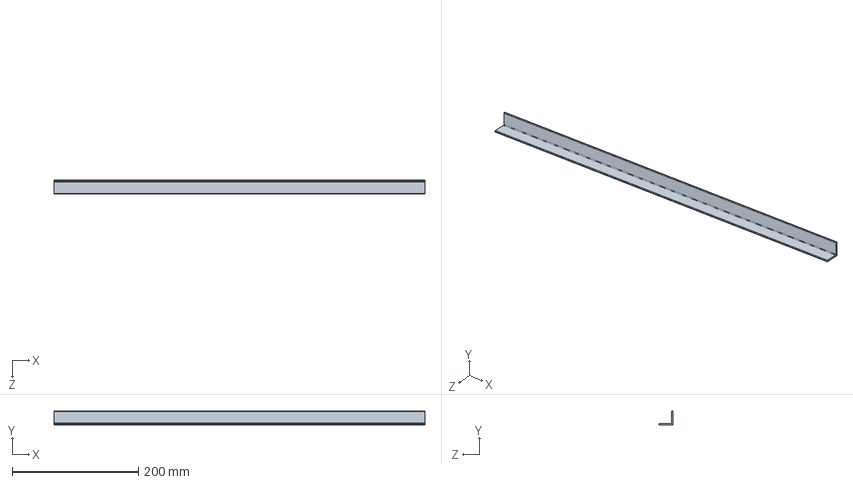
[picture p211: CAD file, 2016-09-05]
Solidworks/Enclosure/L Beam 575.SLDPRT
588.0 x 22.5 x 22.5 mm
