BadenMorgan/thesis/Solidworks/Enclosure/1088 flat bar.SLDPRT

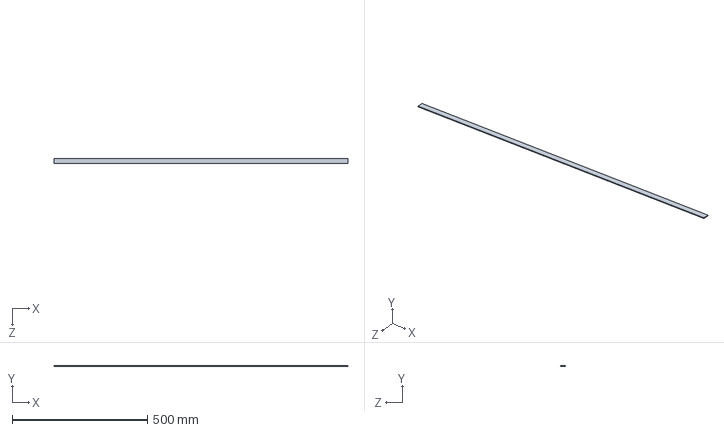
[picture p212: CAD file, 2016-09-05]
Solidworks/Enclosure/1088 flat bar.SLDPRT
1088.0 x 2.50 x 20.0 mm
