BadenMorgan/thesis/Solidworks/Enclosure/Template L Beam.SLDPRT

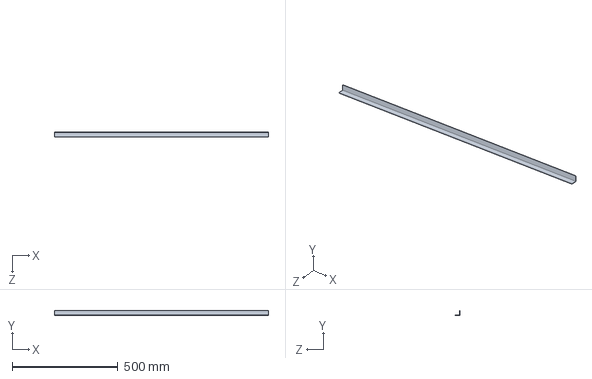
[picture p213: CAD file, 2016-09-05]
Solidworks/Enclosure/Template L Beam.SLDPRT
1010.0 x 22.5 x 22.5 mm
