BadenMorgan/thesis/Solidworks/Enclosure/L Beam bucket side left.SLDPRT

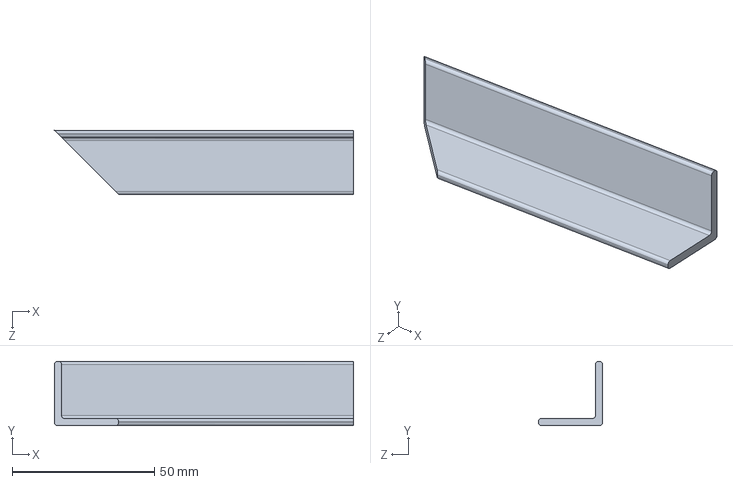
[picture p214: CAD file, 2016-09-05]
Solidworks/Enclosure/L Beam bucket side left.SLDPRT
105.0 x 22.5 x 22.5 mm
