BadenMorgan/thesis/Solidworks/Enclosure/wood slim wall.SLDPRT

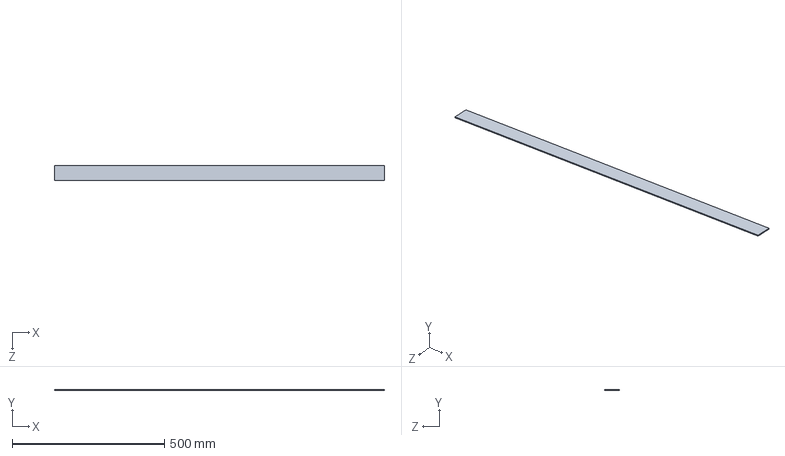
[picture p215: CAD file, 2016-09-05]
Solidworks/Enclosure/wood slim wall.SLDPRT
1083.0 x 3.00 x 50.0 mm
