BadenMorgan/thesis/Solidworks/Enclosure/600 flat bar.SLDPRT

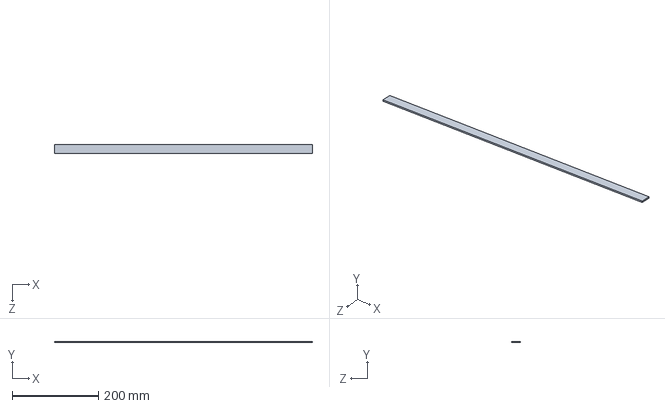
[picture p216: CAD file, 2016-09-05]
Solidworks/Enclosure/600 flat bar.SLDPRT
600.0 x 3.00 x 20.0 mm
