BadenMorgan/thesis/Solidworks/Enclosure/Template L Beam 45cut.SLDPRT

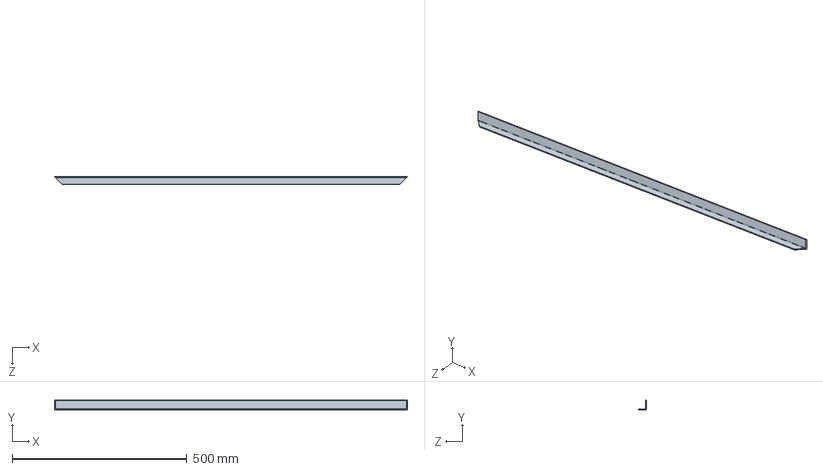
[picture p217: CAD file, 2016-09-05]
Solidworks/Enclosure/Template L Beam 45cut.SLDPRT
1010.0 x 27.5 x 22.5 mm
