BadenMorgan/thesis/Solidworks/Enclosure/a1 top plate.SLDPRT

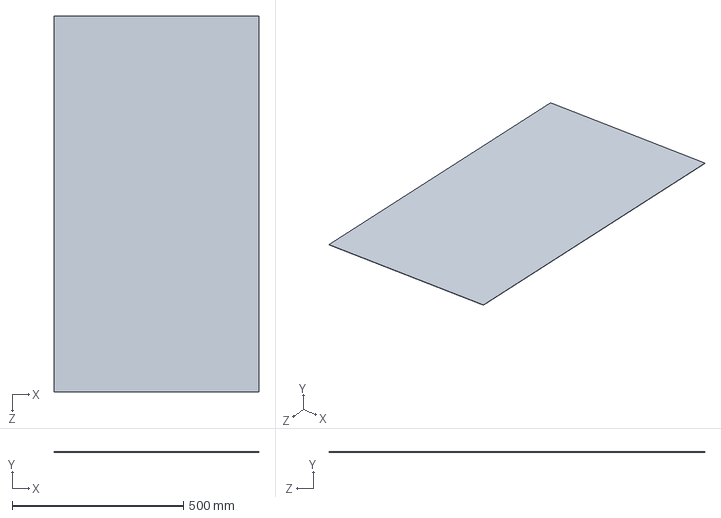
[picture p218: CAD file, 2016-09-05]
Solidworks/Enclosure/a1 top plate.SLDPRT
598.0 x 1.00 x 1098.0 mm
