BadenMorgan/thesis/Solidworks/Enclosure/wood plank.SLDPRT

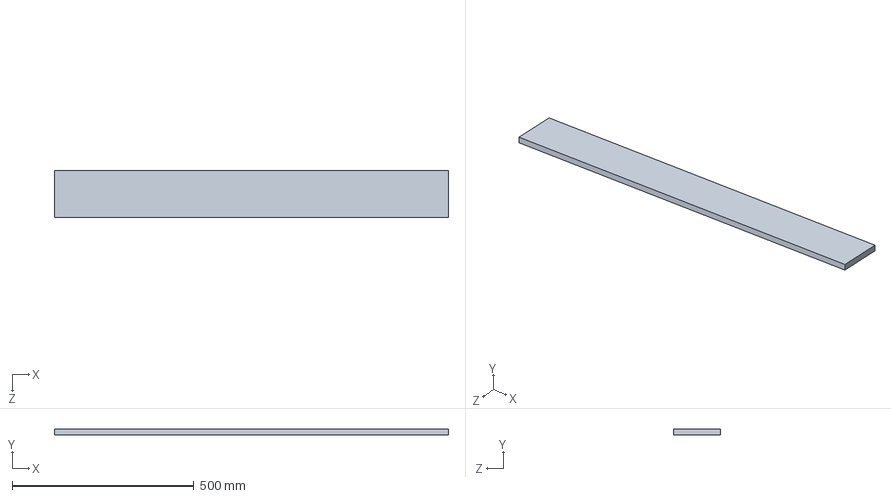
[picture p219: CAD file, 2016-09-05]
Solidworks/Enclosure/wood plank.SLDPRT
1083.0 x 17.0 x 128.0 mm
