BadenMorgan/thesis/Solidworks/Enclosure/L Beam 600 45cut.SLDPRT

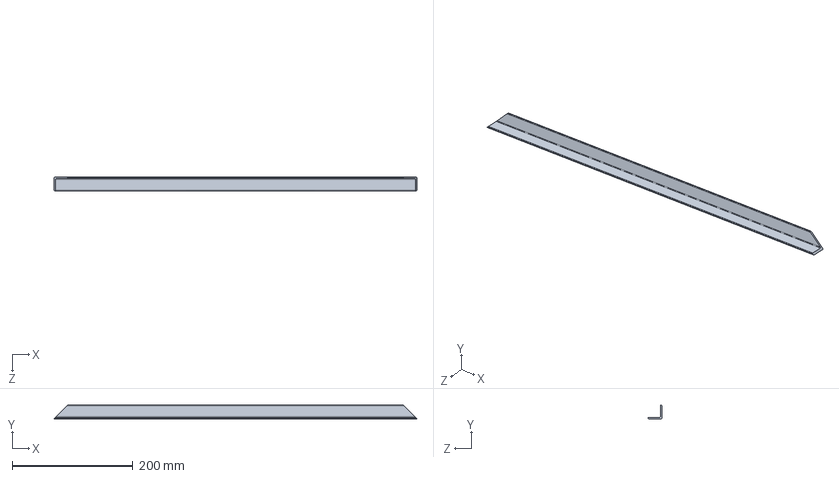
[picture p220: CAD file, 2016-09-05]
Solidworks/Enclosure/L Beam 600 45cut.SLDPRT
600.0 x 22.5 x 22.5 mm
