BadenMorgan/thesis/Solidworks/Enclosure/L Beam bucket front.SLDPRT

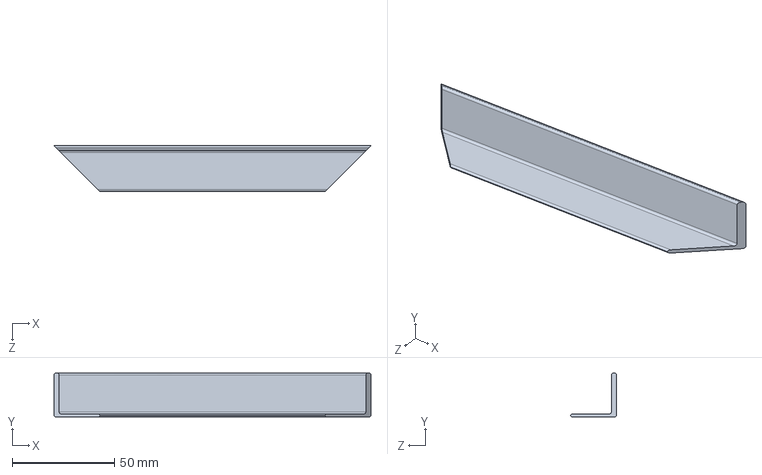
[picture p221: CAD file, 2016-09-05]
Solidworks/Enclosure/L Beam bucket front.SLDPRT
155.0 x 21.5 x 22.5 mm
