BadenMorgan/thesis/Solidworks/Enclosure/L Beam bottom front.SLDPRT

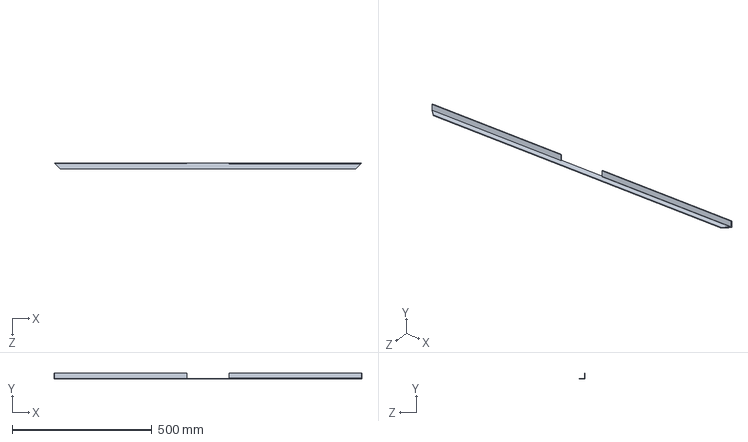
[picture p222: CAD file, 2016-09-05]
Solidworks/Enclosure/L Beam bottom front.SLDPRT
1100.0 x 22.5 x 22.5 mm
