BadenMorgan/thesis/(list of files, cad)

Other CAD files:
Solidworks/roller 2/IC holder dip 14 or 16/idea 2 dip 14 or 16.SLDASM
Solidworks/roller 2/IC holder dip 20/idea 2 dip 20.SLDASM
Solidworks/part models/stepper2/NEMA 17.SLDASM
Solidworks/part models/pulley-gt2-20-teeth-5mm-bore-1.snapshot.8/Renderings/GT2_20tooth.IGS
Solidworks/part models/User Library-DIP16-22mm/User Library-DIP16-22mm_DIP16_22mm.sldprt
Deliver Mechanism model/STL 3D Models/Component Roller dip20.STL
Solidworks/roller 2/IC holder dip 14 or 16/top plate dip 14 or 16 ic holder.SLDPRT
Solidworks/part models/pulley-gt2-20-teeth-5mm-bore-1.snapshot.8/GT2_20tooth.SLDPRT
Solidworks/part models/User Library-DIP16-22mm/User Library-DIP16-22mm_DIP16_22mm001.sldprt
Solidworks/RFID Reader Holder/bottom plate.SLDPRT
Solidworks/roller 2/dip 20/Component Roller dip20.SLDPRT
Solidworks/roller 2/dip14.16/Component Roller dip 16 or 14.SLDPRT
Solidworks/roller 2/IC holder dip 20/Component Roller dip 20 ic holder.SLDPRT
Solidworks/roller 2/IC holder dip 8/top plate dip 8 ic holder.SLDPRT
Solidworks/roller 2/dip 8/guide.SLDPRT
Solidworks/roller 2/dip14.16/top plate dip 14 or 16.SLDPRT
Solidworks/roller 2/IC holder dip 20/Component Roller dip 14 or 16 ic holder.SLDPRT
Deliver Mechanism model/STL 3D Models/Component Roller dip 14 or 16 ic holder.STL
Solidworks/part models/stepper2/Base.SLDPRT
Solidworks/RFID Reader Holder/top plate.SLDPRT
Solidworks/roller 2/dip 8/Component Roller dip8.SLDPRT
Deliver Mechanism model/STL 3D Models/guide ic holder.STL
Solidworks/part models/stepper-motor-nema-17.snapshot.17/Eje.SLDPRT
Solidworks/roller 2/dip 8/brace1.SLDPRT
Deliver Mechanism model/STL 3D Models/Component Roller dip8.STL
Solidworks/roller 2/dip 8/top plate dip 8.SLDPRT
Deliver Mechanism model/STL 3D Models/guide.STL
Solidworks/part models/stepper2/Cuerpo.SLDPRT
Solidworks/roller 2/dip14.16/stop plate.SLDPRT
Solidworks/part models/stepper-motor-nema-17.snapshot.17/Tapa.SLDPRT
Solidworks/roller 2/dip 20/part plate.SLDPRT
Solidworks/roller 2/dip 8/angled plate.SLDPRT
Solidworks/roller 2/dip14.16/base plate 2.SLDPRT
Solidworks/roller 2/dip 20/brace1.SLDPRT
Solidworks/roller 2/dip14.16/part plate.SLDPRT
Solidworks/roller 2/dip 20/top plate 2.SLDPRT
Solidworks/roller 2/dip 8/top plate 2.SLDPRT
Solidworks/roller 2/dip 8/Component Roller 2.SLDPRT
Solidworks/roller 2/dip14.16/top plate 2.SLDPRT
Solidworks/roller 2/dip 8/part plate.SLDPRT
Solidworks/Enclosure/a1 back plate.SLDPRT
Solidworks/Enclosure/1093 flat bar.SLDPRT
Solidworks/Enclosure/1088 L beam.SLDPRT
Solidworks/Enclosure/L Beam bucket side right.SLDPRT
Solidworks/Enclosure/L Beam 1010 45cut.SLDPRT
Document/Pictures/archive pics/cover photo.SLDDRW
Solidworks/Archive/Drawings for document/ALL DIP HOLDERS.SLDDRW
Solidworks/Archive/Drawings for document/ALLROLLERS.SLDDRW
Solidworks/Archive/Drawings for document/Component Roller dip 14 or 16 ic holder.SLDDRW
Solidworks/Archive/Drawings for document/LASER TEMPLATES/laser tamplate dip 8.SLDDRW
Solidworks/Archive/Drawings for document/LASER TEMPLATES/laser tamplate dip14 or 16.SLDDRW
Solidworks/Archive/Drawings for document/LASER TEMPLATES/laser tamplate dip20.SLDDRW
Solidworks/Archive/Drawings for document/guide ic holder.SLDDRW
Solidworks/Archive/Drawings for document/guide.SLDDRW
Solidworks/Archive/drill template.SLDASM
Solidworks/Archive/drill template.SLDDRW
Solidworks/Archive/drill template.SLDPRT
Solidworks/Archive/roller/Component Roller.SLDPRT
Solidworks/Archive/roller/STL models/guide.STL
Solidworks/Archive/roller/Stand.SLDPRT
Solidworks/Archive/roller/angled plate.SLDPRT
Solidworks/Archive/roller/base plate.SLDPRT
Solidworks/Archive/roller/bracing1.SLDPRT
Solidworks/Archive/roller/bracing2.SLDPRT
Solidworks/Archive/roller/comparison.SLDASM
Solidworks/Archive/roller/guide.SLDPRT
Solidworks/Archive/roller/laser template.SLDDRW
Solidworks/Archive/roller/mock up.SLDASM
Solidworks/Archive/roller/servo plate.SLDPRT
Solidworks/Archive/roller/side plate.SLDPRT
Solidworks/Archive/roller/top plate.SLDPRT
Solidworks/Archive/vulkan/Part Diagram - Baden Morgan.DXF
Solidworks/Archive/wood piece.SLDPRT
Solidworks/Enclosure/1093 flat bar.SLDDRW
Solidworks/Enclosure/Drawings/Angled drop plate ali.SLDDRW
Solidworks/Enclosure/Drawings/Enclosure height comparison.SLDDRW
Solidworks/Enclosure/Drawings/Enclosure render.SLDDRW
Solidworks/Enclosure/Drawings/Vulcan.SLDDRW
Solidworks/Enclosure/Drawings/a1 back plate.SLDDRW
Solidworks/Enclosure/Drawings/a1 back platev2.SLDDRW
Solidworks/Enclosure/Drawings/a1 front door plate v2.SLDDRW
Solidworks/Enclosure/Drawings/a1 front door plate.SLDDRW
Solidworks/Enclosure/Drawings/a1 front plate.SLDDRW
Solidworks/Enclosure/Drawings/frame only.SLDDRW
Solidworks/Enclosure/Drawings/test design exploded.SLDDRW
Solidworks/Enclosure/Drawings/test design.SLDDRW
Solidworks/Enclosure/L Beam 1100 45cut - Copy.SLDPRT
Solidworks/Enclosure/L Beam 600 45cut - Copy.SLDPRT
Solidworks/Enclosure/drawings and request forms/Aluminium sheets v2 -2.SLDDRW
Solidworks/Enclosure/drawings and request forms/Aluminium sheets v2.SLDDRW
Solidworks/Enclosure/drawings and request forms/Aluminium sheets.SLDDRW
Solidworks/Enclosure/drawings and request forms/L Beam sheet v2.SLDDRW
Solidworks/Enclosure/drawings and request forms/L Beam sheet.SLDDRW
Solidworks/Enclosure/drawings and request forms/Steel bar sheet v2.SLDDRW
Solidworks/Enclosure/drawings and request forms/Steel bar sheet.SLDDRW
Solidworks/Enclosure/drawings and request forms/wood plank sheet.SLDDRW
Solidworks/Feed Up/comparison.SLDDRW
Solidworks/Feed Up/feed up comparison.SLDDRW
Solidworks/RFID Reader Holder/Laser template 1mm perspex.SLDDRW
Solidworks/RFID Reader Holder/RFID HOLDER.SLDDRW
Solidworks/RFID Reader Holder/laser template 3mm perspex.SLDDRW
Solidworks/RFID Reader Holder/request/1mm perspex.SLDDRW
Solidworks/RFID Reader Holder/request/3mm perspex.SLDDRW
Solidworks/part models/9hr servo/Tower Pro 9g Micro Servo SG90.SLDPRT
Solidworks/part models/DIP8/DIP8.IGS
Solidworks/part models/DIP8/DIP8.SLDDRW
Solidworks/part models/dip 14/DIL14.SLDPRT
Solidworks/part models/servo-hitec-hs-225-mg-1.snapshot.3/servo Hitec HS-225 MG.SLDPRT
Solidworks/part models/servo-hxt900-micro/Servo HXT900 Micro.SLDPRT
Solidworks/part models/servo-hxt900-micro/Servo HXT900 Micro.stl
Solidworks/part models/stepper-motor-nema-17.snapshot.17/NEMA 17 with T5 Pulley.SLDASM
Solidworks/part models/stepper-motor-nema-17.snapshot.17/NEMA 17 with T5 Pulley.STP
Solidworks/part models/stepper-motor-nema-17.snapshot.17/NEMA 17.STL
Solidworks/part models/stepper-motor-nema-17.snapshot.17/screw.SLDASM
Solidworks/part models/stepper2/NEMA 17 with T5 Pulley.SLDASM
Solidworks/part models/stepper2/NEMA 17 with T5 Pulley.STP
Solidworks/part models/stepper2/NEMA 17.STL
Solidworks/part models/turnigy-tgy-225mg-servo-1.snapshot.4/TGY-3225MG.SLDPRT
Solidworks/roller 2/IC holder dip 14 or 16/laser tamplate dip14 or 16 holder V2.SLDDRW
Solidworks/roller 2/IC holder dip 14 or 16/laser tamplate dip14 or 16 holder.SLDDRW
Solidworks/roller 2/IC holder dip 20/laser tamplate dip20 holder.SLDDRW
Solidworks/roller 2/IC holder dip 8/laser tamplate dip 8 holder.SLDDRW
Solidworks/roller 2/archive deprecated/Servo Update/Component Roller 2.SLDPRT
Solidworks/roller 2/archive deprecated/Servo Update/angled plate.SLDPRT
Solidworks/roller 2/archive deprecated/Servo Update/base plate 2.SLDPRT
Solidworks/roller 2/archive deprecated/Servo Update/brace1.SLDPRT
Solidworks/roller 2/archive deprecated/Servo Update/guide.SLDPRT
Solidworks/roller 2/archive deprecated/Servo Update/idea 2.SLDASM
Solidworks/roller 2/archive deprecated/Servo Update/laser tamplate.SLDDRW
Solidworks/roller 2/archive deprecated/Servo Update/part plate.SLDPRT
Solidworks/roller 2/archive deprecated/Servo Update/servo hold.SLDASM
Solidworks/roller 2/archive deprecated/Servo Update/servo hold.SLDPRT
Solidworks/roller 2/archive deprecated/Servo Update/stop plate.SLDPRT
Solidworks/roller 2/archive deprecated/Servo Update/top plate 2.SLDPRT
Solidworks/roller 2/archive deprecated/dip 20/brace1.SLDPRT
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
