BadenMorgan/thesis/Document/Pictures/guide1.JPG

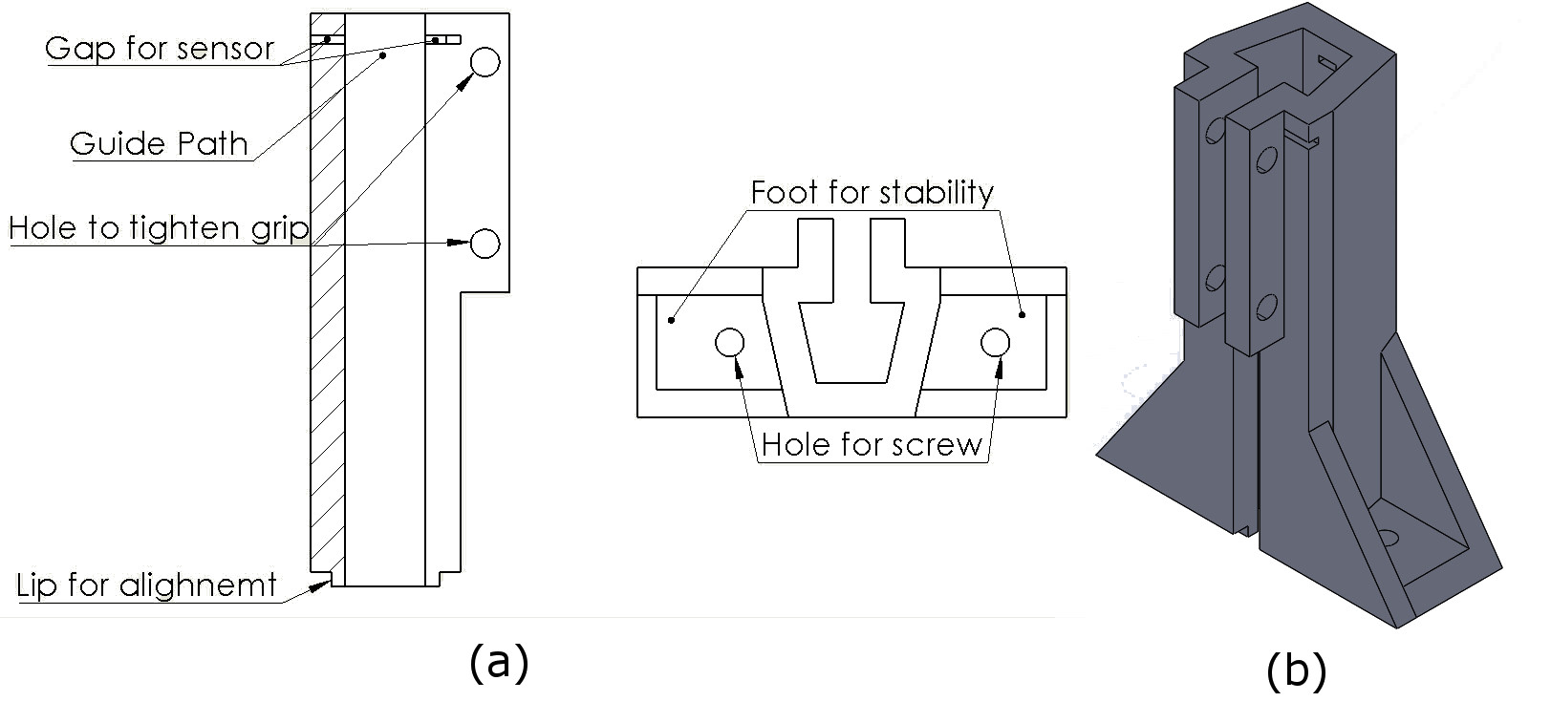
Document/Pictures/guide1.JPG
