BadenMorgan/thesis/Document/Pictures/guide2.JPG

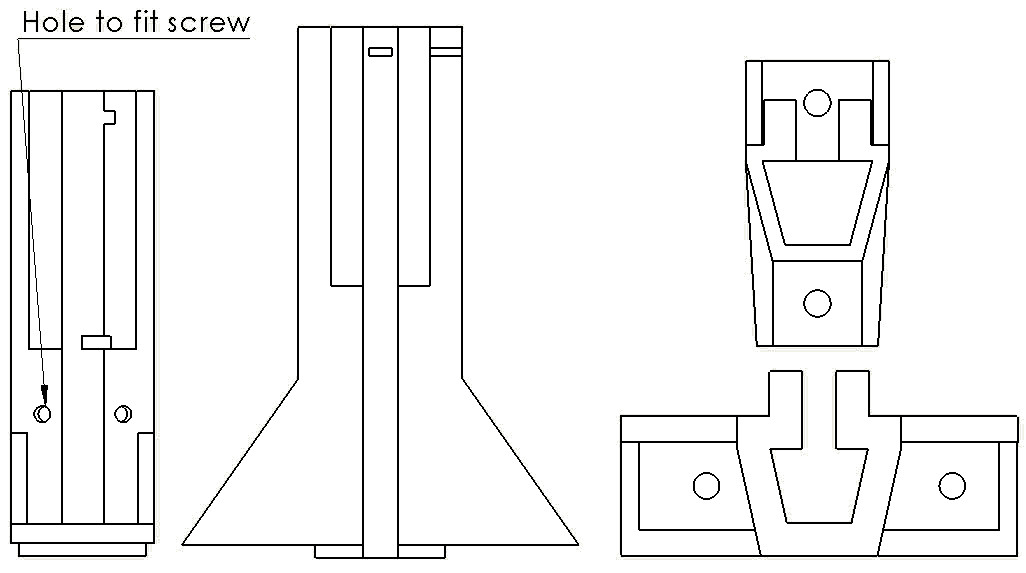
Document/Pictures/guide2.JPG
