BadenMorgan/thesis/Document/Pictures/guide3.JPG

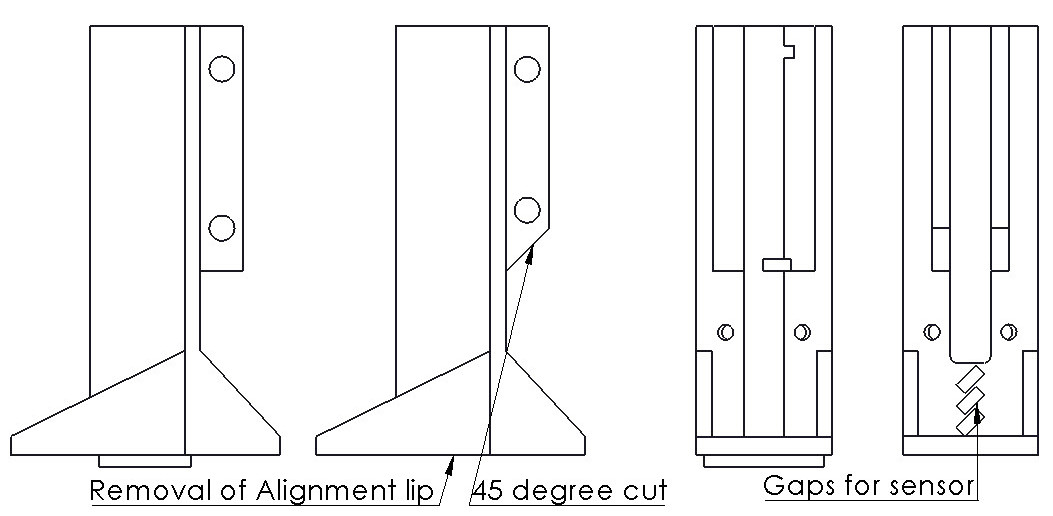
Document/Pictures/guide3.JPG
