BadenMorgan/thesis/Document/Pictures/guide4.JPG

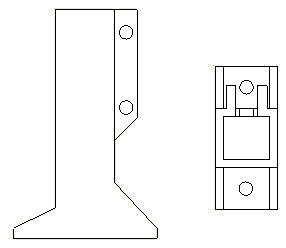
Document/Pictures/guide4.JPG
