BadenMorgan/thesis/Document/Pictures/guidedet.JPG

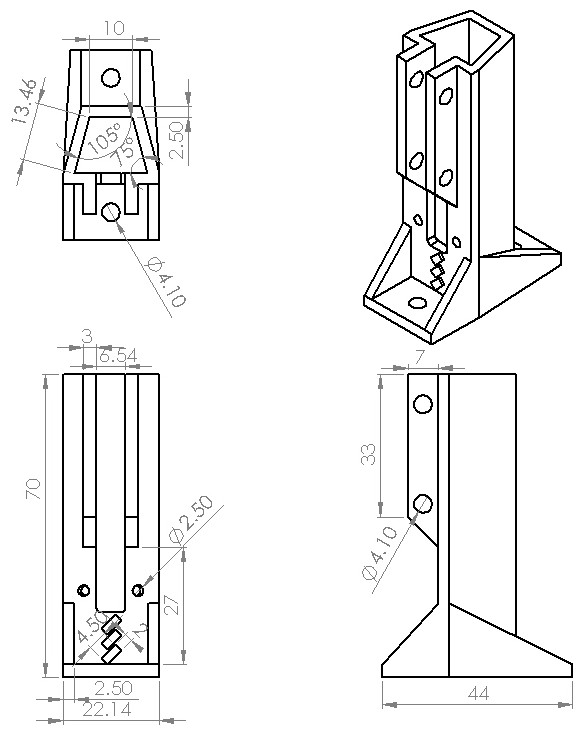
Document/Pictures/guidedet.JPG
