BadenMorgan/thesis/Circuit/MCU Module/MCU_Module V3 sch.pdf

3V3 3V3

A

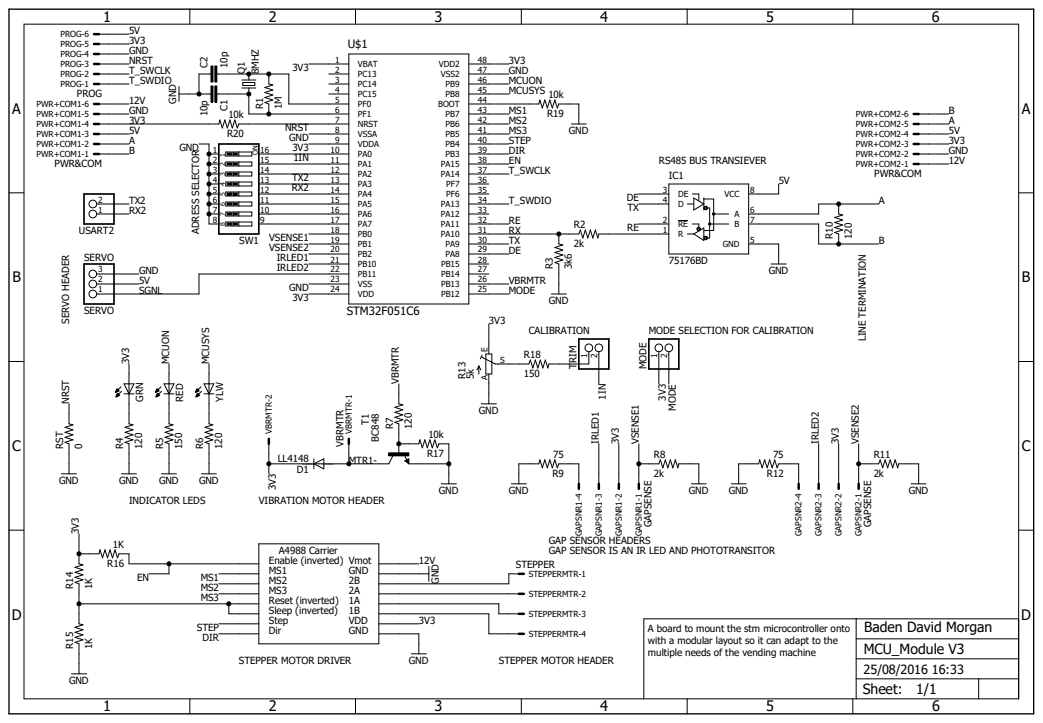
[picture p228: page 1]

3 | 14
5 | RX2 12 | PA3 13 PA4 14 PA5 15

A board to mount the stm microcontroller onto
with a modular layout so it can adapt to the
multiple needs of the vending machine
