BadenMorgan/thesis/Circuit/MCU Module/MCU_Module V3.pdf

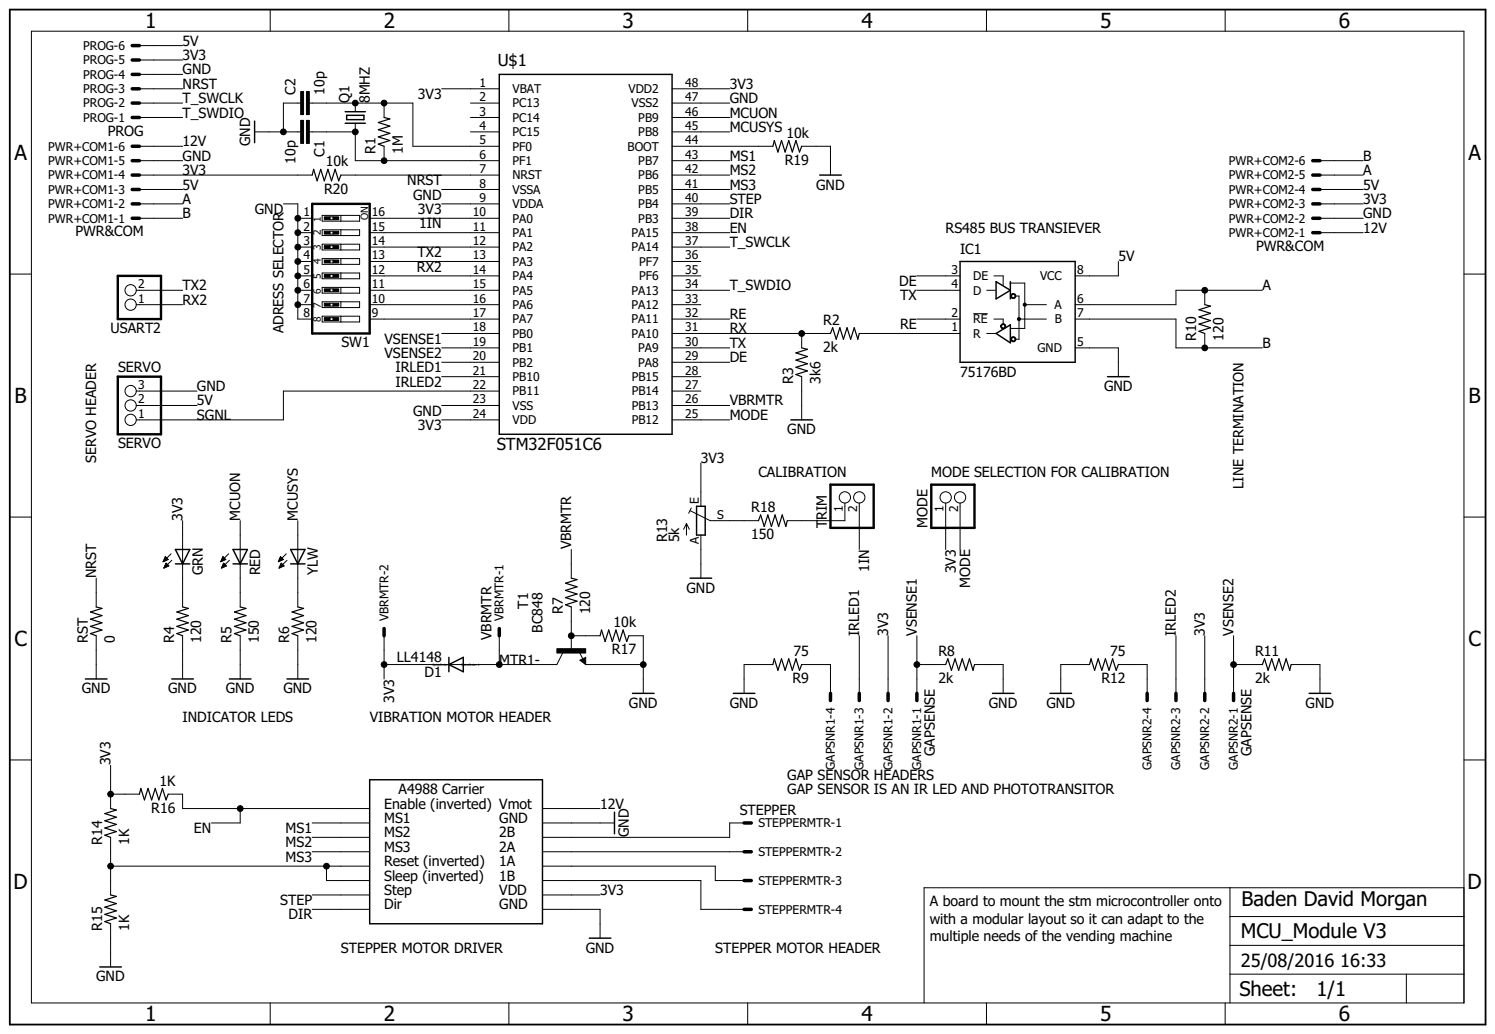
[picture p229: page 1]

PWR+COM1-1 PWR+COM1-2 PWR+COM1-3 PWR+COM1-4 PWR+COM1-5 PROG-1 PROG-2 PROG-3 PROG-4 PROG-5 PROG-6

PWR+COM2-1 PWR+COM2-2 PWR+COM2-3 PWR+COM2-4 PWR+COM2-5

GAP SENSOR HEADERS
GAP SENSOR IS AN IR LED AND PHOTOTRANSITOR
