BadenMorgan/thesis/Circuit/Power Board/board brd.pdf

## R1 PWR

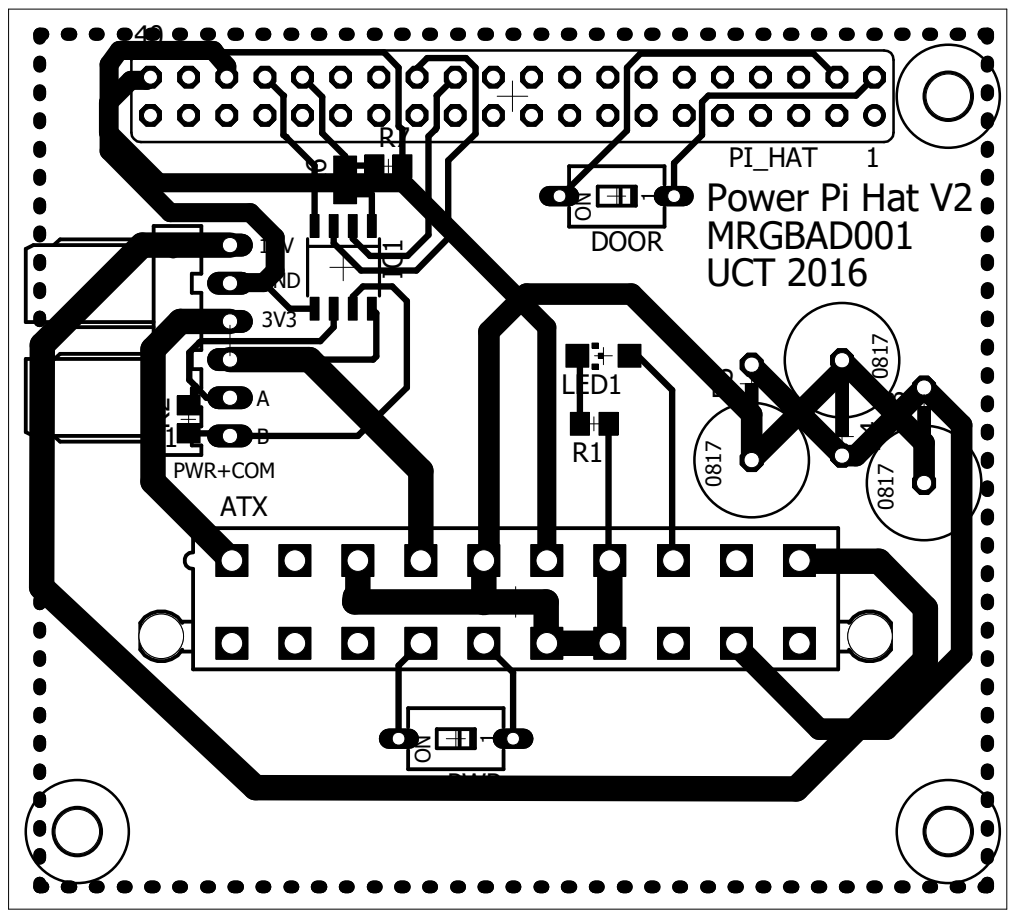
[picture p230: page 1]
12V GND 3V3 5VA 1 B; MRGBAD001; Power Pi Hat V2; UCT 2016 ATX; LED1 PWR+COM; PI_HAT R²; R³ R⁴ R⁵ DOOR R⁶
