BadenMorgan/thesis/Circuit/Power Board/board sch.pdf

A

A

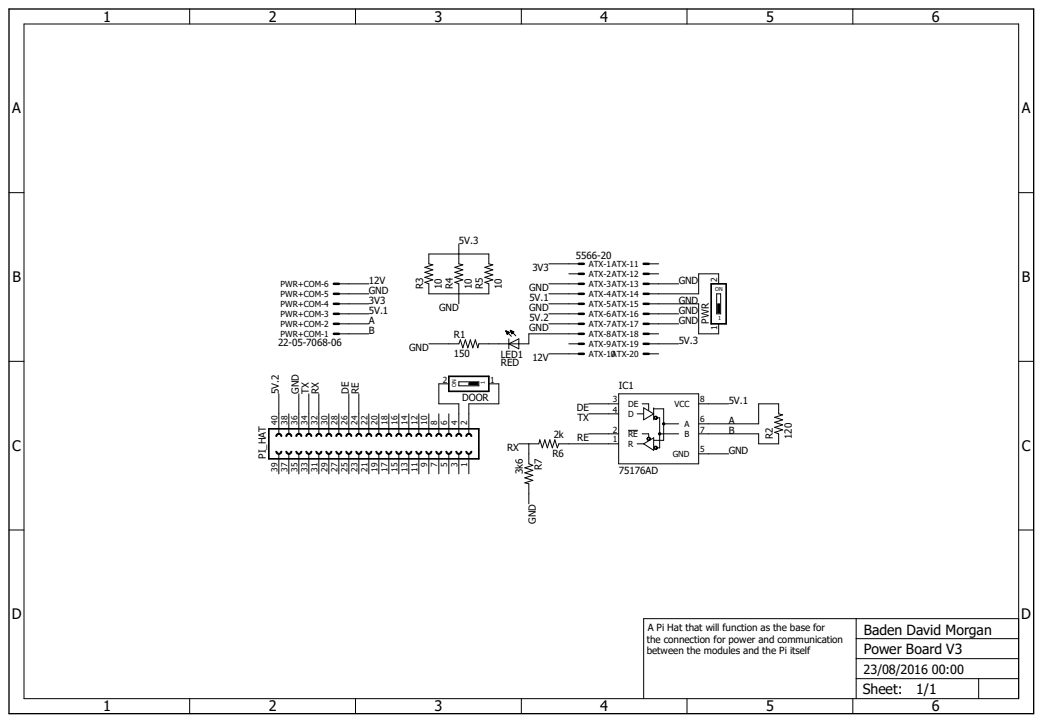
[picture p231: page 1]
RED; ATX-1 ATX-2; ATX-3 ATX-4 ATX-5 ATX-6 ATX-7 ATX-8 ATX-9; ATX-16 ATX-17 ATX-18 ATX-19; ATX-20; PWR; PWR+COM-1; PWR+COM-2; PWR+COM-3; PWR+COM-4; PWR+COM-5; PWR+COM-6; GND; VCC; LED1; R1 PI_HAT; DOOR; GND GND GND; GND GND; 5V.1 DE DE TX TXRX; Power Board V3 23/08/2016 00:00 Sheet: 1/1

ATX-10ATX-11 ATX-12
ATX-13 ATX-14 ATX-15
GND

Baden David Morgan A Pi Hat that will function as the base for
the connection for power and communication
between the modules and the Pi itself
