BadenMorgan/thesis/Solidworks/RFID Reader Holder/Laser template 1mm perspex.PDF

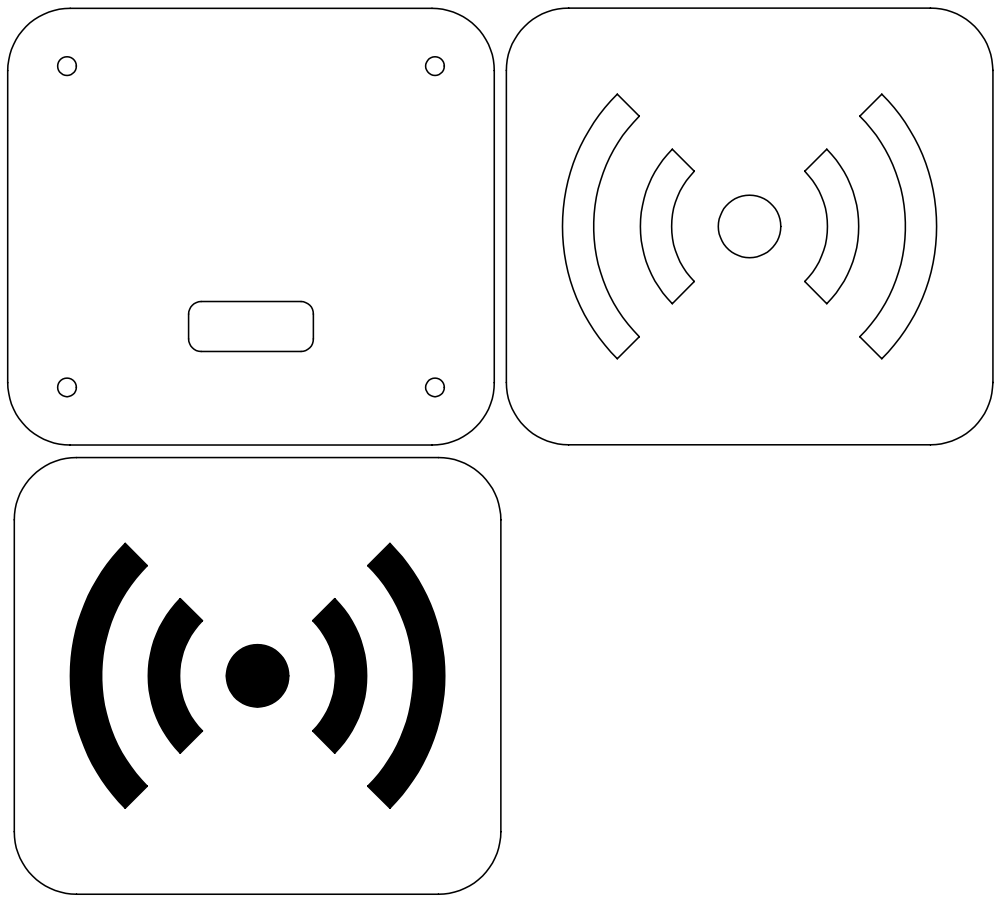
[picture p233: page 1]
