BadenMorgan/thesis/Solidworks/RFID Reader Holder/laser template 3mm perspex.PDF

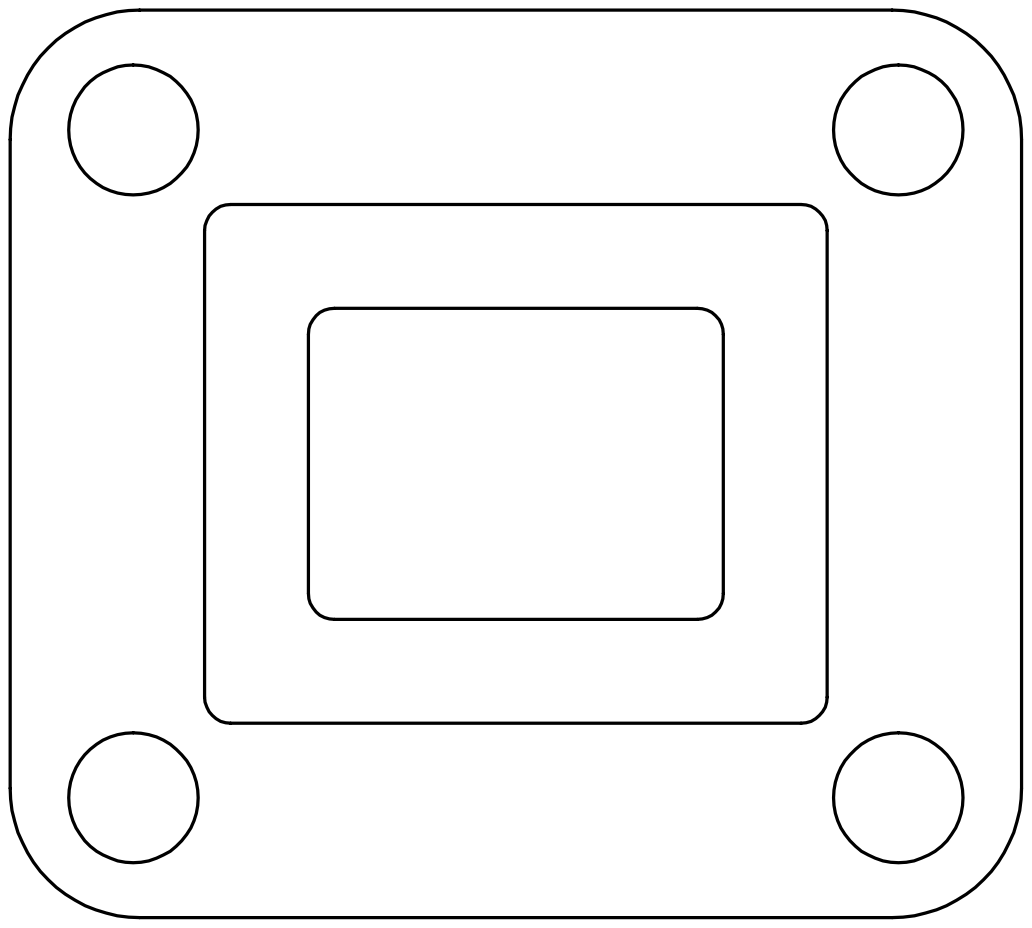
[picture p234: page 1]
