BadenMorgan/thesis/Deliver Mechanism model/laser cut templates/drill template.PDF

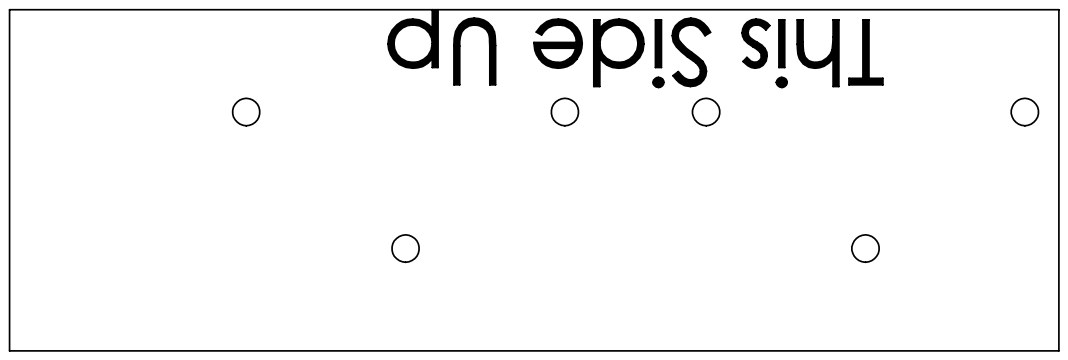
[picture p235: page 1]
