BadenMorgan/thesis/Deliver Mechanism model/laser cut templates/laser tamplate dip 20.PDF

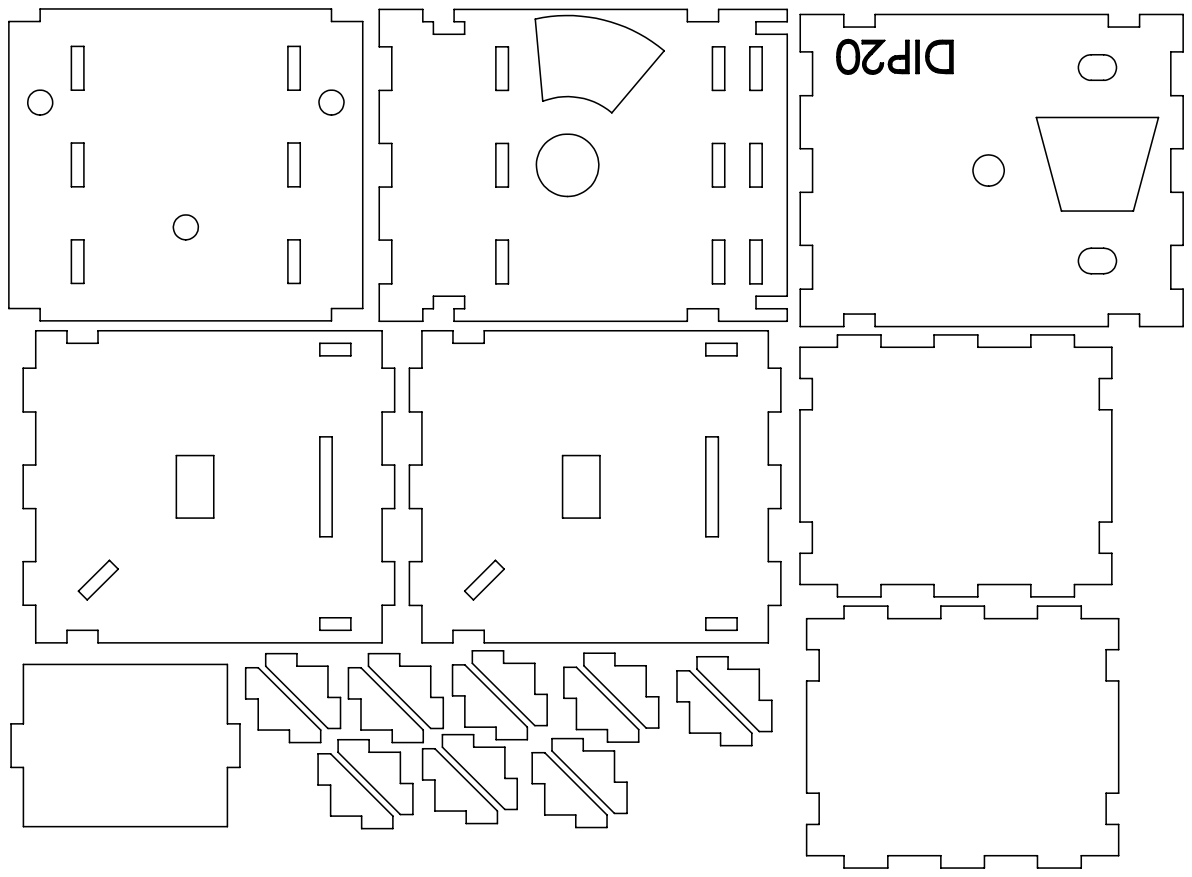
[picture p236: page 1]
