BadenMorgan/thesis/Deliver Mechanism model/laser cut templates/laser tamplate dip 8 holder.PDF

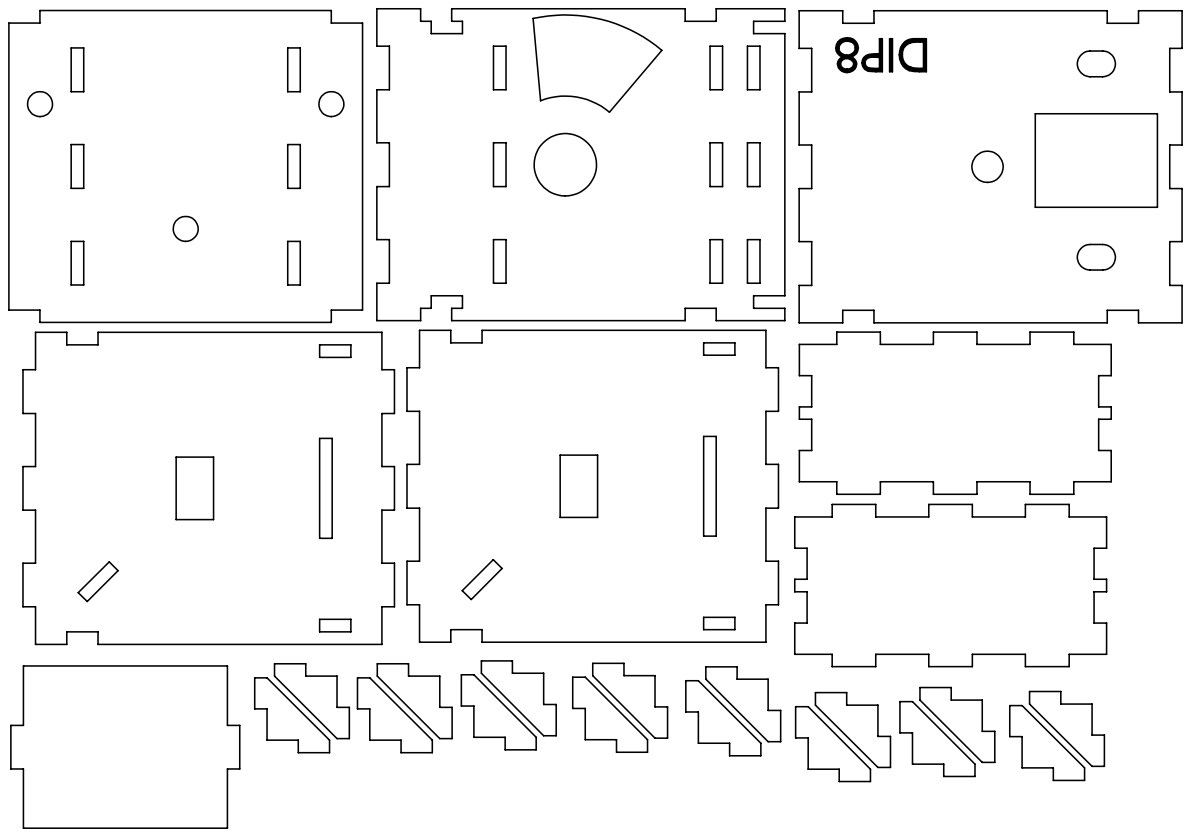
[picture p237: page 1]
