BadenMorgan/thesis/Deliver Mechanism model/laser cut templates/laser tamplate dip 8.PDF

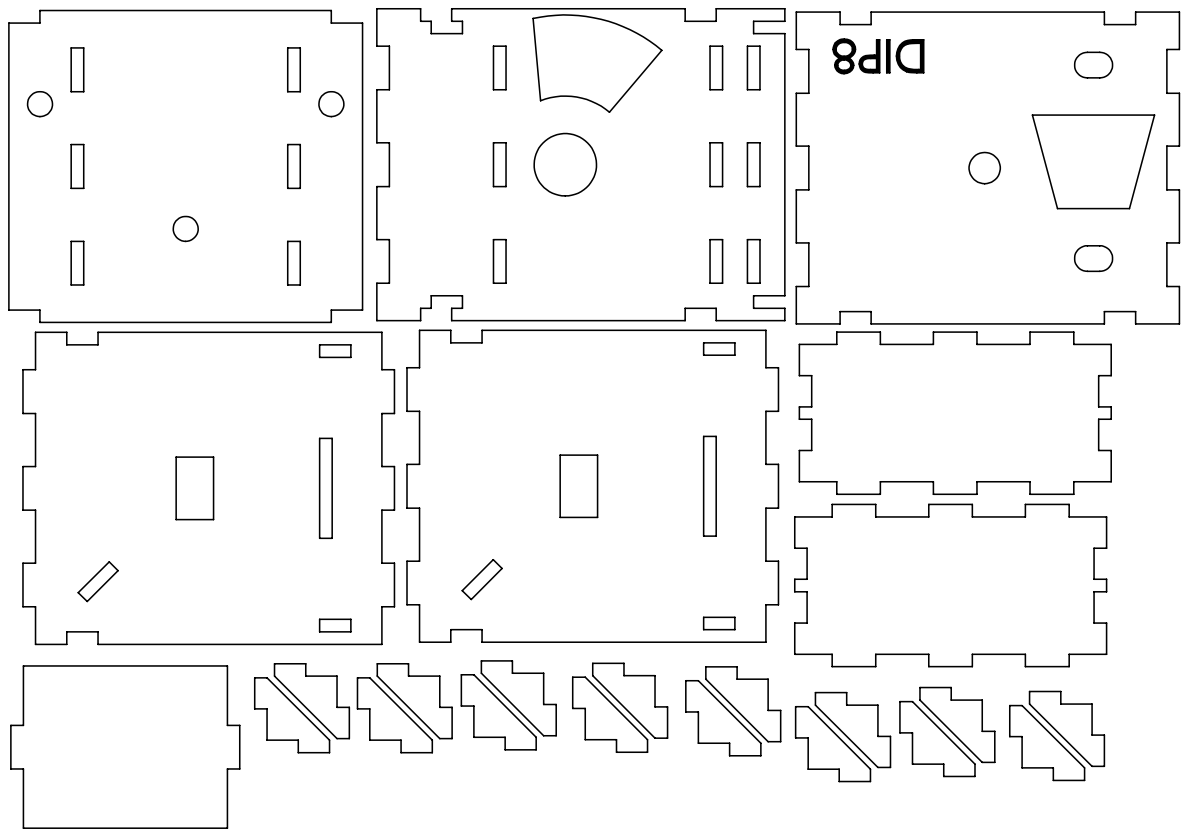
[picture p238: page 1]
