BadenMorgan/thesis/Deliver Mechanism model/laser cut templates/laser tamplate dip14 or 16 holder.PDF

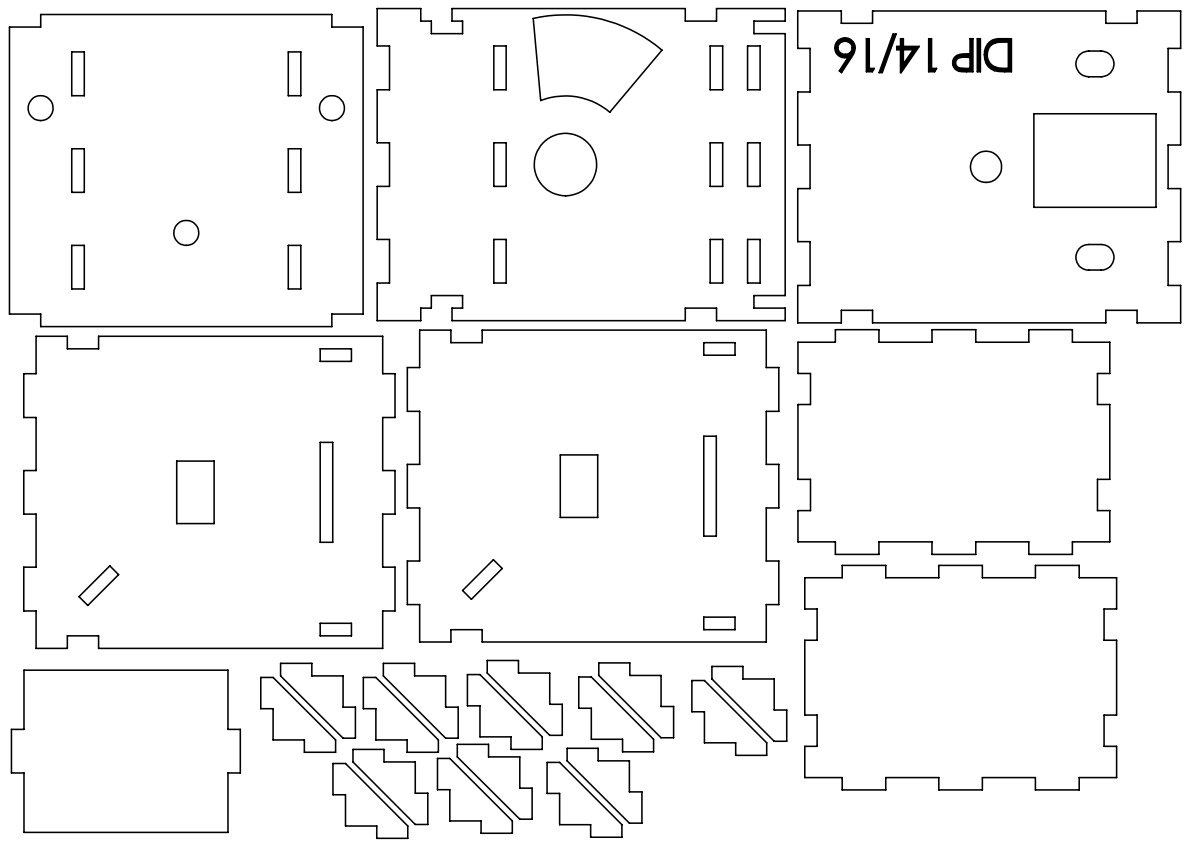
[picture p239: page 1]
