BadenMorgan/thesis/Deliver Mechanism model/laser cut templates/laser tamplate dip14 or 16.PDF

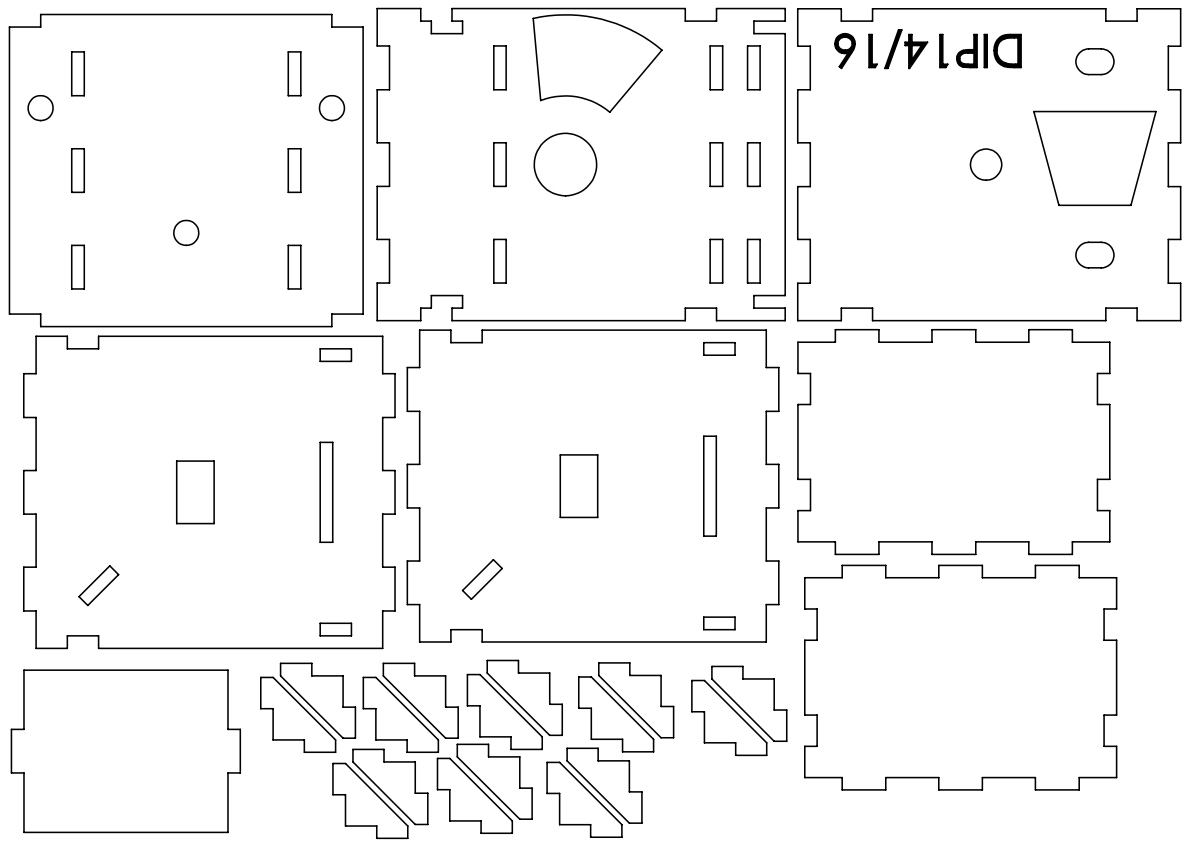
[picture p240: page 1]
