BadenMorgan/thesis/Deliver Mechanism model/laser cut templates/laser tamplate dip20 holder.PDF

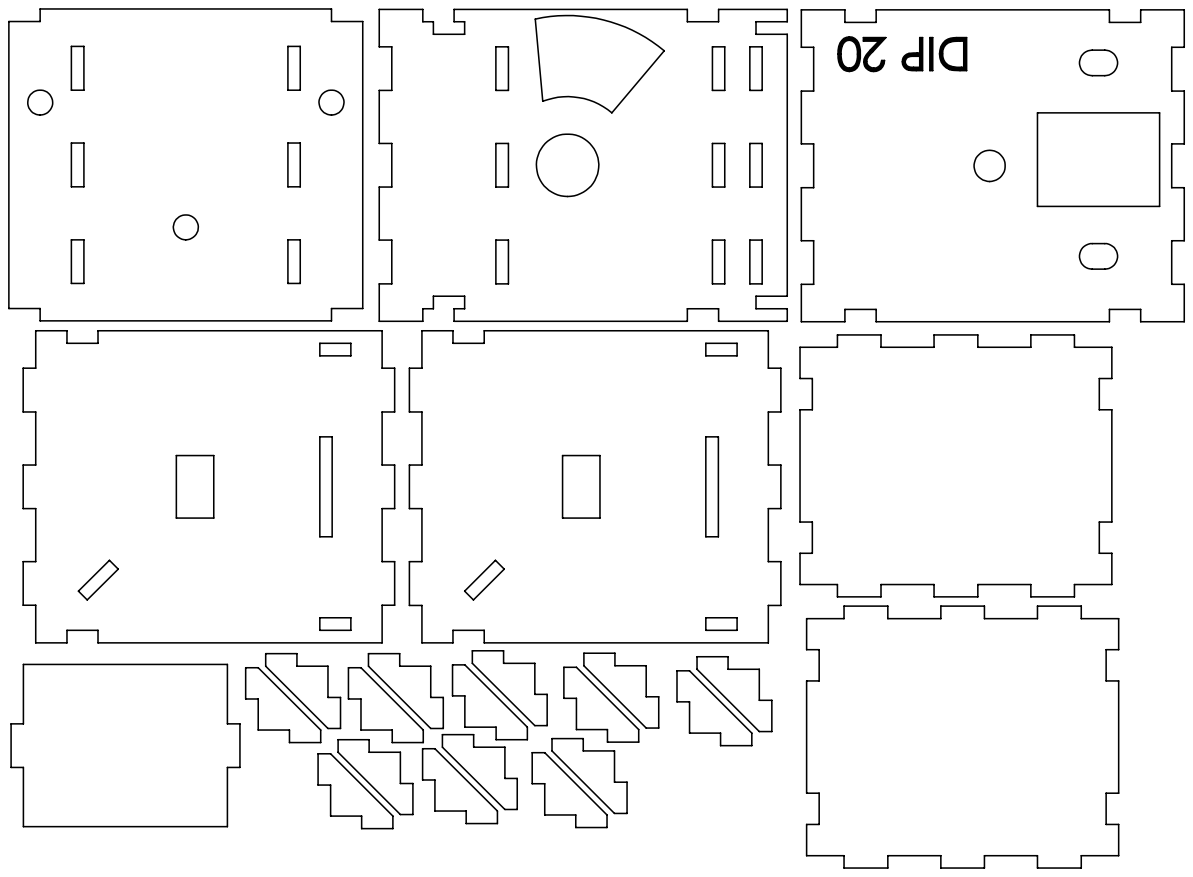
[picture p241: page 1]
