BadenMorgan/thesis/Circuit/MCU Module/MCU_Module V3 brd.pdf

3 | 1 | 1ON | 2 3 4 5 6 7 8 EDG* MCU Module V3

## MRGBAD001

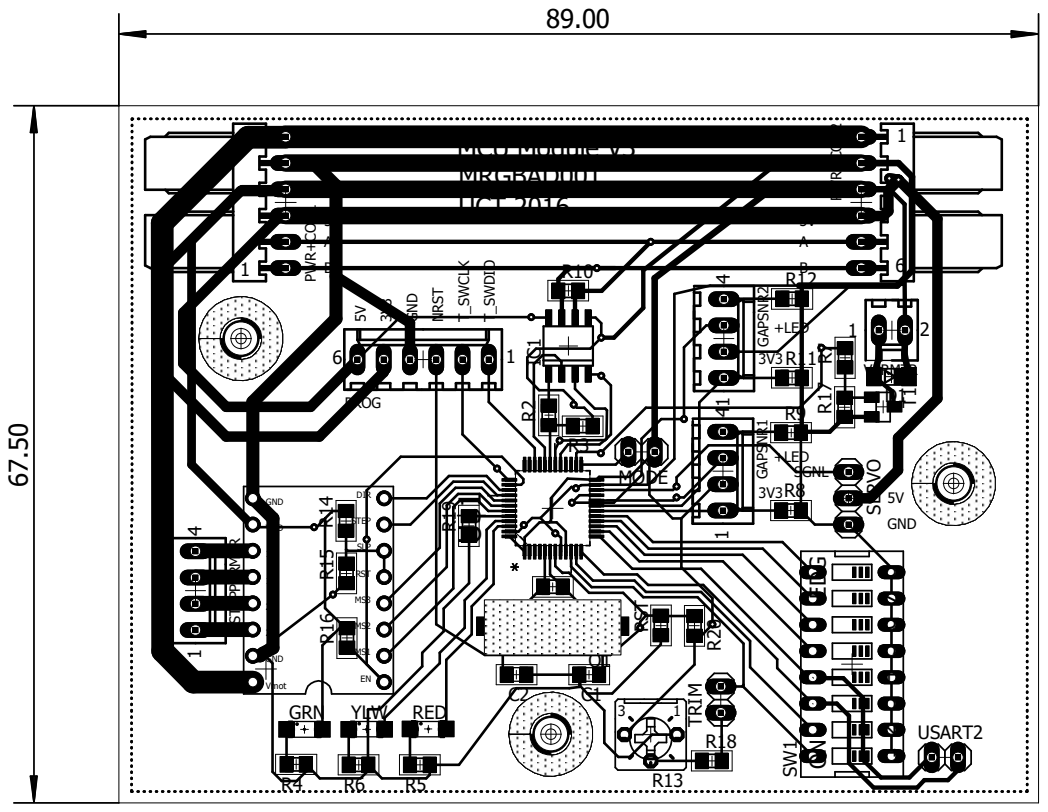
[picture p242: page 1]
