BadenMorgan/thesis/Circuit/LCD Board/LCD_Breakout MIRROR.pdf

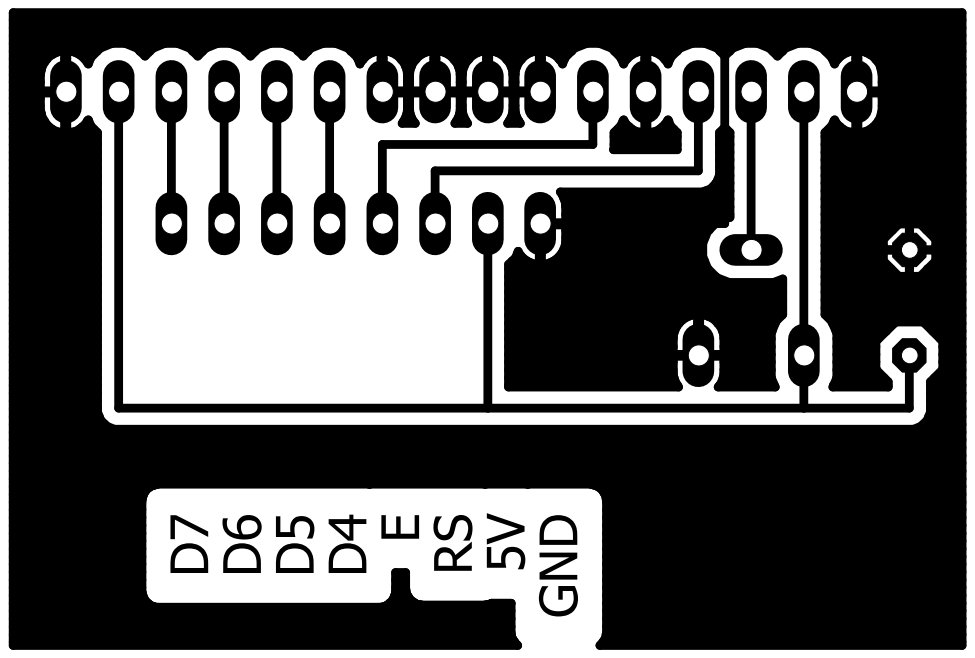
[picture p243: page 1]
