BadenMorgan/thesis/Circuit/LCD Board/LCD_Breakout.pdf

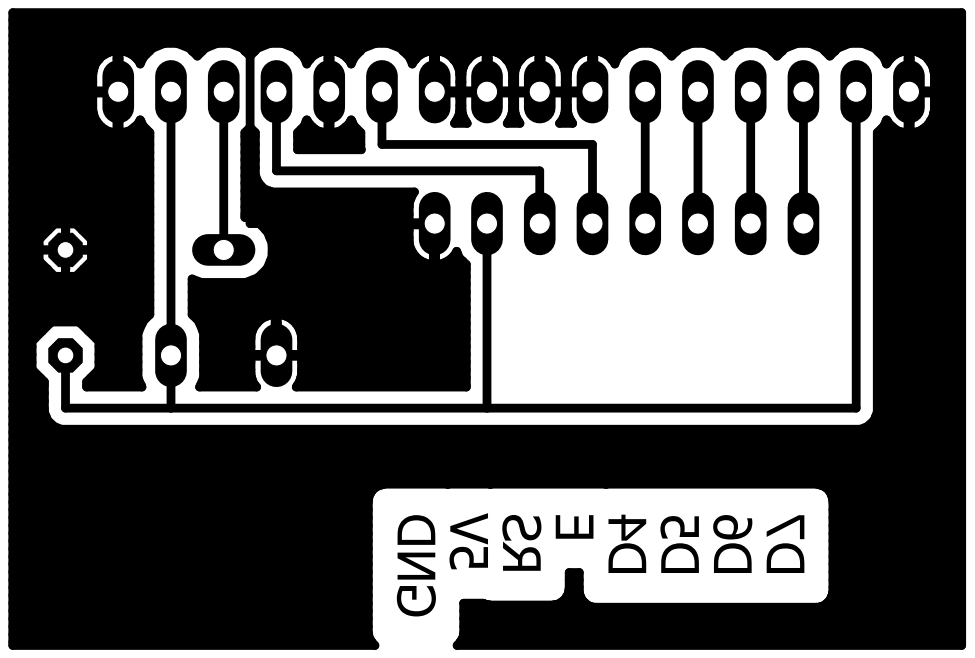
[picture p244: page 1]
