BadenMorgan/thesis/Solidworks/Enclosure/Drawings/a1 back platev2.PDF

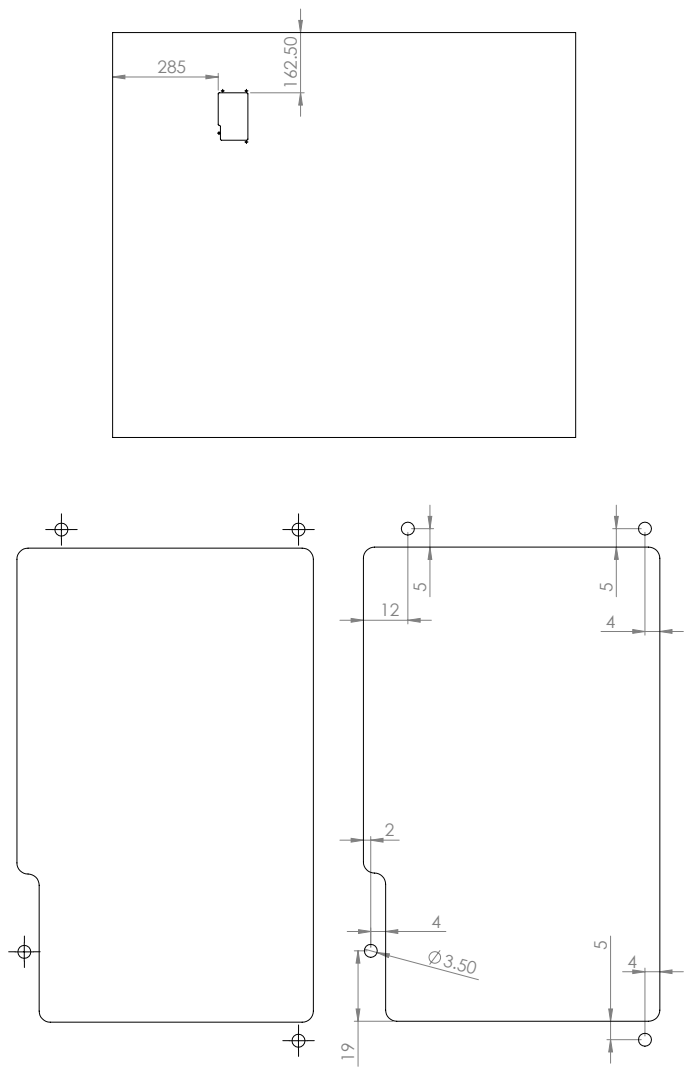
[picture p245: page 1]
