BadenMorgan/thesis/Solidworks/Enclosure/Drawings/a1 front door plate v2.PDF

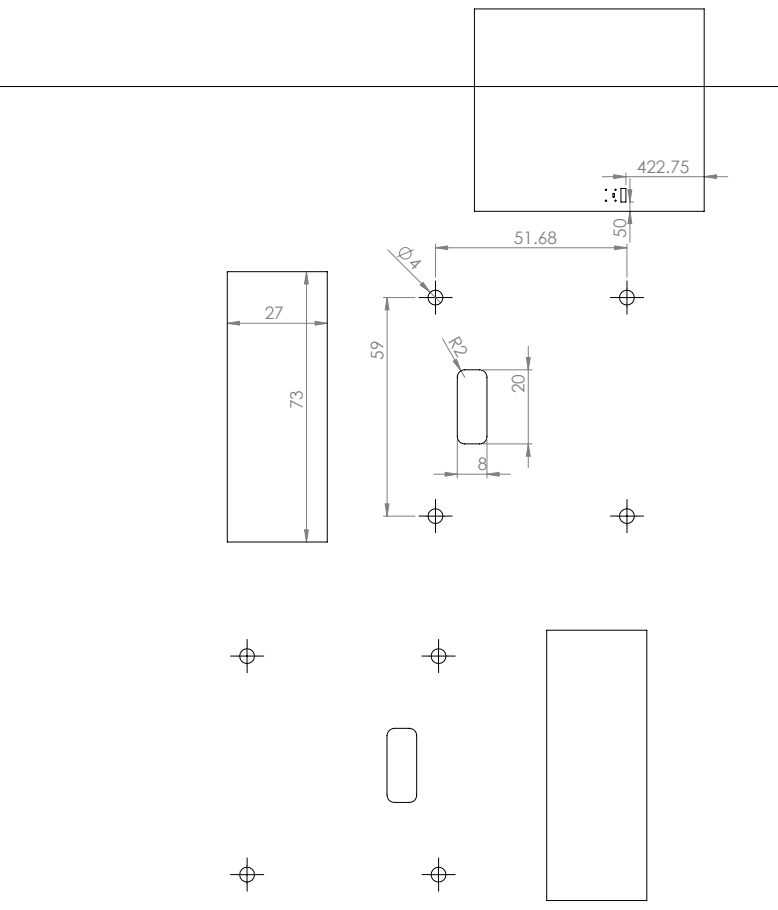
[picture p246: page 1]
