BadenMorgan/thesis/Solidworks/roller 2/laser cut templates/laser tamplate dip20 + dip16 or 14.PDF

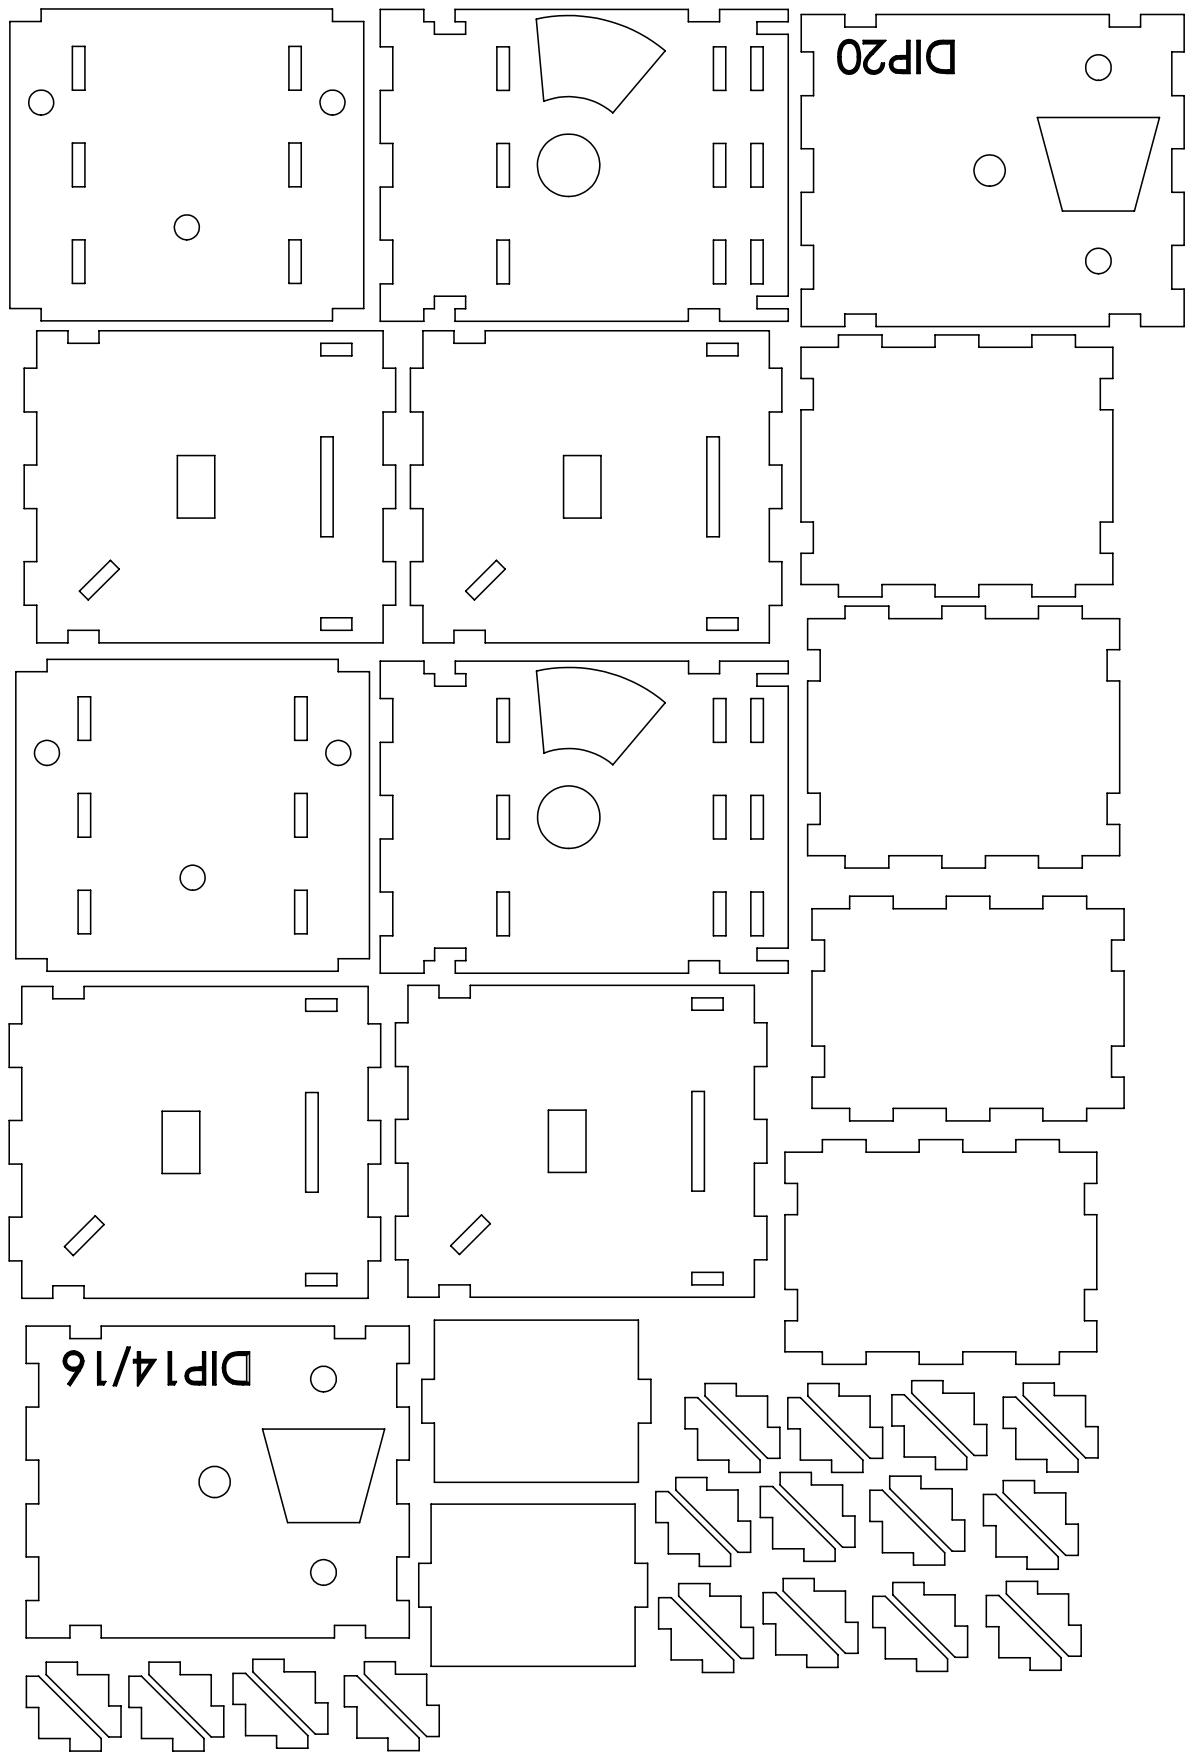
[picture p247: page 1]
