BadenMorgan/thesis/Solidworks/roller 2/dip 20/laser tamplate dip 20.PDF

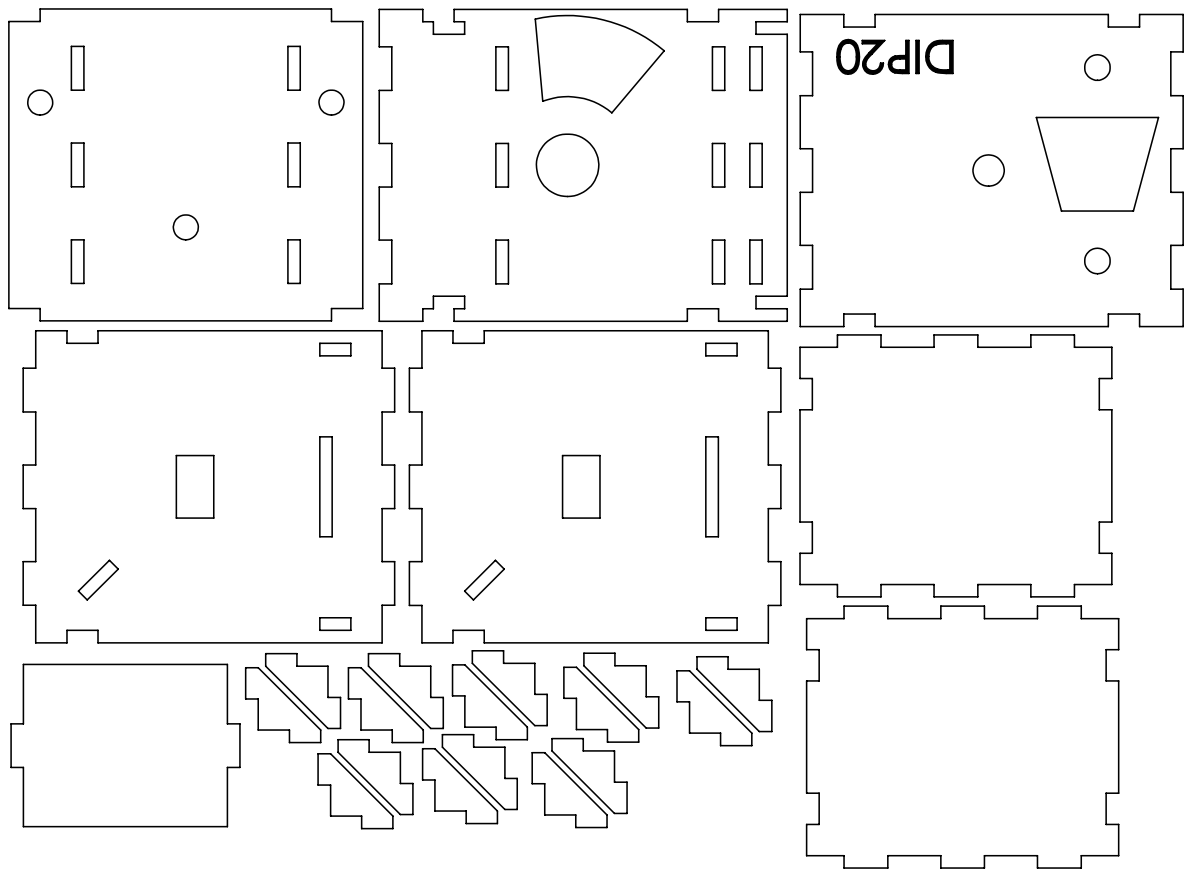
[picture p248: page 1]
