BadenMorgan/thesis/Solidworks/roller 2/dip14.16/laser tamplate dip14 or 16.PDF

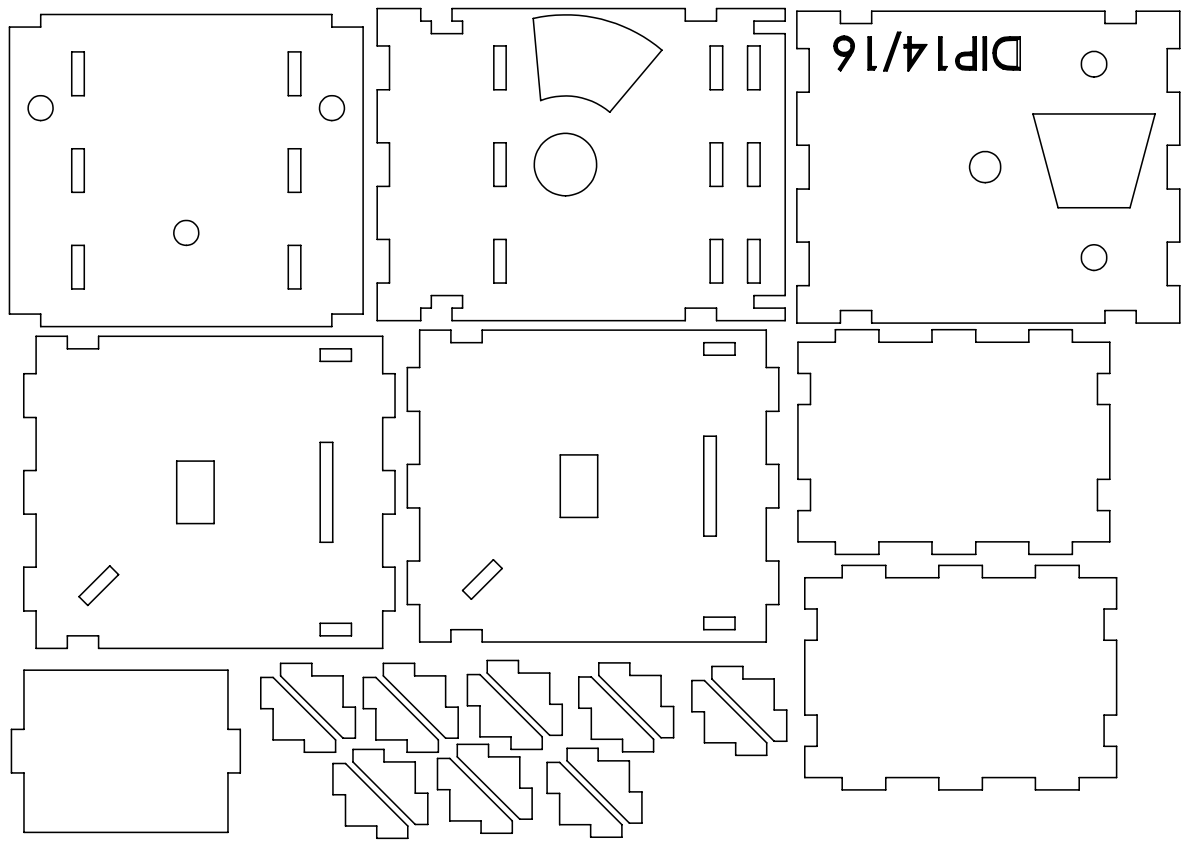
[picture p249: page 1]
