BadenMorgan/thesis/Solidworks/roller 2/laser cut templates/all page 1 of 2.PDF

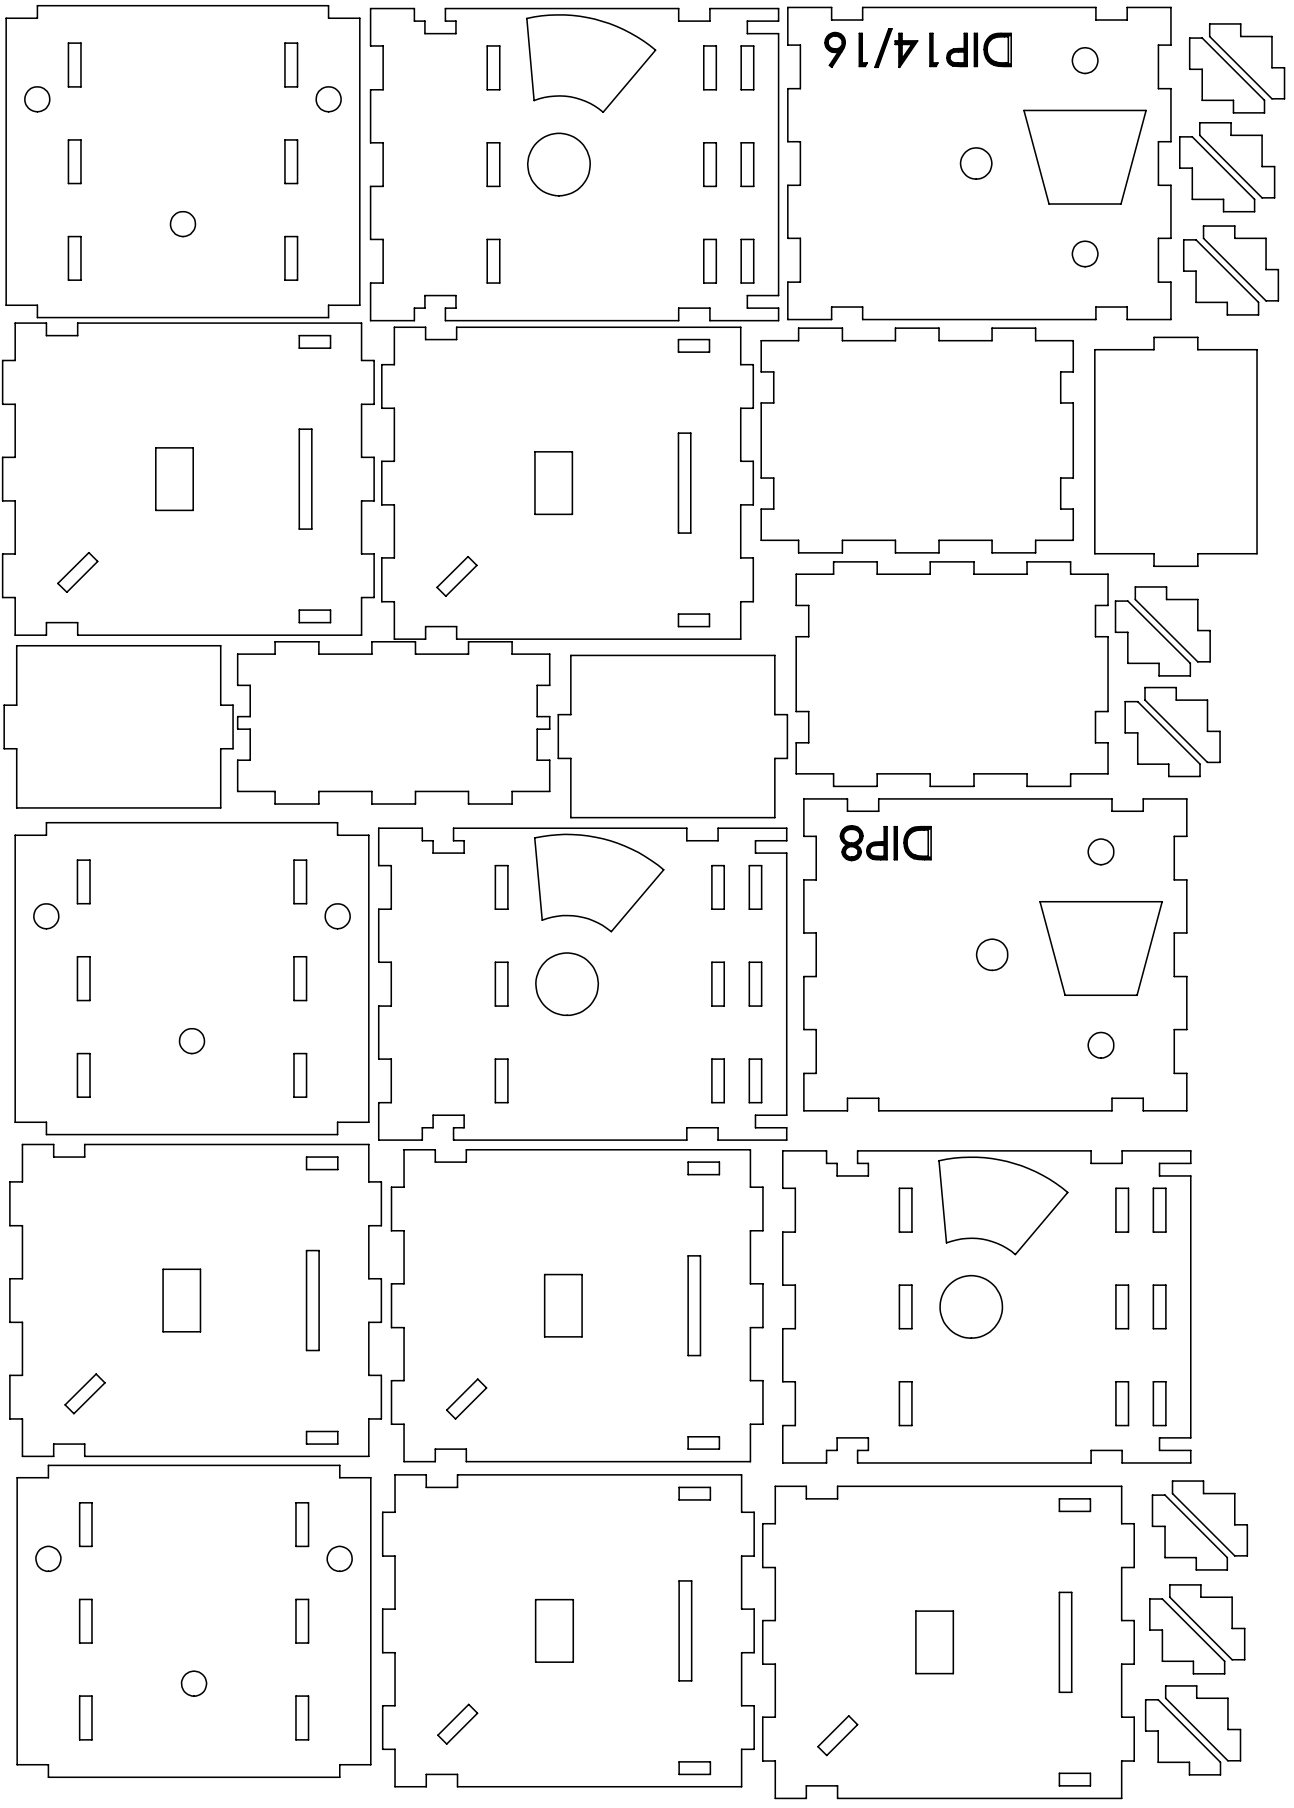
[picture p250: page 1]
