BadenMorgan/thesis/Solidworks/roller 2/laser cut templates/all page 2 of 2.PDF

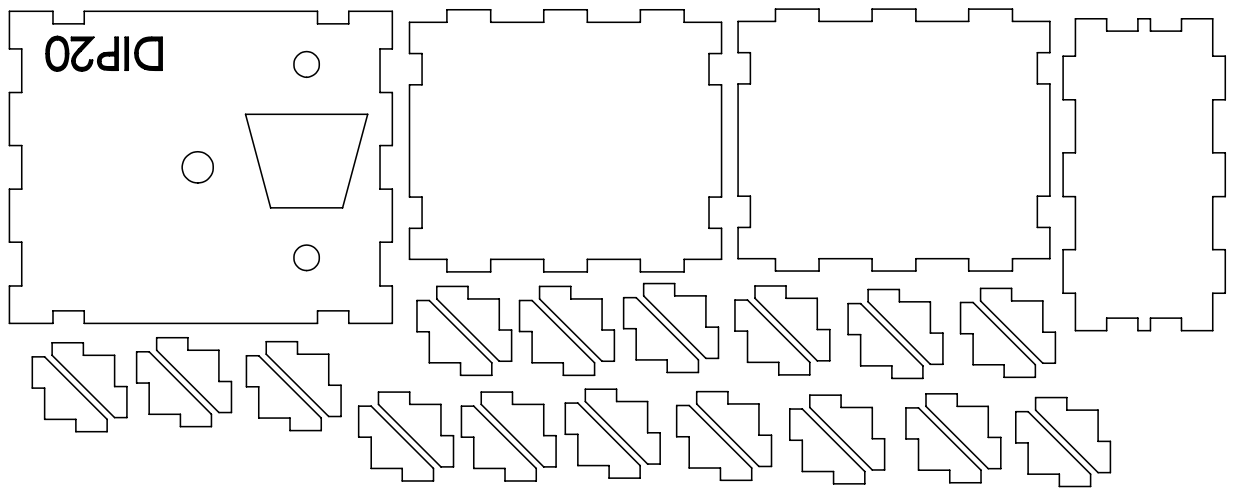
[picture p251: page 1]
