BadenMorgan/thesis/Solidworks/roller 2/laser cut templates/laser tamplate dip 8.PDF

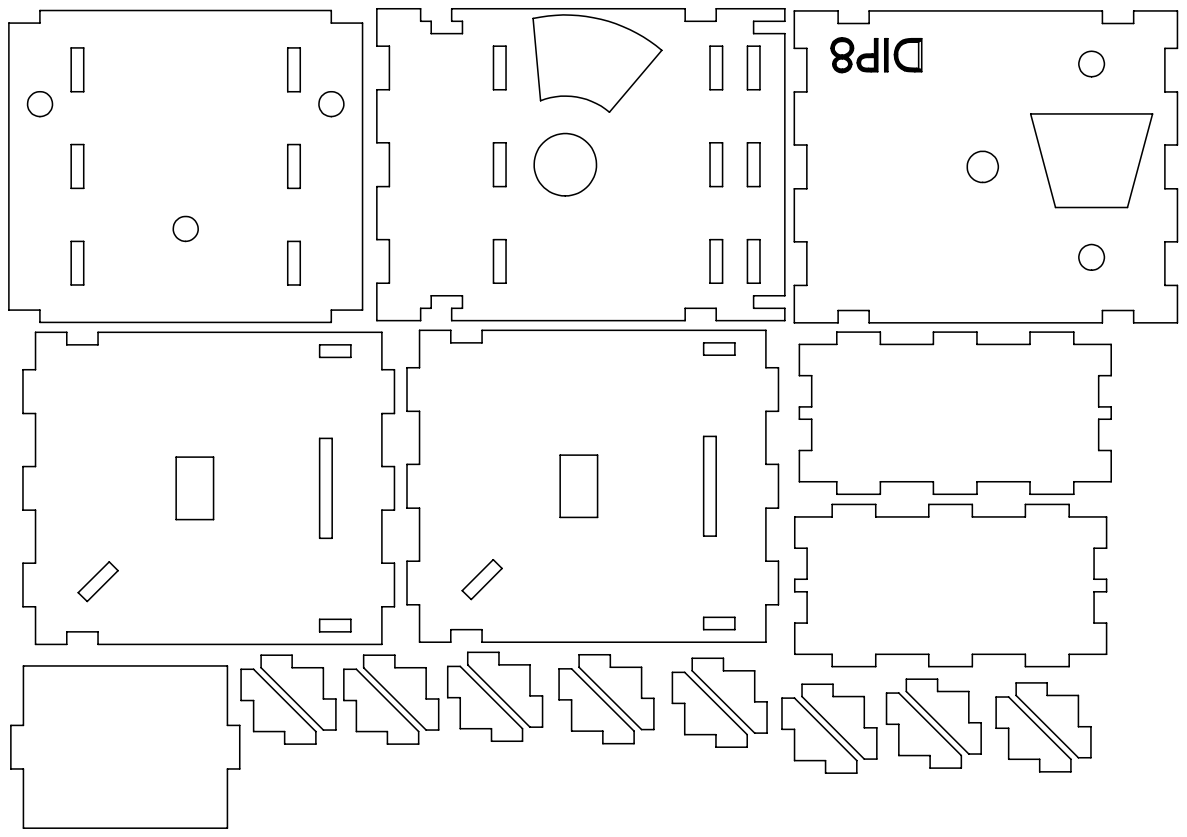
[picture p252: page 1]
