BadenMorgan/thesis/Solidworks/roller 2/dip 20/laser tamplate.PDF

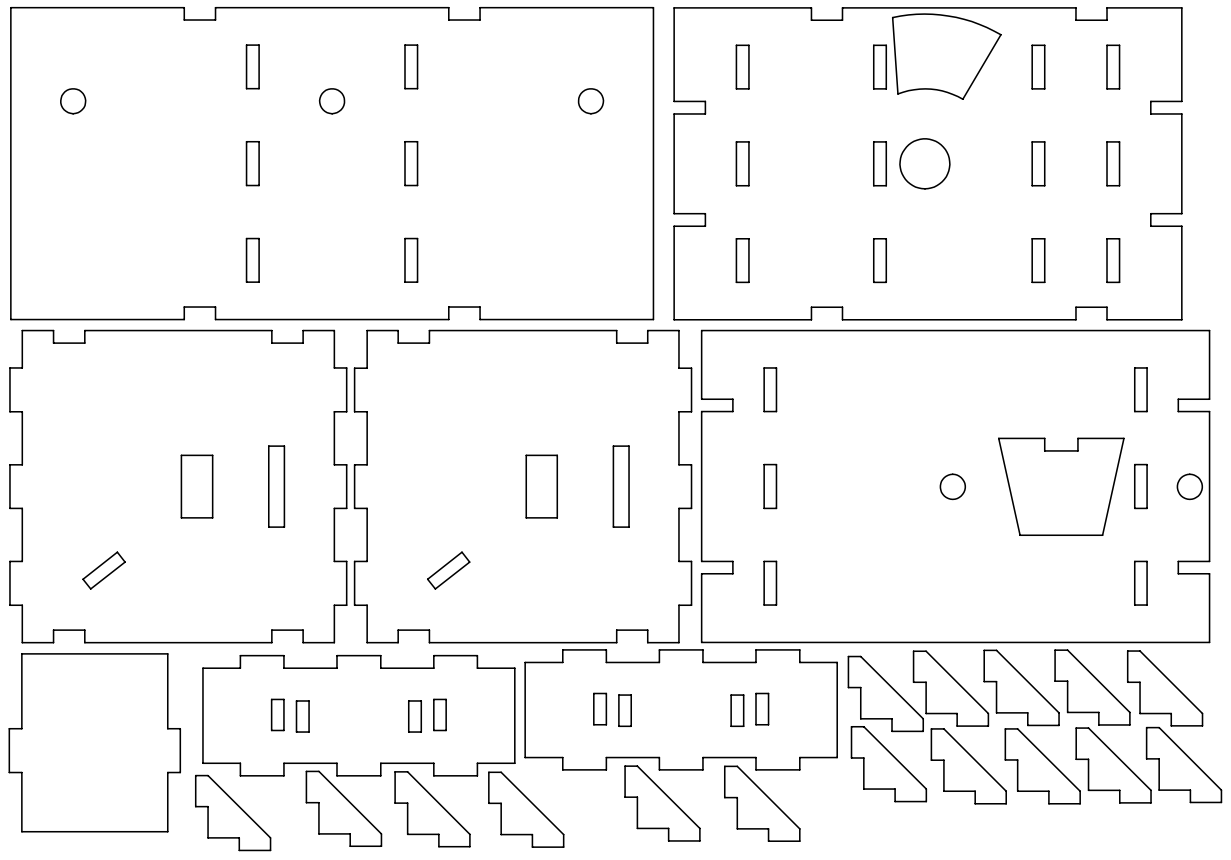
[picture p253: page 1]
