BadenMorgan/thesis/Circuit/archive/MCU_Module V2.pdf

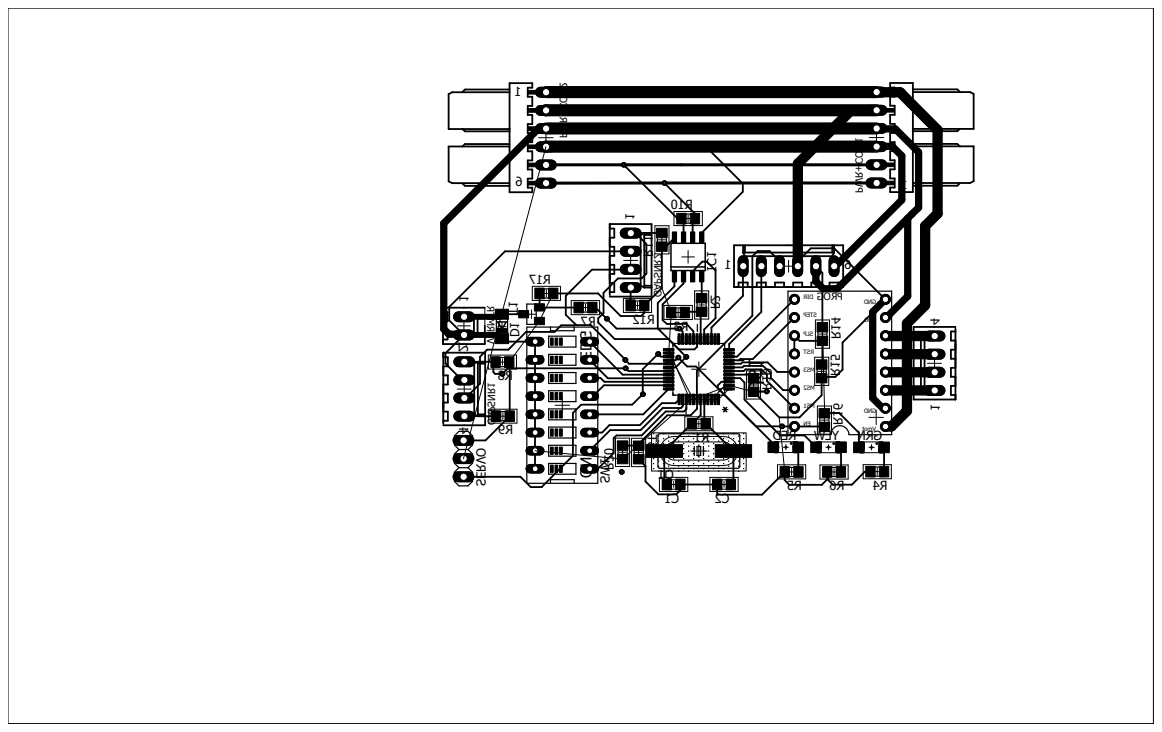
[picture p254: page 1]

1C 2C D1 NRG IC1 GAPSNR1STEPPERMTR 1 Q 1R 01R R14 R15 R16 71R R19 R2 R20 3R 5R 6R 4R 7R 8R9R DER SERVO SW1 T1 U$1 GORP PWR+COM1PWR+COM2 VBRMTR WLY RST GAPSNR R2 11 21R 1ON 2 3 4 5 6 7 8 EDG * 1 4 1 4 NE1S M 2S M 3S M TSR PETS RI D t o mV DNGB2A2A1B1 DDV DNG PLS 1 6 1 1 6 6 1 2 1 4
