BadenMorgan/thesis/Document/Pictures/archive pics/final internals.PDF

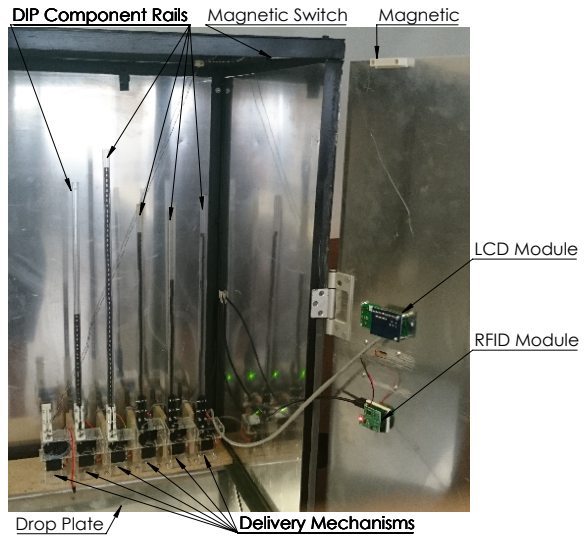
[picture p255: page 1]
Delivery Mechanisms; DIP Component Rails; Magnetic; LCD Module; RFID Module; Magnetic Switch; Drop Plate
