BadenMorgan/thesis/Document/Pictures/archive pics/labelled final psu.PDF

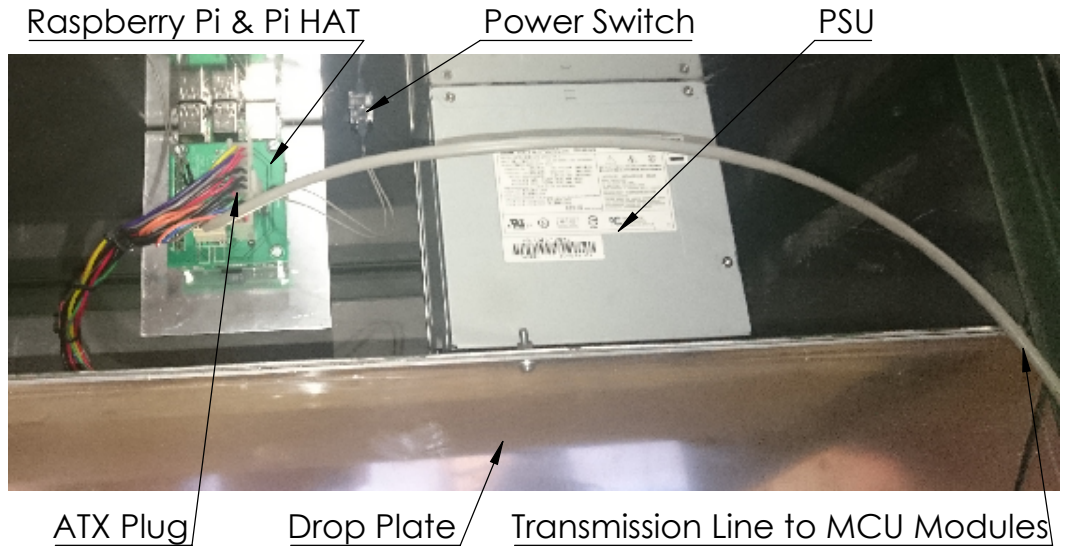
[picture p256: page 1]
Raspberry Pi & Pi HAT; Power Switch; PSU; ATX Plug; Drop Plate; Transmission Line to MCU Modules
