BadenMorgan/thesis/Solidworks/Archive/request forms/Aluminium sheets sheet 1 v2.PDF

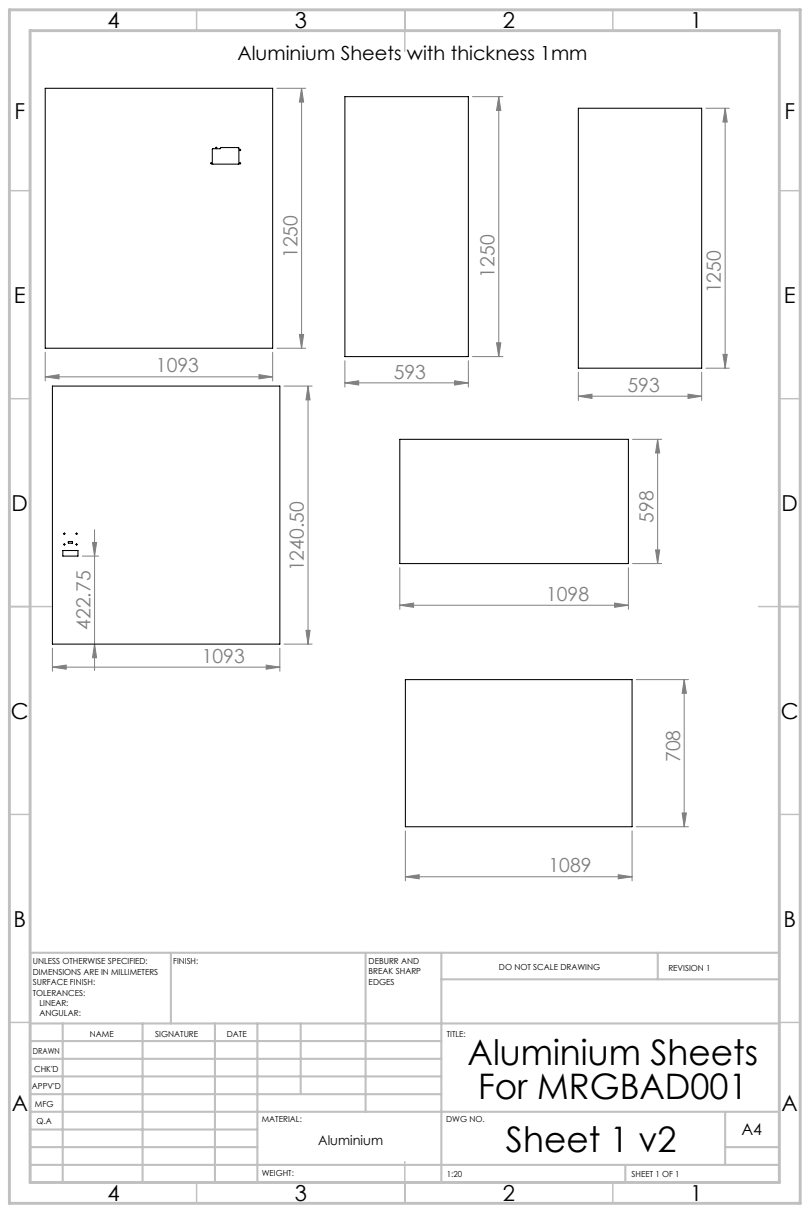
[picture p257: page 1]
FINISH:; DEBURR AND; BREAK SHARP; DO NOT SCALE DRAWING; REVISION 1; SHEET 1 OF 1

Aluminium Sheets with thickness 1mm

UNLESS OTHERWISE SPECIFIED:
DIMENSIONS ARE IN MILLIMETERS
SURFACE FINISH:
TOLERANCES:
LINEAR:
ANGULAR:

NAME | SIGNATURE | DATE | | | | TITLE: Aluminium Sheets For MRGBAD001

DRAWN
CHK'D
APPV'D
MFG
Q.A | | | | MATERIAL: | DWG NO. Sheet 1 v2 | A4 Aluminium
