BadenMorgan/thesis/Solidworks/Archive/request forms/L Beam sheet sheet 6 v2.PDF

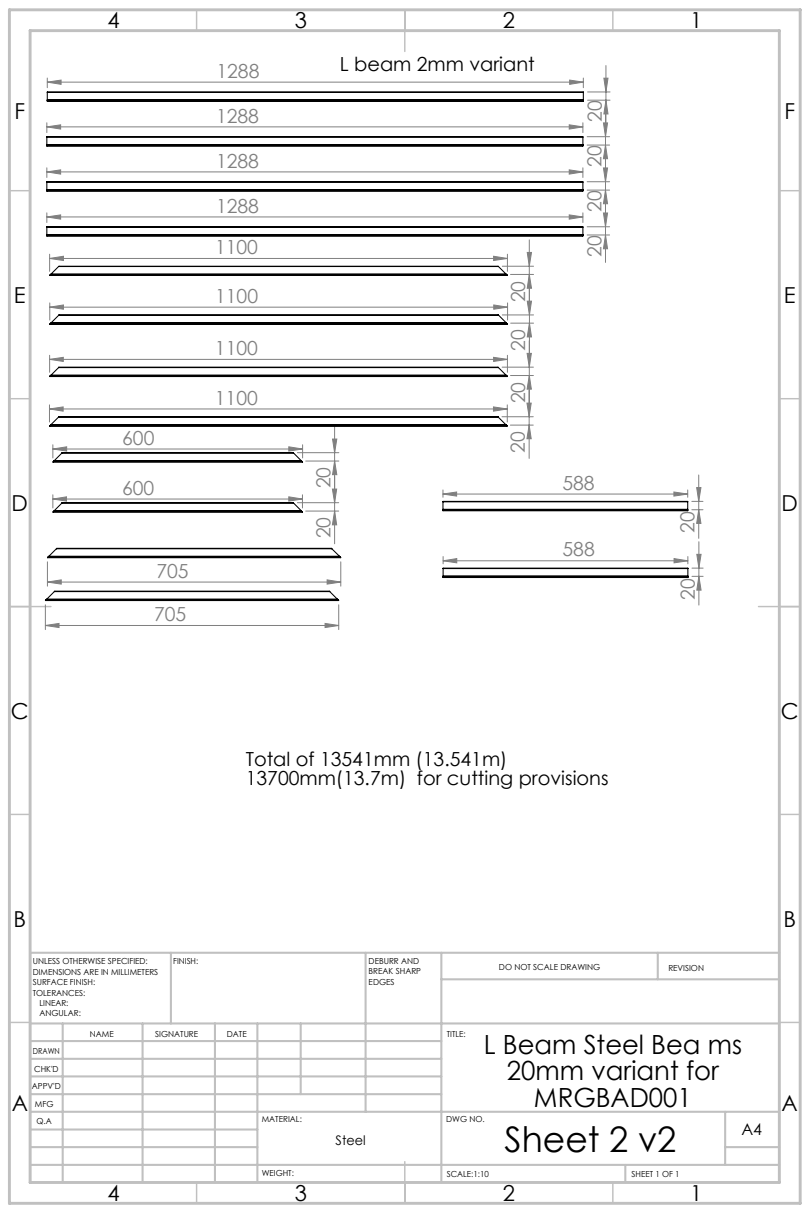
[picture p258: page 1]
L beam 2mm variant; FINISH:; DEBURR AND; BREAK SHARP; DO NOT SCALE DRAWING; REVISION; SCALE:1:10; SHEET 1 OF 1

Total of 13541mm (13.541m)
13700mm(13.7m) for cutting provisions

UNLESS OTHERWISE SPECIFIED:
DIMENSIONS ARE IN MILLIMETERS
SURFACE FINISH:
TOLERANCES:
LINEAR:
ANGULAR:

NAME | SIGNATURE | DATE | | | | TITLE: L Beam Steel Bea ms 20mm variant for MRGBAD001

DRAWN
CHK'D
APPV'D
MFG
Q.A | | | | MATERIAL: Steel | DWG NO. Sheet 2 v2 | A4
