BadenMorgan/thesis/Solidworks/Archive/request forms/steel bar sheet 7 v2.PDF

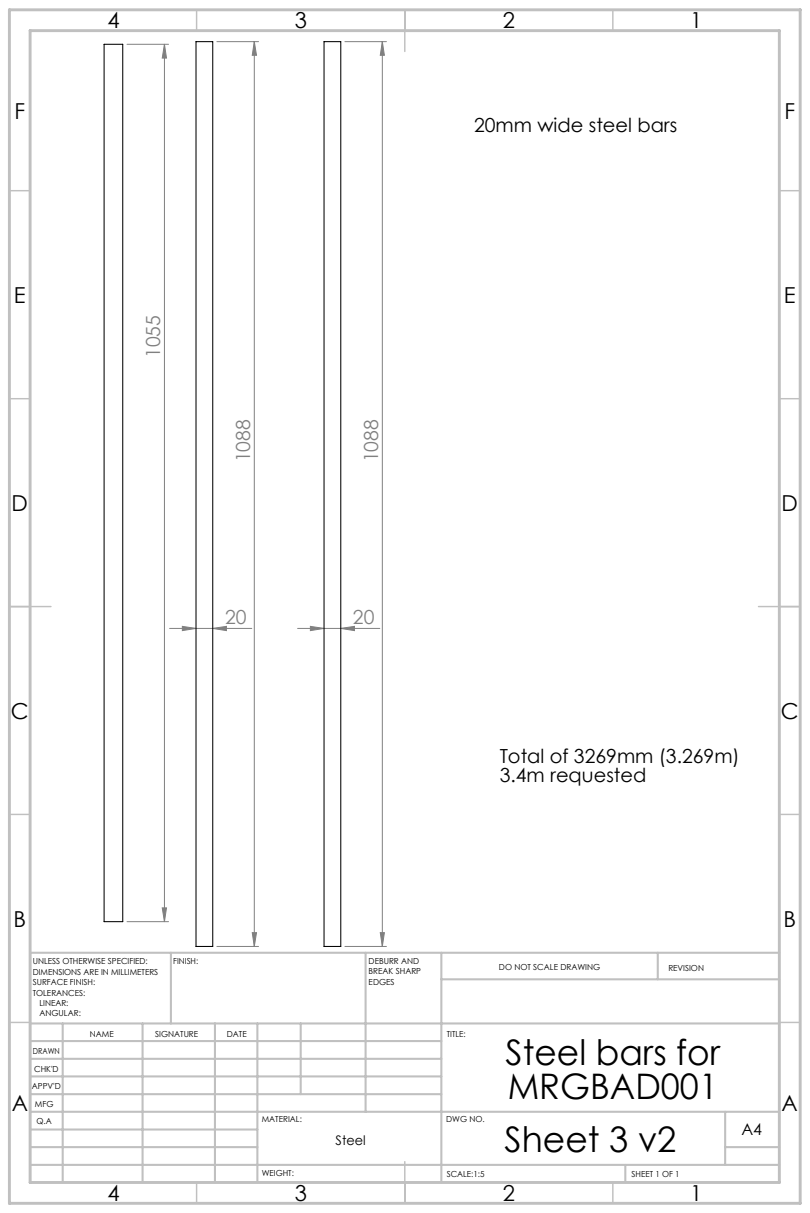
[picture p259: page 1]
Total of 3269mm (3.269m) 3.4m requested; FINISH:; DEBURR AND; BREAK SHARP; DO NOT SCALE DRAWING; REVISION; SCALE:1:5; SHEET 1 OF 1

20mm wide steel bars

UNLESS OTHERWISE SPECIFIED:
DIMENSIONS ARE IN MILLIMETERS
SURFACE FINISH:
TOLERANCES:
LINEAR:
ANGULAR:

NAME | SIGNATURE | DATE | | | | TITLE: Steel bars for MRGBAD001

DRAWN
CHK'D
APPV'D
MFG
Q.A | | | | MATERIAL: Steel | DWG NO. Sheet 3 v2 | A4
