BadenMorgan/thesis/Solidworks/Archive/request forms/1mm perspex sheet 4.PDF

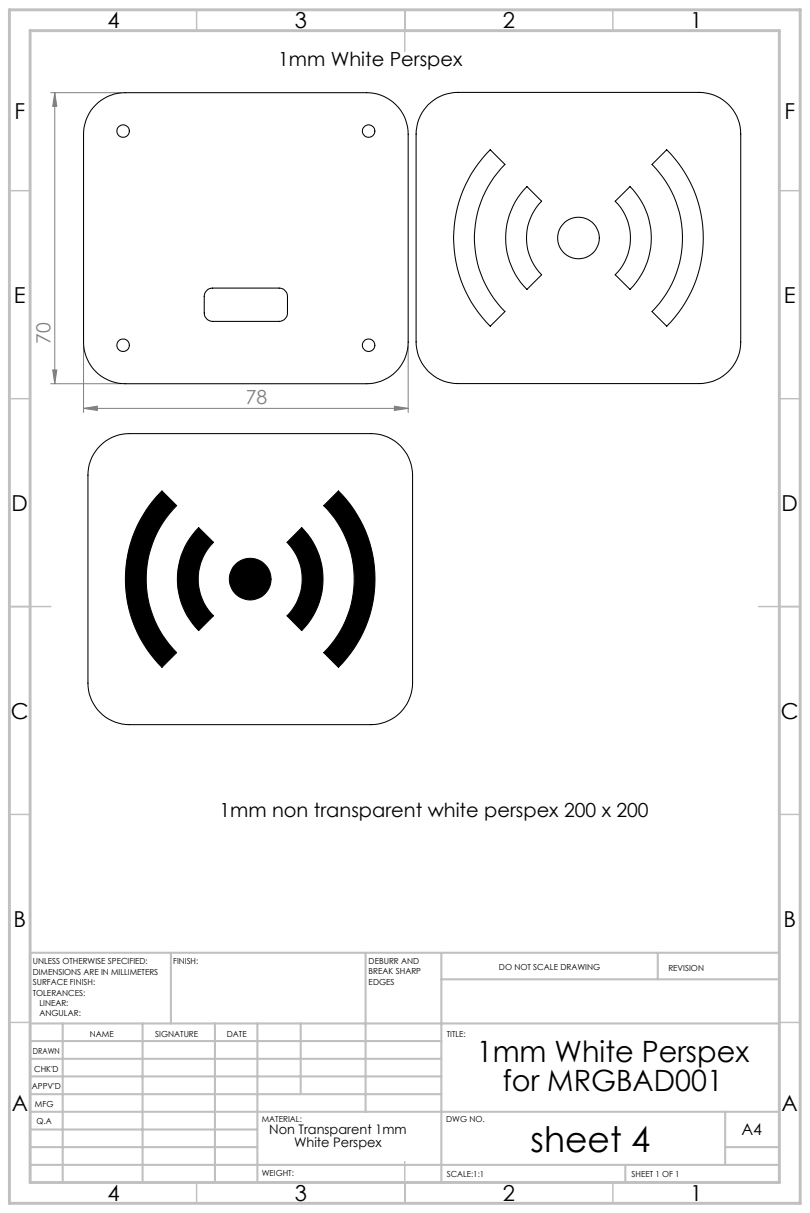
[picture p260: page 1]
1mm White Perspex; FINISH:; DEBURR AND; BREAK SHARP; DO NOT SCALE DRAWING; REVISION; SCALE:1:1; SHEET 1 OF 1

1mm non transparent white perspex 200 x 200

UNLESS OTHERWISE SPECIFIED:
DIMENSIONS ARE IN MILLIMETERS
SURFACE FINISH:
TOLERANCES:
LINEAR:
ANGULAR:

NAME | SIGNATURE | DATE | | | | TITLE: 1mm White Perspex for MRGBAD001

DRAWN
CHK'D
APPV'D
MFG
Q.A | | | | MATERIAL: Non Transparent 1mm White Perspex | DWG NO. sheet 4 | A4
