BadenMorgan/thesis/Solidworks/Archive/request forms/2MM clear persepx sheet 3.PDF

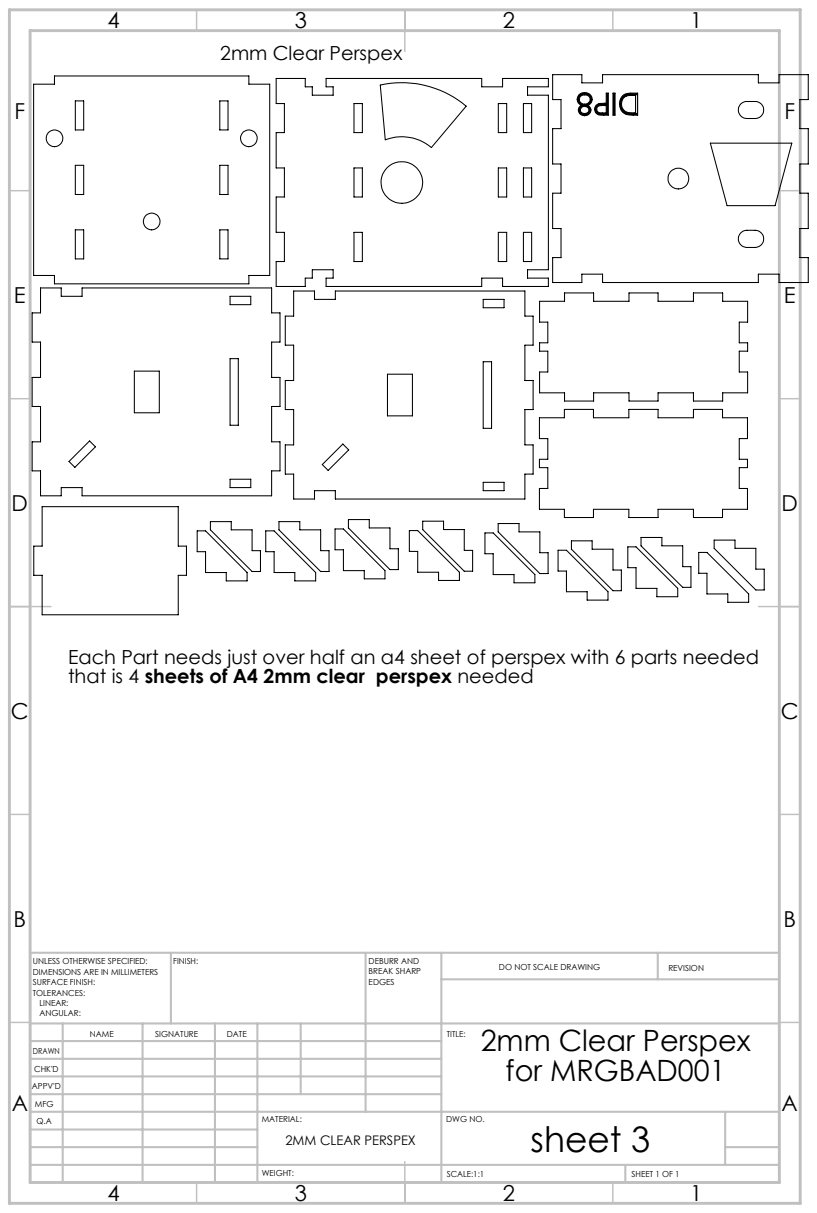
[picture p261: page 1]
2mm Clear Perspex; FINISH:; DEBURR AND; BREAK SHARP; DO NOT SCALE DRAWING; REVISION; SCALE:1:1; SHEET 1 OF 1

Each Part needs just over half an a4 sheet of perspex with 6 parts needed
that is 4 sheets of A4 2mm clear perspex needed

UNLESS OTHERWISE SPECIFIED:
DIMENSIONS ARE IN MILLIMETERS
SURFACE FINISH:
TOLERANCES:
LINEAR:
ANGULAR:

NAME | SIGNATURE | DATE | | | 2mm Clear Perspex TITLE: for MRGBAD001

DRAWN
CHK'D
APPV'D
MFG
Q.A | | | | MATERIAL: 2MM CLEAR PERSPEX | DWG NO. sheet 3
