BadenMorgan/thesis/Solidworks/Archive/request forms/test design.PDF

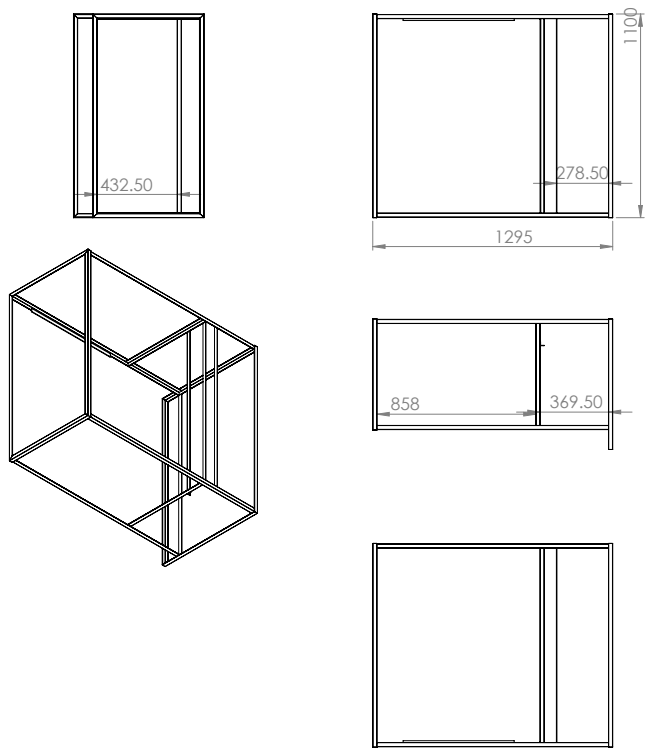
[picture p262: page 1]
