BadenMorgan/thesis/Solidworks/Archive/Copy of drill template.PDF

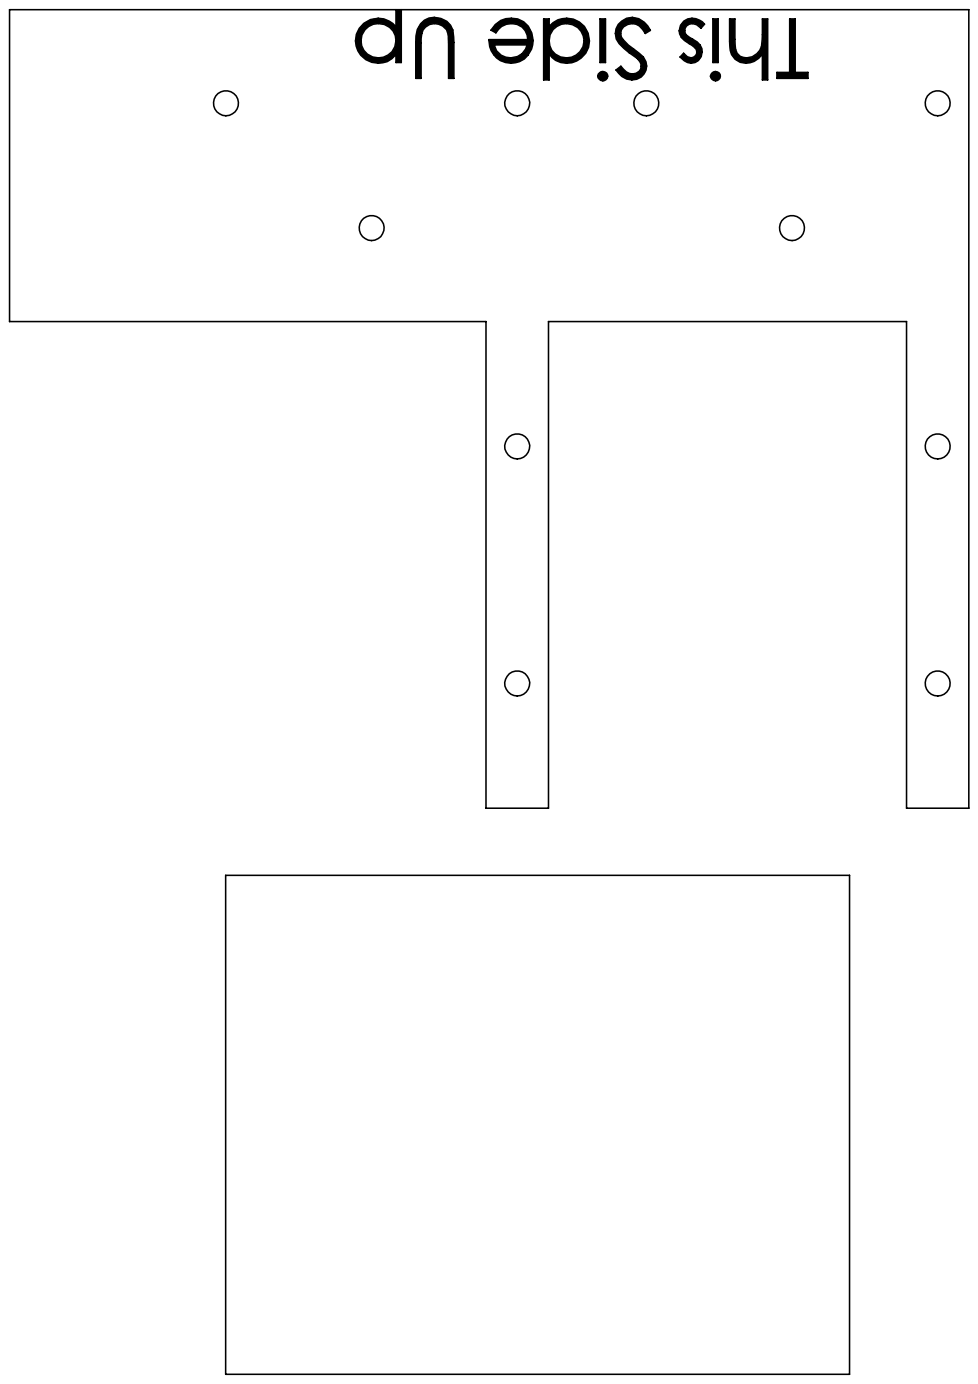
[picture p263: page 1]
