BadenMorgan/thesis/Document/Pictures/archive pics/cover photo.PDF

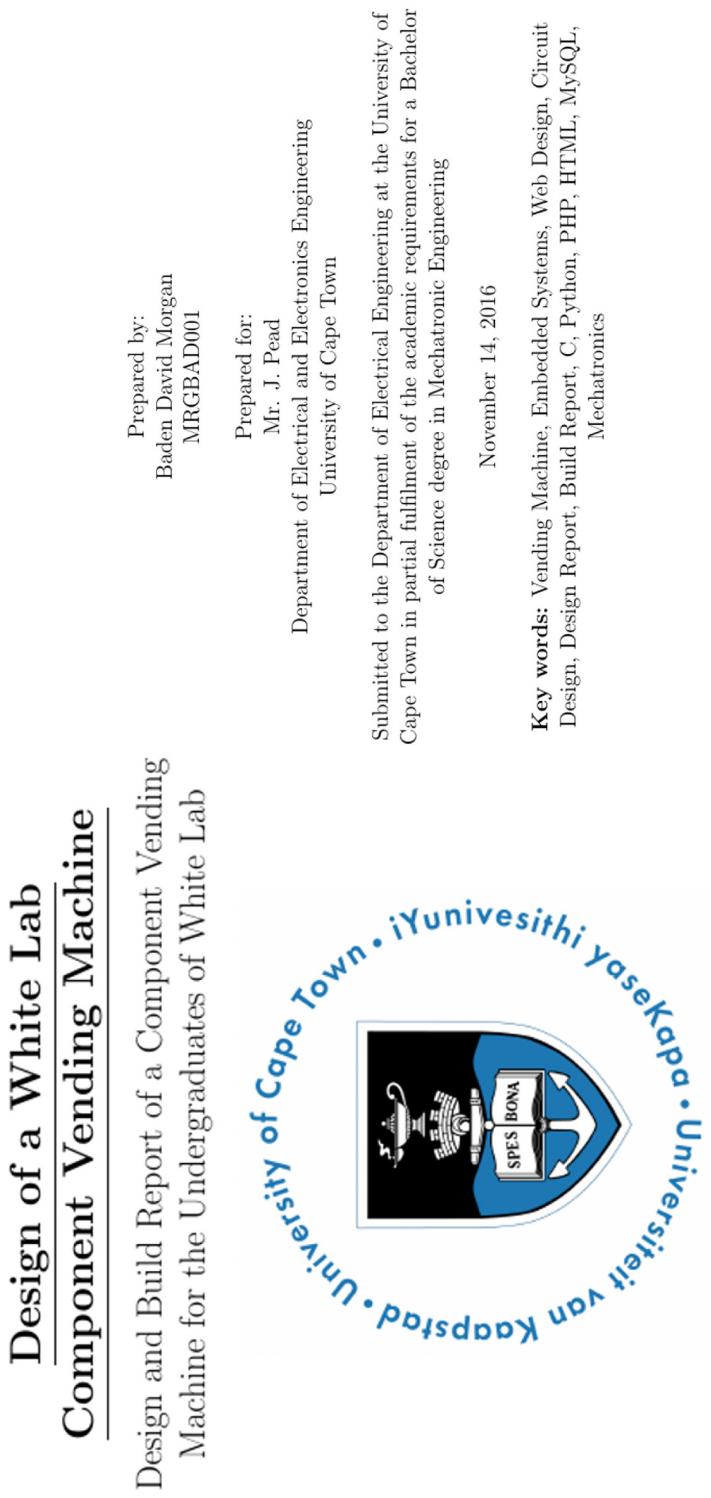
[picture p264: page 1]
