BadenMorgan/thesis/Solidworks/Archive/roller/laser template.PDF

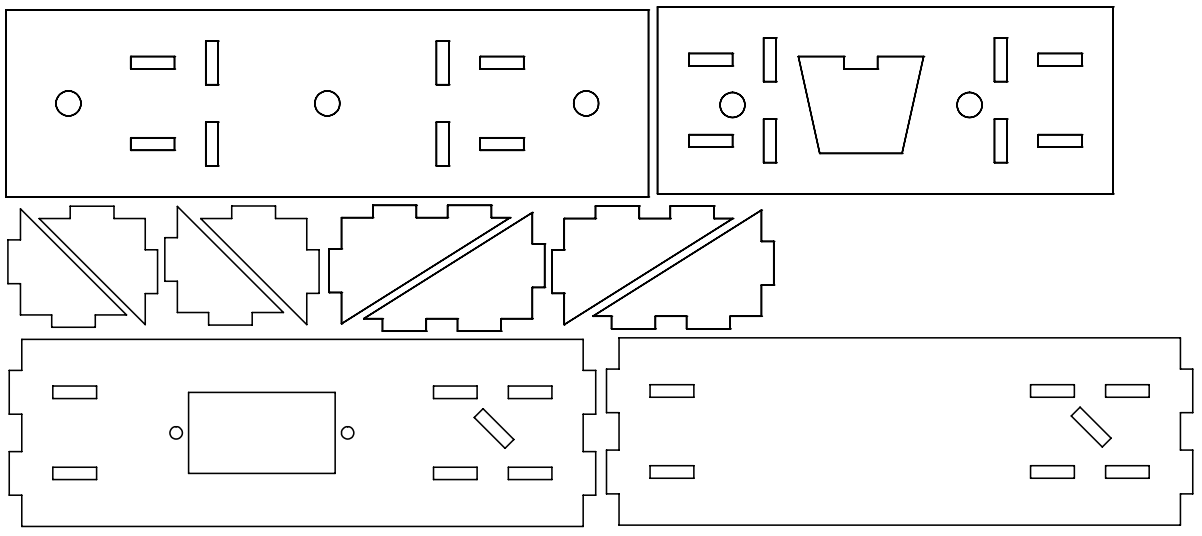
[picture p265: page 1]
