BadenMorgan/thesis/Solidworks/Archive/Drawings for document/LASER TEMPLATES/laser tamplate dip 8.PDF

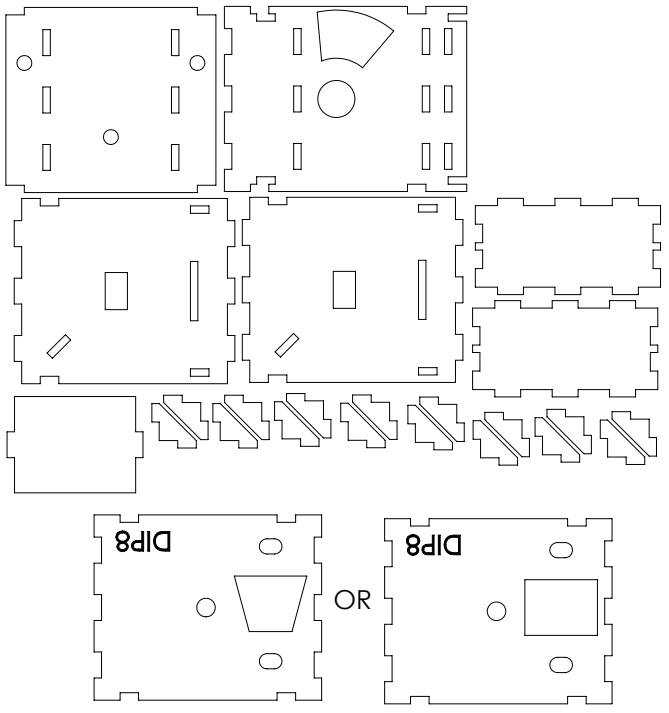
[picture p266: page 1]
