BadenMorgan/thesis/Solidworks/Archive/Drawings for document/LASER TEMPLATES/laser tamplate dip14 or 16.PDF

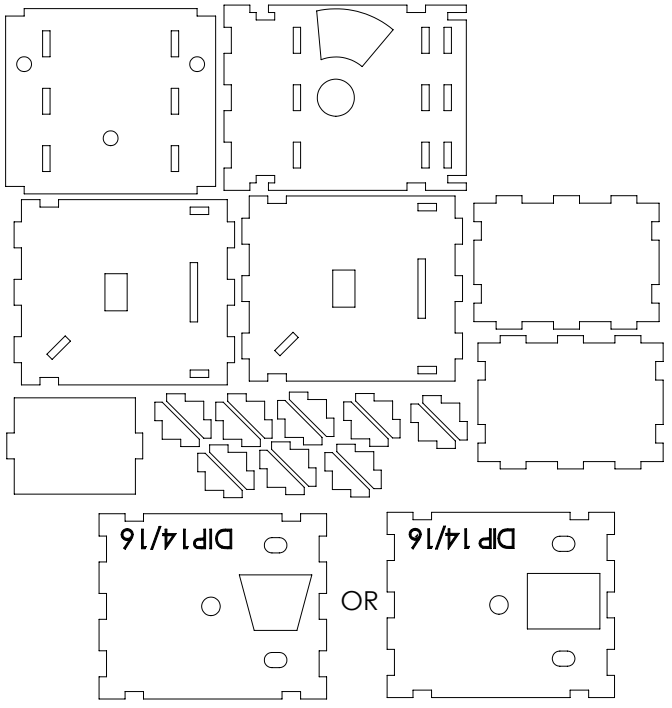
[picture p267: page 1]
