BadenMorgan/thesis/Solidworks/Archive/Drawings for document/LASER TEMPLATES/laser tamplate dip20.PDF

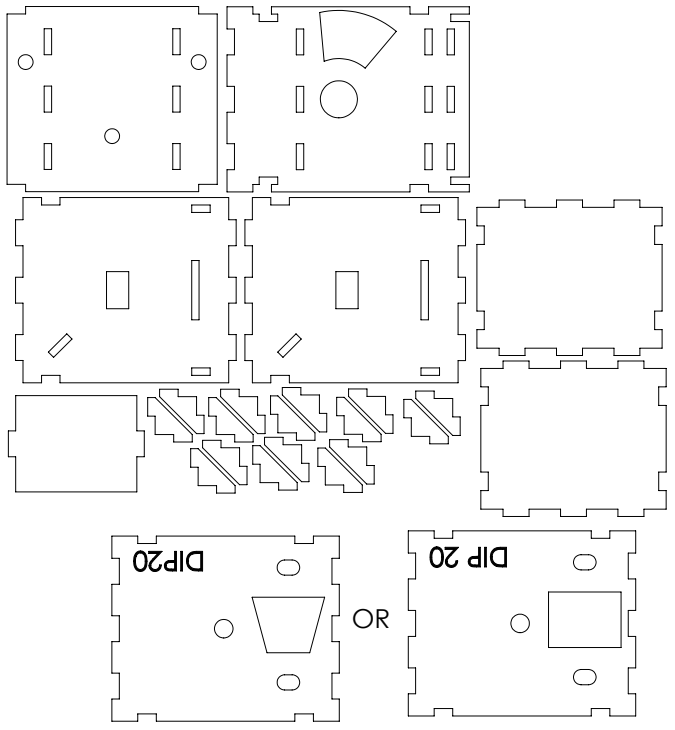
[picture p268: page 1]
