BadenMorgan/thesis/Solidworks/roller 2/archive deprecated/Servo Update/laser tamplate.PDF

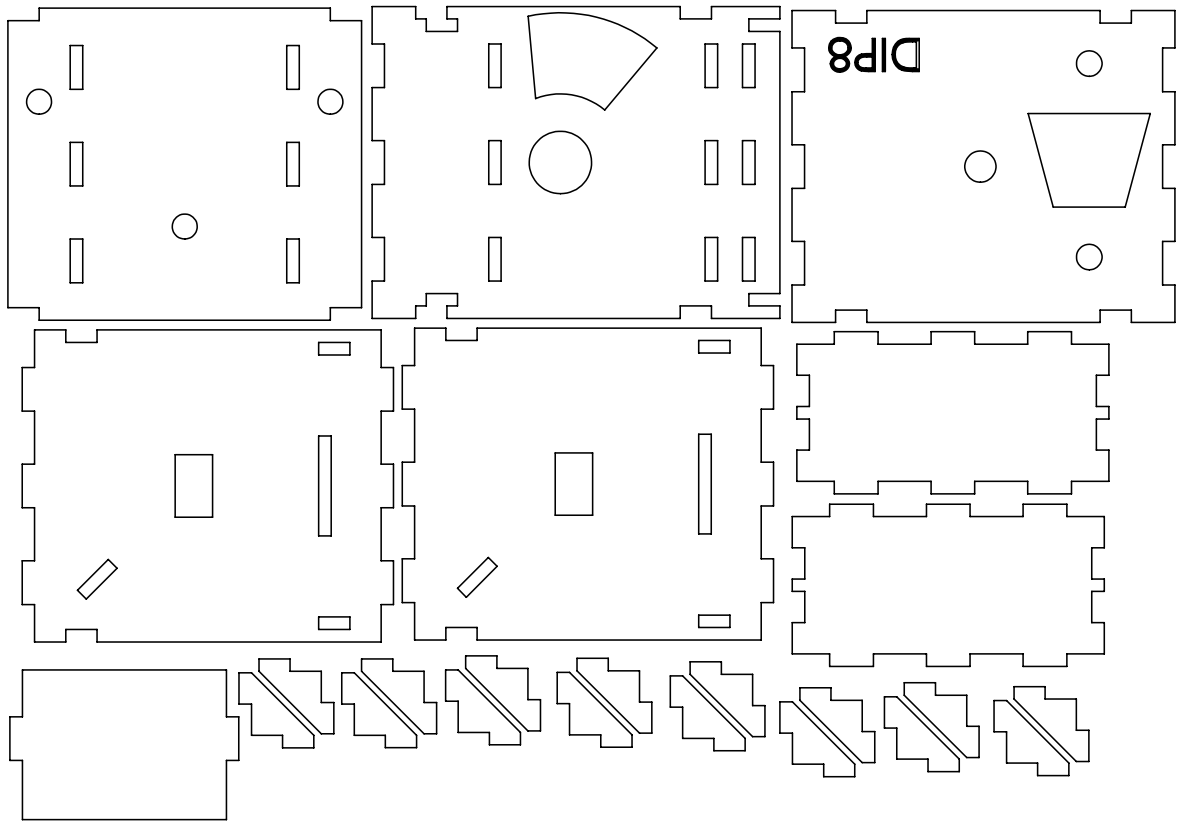
[picture p269: page 1]
