BadenMorgan/thesis/Circuit/Power Board/Power Board V3.brd

## EAGLE design Circuit/Power Board/Power Board V3.brd (2016-10-07)

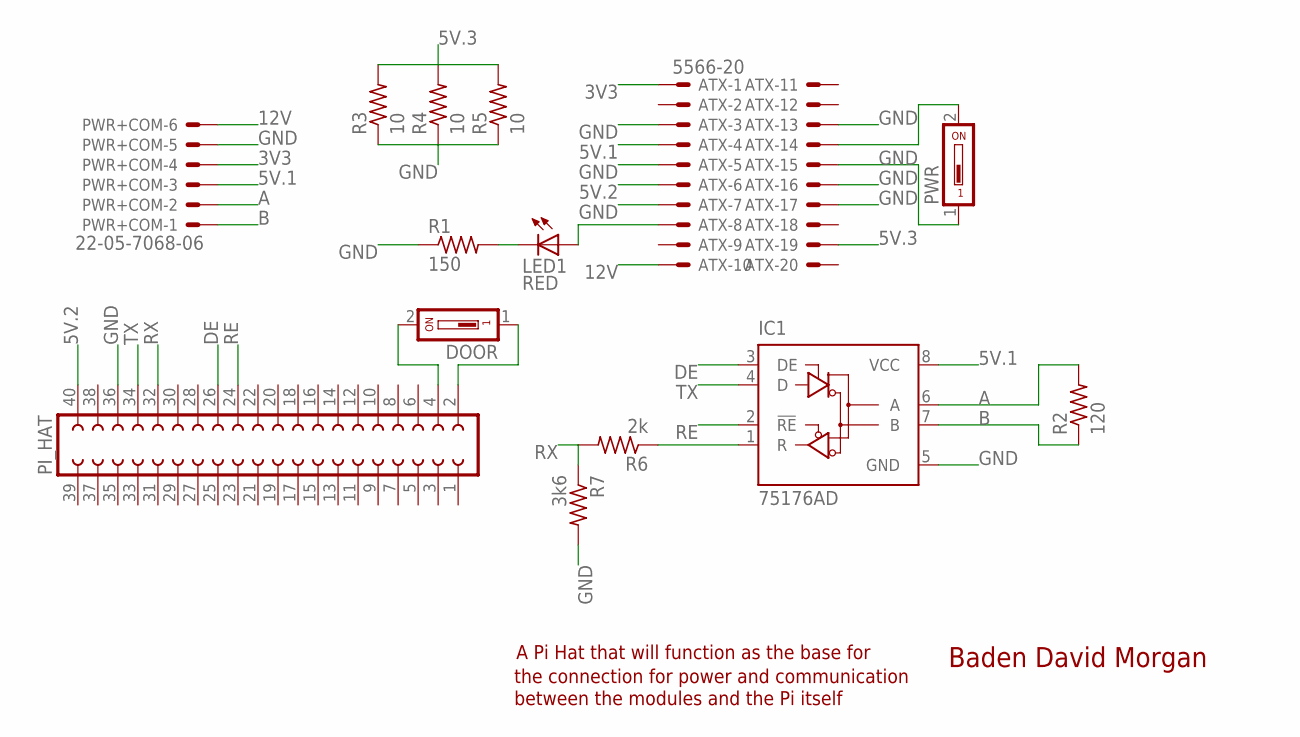
[picture p270: schematic Power Board V3.sch]

Parts:
ATX: 5566-20
DOOR: SD4-01
IC1: 75176AD; D_R-PDSO-G8
LED1: RED; CHIPLED_1206
PI_HAT: FE20-2
PWR: SD4-01
PWR+COM: 22-05-7068-06; 7395-06
R1: 150; R0805
R2: 120; R0805
R3, R4, R5: 10; P0817V
R6: 2k; R0805
R7: 3k6; R0805

Connections:
3V3: ATX.1, PWR+COM.4
5V.1: ATX.4, IC1.8 (VCC), PWR+COM.3
5V.2: ATX.6, PI_HAT.40
5V.3: ATX.19, R3.2, R4.2, R5.2
12V: ATX.10, PWR+COM.6
A: IC1.6 (A), PWR+COM.2, R2.2
B: IC1.7 (B), PWR+COM.1, R2.1
DE: IC1.3 (DE), PI_HAT.26
GND: ATX.3, ATX.5, ATX.7, ATX.13, ATX.15, ATX.16, ATX.17, IC1.5 (GND), PI_HAT.36, PWR.1, PWR+COM.5, R1.1, R3.1, R4.1, R5.1, R7.2
unnamed: ATX.14, PWR.2
unnamed: DOOR.2, PI_HAT.4
unnamed: ATX.8, LED1.A
unnamed: LED1.C, R1.2
unnamed: DOOR.1, PI_HAT.2
unnamed: IC1.1 (R), R6.1
RE: IC1.2 (!RE), PI_HAT.24
RX: PI_HAT.32, R6.2, R7.1
TX: IC1.4 (D), PI_HAT.34

Notes on the sheet:
Baden David Morgan
A Pi Hat that will function as the base for
the connection for power and communication
between the modules and the Pi itself

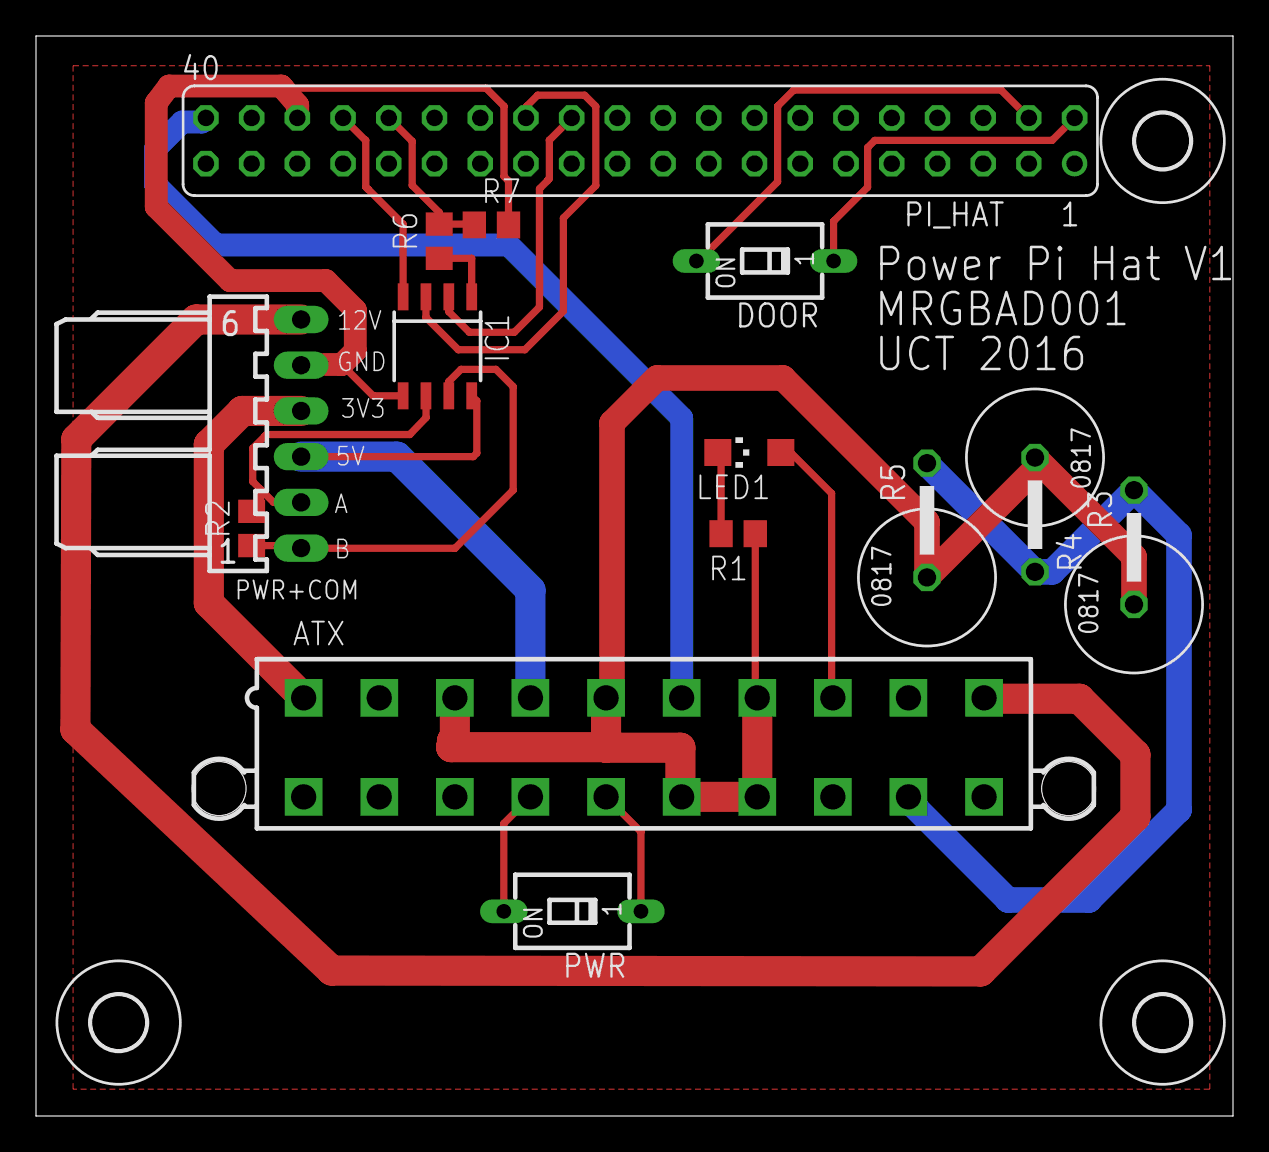
[picture p271: board Power Board V3.brd from above]

Board: 2 copper layers, 66.5 x 60.0 mm, 17 parts (0 on the bottom side), 18 nets.

Other parts of the board:
U$1, U$2, U$3: 3,0
