BadenMorgan/thesis/Circuit/LCD Board/LCD_Breakout.brd

## EAGLE design Circuit/LCD Board/LCD_Breakout.brd (2016-10-07)

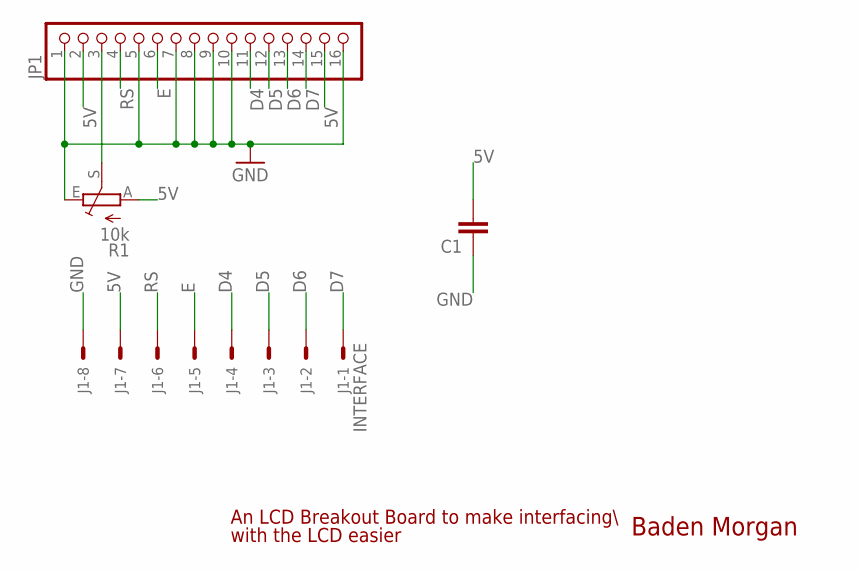
[picture p272: schematic LCD_Breakout.sch]

Parts:
C1: C5/2.5; C5B2.5
J1: INTERFACE; 7395-08
JP1: PINHD-1X16; 1X16
R1: 10k; CA6V

Connections:
5V: C1.2, J1.7, JP1.2, JP1.15, R1.A
D4: J1.4, JP1.11
D5: J1.3, JP1.12
D6: J1.2, JP1.13
D7: J1.1, JP1.14
E: J1.5, JP1.6
GND: C1.1, J1.8, JP1.1, JP1.5, JP1.7, JP1.8, JP1.9, JP1.10, JP1.16, R1.E
unnamed: JP1.3, R1.S
RS: J1.6, JP1.4

Notes on the sheet:
Baden Morgan
An LCD Breakout Board to make interfacing\
with the LCD easier

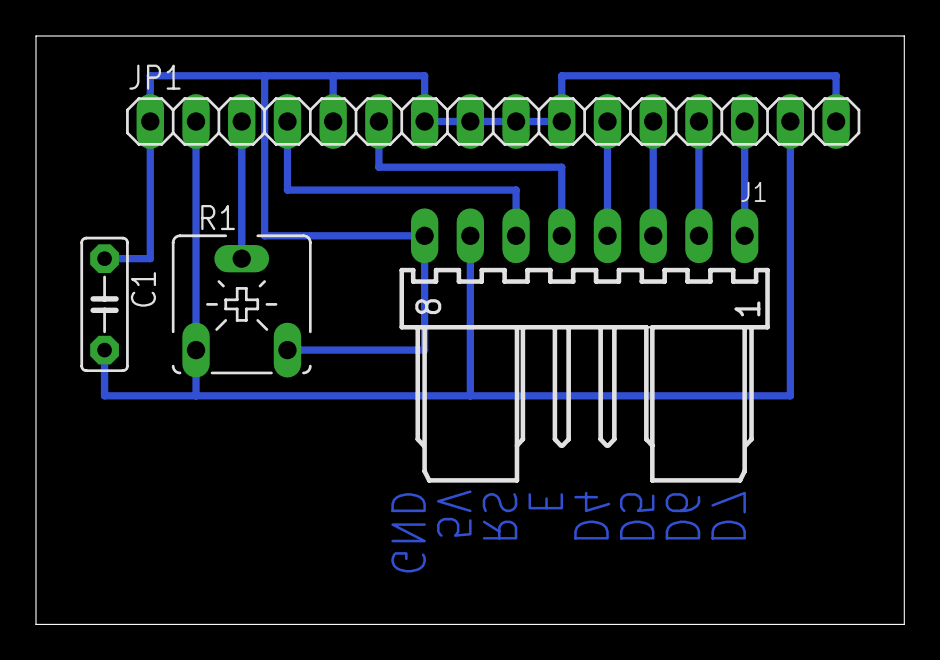
[picture p273: board LCD_Breakout.brd from above]

Board: 2 copper layers, 48.2 x 32.7 mm, 4 parts (0 on the bottom side), 9 nets.
