BadenMorgan/thesis/Circuit/MCU Module/MCU_Module V3.brd

## EAGLE design Circuit/MCU Module/MCU_Module V3.brd (2016-08-25)

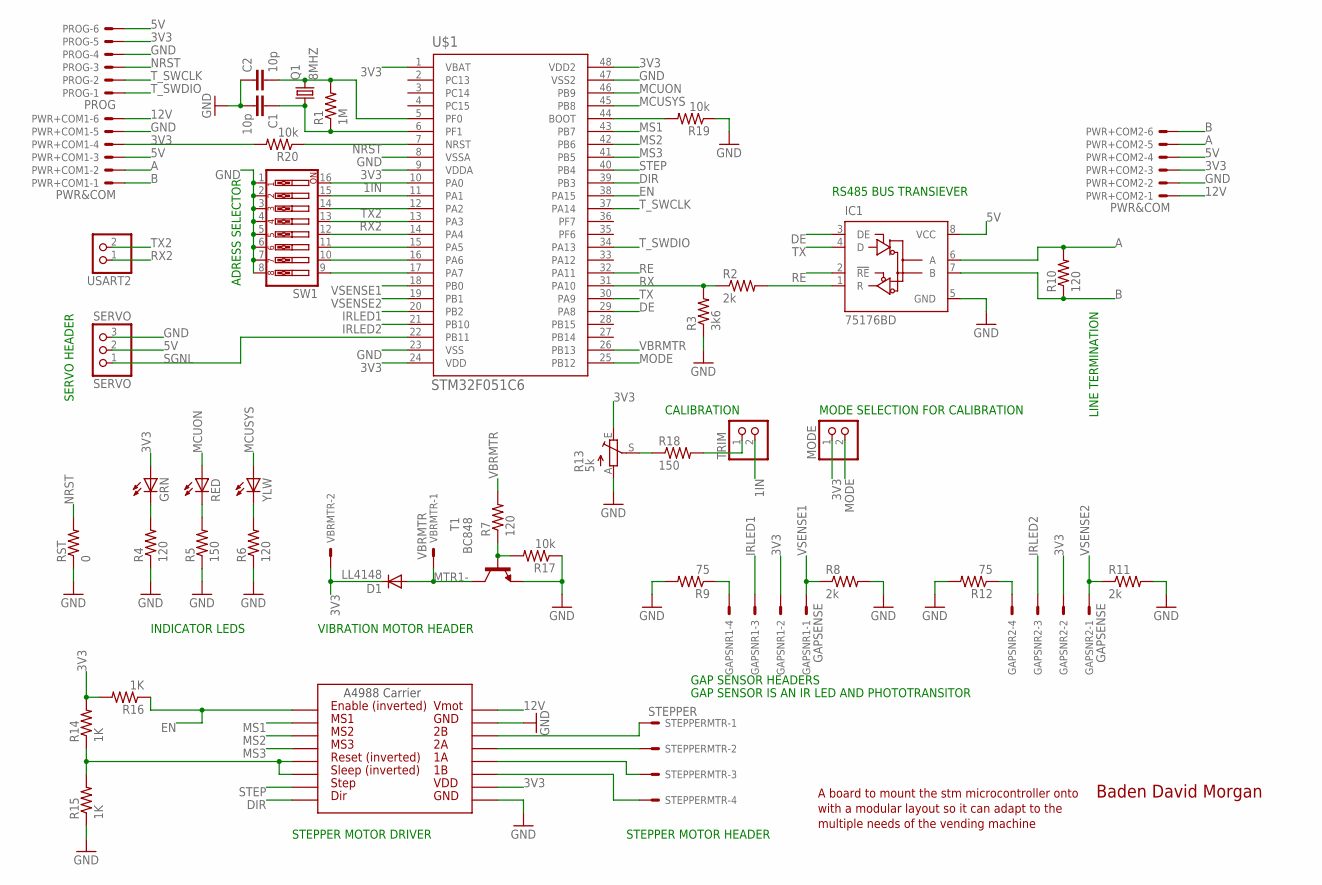
[picture p274: schematic MCU_Module V3.sch]

Parts:
C1, C2: 10p; C0805
D1: LL4148; SOD80C
GAPSNR1, GAPSNR2: GAPSENSE; 6410-04
GRN: LEDSML1206; SML1206
IC1: 75176BD; D_R-PDSO-G8
MODE: PINHD-1X2; 1X02
PROG: PROG; 6410-06
PWR+COM1, PWR+COM2: PWR&COM; 7395-06
Q1: 8MHZ; SM49
R1: 1M; R0805
R2, R8, R11: 2k; R0805
R3: 3k6; R0805
R4, R6, R7, R10: 120; R0805
R5, R18: 150; R0805
R9, R12: 75; R0805
R13: 5k; B25P
R14, R15, R16: 1K; R0805
R17, R19, R20: 10k; R0805
RED: LEDSML1206; SML1206
RST: 0; R0805
SERVO: SERVO; 1X03
STEPPERMTR: STEPPER; 6410-04
SW1: SW_DIP-8; EDG-08
T1: BC848; SOT23
TRIM: PINHD-1X2; 1X02
U$1: STM32F051C6; QFP50P900X900X160-48N
U$2: A4983CARRIER; A4988BREAKOUT
USART2: PINHD-1X2; 1X02
VBRMTR: VBRMTR; 6410-02
YLW: LEDSML1206; SML1206

Connections:
1IN: SW1.16, TRIM.2, U$1.10 (PA0)
3V3: D1.C, GAPSNR1.2, GAPSNR2.2, GRN.A, MODE.1, PROG.5, PWR+COM1.4, PWR+COM2.3, R13.E, R14.2, R16.2, R20.2, U$1.1 (VBAT), U$1.9 (VDDA), U$1.24 (VDD), U$1.48 (VDD2), U$2.VDD, VBRMTR.2
5V: IC1.8 (VCC), PROG.6, PWR+COM1.3, PWR+COM2.4, SERVO.2
8IN: SW1.9, U$1.17 (PA7)
12V: PWR+COM1.6, PWR+COM2.1, U$2.VMOT
A: IC1.6 (A), PWR+COM1.2, PWR+COM2.5, R10.2
B: IC1.7 (B), PWR+COM1.1, PWR+COM2.6, R10.1
DE: IC1.3 (DE), U$1.29 (PA8)
DIR: U$1.39 (PB3), U$2.DIR
EN: R16.1, U$1.38 (PA15), U$2.EN
GND: C1.2, C2.1, IC1.5 (GND), PROG.4, PWR+COM1.5, PWR+COM2.2, R3.1, R4.1, R5.1, R6.1, R8.2, R9.2, R11.2, R12.2, R13.A, R15.1, R17.1, R19.1, RST.1, SERVO.3, SW1.1, SW1.2, SW1.3, SW1.4, SW1.5, SW1.6, SW1.7, SW1.8, T1.2 (E), U$1.8 (VSSA), U$1.23 (VSS), U$1.47 (VSS2), U$2.GND, U$2.GND@0 (GND)
IRLED1: GAPSNR1.3, U$1.20 (PB2)
IRLED2: GAPSNR2.3, U$1.21 (PB10)
MCUON: RED.A, U$1.46 (PB9)
MCUSYS: U$1.45 (PB8), YLW.A
MODE: MODE.2, U$1.25 (PB12)
MS1: U$1.43 (PB7), U$2.MS1
MS2: U$1.42 (PB6), U$2.MS2
MS3: U$1.41 (PB5), U$2.MS3
MTR1-: D1.A, T1.3 (C), VBRMTR.1
unnamed: C1.1, Q1.1, R1.1, U$1.6 (PF1)
unnamed: C2.2, Q1.2, R1.2, U$1.5 (PF0)
unnamed: STEPPERMTR.4, U$2.1B
unnamed: SW1.15, U$1.11 (PA1)
unnamed: IC1.1 (R), R2.2
unnamed: SW1.12, U$1.14 (PA4)
unnamed: SW1.11, U$1.15 (PA5)
unnamed: SW1.10, U$1.16 (PA6)
unnamed: R13.S, R18.1
unnamed: GRN.C, R4.2
unnamed: R5.2, RED.C
unnamed: R6.2, YLW.C
unnamed: R7.1, R17.2, T1.1 (B)
unnamed: STEPPERMTR.3, U$2.1A
unnamed: GAPSNR1.4, R9.1
unnamed: STEPPERMTR.2, U$2.2A
unnamed: STEPPERMTR.1, U$2.2B
unnamed: R19.2, U$1.44 (BOOT)
unnamed: R18.2, TRIM.1
unnamed: GAPSNR2.4, R12.1
unnamed: R14.1, R15.2, U$2.RST, U$2.SLP (SLEEP)
NRST: PROG.3, R20.1, RST.2, U$1.7 (NRST)
RE: IC1.2 (!RE), U$1.32 (PA11)
RX: R2.1, R3.2, U$1.31 (PA10)
RX2: SW1.13, U$1.13 (PA3), USART2.1
SGNL: SERVO.1, U$1.22 (PB11)
STEP: U$1.40 (PB4), U$2.STEP
TX: IC1.4 (D), U$1.30 (PA9)
TX2: SW1.14, U$1.12 (PA2), USART2.2
T_SWCLK: PROG.2, U$1.37 (PA14)
T_SWDIO: PROG.1, U$1.34 (PA13)
VBRMTR: R7.2, U$1.26 (PB13)
VSENSE1: GAPSNR1.1, R8.1, U$1.18 (PB0)
VSENSE2: GAPSNR2.1, R11.1, U$1.19 (PB1)

Notes on the sheet:
A board to mount the stm microcontroller onto
with a modular layout so it can adapt to the
multiple needs of the vending machine
Baden David Morgan
RS485 BUS TRANSIEVER
SERVO HEADER
VIBRATION MOTOR HEADER
INDICATOR LEDS
ADRESS SELECTOR
GAP SENSOR HEADERS
GAP SENSOR IS AN IR LED AND PHOTOTRANSITOR
LINE TERMINATION
STEPPER MOTOR DRIVER
STEPPER MOTOR HEADER
MODE SELECTION FOR CALIBRATION
CALIBRATION

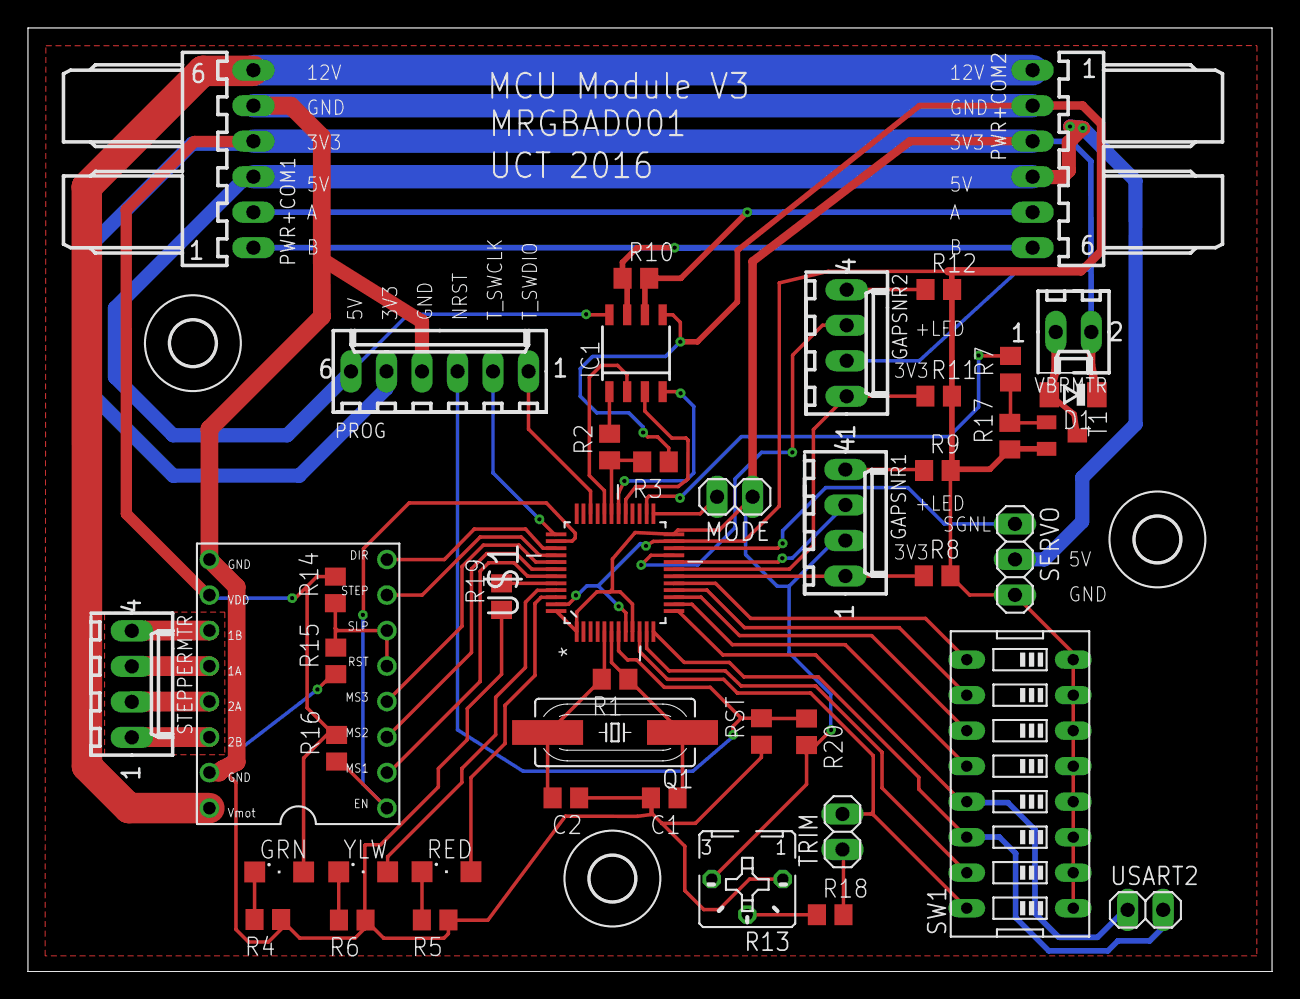
[picture p275: board MCU_Module V3.brd from above]

Board: 2 copper layers, 89.0 x 67.5 mm, 47 parts (0 on the bottom side), 54 nets.

Other parts of the board:
U$3, U$4, U$5: 3,2
