BadenMorgan/thesis/Software/MCU/MCU_Module/src/Servo.h

#ifndef SERVO_H_INCLUDED
#define SERVO_H_INCLUDED
#include "stm32f0xx_conf.h"

void ServoInit(uint8_t startval);
void ServoSweep();
void ServoSet(uint16_t angle);
void ServoZero();

#endif /* SERVO_H_INCLUDED */
