BadenMorgan/thesis/(commit log)

2016-07-02 creating repo
    [Interest.xlsx]
2016-07-18 adding more files
    topic description
    [Component Roller.SLDPRT, Stand.SLDPRT, mock up.SLDASM]
2016-07-25 updated Cmap and gantt chart
    [Gantt Chart.xlsx]
2016-07-26 added document
    *initializations
    *cover page
    *plagiarism declaration
    [Gantt Chart.xlsx]
2016-07-26 adding schematic
    [MCU_Module V1.sch, MCU_Module.sch]
2016-07-26 deleting old named file
    [MCU_Module.sch]
2016-07-30 updated schematic started on relearning stm32f0
    [Component Roller.SLDPRT, DIP8.IGS, DIP8.SLDPRT, Gantt Chart.xlsx, Part List.xlsx, SG90 plastic Horn.SLDPRT, STM32F0xx_Clock_Configuration_V1.0.1.xls, Tower Pro 9g Micro Servo SG90.SLDASM]
2016-08-04 completed delivery idea 1 and progress on circuit
    *finished first draft of delivery idea 1
    *started delivery idea 2
    *made progress on circuit
    *finished schematic
    *half way through layout
    [Component Roller 2.SLDPRT, Component Roller.SLDPRT, Component Roller.STL, DIP8.SLDPRT, MCU_Module V1.brd, MCU_Module V1.sch, Part List.xlsx, SG90 plastic Horn.SLDPRT]
2016-08-04 removing temporary files
    [idea 2.SLDASM]
2016-08-10 redid layout and updated document
    updated the document and redid the layout to improve layout and added
    more initilizaton to the document
    [MCU_Module V2.brd, MCU_Module V2.sch, MCU_Module V3.brd, MCU_Module V3.sch, Part List.xlsx, Power Board V1.brd, Power Board V1.sch, Power Board V2.brd]
2016-08-14 finished circuit
    finished circuit board and added gerber files
    setting up for roller 2 version 2
    [Component Roller 2.SLDPRT, Component Roller 2.STL, Component Roller.SLDPRT, Component Roller.STL, Component request.xlsx, DIP8.SLDPRT, MCU_Module V1.brd, MCU_Module V1.sch]
2016-08-19 added website and started stm code
    website foreground mostly done
    started with st code
    [Component Roller 2.SLDPRT, DIL14.SLDPRT, DIL14.stp, DIP8.SLDPRT, Part List.xlsx, SG90 plastic Horn.SLDPRT, SR M4 bolt nut assy.SLDPRT, Servo HXT900 Micro.SLDPRT]
2016-08-23 updates
    *updated power board to added voltage devider for pi coms
    *updated solidworks drawings and parts for bigger servo
    *updated MCU porgam, to many to list fully, brief is gpio, task manager,
    servo, timer, usarts
    [Component Roller 2.SLDPRT, Component Roller 2.STL, Component Roller dip 16 or 14.SLDPRT, Component Roller dip 16 or 14.STL, Component Roller dip20.SLDPRT, Component Roller dip20.STL, Component Roller dip8.SLDPRT, Component Roller dip8.STL]
2016-08-24 updates
    *added datasheets to the webstie
    *added LCD breakout board
    *updated report
    *updated task manager in micro program
    [LCD_Breakout.brd, LCD_Breakout.sch]
2016-08-25 finished main task for mcu
    [LCD_Breakout.sch, MCU_Module V3.brd, MCU_Module V3.sch]
2016-08-29 updates
    updated 3d prints to optimize for priting
    widdened slot to add adjustable guide
    connected pi to stm via uart
    added interrupt for uart1 stm
    setup aurt on pi
    [Component Roller dip 16 or 14.SLDPRT, Component Roller dip 16 or 14.STL, Component Roller dip20.SLDPRT, Component Roller dip20.STL, Component Roller dip8.SLDPRT, Component Roller dip8.STL, guide.SLDPRT, guide.STL]
2016-09-05 couple updates
    [1088 L beam.SLDPRT, 1088 flat bar.SLDPRT, 1093 flat bar.SLDPRT, 600 flat bar.SLDPRT, Angled drop plate ali.SLDPRT, Component Roller dip 16 or 14.SLDPRT, Component Roller dip 16 or 14.STL, Component Roller dip20.SLDPRT]
2016-09-09 many updates
    *added to the doc
    *updated stm code to send response codes
    *added handling on master side for repsonse codes
    *added functionality so coms will work with rs485 bus transiever
    *master giving user friendly response after dispensing
    [1093 flat bar.SLDDRW, 1mm perspex.SLDDRW, 2MM clear persepx.SLDDRW, 3mm perspex.SLDDRW, Aluminium sheets.SLDDRW, Angled drop flat for dimensions.SLDPRT, Component Roller dip8 ic holder.SLDPRT, Component Roller dip8 ic holder.STL]
2016-09-16 u[date for making enclosure
    [Aluminium sheets.SLDDRW, Angled drop plate ali.SLDPRT, Enclosure height comparison.SLDDRW, Enclosure render.SLDDRW, James.SLDPRT, L Beam 1300 straight.SLDPRT, L Beam sheet.SLDDRW, Steel bar sheet.SLDDRW]
2016-09-21 updates
    Mostly to document ith some additions of drawings from solidworks for
    the document
    Also the 9g servo for the updated delivery mechanism was replaced with
    one that reprsents the real life one more closely
    [ALL DIP HOLDERS.SLDDRW, Angled drop flat for dimensions.SLDPRT, Angled drop plate ali.SLDPRT, Component Roller dip 16 or 14.STL, Component Roller dip20.STL, Component Roller dip8.STL, Component Roller.SLDPRT, DIP8.SLDDRW]
2016-10-07 lots of updates
    too many to document I've been a lazy uploader
    [1mm perspex.SLDDRW, 2MM clear persepx.SLDDRW, 3mm perspex.SLDDRW, 45 1100 flat bar.SLDPRT, ALLROLLERS.SLDDRW, Aluminium sheets v2 -2.SLDDRW, Aluminium sheets v2.SLDDRW, Angled drop plate ali.SLDDRW]
2016-10-17 Document updates
    [Part List.xlsx, roller weights.xlsx]
2016-10-31 document updates
    sorry its been a while
    [Testing.xlsx, a1 back platev2.SLDDRW, drill template.SLDASM, drill template.SLDDRW, drill template.SLDPRT, idea 2 exploded.SLDASM, wood piece.SLDPRT]
2016-11-01 added boot time scripting file
    [Testing.xlsx, test design exploded.SLDDRW]
2016-11-02 Mainly document updates
    *recommendations
    *intro
    *more assembly proccess'
    * more
    [sensortester.sch]
2016-11-13 more updates for final release
    [cover photo.SLDDRW]
2016-11-14 for submittion almost
    will probably need some cleaning up
    [ALL DIP HOLDERS.SLDDRW, ALLROLLERS.SLDDRW, Component Roller dip 14 or 16 ic holder.SLDDRW, Component Roller.SLDPRT, Part Diagram - Baden Morgan.DXF, Stand.SLDPRT, Testing.xlsx, angled plate.SLDPRT]
2016-12-07 update mcy module to latest
    bug fixes
    [GPIOLib.c, Servo.c, definitions.h, main.c]
